veryl-lang/veryl/support/vscode/CHANGELOG.md

# Change Log

All notable changes to the "veryl-vscode" extension will be documented in this file.

Check [Keep a Changelog](http://keepachangelog.com/) for recommendations on how to structure this file.

## [Unreleased]

- Initial release
