veryl-lang/veryl/(threads)

Thread 11 (2022-12-22):

case statement

dalance, 2022-12-22:
```
always_ff (clk) {
    case x {
        0: a = 1;
        1: a = 2;
        2: {
            a = 3;
            b = 4;
        }
        default: a = 4;
    }
}
```

taichi-ishitani, 2022-12-22:
Do you plan to add `case inside` feature?

dalance, 2022-12-22:
I want to consider it, but I think the priority is low.

dalance, 2022-12-29:
Instead of `default`, How about Rust style default?

```
always_ff (clk) {
    case x {
        0: a = 1;
        1: a = 2;
        2: {
            a = 3;
            b = 4;
        }
        _: a = 4;
    }
}
```

taichi-ishitani, 2023-01-05:
In SysemVerilog, `?` and `*` are used as symbols which mean wildcard. For exmaple: wildcard operator `==?`, wildcard index type `int a[*]`.
How about using `?` or `*` instead of `_`?

dalance, 2023-01-05:
I thought `default` may be a little long. but there is not another problem.
So I'll use `default` to follow SystemVerilog.

Do you have any other reason to change to `?` or `*`?

dalance, 2023-01-06:
OK. I'll use `default` at this time.

taichi-ishitani, 2023-01-11:
How about introducing case item less case statement.
Example:

```
case {
  foo:     a = 1;
  bar:     a = 2;
  default: a = 3;
}
```

Equivalent code:

```
case 1 {
  foo:     a = 1;
  bar:     a = 2;
  default: a = 3;
}
```

This idea is originally from Ruby's case expression.

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

dalance, 2023-01-11:
It looks good. Does Expression in case item have no problem for synthesis?

taichi-ishitani, 2023-01-11:
> Does Expression in case item have no problem for synthesis?

Yes. In fact, our RTL includes this kind of code.

dalance, 2023-01-12:
Expression less case seems to be difficult to parse by LL(k).
This is because

```
case {  <- Is this `{` case body's start or expression with concatenation?
    foo: a = 1;
}
```

To avoid this, chanigning `case` keyword for expression less case is required.

taichi-ishitani, 2023-01-12:
I don't care if expression less case feature is not introduced because I just put `1` as a case expression.

dalance, 2023-01-12:
I feel `case 1` may be bit strange, but I have no idea about alternative keyword.
So I'll keep the current implementation until new idea.

taichi-ishitani, 2023-01-12:
Introduce other keyword insead of `case`? For example, `switch`, `branch`..?

dalance, 2023-01-15:
`switch` seems to be good.

dalance, 2024-04-16:
The idea of `switch` statement moved to #643.

Thread 17 (2022-12-22):

improve syntax error

dalance, 2022-12-22:
The current syntax error is from parol's error.
It may not be suitable with language server.

Thread 29 (2022-12-24):

Using SV sytem functions

taichi-ishitani, 2022-12-24:
SystemVerilog has useful sytem functions, such as `$clog2`.
I'd like to use SV system functions within VL code but I got a syntax error.

```
Error: parol_runtime::unexpected_token

  × Unexpected token: LA(1) (Error)
   ╭─[test.vl:3:1]
 3 │   parameter MAX_COUNT:   u32 = 8,
 4 │   parameter COUNT_WIDTH: u32 = $clog2(MAX_COUNT + 1)
   ·                                ┬
   ·                                ╰── Unexpected token
 5 │ )(
   ╰────
  help: Unexpected token
```

Does not support such feature?

dalance, 2022-12-25:
General function call is not still supported.
System function call will be supported at the same time.

taichi-ishitani, 2022-12-26:
OK, I understand.
I track this request by using #33.

Closed 2022-12-26.

Thread 35 (2022-12-25):

project namespace

dalance, 2022-12-25:
to avoid name conflict between packages

dalance, 2023-01-15:
`::` can be used for project namespace resolver like package.

```toml
[dependencies]
prj1 = { git = "" }
```

```
module ModuleA {
    inst a: prj1::ModuleB;
}
```

In SystemVerilog, `::` is replaced with `_`.

```systemverilog
module ModuleA;
    prj1_ModuleB a();
endmodule
```

dalance, 2023-01-18:
Project name should be added too.

```toml
[project]
name = "sample"

[dependencies]
prj1 = { git = "" }
```

```
module ModuleA {
    inst a: prj1::ModuleB;
}
```

```systemverilog
module sample_ModuleA;
    prj1_ModuleB a();
endmodule
```

Closed 2023-01-24.

Thread 55 (2023-01-04):

Incorrect if block scope

dalance, 2023-01-04:
Currently, the following code causes duplicated identifier error.
Each claure of if declaration should have independent scope.

```
if a ==1 :label {
    let a: logic;
} else {
    let a: logic;
}
```

Closed 2023-01-31.

Thread 62 (2023-01-07):

Useage of tri keyword

taichi-ishitani, 2023-01-07:
I think in Varyl `tri` keyword is used as a data type.
On the other hand, in SystemVerilog the `tri` keyword is used to show that a declared element is a wire and to allow the element to have multiple drivers. Therefore, its usage is similar to the usage of the `var` keyword.

```systemverilog
package foo_pkg;
  typedef enum logic {
    FOO_0,
    FOO_1
  } e_foo;
endpackage

module foo_sub
  import foo_pkg::*;
(
  inout tri e_foo io_foo
);
  assign io_foo = FOO_0;
endmodule

module foo_top;
  import foo_pkg::*;

  tri e_foo foo;
  assign foo = FOO_1;
  foo_sub u_sub (foo);
endmodule
```

I think Veryl should also use the `tri` like the `var` keyword.

dalance, 2023-01-07:
`tri` may be type modifier like `const` in C++.

```
module A (
    a: inout tri logic[10],
    b: inout tri struct_t,
) {
    var a: tri logic;
    var b: tri struct_t;
}
```

Usage `tri` like `var` keyword is not suitable because `var` can't be used in port declaration.

Syntactically `tri u32` is allowed, but it will be rejected by semantic checker.

dalance, 2023-01-07:
Alternatively, `inout` infers `tri` automatically.
This may be less consistency?

```
module A (
    a: inout logic[10],
    b: inout struct_t,
) {
    tri c: logic;
    tri d: struct_t;
}
```

dalance, 2023-01-07:
I think `tri` is special case, and is required to write carefully.
So explicit description like the first idea is better?

taichi-ishitani, 2023-01-08:
> var d: tri struct_t;

I feel strange that var and tri are used in the same object declaration because var means a variable.
I also think `var` should be a type modifier if `tri` is a type modifier.

According to the above thought, how about this?

* change `var` to a type modifier
    * this is for symmetry with `tri` keyword
* revive `let` keyword

```
module A (
  a: output var logic, // var can be omitted
  b: output tri logic
){
  let c: var logic; // var can be omitted
  let d: tri lgoic;
}
```

dalance, 2023-01-08:
I think "omittable" is a main cause of SystemVerilog's syntax complexity.
So `var` should be mandatory or like below

```
module A (
  a: output logic,
  b: output tri logic
){
  let c: logic;
  let d: tri lgoic;
}
```

I think symmetricity is not required because `tri` is special case.
(for example, many languages mark `static` variable but not `dynamic` variable)

> I feel strange that var and tri are used in the same object declaration because var means a variable.

I read `var d: tri struct_t;` as "variable declaration of tri-statable struct_t".
So `var` is keyword to show variable declaration, and `tri` is type modifier.

 I agree the meaning of `var` of SV and Veryl is a little different.
If the difference causes strangeness, I agree to revive `let`.

taichi-ishitani, 2023-01-08:
> If the difference causes strangeness, I agree to revive let.

I think there are few SV users using `var` keyword so this could not be a problem.
Therefore, it's OK for me whichever using `var` or `let` keywords.

dalance, 2023-01-09:
Comparison of `var` and `let`

```
var  a: u32;
inst b: InterfaceA;

let  a: u32;
inst b: InterfaceA;
```

I think `var`/`inst` is more clear that it is "variable".
(If `let` is used, I want to use `let` for instantiation too. but it can't)

taichi-ishitani, 2023-01-10:
> I think var/inst is more clear that it is "variable".

Yes, I agree.

dalance, 2023-01-11:
tri as type modifier was implemented.

Closed 2023-01-11.

Thread 68 (2023-01-11):

forbid unused variable

dalance, 2023-01-11:
In Rust, unused variable causes warning, and Go forbids it.
Which is better?

Other issues:

* Port should not be checked because it is public interface which includes extensions for future use.
* Prefix `_` shows the variable is unused. It suppress the error or warning.

```
module ModuleA (
    x: input  logic, // ports are not checked
    y: output logic,
) {
    var a: u32;  // error or warning
    var _b: u32; // _ shows the variable is unused.
}
```

dalance, 2023-01-12:
Currently unused variable is forbidden.
If this is too restricted, I'll change the behavior.

Closed 2023-01-12.

Thread 71 (2023-01-12):

Assignment non-blocking operator

taichi-ishitani, 2023-01-12:
SystemVerilog has assignment operators, e.g. `+=`/`-=`, but no assignment operators for non-blocking assignment.
Therefore, we have to write code like below for updating a FF value using itself. I think it's very bother.

```systemverilog
count <= count + 1;
```

To resolve this, I'd like Veryl to allow to use assignment operators within `always_ff` blocks.

```
always_ff i_clk, i_rst_n {
  if_reset {
    count = 0;
  }
  else if up {
    count += 1;
  }
}
```

dalance, 2023-01-12:
This is already implemented, but the current output may be wrong.
I'll fix it.

Closed 2023-01-12.

Thread 73 (2023-01-12):

[要望] 幅ゼロの指定

ryuz, 2023-01-12:
C++ のサイズ0の配列のように、幅ゼロのバスを定義できると嬉しいです。
SystemVerilogの場合 たとえば 1対N マルチプレクサ を

```
module multiplexer
    #(
        parameter   int N = 2,
        localparam  int S = $clog2(N)
    )
    (
        input   logic   [N-1:0] in,
        output  logic   [0:0]   out,
        input   logic   [S-1:0] sel
    );

    assign out = in[sel];

endmodule
```

と書きたいところですが、 N が 1 の時に S が 0 になってしまい合成エラーになるため

```
module multiplexer
    #(
        parameter   int N = 1,
        localparam  int S = N > 1 ? $clog2(N) : 1
    )
    (
        input   logic   [N-1:0] in,
        output  logic           out,
        input   logic   [S-1:0] sel
    );

    generate
    if ( N > 0 ) begin : select
        assign out = in[sel];
    end
    else begin : bypass
        assign out = in;
    end
    endgenerate

endmodule
```

などと冗長な書き方をすることがあります。

また、変数を結合するのに例えば、下記のようなケースで b が不要な時に 0 を指定するとエラーになります。

```
module concatenate3
    #(
        parameter   int A = 2,
        parameter   int B = 0,
        parameter   int C = 5
    )
    (
        input   logic   [A-1:0]     a,
        input   logic   [B-1:0]     b,
        input   logic   [C-1:0]     c,
        output  logic   [A+B+C-1:0] q
    );

    assign q = {a, b, c};

endmodule
```

これらは、Verilog が [0:0] なバス幅指定をすることに起因していますが、Verly は Rust 風の宣言なので、解決しないものかと考えた次第です。
ただし、あくまでトランスパイらなので、変換を考えると難しいというのも想像できます。

例えばですが parameter を、そのまま SV に残すものと、Verly  内で解釈するものとを指定できるようにして、後者に限定して高度なことができるような事などではできないものでしょうか？

優先度の高い要望ではないのですが、何かの折にもし良いアイデアが出てくればご検討いただければ幸いです。

taichi-ishitani, 2023-01-12:
以下の様に生成するようにできれば、解決できるとは思いますが、生成後のコードが読みづらくなるのが難点ではあります。

```systemverilog
out = in[(S>0)?sel:0];
```

```systemverilog
q = {{(A>0){a}}, {(B>0){b}, {(C>0){c}}};
```

ryuz, 2023-01-12:
ありがとうございます。こういうテクニックは思いつかなかったので非常にありがたいです。

もっとも

```
input   logic   [B-1:0]     b,
```

部分が

```
input   logic   [0-1:0]     b,
```

と展開されてしまい、本来の趣旨と違う信号が生成されてしまうという問題は残りますが。

> 生成後のコードが読みづらくなるのが難点ではあります。

結局、ここに尽きるのかなと思いました。
 Veryl の使用用途も

- そのまま使える奇麗な SV に変換したい時
- 波形ファイルさえ Veryl と対応していればOKな時

の2種類ありそうな気がしますので、後者に踏み込んだオプションがあっても嬉しいです。

ちなみに Rust 風のマクロを実装したりなどもお考えでしょうか？
結構、この手のテクニックの隠ぺいにマクロは便利そうな気もしております。

dalance, 2023-01-12:
幅0のconcatenateは面白いですね。
全部これに対応すると確かに可読性が厳しくなってしまうので、 `zeroable` みたいなtype modifierを付けた変数だけ展開するとかをイメージしていました。

マクロについてはRustの手続きマクロのようにアトリビュートを付けた構文要素の構文木変換として実装したら良さそうかと思っています。

taichi-ishitani, 2023-01-13:
`zeroable` 良いですね。
これが指定されている場合は、

* 幅が 0 の場合に
    * 幅を強制的に 1 にするコードを挿入する
        * `logic [((W>0)?W-1:0):0] a`
    * 左辺値として参照する際に、強制的に 0 にするコードを挿入する
        * `lhs = (W > 0) ? a : '0`
    * 右辺として代入される際は、代入を無かったことにするコードを挿入する
        * `a = (W > 0) ? lhs : '0`
    * 連接の場合は、回数 0 の繰り返しを挿入して、辻褄を合わせる
        * `{{(A>0){a}}, {(B>0){b}}, {(C>0){c}}}`
        * 回数 0 の繰り返しが使える条件は限られているようなので、連列自体を禁止にしてしまった方が良いかもしれない

が良いでしょうか？

`zeroable` が指定されていない変数については、幅が 1 以上前提ですから、ポカミス除けに、

```systemverilog
initial assume(W > 0);
```

のようなコードを挿入するはどうでしょうか？

dalance, 2023-01-13:
良さそうですね。最初のコード例では

```
module multiplexer #(
    parameter  N: u32  = 2        ,
    localparam S: u32  = $clog2(N),
) (
    i: input  logic [N],
    o: output logic [1],
    s: input  zeroable logic [S],
) {

    assign o = i[sel];

}
```

```systemverilog
module multiplexer #(
    parameter  int N = 2,
    localparam int S = $clog2(N)
) (
    input  logic [N-1:0] i,
    output logic [1-1:0] o,
    input  logic [((S>0)?S-1:0):0] s
);

    assign o = i[(W>0)?s:'0];

endmodule
```

なので可読性もそこまで悪くはないかな、と思います。
マクロはマクロでいろいろ問題がありますし。
`$clog2` みたいな感じの関数があれば良かったんですけどね。

`initial assume` もいいと思います。

taichi-ishitani, 2023-01-13:
> $clog2 みたいな感じの関数があれば良かったんですけどね。

生成する SV で使うユーティリティ関数をまとめた pakcage を用意するのはどうでしょうか？
しかし、参照する際と、代入する際の処理はマクロにせざるを得ないなので、御利益はあまりなさそうですね。

ryuz, 2023-01-13:
いろいろとご検討いただきありがとうございます。zeroable のアイデアは素敵に思います。

私が FPGA ターゲットなのもあるかもしれませんが、汎用性の高いモジュールを書きたい要望が高いです。
普段  parameter や generate を多用することが多いのですが

- $clog2 が 1 に対して 0 になってしまう問題
- AXIバスのようにオプション信号が多い規格で使わない信号を幅0定義したら無きものとして扱いたい
- 機能追加するときは後方互換性を確保したいのでデフォルト引数が欲しい

などの需要があります。

最後の奴は SV は function や task ではデフォルト引数指定できるのに module のポートではできないようなので、parameter の方で指定しない限りは信号は無視するようなやり方で拡張したりしています。
(デフォルト引数の処理は、module 側ではなく、インスタンシエートする側の処理なので Veryl では拡張は難しそうですよね。)

ちなみにサイズ0に関しては $bits の問題もあって、ゼロの時に $bits が 0 を返すようにするのは少し難しい気がします。

そもそもの話として SV で幅 W の信号を [W-1:0] と表したときに

```
module tb_top();
    generate
    for ( genvar i = -2; i <= +2; ++i ) begin : foos
        foo #(.W(i)) i_foo ( .a('0) );
    end
    endgenerate
    initial #1 $finish();
endmodule

module foo #(W=1) (input [W-1:0] a);
    initial $display("W=%d $bits(a)=%d", W, $bits(a));
endmodule
```

を動かすと

```
W=         -2 $bits(a)=          4
W=         -1 $bits(a)=          3
W=          0 $bits(a)=          2
W=          1 $bits(a)=          1
W=          2 $bits(a)=          2
```

のように 0以下でおかしなことになるのですよね。
(SV の文法が示しているのはbitサイズではなくbit位置だというのがそもそもの問題で

多くの場合、負の値を使うこと自体サポート範囲外にしてよい気がするので

> initial assume(W > 0);

はとても良い案に思いました。

taichi-ishitani, 2023-01-13:
本筋と外れますが、

> AXIバスのようにオプション信号が多い規格で使わない信号を幅0定義したら無きものとして扱いたい

社内用のバスインターフェース用の共通モジュール作成の時にも苦慮した点ですね。
インターフェース上の信号は消せないのは仕方ないとして、FIFO などに繋ぐ際に、必要ビットだけビット列に詰めることで対応しました。これによって、必要最小限のリソースだけを消費するようにしています。
詰める function、元に戻す funtion を SV interface に実装することで、関数を呼び出すだけで、これらを実施できるようにしています。

Qiita の記事や、実際の実装が参考になるかと思います。

* https://qiita.com/taichi-ishitani/items/ec351cc5d793a4382da0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
* https://github.com/pezy-computing/pzbcm/blob/master/pzcorebus_common/pzcorebus_if.sv
* https://github.com/pezy-computing/pzbcm/blob/master/pzcorebus_common/pzcorebus_if_internal_macros.svh
* https://github.com/pezy-computing/pzbcm/blob/master/pzcorebus_fifo/pzcorebus_fifo.sv

ryuz, 2023-01-13:
> 社内用のバスインターフェース用の共通モジュール作成の時にも苦慮した点ですね。

やはり似たような課題は皆さんお持ちなのですね。
SV対応してないツールの対応もあって、Verilog で パック/アンパックするコンポーネント書いて、AXI-Stream 信号を FIFO に投げ込むとかやってました。

https://github.com/ryuz/jelly/blob/master/rtl/library/jelly_func_pack.v
https://github.com/ryuz/jelly/blob/master/rtl/library/jelly_func_unpack.v
https://github.com/ryuz/jelly/blob/master/rtl/bus/jelly_axi4s_fifo.v

この手の課題はコードが汚くなりがちなので、うまいことバグなく綺麗に書ける仕組みがあると嬉しいですね。

taichi-ishitani, 2024-03-08:
#528 と同じ用途なので、こちらにもコメントを。
`zeroable` の様に型修飾子を付ける場合、関連する全ての変数に修飾子を付ける必要があると思います。
付けないと、以下のように、幅不一致が起きてしまう恐れがあります。

```systemverilog
// W=1 の時、count_next は logic [-1:0] になってしまう
var count: zeroable logic<W>;
var count_next: logic<W>;
always_comb {
  count_next = count + 1;
}
```

なので、付け忘れを検知する機能や、#528 で提案されている `(W > 2) ? $clog2(W) : 1` を返す組み込み関数がいるのではないかと思います。

Thread 93 (2023-01-22):

AMD(Xilinx) FPGA でのメモリ推論の為の記述

ryuz, 2023-01-22:
AMD(Xilinx) FPGA で、メモリを推定する記述を出力させたいと考えております。

https://docs.xilinx.com/r/ja-JP/ug901-vivado-synthesis/RAM-%E3%81%AE-HDL-%E3%82%B3%E3%83%BC%E3%83%89%E8%A8%98%E8%BF%B0%E3%81%AE%E3%82%AC%E3%82%A4%E3%83%89%E3%83%A9%E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

その際に、AMD(Xilinx) の合成ツール Vivado が

```
(* ram_style="block" *)
logic [DATA_WIDTH-1:0] mem  [ADDR_WIDTH-1:0];
```

こう書くと推論できるのですが

```
(* ram_style="block" *)
logic [ADDR_WIDTH-1:0][DATA_WIDTH-1:0] mem;
```

と書くと、推論できないようです。

下記のようなコードで、メモリが生成できると嬉しいのですが、出力を変える方法はありますでしょうか？

```
module block_ram
#(
    parameter  ADDR_WIDTH : u32 = 10,
    parameter  DATA_WIDTH : u32 = 18,
    localparam MEM_SIZE   : u32 = 2 ** ADDR_WIDTH,
) (
    clk  : input  logic,
    en   : input  logic,
    we   : input  logic,
    addr : input  logic [ADDR_WIDTH],
    din  : input  logic [DATA_WIDTH],
    dout : output logic [DATA_WIDTH],
) {

   #[sv(ram_style="block")]
    var mem : logic [ADDR_WIDTH][DATA_WIDTH];

    always_ff (clk) {
        if en {
            if we {
                mem[addr] = din;
            }
            else {
                dout = mem[addr];
            }
        }
    }
}
```

dalance, 2023-01-27:
こちらも対応済です。

Closed 2023-01-27.

Thread 94 (2023-01-22):

[提案] signed 型の部分取り出し時の扱い

ryuz, 2023-01-22:
SystemVerilog では

~~logic signed a[7:0][3:0];~~  ← (間違っておりました)
```
logic signed [7:0][3:0] a;
```

のような signed な 32bit の変数を a[1] のように4bit だけ切り出すようにすると unsigned になってしまうようです。

例えば下記などにもその話があります。

https://stackoverflow.com/questions/57216757/is-signed-type-valid-for-each-element-using-typedef-packed-array-v-s-multidi

Verly では Rust 的な構文となっているので、例えば自動で $signed(a[1]) のように $signed で囲まれるようにするなど如何でしょうか？

taichi-ishitani, 2023-01-22:
どちらかというと、unpacked arrayに対応させる方が良いのではないでしょうか？

dalance, 2023-01-22:
#93 と併せてpacked/unpackedの区別ができればいいということになるかと思います。
logic/bit以外の`[]`がunpackedなので、`[]`はunpackedに統一して
別途packedを表現できるようにするのがいいでしょうか。
「logic/bitは型引数としてビット幅を取れる」という考え方でいくとこんな感じですかね。

```
var a: signed logic(4) [8];
var a: signed logic(4, 4) [8];
var a: signed logic(4)(4) [8];

var a: signed logic<4> [8];
var a: signed logic<4, 4> [8];
var a: signed logic<4><4> [8];
```

ryuz, 2023-01-22:
packed/unpacked の区別ができる構文は非常に汎用性が高いように思いました。

あと、あえて言うなら、古い Verilog 表記のモジュールや、ハードマクロに packed 化してそのまま入れたい時があるので、packed へキャストする方法もあるとありがたいです。

あと、少し違う話なのですが Verilator が

>  a[1] のように4bit だけ切り出すようにすると unsigned になってしまう

を、signed と解釈してしまうようで、合成器との不一致で悩んでいたりします。
仕方なく常に $signed(), $unsigned() を明示して使っていたりするのですが、Veryl -> SV するときにそういうオプションがあると嬉しいです。

他にもローカル変数定義で Vivado Sim が デフォルトで  automatic で、 Vivado Synthesizer が static 解釈なので不一致が起こったりと、各ツールのバグや方言や実装依存で振り回されることもあります。 SVの出力にはなるべく「これ以外に解釈ありえない」という自明な出力ができると助かります。

taichi-ishitani, 2023-01-22:
`var a: signed logic<4, 4> [8];`が良いですね

taichi-ishitani, 2023-01-22:
```systemverilog
module test;
  bit signed [1:0][1:0] a;
  bit signed [1:0] b[2];

  initial begin
    a[0] = '1;
    b[0] = '1;
    $display("%d %d", a[0], b[0]);
    #1;
    $finish;
  end
endmodule
```

の VCS での実行結果は、

```
3          -1
```

になりますし、LRM には、

```
—  Bit-select results are unsigned, regardless of the operands.
—  Part-select results are unsigned, regardless of the operands even if the part-select specifies the entirevector.
```

とあるので、Verilator の挙動の方が正しそうではあります。

taichi-ishitani, 2023-01-22:
`logic signed a[7:0][3:0]` ですと、「１ビットの符号付変数」の配列ということになりますが、意図した記述なのでしょうか？

ryuz, 2023-01-22:
Verilator で試すと
> -1 -1
になってしまいますね。

> Verilator の挙動が間違っていそうではあります。
私も多分そうだとは思っております。

taichi-ishitani, 2023-01-22:
> `logic signed a[7:0][3:0]` ですと、「１ビットの符号付変数」の配列ということになりますが、意図した記述なのでしょうか？

という宣言も可能になってしまうので、「符号付の場合、幅は２ビット以上」というチェックを入れても良さそうですね。

ryuz, 2023-01-22:
> logic signed a[7:0][3:0]

すみません

logic signed [7:0][3:0]  a;

の間違いです。

ryuz, 2023-01-22:
> 「符号付の場合、幅は２ビット以上」

DeepLearning などで INT1 はありえるので、文法上何らかの誤解のない符号付き 1bit の宣言方法もあると良いように思いました。

> logic signed [1] a [7:0][3:0];

のように  [1] を省略できないようにするとか如何でしょう。

dalance, 2023-01-22:
> `var a: signed logic<4, 4> [8];`が良いですね

私もそれがいいと思ったのですが、よく考えると  `<EXPRESSION>` の `EXPRESSION` 中に比較演算子 `>` があるとおそらくLL(k)でパース不能ですね。 次点で`logic(4, 4)` でしょうか。

signed 1bitについては -1～0の範囲を正しく表現できるので、不正扱いする必要はないように思います。

```
var a: signed logic [8];
var a: signed logic(1) [8];
var a: signed logic(4) [8];
var a: signed logic(4, 4) [8];
```

```systemverilog
logic signed a [8];
logic signed [0:0] a [8];
logic signed [4-1:0] a [8];
logic signed [4-1:0][4-1:0] a [8];
```

となるので、1bitであることを明示したい場合は `logic<1>` とすればいいのではないでしょうか。

taichi-ishitani, 2023-01-22:
› logic/bitは型引数としてビット幅を取れる

packed であれば、任意の型でpacked arrayにできますし、logic/bitに限定する必要はないのではないでしょうか？

dalance, 2023-01-22:
> packed であれば、任意の型でpacked arrayにできますし、logic/bitに限定する必要はないのではないでしょうか？

元々の考えとしてはSVで任意の型とpackedとunpackedを組み合わせ可能なのは自由度が高すぎて、混乱を招いている気がしたので制限する方向でした。
なので制限を解除するには理由がほしい感じがしています。
例えばlogic以外のpacked に対応しないと困るケースってどういうものがありますか？

taichi-ishitani, 2023-01-22:
> 例えばlogic以外のpacked に対応しないと困るケース

無いと絶対に困ると言うほどではないですが、

1. Verilog/VHDL との相互運用性
    * 論理合成後のネットリスト上での取り扱いも含む
2. function の戻り値にする際に、typedef が不要

ですね。

1.に関しては、SV 出力時の配列のフォーマットを選択できるようにすれば、事足りるのかもしれません。
(適宜、`$signed`/`signed'`を補う必要はありますが。)

RgGen では Verilog との相互運用性を要望された際に、配列のフォーマットを、

* packed 配列で出力
* unpakced 配列で出力
* ビット列に詰めて出力

から選べるようにして、対応しました。

dalance, 2023-01-22:
なかなか難しいですね。
packed/unpackedをSV仕様のまま露出すると、言語仕様としてきちんと定義するのは難しくなる気がします。
（現状でもSVの仕様書に書いてあることと各処理系の解釈はまちまちなので）
「SVのpacked/unpackedです」と言ってしまうのが楽ではありますが…。

dalance, 2023-01-22:
よく考えると #93 のような挙動はどのみち制御不能なので
単純に構文だけ整理した形でいい気がしてきました。
後で確認しますが曖昧性の問題がなければ `var a: struct_t(4, 4) [8]` で行こうと思います。

ryuz, 2023-01-22:
> 後で確認しますが曖昧性の問題がなければ var a: struct_t(4, 4) [8] で行こうと思います。

ご検討頂きありがとうございました。

dalance, 2023-01-23:
やはり `()` は関数呼び出しとの曖昧性が問題になりそうです。
例えば array を `[[]]` にするとかはどうでしょうか。
多次元が結構見づらい気もしますが、`,` 区切りならそこまででもないかも？

```
var a: logic [4][4] [[8]][[8]];
var a: logic [4, 4] [[8, 8]];
```

dalance, 2023-01-23:
そもそも packed を `[]` で表現するのがダメですね…。
EXPRESSION中のpart selectと packed typeが区別できないです。

dalance, 2023-01-23:
既存言語における `<>` の曖昧性解決

https://zenn.dev/qnighy/scraps/34d96c787a758d

このうち今回適用できそうなのはRustのやり方（式中に出現する `<>` は `::<>` にする）

```
var a: logic <4, 4> [8][8];
parameter TYPE: type = logic::<4, 4>;
```

既存言語には存在しないが、比較演算子側を妥協すると

```
assign a = 1 <: 1; // 1 < 1
assign a = 1 <= 1;
assign a = 1 >: 1; // 1 > 1
assign a = 1 >= 1;

var a: logic <4, 4> [8][8];
```

長さがそろうのはいい気もしますが、さすがに違和感が…。

式中に突然型が出現することはtype parameterくらいしかない（キャストは `as` が前置なので曖昧性はない）
のでRust方式がいいですかね。

dalance, 2023-01-23:
Rust方式は解決になってないですね…。
曖昧性は型引数に含まれる `>` と `<>` の終端にもあるので（Rustは型引数に `>` が含まれない）
使えるとすると、`[[]]` 方式にしたときに発生する式中のpart selectとpacked typeの曖昧性解決でした。

```
var a: logic [4, 4] [[8, 8]];
parameter TYPE: type = logic::[4, 4];
```

比較演算子 `<:` が意外とましなのかも？

taichi-ishitani, 2023-01-23:
<=と文字数が揃うので、<:は良いのではないでしょうか？

dalance, 2023-01-23:
既存言語にないので違和感ある気がしていましたが、案外良いかもしれませんね。
他に良い案がなければそれにしようと思います。

ryuz, 2023-01-23:
字句解析に知見が無く素人意見で大変恐縮なのですが、演算子には C や Rust を継承してほしい気はします(初見ユーザーが混乱しそうに思いました)。

例えばですが  module や function の parameter 指定みたいに

> var a: signed logic #(4, 4) [8];

みたいな記法とか、

> var a: signed logic [#4, #4, 8];

みたいに添え字の方に packed, unpacked を区別する何らかのプリフィックスを付けるとかは難しいのでしょうか？

あと、本家 Verilog がやってるように begin, end を使うことで {} を空けるとかはありえるのでしょうか？

素人質問ばかりですみません。  <:  も悪くはないのだと思いますが、ちょっと面食らってしまった印象があったので。

ryuz, 2023-01-23:
> logicのpacked幅は最もよく使う記法なので#() だとちょっと長く感じてしまいます。
> prefixを付けるならunpackedの方かな、と思いますが記号の選択がちょっと難しいですかね。

なるほど。私個人としても Verilog の延長色が強いので特に合成可能記述では unpacked は殆ど使わないのですよね。
ただ、生成されるインスタンスの静的特性を指定する点では #() は理解はしやすい気はしました。

> （あと記号方式にすると logic [#4, 8, #4] などと書けてしまうのもありますかね）

確かにですね。   logic [4, 8;  4]  とか、何かセパレータを置く方がまだ自然かもしれませんね。

> () とRust方式の組み合わせがいいでしょうか。::があれば関数呼び出しとの区別はできるので。

Rust 風に統一できるのであれば、個人的には一番嬉しいです。
ただ、HDL の良い部分(というか必要な部分)だけをうまく Rust に足そうとすると、記号が足りないところがいろいろあるのは想像に難くないです。

taichi-ishitani, 2023-01-23:
変数宣言のところも、`logic::(4, 4)`でも良さそうに思うのですが、いかがでしょうか？

dalance, 2023-01-24:
大量に出てくる構文なので `#()` でも長いかな、と思っていましたがそうでもないですか？
あとフォーマッタで `()` を縦方向にそろえると、`::` の前後が分かれてしまってちょっと意味が取りずらい感じになる気がします。

```
module ModuleA (
    a: input  logic   (10),
    b: input  struct_t(10),
    c: input  logic   (10),
    d: input  logic   (10),
    e: output logic   (10),
) {
    var x: logic (10);
    var y: logic (10);
    var z: enum_t(10);
}
```

```
module ModuleA (
    a: input  logic   ::(10),
    b: input  struct_t::(10),
    c: input  logic   ::(10),
    d: input  logic   ::(10),
    e: output logic   ::(10),
) {
    var x: logic ::(10);
    var y: logic ::(10);
    var z: enum_t::(10);
}
```

```
module ModuleA (
    a: input  logic::   (10),
    b: input  struct_t::(10),
    c: input  logic::   (10),
    d: input  logic::   (10),
    e: output logic::   (10),
) {
    var x: logic:: (10);
    var y: logic:: (10);
    var z: enum_t::(10);
}
```

ryuz, 2023-01-24:
(この issue の趣旨ではないかもですが、Veryl の フォーマッタ試してみて、縦に綺麗に揃うのはとても素晴らしいなと思いました。)

以下、素人意見なのですが、

ユーザーにもよるのかと思いますが、特に合成用の記述に関しては packed が主役(packedは配列というよりバス幅の多次元なイメージ持っています)で、めったに unpack は出てこないので、正直 packed に一等地の記号を割り当ててほしい気はします。

一方で、

> logic/bit以外の[]がunpackedなので

というのが言われてみると、その通りで、int  の配列のようなものが Rust と同じに書けないのも嫌な感じがします。
packed が型の一部である感覚は強いので、思想的には

> var a: logic <4, 4> [8][8];

に近いものを混乱ない文法で書ければしっくりくる気はします。
(logic と bit に対してだけ何かストレスにならない付加情報を付けられるいい書き方があればよいのでしょうが...）

個人的に Veryl に期待している部分として

-  SVの各種課題を補完する美しい言語であってほしい
-  「Rust は書いたことあるけど RTL は初めて」という人にもとっつきやすい言語に育ってほしい

というのがあります。SV を書く人にもとっつきやすいに越したことはないのですが、Veryl の現在の文法を見ていると、SV の思想よりは Rust の思想を優先した方が良い方向に行きそうに感じました。

dalance, 2023-01-24:
どの括弧を使うかで再度まとめてみました。
結局式文脈での曖昧性はどれでも発生するのでRustのturbofish方式は必須ですね。

### `()`

```
var a: signed logic (4, 4) [8][8];
var b: enum_x (4, 4) [8][8];
inst: interface_y [8][8];
parameter TYPE: type = logic::(4, 4);
```

* packedが`()` でunpackedは `[]`
* `(4, 4)` は関数呼び出しに見える（特にユーザ定義型）
* 式文脈でtypeが出てくる場合に関数呼び出しとの曖昧性が発生するので `::()` にする必要がある

### `<>`

```
var a: signed logic <4, 4> [8][8];
var b: enum_x <4, 4> [8][8];
inst: interface_y [8][8];
parameter TYPE: type = logic::<4, 4>;
```

* packedが`<>` でunpackedは `[]`
* `<4, 4>` は型変数に見える
* `<>` の中に比較演算子が出てくると曖昧性が発生するので解決の必要あり
  * 比較演算子を変更する `<:` `>:`
  * `<>` 内では比較演算子を使用不可にする
  * `<>` に終端記号を付与 `<>#` のような
* 式文脈でtypeが出てくる場合に比較演算子との曖昧性が発生するので `::<>` にする必要がある

### `[]`

```
var a: signed logic [4][4] #[8][8];
var b: enum_x [4][4] #[8][8];
inst: interface_y #[8][8];
parameter TYPE: type = logic::[4][4];
```

* packedが`[]` でunpackedは `#[]`
* interfaceの配列がちょっと長くなる（が許容範囲内か）
* 式文脈でtypeが出てくる場合にpart selectとの曖昧性が発生するので `::[]` にする必要がある

taichi-ishitani, 2023-01-24:
個人的な好みですが、

* packed/unpacked を同じカッコの組みで扱わない
    * packed は型の一部のイメージなので
    * packed: `<>`
    * unpacked: `[]`
* 比較演算子とのあいまいさ解決のために、比較演算子を `<:` にするのは可
    * `<=` と文字数が揃うので、むしろ、これに関係なく `<:` に変更してほしい
* 宣言の時と、式の時とで表記は同じにしたいので、常に `::` は在ってほしい
* `<4,4>` と `[4][4]` とで表記が違うのも違和感があるので、両方とも `,` 区切りでの方が良いのでは

になると良いですね。

```
var a0 logic;
var a1 logic::<4>;
var a2 logic::<4, 4>;
var a3 logic::<4, 4> [4, 4];
parameter type A = logic::<4, 4>;
```

ryuz, 2023-01-24:
> どの括弧を使うかで再度まとめてみました。

ありがとうございます。結構、好みが出てくる感じの判断ポイントなのでしょうか。
まとめだけ見ると () も制約事が少ないように見えました。

> 比較演算子を <: にする

これもよさそうには思っていますが、一つ質問があり、曖昧性の発生しない文脈では <: を < と書くのは許されたりするのでしょうか？ それとも一般的な言語設計として、そういうことはするべきではなく、すべて <: と書くようにすべきものなのでしょうか？
ここは個人的な好みだとは思うのですが、いろんな言語を渡り歩きながらプログラムすることが多いので、コード書く側としては文脈上許されるところでは < も使えると混乱が減って嬉しいです(毎回のように付け忘れそうな気がしています)。

何れの場合でも、文字を揃えたいケースはよくわかるので < を <: とも書ける仕様は嬉しそうな気はします。
ただ Veryl の場合 veryl fmt コマンドで揃えてもらえればそれで良いという人も一定数いそうな気がします。
(ちなみに 私の場合、 Veryl で書いて SVに変換して SV を納品 とかしそうな気がしているので、SV のフォーマットの方が気になっていたりもします。)

dalance, 2023-01-25:
> これもよさそうには思っていますが、一つ質問があり、曖昧性の発生しない文脈では <: を < と書くのは許されたりするのでしょうか？ それとも一般的な言語設計として、そういうことはするべきではなく、すべて <: と書くようにすべきものなのでしょうか？

一般的に文脈によって切り替わるようなことは主に後方互換性維持のために行われています。ただそのようなことをするとパーサ実装が複雑化するので、新規設計の言語で積極的に採用するべきではないと思います。
特に比較演算子は式が現れるあらゆる箇所に影響するので、処理系全体が複雑化してしまい「SVの構文を単純化する」という当初の目的から外れてしまうと思います。
なので packed にどの括弧を使うとは関係なく、もし `<:` を導入するのであれば全て `<:` にする必要があります。

> ここは個人的な好みだとは思うのですが、いろんな言語を渡り歩きながらプログラムすることが多いので、コード書く側としては文脈上許されるところでは < も使えると混乱が減って嬉しいです(毎回のように付け忘れそうな気がしています)。

私も多言語を行ったり来たりするので懸念は分かります。
これに関してはツールで補うという考え方もあるかな、と思いました。
language serverでリアルタイムに構文チェックができるので、 `:` をつけ忘れた場合は式が完成した時点で確認できます。
また、 `<` の入力に対して `<:` `<=` を補完候補として出すのもいいかもしれません。

ここまでの議論と私自身の好みを加味して以下の2案が妥当かな、と思います。

### `<:` `>:` を採用する場合

曖昧性は根本的になくなるので `::<>` も不要です。
比較演算子を許容できるならこれが一番きれいだと思います。

```
var a: signed logic<4, 4> [8, 8];
var b: enum_x<4, 4> [8, 8];
inst: interface_y [8, 8];
parameter TYPE: type = logic<4, 4>;
```

### `<:` `>:` を採用しない場合

`::()` を常に適用するかどうかは議論の余地があります。

```
var a: signed logic(4, 4) [8, 8];
var b: enum_x(4, 4) [8, 8];
inst: interface_y [8, 8];
parameter TYPE: type = logic::(4, 4);
```

taichi-ishitani, 2023-01-25:
if 文の構文とっても、各言語でいろいろ違いがありますが (else if/elsif/elseif など)、言語の切り替わりの際に手が滑る程度で、大きな問題なく切り替えできますし、比較演算子が `<:` になっても、大きな問題にはならないのではないでしょうか？

taichi-ishitani, 2023-01-25:
個人的な好みは `<:` 採用案ですが、仕様と実装が簡潔になる方を採用のが良いのではないかと思います。

ryuz, 2023-01-25:
> なので packed にどの括弧を使うとは関係なく、もし <: を導入するのであれば全て <: にする必要があります。

なるほど、よくわかりました。勉強になりました、ありがとうございます。

> 仕様と実装が簡潔になる方を採用のが良いのではないかと思います。

私も同じ意見です。

好みの問題になるのであれば、言語作者の方の好みを優先頂くのが作者特権ではないかと思います。
(個人的好みは ::() の方ですが)

dalance, 2023-01-25:
たくさんのご意見ありがとうございます。
結論としては `<:` を採用することにしようと思います。
見た目に関してはそれぞれ一長一短ありますが、

* 実装の観点では例外規則が最も少ない
* ここで `<>` を正式な括弧として扱えるようにしておくと将来的な拡張でも役立つ

の2点を重視したいと思います。特に後者は今やっておかないと、将来 `<>` をどうしても入れたくなったときに他言語のような強引なハックをせざるを得なくなるので。

ryuz, 2023-01-25:
我儘な issue にご対応いただきありがとうございました。大変勉強になりました。
方針が固まって良かったです。
引き続き楽しみにしております！

dalance, 2023-01-27:
対応して v0.3.0 をリリースしました。

Closed 2023-01-27.

Thread 109 (2023-01-29):

[質問] parameter で型指定無しにしたり、文字列を使う場合について

ryuz, 2023-01-29:
いつもお世話になっております。 Veryl 0.3.0 を試させて頂いております。

現在、下記の SystemVerilog と等価なものを出力する Veryl のコードを書こうと試みております。

https://github.com/ryuz/jelly/blob/8701d4830836b33d2fe19de9a8e6e330d2045e15/rtl/library/jelly2_ram_dualport.sv

その際に parameter に文字列が使いたいのですが Veryl のサンプルで文字列型を使っているものを見つけきれずよくわかりませんでした。

また

- 一方で string を指定すると古い合成器がエラーになるので形指定無しで parameter に文字列を使う場合がある
- 引数を attribute に利用することもある

などがあり、ご意見いただけるとありがたいです。

ちなみに Xilinx の ハードマクロでもパラメータ引数に文字列を要求するものがよくあります。
参考までに Xilinx のライブラリガイドのURLを下記 に記載いたします。

https://www.xilinx.com/content/dam/xilinx/support/documents/sw_manuals_j/xilinx2019_2/ug974-vivado-ultrascale-libraries.pdf

いつも要望ばかりで恐縮ですがよろしくお願いいたします。

dalance, 2023-01-29:
文字列リテラルは後で追加するつもりで忘れていました…。
追加したので問題なければ明日v0.3.1をリリースします。

形無しについてはちょっと考える必要がありますね。
少なくともデフォルトでは明示的であるべきだと思っているので
何らかのオプションで調整する形でしょうか。

* Very.tomlの設定
プロジェクト全体でparameterの型を全て省略するのであれば、Veryl.tomlで設定できるようにするのがいいと思います。

* アトリビュート
特定のparameterだけに適用するのであればアトリビュートでの指定になると思います。

taichi-ishitani, 2023-01-29:
右辺値が文字列であっても、logicかbitで受ければ良いので、型付け必須でもいいのではないでしょうか？

taichi-ishitani, 2023-01-29:
それか、TB記述を考慮しなくても良いのであれば、「parameter宣言内のstring型は、型無parameter宣言に変換する」も手でしょうか？

ryuz, 2023-01-29:
> 追加したので問題なければ明日v0.3.1をリリースします。

いつも迅速なご対応、ありがとうございます。

> 右辺値が文字列であっても、logicかbitで受ければ良いので、型付け必須でもいいのではないでしょうか？

logic だと幅の事前指定が必要で、"FALSE" や "TRUE" のような長さの違う文字列を渡すと、ビット長不一致ワーニングで lint が通らないという理由で避けていたと思います。
Veryl の方での bit 幅チェックが十分であれば、シンセサイザやシミュレータの方のワーニングはOFFできるかもしれませんが、 Veryl でない資産とも接続すると思うので、parameter 指定などで、後からでないと幅チェックできない部分が出てきそうな気もしております。

> それか、TB記述を考慮しなくても良いのであれば、「parameter宣言内のstring型は、型無parameter宣言に変換する」も手でしょうか？

Veryl.toml で設定できれば、そういうオプションはありかと思います。string が使える処理系ではそのまま通して、使えない処理系を使う時だけ型なしが選べると嬉しいです。

現状、形無しで渡してますが、Verilator などの幅チェックが、"FALSE" や "TRUE" のような長さの違う文字列を比較すると怒るので、一度 bit 幅拡張してから比較するとかの苦肉の策をしています。
Veryl で綺麗な書き方ができると嬉しいです。

taichi-ishitani, 2023-01-29:
文字列を使うのはenumが無かった時代の苦肉の策ですし、こういうverilogとの橋渡しな箇所はSVに押し付けるのも一手なのかなとも思います

dalance, 2023-01-30:
Veryl.tomlで指定するとして、全部省略するかどうかのon/offだけでいいですか？
それともそれぞれの型ごとの指定が必要でしょうか？

```
[build]
implicit_parameter_type = true # 全ての型を省略

implicit_parameter_type = ["string", "u32"] # `string` と `u32` だけ省略
```

taichi-ishitani, 2023-01-30:
enum は enum であって欲しいので、型を省略可能にするのであれば、特定の型だけ省略可能するほうが良いですね。

dalance, 2023-01-30:
implicit_parameter_typesを追加しました。

```
[build]
implicit_parameter_types = ["string", "u32"]
```

dalance, 2023-01-30:
v0.3.1リリースしました。

ryuz, 2023-01-30:
ありがとうございます。v0.3.1 にて下記のコードを SV に変換して、Vivado 2022.2 で問題なく合成できることまで確認できました。

この手のプリミティブな機能も Veryl で書けるというのは非常にありがたく思います。

もう少しいろいろ試してみたいと思います。引き続きよろしくお願いいたします。

```
module block_ram
#(
    parameter  ADDR_WIDTH : u32 = 10,
    parameter  DATA_WIDTH : u32 = 18,
    parameter  RAM_TYPE   : string = "block",
    localparam MEM_SIZE   : u32 = 2 ** ADDR_WIDTH,
) (
    clk  : input  logic,
    en   : input  logic,
    we   : input  logic,
    addr : input  logic<ADDR_WIDTH>,
    din  : input  logic<DATA_WIDTH>,
    dout : output logic<DATA_WIDTH>,
) {

    #[sv("ram_style=RAM_TYPE")]
    var mem : logic<DATA_WIDTH> [MEM_SIZE];

    always_ff (clk) {
        if en {
            if we {
                mem[addr] = din;
            }
            else {
                dout = mem[addr];
            }
        }
    }
}
```

Closed 2023-01-30.

Thread 110 (2023-01-30):

[Feature] boolean type

taichi-ishitani, 2023-01-30:
The `boolean` data type is useful to declare variables/parameters which mean on/off.
Therefore, I'd like to introduce the `boolean` data type.

This is equivalent SV definition.

```systemverilog
typedef enum logic {
  VERYL_FALSE = 1'b0,
  VERYL_TRUE  = 1'b1
} veryl_boolean;
```

dalance, 2023-01-30:
Looks good.
Which is better `enum logic` and simple `logic`?

`enum logic` can check assignment without cast in SystemVerilog side.
But  I think the result of compare operator can't be assigned directly.
(Maybe can do it?)

```
var a: bool = (x > 1) as bool;
```

If Veryl insert the cast automatically, the transpiled code may be complicated.

```systemverilog
veryl_boolean a;
assign a = veryl_boolean'(x > 1);
```

`logic` can do it, and type check can be handled at Veryl side.
`true` and `false` will be converted to `0` and `1`. It has less explicity than `enum logic`.

taichi-ishitani, 2023-01-30:
Visivility of enum values on dump files is better than visivility of logic values so I prefer `enum logic` than `logic` a little bit.
Therefore, I don't care if you choose `logic`.

For readability, how about using following definition?

```systemverilog
tyepdef logic veryl_boolean;
localparam veryl_boolean VERYL_TRUE  = 1'b1;
localparam veryl_boolean VERYL_FALSE = 1'b0;
```

dalance, 2023-02-06:
```systemverilog
parameter logic ENABLE_FUNC_A = 1;
parameter veryl_boolean ENABLE_FUNC_A = VERYL_TRUE;
```

For me, the first example is explicit sufficientlly, and the second is bit redundant.
(Addisionally, identification between `VERYL_TRUE` and `VERYL_FALSE` is not easy because they are upper case.)

I think HDL doesn't have sufficient motivation to treat boolean as special type because part select generates boolean casually.

taichi-ishitani, 2025-03-12:
I'm working on it.
`bool`, `true` and `false` keywords will eimitted into `logic`, `1'b1 and `1'b0`.

dalance, 2025-03-14:
I agree to introduce `true` and `false` because they show it is boolean value more clearly than `1'b0` and `1'b1`.
About `bool` type, I have some concerns.

`bool` type is almost type alias of `logic`, but casting behaviour is only different. This small different may be confusable.
And the behaviour of `bool` packed array is not obvious.

```systemverilog
let a: logic<4> = 4'b1110;
let b: logic    = a as logic   ; // b == 0
let c: bool     = a as bool    ; // c == 1
let d: logic<2> = a as logic<2>; // d == 2
let e: bool <2> = a as bool <2>; // e == ?
```

taichi-ishitani, 2025-03-14:
I introduce bool type as a fixed type so bool type cannot be used for packed array.

dalance, 2025-03-14:
OK. I understood that `bool` is a type alias of `logic<1>` to express boolean value. I'll merge #1389.

Closed 2025-03-14.

Thread 113 (2023-01-31):

[提案] 明示的なノンブロッキング代入

ryuz, 2023-01-31:
以下、賛否のある話だとは思うので、趣旨に合わなければ棄却頂ければと思います。

現在の Veryl では、always_ff で書いた = はノンブロッキング代入、always_comb や function などで書いた = はブロッキング代入に展開されるかと思います。

この際にまったく同じコードが書く場所によって解釈が変わることになるかと思います。

あまり良いコードではないですが、

```
counter = counter + 1;
pulse   = 0;
if counter >= 1000 {
    counter = 0;
    pulse   = 1;
}
```

のようなものを、はじめ always_ff の中で書いていて、複雑になってきたので一部 always_comb などに移動させた際に、うっかりカウント数が１つ変わってしまったりします。

１つの言語の中で、同じ記述の意味が変わってしまうのは少し奇妙に感じました。
ブログ記事などにソースコードを一部抜粋する場合など、always_ff  の中か、always_comb のなかかわからないと読み違えてしまうと思います。

always_ff の中は従来通り <= のようなブロッキング代入用の文字を割り当てれば安全性が増すように思いました。

ご意見いただけると幸いに存じます。

dalance, 2023-01-31:
確かに賛否ありそうですね。`=` に統一した理由としては

* `always_ff` 中でブロッキング代入を禁止したい
* ノンブロッキングだけにするなら代入演算子は `=` に統一できる
* `=` にすると `+=` なども使用可能になる

といったあたりです。最後の点を除けば `<=` でもやりたいことは達成できるかもしれません。

> １つの言語の中で、同じ記述の意味が変わってしまうのは少し奇妙に感じました。

SystemVerilog内でも `assign` や `parameter` の `=` は特にブロッキング代入というわけでもないように思います。
個人的な感覚としては、それらの `=` の意味はその記号自体というよりは `assign` や `parameter` で認識していて、
同様に `always_ff` や `always_comb` などもそのキーワードで認識しているように思います。
そのため `=` に統一したとしても特に問題ないだろうという判断でした。

ryuz, 2023-01-31:
ありがとうございます。理由をお聞きして私も悩ましく思い始めております。

> assign や parameter の = は特にブロッキング代入というわけでもないように思います。

確かにおっしゃる通りですね。
ただ assign や force などの = や、初期化の =  は式の中で判断できるとおもいますが、always_ff は文として、下手をするとエディタの画面外に出ている部分まで見に行かないとどっちなのか判断できない点で少しスコープの大きさが違うような印象を受けました。
うっかりバグを書きにくい言語であってほしいという思いはあるので個人的には += を諦めても、ノンブロッキング代入の明示化はアリな気がしています。

強く主張するつもりはありませんが、興味深く思った部分なので、他の方の意見なども伺ってみたいところではあります。

ryuz, 2023-01-31:
ちなみに、ちょっと違う話になるかもですが、always_ff の中で

1. 一旦すべて automatic なテンポラリ変数に入れる
2. テンポラリ変数でブロッキング代入で演算する
3. 末尾で一括してノンブロッキング代入する

という流れに変換してしまえば、すべてブロッキング代入のポリシーで書ける言語にもなりそうな気がしたのですが、そういった形で文法を統一できるような可能性はありますでしょうか？
(素人の浅知恵なので穴がありそうな気はしていますが)

taichi-ishitani, 2023-01-31:
- 「FF記述中でブロッキング代入を使用」というポカミス除け
- 生成後のSVの読みやすさ

を考えると、自分は今のままの仕様が良いですね。
FF記述中でも+=を使いたいので、代入演算子の変更は反対の立場です。

ryuz, 2023-01-31:
ちょっと自信はないのですが

- テンポラリ変数＆末尾ノンブロッキング代入の構文を always_ff とは違う名前で新たに作り、ブロッキング代入以外禁止する
- ブロッキング代入演算子は <= を定義して always_ff ではノンブロッキング代入以外禁止する

というような事はありえますでしょうか？

ノンブロッキング代入の存在自体が話をややこしくしているような気はしているので、すべてブロッキング代入だけで書ける文法は、実現可能なら有難く思います。

(実際 always_ff は代入のみとして always_comb に処理を切り出すこともあります。ただ、今の値と次の値の２変数作るのでごちゃごちゃしてしまい、ここが隠れるノンブロッキング代入は便利ではあるのですが)

Veryl から生成した SV をさも最初から SVで書いた体で納品したいとかはありそうな気がしているので、always_ff も欲しいところです。

dalance, 2023-01-31:
> always_ff は文として、下手をするとエディタの画面外に出ている部分まで見に行かないとどっちなのか判断できない点で少しスコープの大きさが違うような印象を受けました。

個人的なコーディングスタイルとしては大きなalways_ffは回避していますね。
理由は一般的なプログラミング言語と同様に「大きな関数は可読性が低い」というのもありますし、always_ff固有の話としてクロック種別とリセット有無、同期か非同期かは常に把握しておく必要があるからです。

ブロッキングで統一というのはChiselがそういう感じであったと思います。
Chiselの大規模なコードをデバッグした経験では、この点はかなりバクの温床であるように感じました。
FFには1クロックに1回しか代入できないというのはかなり本質的な制限なので、言語側で複数回代入できるように見せかけるのはあまり筋が良くないように思います。
（ソフトウェアエンジニアが取っ付きやすいというのはあるかもしれませんが、初心者でも最終的には理解して欲しいという気持ちです）

ryuz, 2023-01-31:
> FF記述中でも+=を使いたいので、代入演算子の変更は反対の立場です。

これも質問で恐縮なのですが、 <+= みたいなノンブロッキング専用の += とかってあり得る話なのでしょうか？

時間が進むまで変化しない変数と、同じ時刻の中で参照内容が変わる変数が、変数定義でも式でも見た目区別できないのはそれなりに危険な気もしております。

dalance, 2023-01-31:
> これも質問で恐縮なのですが、 <+= みたいなノンブロッキング専用の += とかってあり得る話なのでしょうか？

シフト代入演算子<<=があるので簡単ではないですね。
<=ではなく@=などにすれば回避できますが。

taichi-ishitani, 2023-01-31:
仕様の簡潔さを優先するなら、演算子の追加はしないほうが良いのではないでしょうか？

ryuz, 2023-01-31:
> ブロッキングで統一というのはChiselがそういう感じであったと思います。
>  Chiselの大規模なコードをデバッグした経験では、この点はかなりバクの温床であるように感じました。

ありがとうございます。Chisel は興味はあるのですが手が出せていなかったので大変参考になります。

> FFには1クロックに1回しか代入できないというのはかなり本質的な制限なので、言語側で複数回代入できるように見せかけるのはあまり筋が良くないように思います。

ここは SV の時点で賛否があるところだとは理解しております。
ただ、複数回代入が便利な場合もあって、私はついついSVで使ってしまっています。

> （ソフトウェアエンジニアが取っ付きやすいというのはあるかもしれませんが、初心者でも最終的には理解して欲しいという気持ちです）

Chisel 風にしたい場合、 いっそ  always_ff では単純代入しかしないことにして、function なりに処理を小分けに切り出していくコーディングスタイルの方が安全なのかもしれませんね。

ryuz, 2023-01-31:
> シフト代入演算子<<=があるので簡単ではないですね。
> <=ではなく@=などにすれば回避できますが。

ありがとうございます。よく理解できました。

> 仕様の簡潔さを優先するなら、演算子の追加はしないほうが良いのではないでしょうか？

私も増やすべきでないと思っています。

ryuz, 2023-01-31:
always_ff や文法は今のままにするとして、

- テンポラリ変数に今の値をコピーしてブロッキング代入に処理して末尾でノンブロッキング代入してくれる文

という糖衣構文があると、ソフトウェアエンジニアが取っ付きやすい気はしています。
マクロがあればそちらで実装する手もありそうな気がしていますが、このあたり如何でしょうか？

taichi-ishitani, 2023-01-31:
> ソフトウェアエンジニアが取っ付きやすい気はしています。

私としては、書きやすいSVを目指すなら、そこを対象者に含めるのは疑問符が付きますね。

dalance, 2023-01-31:
two process methodというものが昔から提案されていて
これで書いている人はそれなりにいるようです。

https://qiita.com/ryo_i6/items/cf064e816bfdb7babb81

ソフトウェアエンジニアの人はこのあたりからだと入りやすいと思います。
糖衣構文で隠してしまうとそれで慣れていまい、上級者の書いたコードを読めずにレベルアップし辛いという問題もあるかもしれません。

ryuz, 2023-01-31:
> 私としては、Verylが書きやすいSVを目指すなら、そこを対象者に含めるのは疑問符が付きますね。

なるほど、私がソフト系の書き方を期待してしまったのがそもそもちょっと趣旨違いだったかもしれません。

そもそも論として Verilog の reg が FF にも ワイヤーにもなりえるのも混乱の始まりな気もしています。
Veryl 内での文法チェックだけに使う、ff を意図した変数か wire を意図した変数かを明示できる属性が付与できるとかがあってもいいのかもしれません。そうすると文法でなく変数属性の方で文意が一明確になりそうな気がしますし、「うっかりコピー」でのバグも減りそうな気がしました。

またいっそのこと always_ff 内での代入を一回に制限するオプションをつけるというのもありなのかもしれません(その場合も代入した後に変数参照しても古い値が読まれるので、どこに書くかで文脈が変わるのは同じですが)

Veryl を 「書きやすいSV」 として定義して、それ以上のことをしたければ「さらに別言語かぶせたりマクロで何とかする」というポリシーであればそれはそれでわかりやすい気がいたしました。
(Rust と同レベルのマクロ欲しいです)

ryuz, 2023-01-31:
> two process methodというものが昔から提案されていて
>  これで書いている人はそれなりにいるようです。

古いVerilogの頃から同じことはしていましたが、名前がついている技法だったのですね。ありがとうございます。

> ソフトウェアエンジニアの人はこのあたりからだと入りやすいと思います。

もろに私がそうで、Veryl で、その two process method で書こうとして、今回違和感を感じた次第でして。

> 糖衣構文で隠してしまうとそれで慣れていまい、上級者の書いたコードを読めずにレベルアップし辛いという問題もあるかもしれません。

ここは賛否ありそうな気がします。
別の話として、マクロで書ける糖衣構文に関してはマクロで書くべきな気はしております。

taichi-ishitani, 2023-01-31:
FF記述中にも右辺値として組合せ回路記述ができる事がそもそもの要因ですから、「always_ffの中は代入以外（制御構文含む）使用禁止」というルールを課して、コーディングルールチェックする方が良さそうに思います。

taichi-ishitani, 2023-02-01:
> always_ff は文として、下手をするとエディタの画面外に出ている部分まで見に行かないとどっちなのか判断できない点で少しスコープの大きさが違うような印象を受けました。

これも、ブロック中の最大行数を決められるようにして、コーディングルールチェックで弾く問題のように思います。

taichi-ishitani, 2023-02-01:
always_ffとalways_combの字面が似ていて、それが混乱の元というのなら、それぞれのキーワードを変更するのも一手でしょうか？
例えば、ffとcombinationとか

dalance, 2023-02-01:
あとはそこまで積極的な理由でもないですが、代入演算子は式構文の奥深くにいるので
`<=` に変更するとなると式構文全体を2重に持つことになって実装複雑性はかなり増しますね。
（構文レベルでは `=` と `<=` の両方を許容して意味解析レベルで弾くのもありですが、結局複雑性の増加に変わりはないです）
なので `<=` と明示するメリットがかなり明白でない限りは避けたいところです。

まだ実装してないですが、オプショナルなlinterルールでプロジェクト毎に
方針を決めて書くことで緩和できるならその方がいいかもしれません。

taichi-ishitani, 2023-02-01:
あくまでもHDLですから、言語仕様はRTLエンジニアを主使用者として、SWエンジニアがミスしそうな部分はコーディングルールブックなとで縛る方が良いように懐います。

ryuz, 2023-02-01:
いろいろなご意見有難うございます。背景にある思想がだいぶ理解出来てきました。
本提案は棄却頂くのが妥当かと考えております(毎回お騒がせして申し訳ないです)。

個人的に `<=` は `予約`、 `=` は `即時` と読む癖がついていたので、両者同じ書き方で戸惑ったという部分が多かったですが、慣れの問題かもしれません。

私の思いつく範囲の Verilog-HDL の嫌なところとして

- 宣言しなくても勝手に 1bit の wire が出来てしまう
- 変数が FF になるか wire になるかが文脈依存である(明示するのにハンガリー記法とかで書いたことも...)
- 幅ゼロのバスが定義できない
- function が parameter を取れない
- 一時変数でうっかりラッチが出来てしまう危険がある(SVだとautomaticつければよい)
- ブロッキング代入する変数は評価順序に注意が必要
- 変数の初期化漏れを拾う確実な方法がない
- bit幅の不一致関連

などがあり、SVでも互換性の観点から一部引きずっているかと思います。

Lint で解決できるものもありますが、 Veryl ならほぼすべて解決しそうに思えております。

今回、代入先の変数が FF か wire か見分けやすくする点で考えた次第でしたが浅知恵でした。

dalance, 2023-02-01:
> 変数が FF になるか wire になるかが文脈依存である(明示するのにハンガリー記法とかで書いたことも...)

これは個人的には（無意味と批判されたシステムハンガリアンではなく）適切なアプリケーションハンガリアン記法だと思っています。

https://ja.wikipedia.org/wiki/%E3%83%8F%E3%83%B3%E3%82%AC%E3%83%AA%E3%82%A2%E3%83%B3%E8%A8%98%E6%B3%95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

タイミングを気にする設計の場合、各変数がFFなのか入出力なのかwireなのかを継続的に把握することが重要で、変数名に `r_` `w_` `i_` `o_` などを付けて区別しています。
例えば以下のコードを見るだけで「後者に比べて前者はタイミングが厳しい可能性がある」と読めます。

```
assign w_mul = w_x * w_y;
assign w_mul = r_x * r_y;
```

この用途に関してはLSPなどでの型名のホバーではちょっと不足で、変数名の方がいいかな、と思っています。

ryuz, 2023-02-01:
> タイミングを気にする設計の場合、各変数がFFなのか入出力なのかwireなのかを継続的に把握することが重要で、変数名に r_ w_ i_ o_ などを付けて区別しています。

ありがとうございます。 入出力も区別されるのですね。参考になります。

レジスタ(FF)を意図した変数は always_ff の中でしか代入しない(逆もしかり)なルールが運用上担保できれば安心感のあるコーディングはできそうに思いました (コンパイラではなく、コーディングルールに対する Lint系 の話ですかね)。

ちなみに組み込みソフトでもメモリマップドI/Oのレジスタに対応する変数などは、レジスタ幅や符号などをハンガリアンで記述するのは結構効果があったように思います。ハードウェア制約のある部分とは相性が良いのかもしれませんね。

dalance, 2023-02-06:
lintのルールとしては `always_comb` と `assign` の左辺値の接頭辞と `always_ff` の左辺値の接頭辞ということでいいかと思います。`always_ff` 中の時点でFFであることは確定なので。

複数回代入の禁止などはネーミングルールとは別の合成不能記述のチェックのような感じでしょうか。
こちらはlintではなくsemantic errorでいいと思います。

taichi-ishitani, 2023-02-06:
> 合成不能記述のチェック

合成不可ではないので、lint error のほうが良いのではないでしょうか？
(お行儀が悪いのは確かですが。)

#86 があるとは言え、

```
a      = b;
a[1:0] = '0;
```

のような記述がエラーになるのは厳しいのではないでしょうか。

dalance, 2023-02-06:
これって合成可能なんでしたっけ？
2つの代入のうちどちらを採用すべきかわからない気がするのですが。

```
always_ff @ (posedge i_clk) begin
    a <= b;
    a[1:0] <= '0;
end
```

taichi-ishitani, 2023-02-06:
LRM 的には、ノンブロッキング代入が実行された順に、左辺の更新が実行されるので、`a[1:0] <= '0;` が最終的な結果になりますね。
DC/Vivdado もそのように合成します。

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

dalance, 2023-02-06:
それは知りませんでした。
であればlintですね。

dalance, 2023-02-07:
lintルールの追加は別issueにしたのでこちらは閉じます。

Closed 2023-02-07.

Thread 117 (2023-02-01):

[要望] 変数のリセット初期化漏れを警告してほしい

ryuz, 2023-02-01:
例えば下記のように 変数 b のリセットが漏れた場合、仮に b が初期化不要であっても reset 時に b の値をキープするための余計なロジックが生成されてしまいます。

```
always_ff (clk, reset) {
    if_reset {
        a = 0;
    }
    else {
        a = b + 2;
        b = a + 1;
    }
}
```

Veryl では if_reset という構文が導入されているので、リセット漏れが検出できそうな気がしましたが如何でしょうか？

余談ですが個人的には初期化不要なものも

```
always_ff (clk, reset) {
    if_reset {
        a = 0;
        b = 'x;
    }
    else {
        a = b + 2;
        b = a + 1;
    }
}
```

として、リセットで不定値にしたほうがシミュレーション時にバグだししやすいのでそういう書き方をよくします(これも賛否ありそうですが)。

taichi-ishitani, 2023-02-01:
後半の記述ですが、仮にリセット無しFFが合成できたとしても、RTLとネットリストで挙動が異なるので、さすがにこの記述は使えないですね

ryuz, 2023-02-01:
> 後半の記述ですが、仮にリセット無しFFが合成できたとしても、RTLと合成結果とでリセット時の挙動が異なるので、さすがにこの記述は使えないですね

ここはFPGA固有の事情はあるかと思います。現状リセット接続するFFを最小限にするのが推奨されているので、いつリセットを掛けたかで何が入ってるかわからない状態のFFだらけの状態から検証が必要となり、不定値いれたり乱数入れたりが必要になります。

今のところ手元のFPGAツール(Vivado)の場合、合成も問題なくやってくれるので、研究開発とか原理検証用の機器に使う分には手っ取り早く検証確認して動かしたいときには便利だったりもします。賛否あるのは否定しません。

ASIC開発とかに使えないというのはおっしゃる通りかと思います。

dalance, 2023-02-01:
リセット不要なら単純にリセットなしにした方がFPGAでもASICでも使え、初期値は不定になるのでシミュレーションでの確認もできる気がしますがいかがでしょうか？

```
always_ff (clk) {
    b = a + 1;
}
```

それはともかく、リセット漏れの警告は可能と思います。
警告なのかエラー相当なのかは要検討でしょうか。

taichi-ishitani, 2023-02-01:
「リセットの有無でalways文を分ける」っていうのはその通りなのですが、リセット以外の構造が同じ場合は纏めて記述したい場合を何とかできないですかね？

dalance, 2023-02-01:
確かにそうですね。
その場合、Veryl側の記法と生成されるSVをどうするかが問題になるかと思います。

Veryl側は単にリセットで値を指定しないのが簡単ですが、これだと元々の要望にあったような漏れとの区別がつかないです。
なにか「意図的にリセットしない」ことを示したい感じはします。

```
always_ff (clk, reset) {
    if_reset {
        a = 0;
        // bに関する何らかの記述
    }
    else {
        a = b + 2;
        b = a + 1;
    }
}
```

あと、SV側はVeryl側で1つだったalways_ffを2つに分割することになるので、
可読性と元コードとの対応関係がどうか、というところですね。

taichi-ishitani, 2023-02-01:
`not_reset b` みたいにアラタナキーワードを導入するか、`b=b` のように自己代入で代用するか、でしょうか？

ryuz, 2023-02-01:
ご検討ありがとうございます。

> b=b のように自己代入で代用するか

この場合、reset が来ているときに値を変化させないようにするロジックが生成されてしまうように思います。
リセット無しの always_ff に分けたのと同じ効果にしたければ if_reset {} の外に書かないと駄目じゃないかと思いました。

taichi-ishitani, 2023-02-01:
> b=b

この記述を「リセット無しとする」と言う意味です。

ryuz, 2023-02-01:
> この記述を「リセット無しとする」と言う意味です。

理解いたしました。大変失礼したしました。

ryuz, 2023-02-03:
> 後半の記述ですが、仮にリセット無しFFが合成できたとしても、RTLと合成結果とでリセット時の挙動が異なるので、さすがにこの記述は使えないですね

この点についてもう少し考えてみました。
LSI開発ではFPGAなどのラピッドプロトタイミング開発と異なり、RTLと生成されるネットリストが一致していないと後工程で困ることが多々あるのかと想像しております。

一方で、シミュレーションに際しては、タイミングバグで don't cate な値をラッチするようなミスを早期発見するのに意図的な不定値代入は役立つ場合もあるように思っています。

例えば Veryl でオプション指定しない限りは取り除かれる不定値挿入指示の構文があれば検証時に役に立つケースがないだろうかと考えてみたのですが如何でしょうか？(オプションON/OFFの両方で検証を流して確認するなど)

別の視点で、FPGAプロトなどで生産性だけを考える場合、値が don't cate になるケースで何を入れておくのが論理圧縮に有効かを合成器に任せられるので不定値を使う合理性もあるのですが、生産性と品質にトレードオフがあるのでケースバイケースかとは思っております。

taichi-ishitani, 2023-02-03:
> オプション指定しない限りは取り除かれる不定値挿入指示の構文

x を入れる手段はあるわけですし、特別な指示子は不要ではないでしょうか？
`a = 'x` のような、意図的な不定の代入を一律で消すオプションがあれば十分ではないでしょうか。

taichi-ishitani, 2023-02-03:
> オプション指定しない限りは取り除かれる不定値挿入指示の構文

ご指摘の通り、ASIC 開発においては、RTL とネットリストの一致は重要な項目です。
なので、生成後の SV に意図的な x の代入があると、流用するのが難しくなります。
どちらかと言うと、意図的な x の代入を一律で消してくれる方が有難いです。

`a = 'x` の様に x の代入手段はありますし、わざわざ別の指示子を導入するよりかは、x の意図的な代入を一律で消すオプションで十分ではないでしょうか？

ryuz, 2023-02-04:
コメントありがとうございます。

> a = 'x の様に x の代入手段はありますし、わざわざ別の指示子を導入するよりかは、意図的な x の代入を一律で消すオプションで十分ではないでしょうか？

おっしゃる通りかと思いました。ただ上の方で「リセット無し」記述をご検討されていたので、if_reset の中での x 代入に限り、「削除ではなくリセット無しとして扱う」のような手も含めて纏められないものかと少し思った次第でした。

x 代入も 波形ビューワでの目視はわかりやすいのですが、if 判定などでは単に偽になるだけなので偶然テストを抜けることもあり、Verilator など乱数を入れてくれるものも併用してテストしたりしています。これも完全ではないのでRTL記述段階からコントロールが効けば便利なケースも無いかと思ってみたのですが、ifdef 的なものを使うことも含めて代替手段はいろいろあるかと思っております(ですので、「何かのついででなら検討しても面白いかも」程度に捉えて頂ければ有難いです)。

もしトランスパイル時にいろいろやらせるのであれば

- Xを単純削除
- Xのまま残す
- X削除時に入る値の反転値を入れるコードに置き換える
- $random などの乱数を入れるコードに置き換える

などのバリエーションがあれば、一部はシミュレータだけではできないテストが出来そうに思いました。
(当方が、FPGAベンダーツールと 無償のOSS しか扱ったことがなく、ASIC用のEDAツールの世界だともっと違う解決方法があるのかもしれませんが)

taichi-ishitani, 2023-02-04:
> 「削除ではなくリセット無しとして扱う」

* リセットが不要
* 意図的に x を入れている

との区別がつかないですから、やはり記述上の区別は必要ではないでしょうか？
個人的な感覚ですが、「x の代入」はイレギュラーな記述なので、「リセットが不要」と「x の代入」の記述上の区別は欲しいところです。

taichi-ishitani, 2023-02-04:
もう一点。

```
if_reset {
  a = 'x
}
```

ですと、字面上は「２回目以降のリセットでも x になる」となります。
しかし、これを「リセットなしと扱う」とすると、実際の動作は「リセットが入力されても前の値を保持」となります。
なので、字面上の動作と実際の動作がことなるので、「if_reset 中の x 入力をリセットなし」とするのは不適当ではないでしょうか。

ryuz, 2023-02-04:
> なので、字面上の動作と実際の動作が異なるので、「if_reset 中の x 入力はリセットなし」とするのは不適当ではないでしょうか。

苦し紛れのいいわけをさせて頂くと、コンパイラは X の値をどう扱っても合法ですので、リセットなしに翻訳しても合法ではあると言えなくはないかとも思いました。
これは Veryl をコンパイラの一部ととらえるか、あくまでトランスパイラ (有効なSVを得たい)と捉えるかで変わってくるような気がしており、個人的にはトランスパイラとして使いたいのでおっしゃるご指摘その通りかと思います(やめた方がよさそうですね)。

taichi-ishitani, 2023-02-04:
デバッグの際はSVをみるわけで、Veryl上で見える動作と、SV上の動作が違うのは、混乱の元になり得ます。

また、「xの意図的な代入」と、「リセットなし」は、意図が異なるので、代用させないほうが良いと考えます。
Verilogのalways文にFF記述と組合せ回路記述の両方を担わせた例を考えれば、理解いただけるかと思います。

ryuz, 2023-02-04:
> デバッグの際はSVを見るわけで、

なるほど確かにその通りですね。

上で出ていた

> b=b
> この記述を「リセット無しとする」と言う意味です。

も同じことかと思いました(こちらはあくまで、たとえ話かとは思いますが)。
リセットの方も何かスマートな落としどころに落ち着くと嬉しく思います(妙案思いつかず申し訳ないのですが)。

taichi-ishitani, 2023-02-04:
「用途とは違う機能を担わせる」と言う観点では、よろしくない提案ですね。

- 次点の案である
- 「リセットが入っても前の値を保持」という挙動は守られている

という点を踏まえて提案した次第です。

dalance, 2023-02-06:
いろいろと難しいですね。
まずリセットなし宣言の構文についてですが、

* `not_reset b` のような特別な構文
  例によって代入文は構文的には結構深い位置にある（つまりalways_ffに限らずあらゆる位置に出現可能）ので
  特別な構文の導入コストは比較的高いです。
  `b = not_reset;` のようの代入文的にする方が多少ましですが、これもこれで任意の式中に `not_reset` を許容することになります。

* `b=b`
  構文的にはこちらの方がいいですが、通常の文が特別な意味を持つというのがどうか、という点はあります。
  例えば `b=(b);` や `b={b};` 、 `b=b+0;` はどう判断すべきか、といった部分です。

* `#[not_reset]` アトリビュート
  構文への影響を少なく指定する方法としてアトリビュートは考えられますが、アトリビュートの付与先がありません。

また生成されるSV側の問題として

* 論理の重複
  Veryl側で1つの `always_ff` が2つに分割されるので、内部の論理はそのままコピーされます。
  Veryl側で2つに分けていれば、その時点の可読性に応じてfunction化したり一旦 `always_comb` で複雑な論理を切り出したりするかもしれませんが、1つなら許容できるかもしれません。
  つまり可読性に関する判断がVerylとSVでずれてしまう気がします。

* コメントの扱い
  現在Veryl側のコメントはSV側のなるべく適切な位置に出力するようにしていますが、あまり大規模なコード改変が起きるとこれは難しくなります。
  コメントはコメント対象に対して前置と後置両方のケースがあるので、あるコメントがどの文に付いているのかを正確に判断するのは困難です。

といった点があります。

taichi-ishitani, 2023-02-06:
> リセットなし宣言の構文

* 変数宣言時にリセット不要であることを指示する
* リセット漏れチェックをしない `if_reset` の導入する
    * チェック漏れが出る恐れがありますが

はどうでしょうか？

dalance, 2023-02-06:
> 変数宣言時にリセット不要であることを指示する

これは良さそうなんですが、structやinterfaceのメンバー毎に指定ができないのが気になります。

taichi-ishitani, 2023-02-06:
> 例によって代入文は構文的には結構深い位置にある

パーサーの実装的にはあまり行儀が良いとは言えないでしょうが、`if_reset` の中に限りルールを、`代入文 | リセット不要指示` のようにするのはどうでしょうか？

dalance, 2023-02-06:
> パーサーの実装的にはあまり行儀が良いとは言えないでしょうが、if_reset の中に限りルールを代入文 | リセット不要指示 のようにするのはどうでしょうか？

文脈によって構文を切り替えるというのはかなり大きな判断ですね。
SVにおけるパースの難しさの主要因だと思っています。
正直ここまでの大変更（将来的な構文複雑性も含めて）を許容してまで導入すべき機能かどうか疑問に思ってはいます。

taichi-ishitani, 2023-02-06:
確かにご利益は少なそうですね。
リセット不要指示については、棄却でよいかと思います。

dalance, 2023-02-06:
ひとまず当初の要望であったリセット漏れチェックのみ追加しました。
リセット不要指示についてはいいアイデアが出てば再度検討したいと思います。

taichi-ishitani, 2023-02-07:
> #[not_reset] アトリビュート

Verilogの習慣の `// case Parallel` みたいに、`always_ff` とか `if_reset` に対してアトリビュートを付けるのはどうでしょうか？

dalance, 2023-02-07:
> Verilogの習慣の `// case Parallel` みたいに、`always_ff` とか `if_reset` に対してアトリビュートを付けるのはどうでしょうか？

リセット漏れチェックをそのalwaysだけ無効にする感じでしょうか？
lintをアトリビュートで無効化する機能があればそれで対応できそうですね。

taichi-ishitani, 2023-02-07:
> リセット漏れチェックをそのalwaysだけ無効にする感じでしょうか？

それでいいですし、チェック漏れを防ぐ観点からは、チェックを外す信号を個別に指定できる方が良いように思います。

dalance, 2023-02-07:
> それでいいですし、チェック漏れを防ぐ観点からは、チェックを外す信号を個別に指定できる方が良いように思います。

命名は適当ですがこんな感じでしょうか。

```
#[allow(not_reset("a", "b.d"))]
always_ff (clk, rst) {
    if_reset {
        c = 0;
    } else {
        a   = 0;
        b.d = 0;
        c   = 0;
    }
}
```

taichi-ishitani, 2023-02-07:
はい、このようなコードをイメージしていました。

dalance, 2023-02-07:
とりあえず allow アトリビュートを実装しました。
致命的なエラーでないものについては指定可能です。
missing_reset_statementの信号指定はまた別途考えます。

```
module Module29 (
    clk: input logic,
    rst: input logic,
) {
    var a: logic;
    var b: logic;
    #[allow(unused_variable)]
    var c: logic;

    #[allow(missing_reset_statement)]
    always_ff (clk, rst) {
        if_reset {
            a = 0;
        } else {
            a = 0;
            b = 0;
        }
    }

    #[allow(missing_port)]
    inst u0: Module29 (

    );
}
```

Closed 2023-02-07.

Thread 127 (2023-02-09):

[Feature] macro

dalance, 2023-02-09:

shady831213, 2023-04-27:
Is it possible as powerful as macro of rust to replace generate block of sv? Then we can implement very cool generation work, such as control regsisters module generation.:blush:

Thread 135 (2023-02-16):

Change dependencies format

dalance, 2023-02-16:
Currently, name of left hand side is mandatory in `dependencies` section.
It blocks to merge the same indirect dependency through different project.
In the following case, the `common` project should be instantiated at once,
but which namespace should be selected `common` or `cmn`?

* project_x

```toml
project_a = {git = "https://example.com/user/project_a", version = "0.1.0"}
project_b = {git = "https://example.com/user/project_b", version = "0.1.0"}
```

* project_a

```toml
common = {git = "https://example.com/user/common", version = "0.1.0"}
```

* project_b

```toml
cmn = {git = "https://example.com/user/common", version = "0.1.0"}
```

So I'll remove name. The project name of dependencies is used as namespace.
`name` field is optional to avoid namespace conflict.

```
[dependencies]
"https://example.com/user/common1" = "0.1.0"
"https://example.com/user/common2" = {version = "0.1.0", name = "common2"}
"https://example.com/user/common3" = [
    {version = "0.1.0", name = "common3_1"},
    {version = "0.2.0", name = "common3_2"}
]
```

Closed 2023-02-21.

Thread 138 (2023-02-17):

[Feature] Constant expressoin on width field of integer literals

taichi-ishitani, 2023-02-17:
Currently, we need to use a fixed decimal value for the width field of integer literals.
If the LHS expression of an assignment operation is parameterized then we need to insert a width cast operation like below to prevent width mismatch.

```
var a: logic<ParamA>;
a = ParamA'(16'habcd);
```

I think it is bother notation little bit. How about allowing to put a positive integer constant expession on the width field of integer literals like below?

```
var a: logic<ParamA>;
a = ParamA'habcd;
```

taichi-ishitani, 2023-02-17:
In addition, there are literals `'0`/`'1`/`'x`/`'z` to to set 0/1/x/z to all bits but its width is determined by the LHS expression.
Therefore, I'd like to introduce literals to set 0/1/x/z and its width is determined by itsef. This is an example code.

```
a = {4'a1, 4'a0};
```

Prefix **a** means **all bits**.

dalance, 2023-02-24:
Starting with expression causes left recursion, and it is difficult to parse.
So another syntax is required.

taichi-ishitani, 2023-02-25:
OK, I understood.
How about using parameter identifiers but not constant expressions?

dalance, 2023-03-03:
Instead of constant expression, width less literal seems to be good.

```
a = 'h8000;
b = 'h80000000;
c = 'h8000000000000000;
```

In generated code, appropriate width will be filled.

```verilog
a = 16'h8000;
b = 32'h80000000;
c = 64'h8000000000000000;
```

dalance, 2023-03-10:
About set all bits literal, how about the following syntax?

```
a = {4'0, 4'1, 4'x, 4'z};
b = '0;
c = '1;
d = 'x;
e = 'z;
```

I think this is more consistent with the existing `'0`/`'1`/`'x`/`'z` .

Alternatively, consolidate to `'a`.

```
a = {4'a0, 4'a1, 4'ax, 4'az};
b = 'a0;
c = 'a1;
d = 'ax;
e = 'az;
```

But `a` may be bit confusing because it is not radix.

taichi-ishitani, 2023-03-10:
I prefer the first syntax because `a` is a hexadecimal digit.

Closed 2023-03-15.

Thread 140 (2023-02-17):

[ご相談] initial 文の対応について

ryuz, 2023-02-17:
いつもお世話になっております。
おそらくFPGA固有の話になってくるかと思うのですが、FPGAではリセットによる初期値とは別にブートROMなどからのビットストリームダウンロード時の初期値が存在し、しばし合成記述の中で変数の初期値であったり、initial 文での初期化によって指定する方法がとられます。
メモリ推論時などは initial 文の中で $readmemh で初期化したり、算術用のテーブルを for 文で作ってしまったりということもあります。
現状の Veryl には initial 文は無いかと思いますが対応される予定はありますでしょうか？

taichi-ishitani, 2023-02-18:
always_xxxは自身以外からの代入を禁止しているので、initial文と併用するなら、従来のalways文を使う必要があります。せっかくSV入でったチェック機構がなくなってしまうので、限定的に隠匿した形でinitial文を導入すべきなのではと思います。

なので、以下のように、always_ff内のみで使用できる制御構文（at_init）を導入して、この制御構文が含まれるalways_ff文は、従来のalways文とinitial文に分けてSVにするのが良いのではないかと思います。

```
always_ff {
　　at_init {
      a = 1;
    }
  a = b;
}
```

> 算術用のテーブルを for 文で作ってしまったりということもあります。

これについては、always_combでやるのが良いと思います。
シミュレーション開始時に必ず実行されるので、シミュレーションでも、テーブルの初期化が可能です。

taichi-ishitani, 2023-02-18:
変数の初期化であれば、宣言時の初期値代入でも良いような気もしますが、always_ffと併用出来るかは未確認です。

ryuz, 2023-02-18:
早速のご回答ありがとうございます。

> なので、以下のように、always_ff内のみで使用できる制御構文（at_init）を導入して、この制御構文が含まれるalways_ff文は、従来のalways文とinitial文に分けてSVにするのはどうでしょうか？

はい、何らかの形で SV 変換時に initial 文が生成できれば問題ないと考えます。

Xilinx 社 Vivado の話に限定かもしれませんが、シンセサイザのマニュアルにメモリの初期化は initial 文の中に書くように記載があり、現状これに従っております。頻度の少ない話ではありますので最悪そこだけ SV で書く手はあるのですが、Veryl にも何らかの記述方法があれば嬉しいです。

https://docs.xilinx.com/r/ja-JP/ug901-vivado-synthesis/HDL-%E3%82%BD%E3%83%BC%E3%82%B9-%E3%82%B3%E3%83%BC%E3%83%89%E3%81%A7-RAM-%E3%81%AE%E5%88%9D%E6%9C%9F%E5%86%85%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

dalance, 2023-02-18:
`initial` 自体はパラメータチェックの `assert/assume` や `display` でも使いそうなので
普通に入れていいと思いましたがどうでしょうか。

どちらかというとかなり限定的な用途のために専用構文を割り当てる方が良くない気がします。
（専用構文で簡単に書けるということは使用を促進することになるので）

`always_ff` と `initial` を併用できないということであれば `always` を出力するアトリビュートなどあればいいかもしれません。

```
initial {
    a = 1;
}

#[emit(always)]
always_ff (i_clk, i_rst) {
    a = x;
}
```

taichi-ishitani, 2023-02-20:
上記の理由に加えて、「初期化はその FF に付随するので同じ always_ff 内の方が良かろう」との理由で、専用の制御構文を提案した次第です。
initial 文のサポートを決断したのであれば、特段の異論はありません。

DC では、initial 文での変数への代入はエラーになるか無視されるかなはずなので、シミュレーションと合成とで不一致が出てしまいます。
なので、initial 文での変数代入は、デフォルトではエラーにしておいた方が良いのではないかと思います。

dalance, 2023-02-20:
initial文をサポートするかどうかとFPGA向けのFF初期値をどのように記述するかは別に考えた方がいいかもしれませんね。
今のところ

* initial （finalも？）は入れても良さそう
* FPGAのFF初期値記述はもう少し考えた方が良さそう

という印象です。

taichi-ishitani, 2023-02-20:
> 変数の初期化であれば、宣言時の初期値代入でも良いような気もしますが、always_ffと併用出来るかは未確認です。

```systemverilog
module top;
  bit clk;
  bit a = 0;

  always_ff @(posedge clk) begin
    a <= ~a;
  end

  initial begin
    $finish;
  end
endmodule
```

上記の記述を各社のシミュレータでコンパイルしてみました。

* Aldec Riviera Pro
* Mentor QuestaSim
* Synopsys VCS

はコンパイルできましたが、

* Cadence Xcelium

はコンパイルエラーになりました。

dalance, 2023-02-21:
とりあえず `initial` / `final` は入れようと思います。
（`final` は必要性は低そうですがあえて排除する理由もなさそうなので）

initial内代入エラーの抑制も付けると、もともとの要望はこんな感じになるでしょうか。

```
#[allow(initial_assignment)]
initial {
    a = $readmemh("data.hex");
}

#[emit(always)]
always_ff (i_clk, i_rst) {
    a = x;
}
```

taichi-ishitani, 2023-02-21:
> #[allow(initial_assignment)]

合成段階での手戻りを防ぐためにも、アトリビュートの使用自体をグローバルに無効にする機能も必要ではないでしょうか？

dalance, 2023-02-21:
> 合成段階での手戻りを防ぐためにも、このアトリビュートの使用自体を、依存するプロジェクトも含めて、無効にする機能も必要ではないでしょうか？

確かにそうですが、そのようにモードを増やしていくと運用が難しくなりますね…。
（「ASICのときはA,Bをtrueに」「FPGAのときはX,Yをfalseに」といった具合に）

また仮に依存先でこのエラーが検出されたとして、その依存関係を使わないという以外にはどうしようもない
という点も気になります。

こういった特殊な記述はSVで書いてもらうことにして、Verylとしては対応しない方がいいかもしれません。

taichi-ishitani, 2023-02-21:
> 依存関係を使わない

確かにそうなのですが、早期に検知できれば、他のプロジェクトに差し替えるとか、特定のモジュールだけ自分で書くとか、対処はより容易なのかなと思います。

> そのようにモードを増やしていくと運用が難しくなりますね…。

* デフォルトは全機能有効
* 「使用禁止な機能リスト」を指定できるようにして、サブセットを定義できるようにする

様するのはどうでしょうか？

dalance, 2023-02-21:
> 確かにそうなのですが、早期に検知できれば、他のプロジェクトに差し替えるとか、特定のモジュールだけ自分で書くとか、対処はより容易なのかなと思います。

直接の依存関係であれば差し替え可能ですが、深い間接依存先でそのようなコードがあった場合
依存関係全体が使用不能になってしまいますし、
ただでさえ小さなエコシステムがモードによって細分化されていくのはあまりよくない気がしています。

taichi-ishitani, 2023-02-21:
となると、

> 特殊な記述はSVで書いてもらうことにして

になりますかね？

dalance, 2023-02-22:
例えばプロジェクト毎に `vendor = "xilinx"` くらいの粒度で指定するのは可能かもしれません。
（`vendor` 無指定のプロジェクトが `vendor = "xilinx"`のプロジェクトに依存するのは禁止みたいな感じで）

ryuz, 2023-02-22:
毎回面倒なご相談をしてしまい申し訳ないです。

> vendor = "xilinx"

ベンダーは社名が変ったり(Xilinx -> AMD)、ツールバージョンでまたルールが変ったりすることも多いので、あまり良い手ではない気がしました。

個人的には Rust の std (OSあり)と no_std (OSなしのベアメタル)のように、言語としての使える機能がプロファイルとしてうまく住み分けできればなとは思いました。
とはいえ、Veryl の思想的に FPGA が合わない部分も多そうな気はしておりますので、「書けないものは SV で書く」というのはありかと思います。

dalance, 2023-02-22:
unsafeですかね。
プロジェクト毎にunsafeかどうかを設定して、unsafeでないプロジェクトはunsafeなプロジェクトに依存禁止。
unsafeプロジェクトではunsafeアトリビュートが使える、という感じで。
（アトリビュートの命名的にもこちらの方がいい気がします）

```
#[unsafe(initial_assignment)]
initial {
    a = $readmemh("data.hex");
}

#[unsafe(emit_always)]
always_ff (i_clk, i_rst) {
    a = x;
}
```

ryuz, 2023-02-23:
> unsafeですかね。

私は unsafe でも構わないのですが、Rust 的な感覚だと safe / unsafe はコードレビュー時のチェックリストの一部をコンパイラに任せてよい／悪い、を切り替えるポイントのイメージを持っているのでFPGAの為に使うにはもったいないワードな気もしました。
（将来の為に温存されても良いような予約語に思いました）

> プロジェクト毎にunsafeかどうかを設定して、unsafeでないプロジェクトはunsafeなプロジェクトに依存禁止。

Rust みたいに、使う側が 「unsafe とわかってって使います」と明示しないと使えない安全機構は良いと思いました。
ちなみにFPGAの場合、多分、 RAMとかFIFOとかのプリミティブなものでよく使うと思うので、結局全部 unsafe になりそうですね。

ryuz, 2023-02-23:
> プロジェクト毎にunsafeかどうかを設定して、unsafeでないプロジェクトはunsafeなプロジェクトに依存禁止。

ちょっと気になったのですが、この場合 Veryl から SV の module を使う場合も unsafe になるのでしょうか？
(Rust とかだと、C++ の関数を呼び出すところは unsafe だったかと思いますが)

taichi-ishitani, 2023-02-23:
対象のアトリビュートを使った時点でunsafeな訳ですから、プロジェクト内で使用を禁止するアトリビュートを指定できるようにできる方が良いのではないでしょうか？

ryuz, 2023-02-23:
Very の思想として ASIC 向けにデフォルト strict な言語であり、厳密な記述以外を含めない保証をすることで、言語で安全性を保障できる範囲を SV に対して広げたいというものかと想像しております。

一方で Rust がそうであるように FPGAなどでラフにラピッドプロトがやりたいケースでも生産性向上に寄与してくれそうに思っており、厳密性を緩めてほしいケースがありそうに思っておりご相談させて頂いている次第ですが、strict  の対義語を調べると lenient というのが出てきましたがこの手のワードを当てるとか、Rust の core と std みたいな位置づけとか如何でしょうか？

> unsafeなプロジェクトに依存禁止。

に対して、Rust で core なクレートは std なクレートに依存できない(逆は可) と似ている気がしています。

unsafe は、将来 ASIC 用に「ここだけは例外的な書き方をするけど、人間の方でしっかりケアしたから大丈夫(もしくはここはちゃんとレビューしないと危険というマーク)」に使えるように予約語を温存されてはいかがでしょうか？
Very 外のものとの接続など、厳密性を求める世界の中でも起こる例外の為に unsafe の語を温存しておいた方が有意義な気がしました。

dalance, 2023-02-23:
確かにunsafeもちょっと違いますね。
Rustのunsafeは「論理的には正しいけど（現在の技術では）コンパイラが証明できないので代わりに人間が保証する」というものなので
その人間を信用すれば安心して使うことができます。
一方で、今回の場合は「Vivadoの特定のバージョンでは正しいがそれ以外の環境では間違う」というものなのに
「Vivadoの特定のバージョン」という情報がどこにも書かれていないので、使っていいかどうかはコードを精査するまでわからなくなってしまいます。
（なので厳密にやるなら `target = "vivado@20XX.X"` のような指定が必要になりますが、それはVerylの領分を超えている気がします）

許可するアトリビュートを指定する方式にしても `initial_assignment` や `emit_always` というアトリビュートと「Vivado環境でRAMの初期値を `readmemh`  したい」というのの距離がありすぎて、何を指定していいかわからないです。
（今回の実装ではたまたまその2つでしたが、そうなるかどうかは実装次第ですし）

というわけで、今回のように特定の環境向けの特殊記述については（現時点では）SVで書くことにしておくのがいいような気がしてきました。

ryuz, 2023-02-23:
> というわけで、今回のように特定の環境向けの特殊記述については（現時点では）SVで書くことにしておくのがいいような気がしてきました。

ご検討ありがとうございました。 SV で書くという事でもすぐに困ることはないかと思います。

もし将来的に Veryl のオプション機能として縛りを緩める(SVで書ける事をいろいろ許容する)機能が追加されるようであれば、またご検討いただければ幸いです。

あと、一点、SV で書くのを前提とした場合、パッケージマネージャの方で GitHub にある SV のみの特定のタグのソースが取ってこれるとか、同じパッケージの中に Veryl と SV のソースコードを混在管理できるとかがあると便利に思いました。
もしよろしければご検討いただければ幸いです。

dalance, 2023-02-23:
> あと、一点、SV で書くのを前提とした場合、パッケージマネージャの方で GitHub にある SV のみの特定のタグのソースが取ってこれるとか、同じパッケージの中に Veryl と SV のソースコードを混在管理できるとかがあると便利に思いました。
もしよろしければご検討いただければ幸いです。

これも素朴に実装すると同じ問題が発生しそうですね…。
（依存関係を通してVivado専用のSVを引き込んでしまう可能性がある）
間接依存先からはSVは取ってこないとか何らかの制限は必要そうな気がします。

ryuz, 2023-02-23:
> これも素朴に実装すると同じ問題が発生しそうですね…。
>（依存関係を通してVivado専用のSVを引き込んでしまう可能性がある）
> 間接依存先からはSVは取ってこないとか何らかの制限は必要そうな気がします。

Vivado とは無関係に、既存の SV で書かれたモジュール資産を Veryl のソースからインスタンシエートして利用するということは少なからず必要なのかと思いますので、安全性の保証の問題はありそうですね。
既存の SV には何の仕組みも無いわけなので、取り込む側の Veryl 側から、取り込み先の URL と ハッシュに対してホワイトリストを与えるなり、何らかの「人間側で安全と確認したものしか取り込まない」仕組みが必要なように思いました。

taichi-ishitani, 2023-02-23:
依存先のプロジェクトの作者が、FPGA がメインで、ASIC 開発に明るくない場合、何が安全か確認のしようがないかと思います。
なので、使う側で確認するなりすべきで、

* 含まれる素の SV の一覧を取得できるようにして、安全性の確認をしやすくする
* 素の SV を上書きできる仕組みを用意する

が必要ではないでしょうか？

ryuz, 2023-02-23:
> 使う側で確認するなりすべきで、

これが基本なんだろうなと思いました。

> 素の SV を上書きできる仕組みを用意する

どこかに fork して、安全なように書き換えたもののコミットハッシュ値をホワイトリスト登録するのが再利用性が高そうにも思いましたが、たしかに Very 内で 中身を確認したり、上書きしたりできる仕組みがあると便利そうですね。

個人的には

1.  使う側で依存先のコードをしっかり確認して安全確認できたもののみ自プロジェクトのホワイトリストに加える
2.  ホワイトリストにないものは取り込まない

みたいな感じを想像していました。

dalance, 2023-02-23:
SVについては名前衝突の問題もありますね。
いわゆるdependency hell （複数の間接依存先で同パッケージ異バージョンが衝突する）を回避するためにVeryl側では衝突検知と名前の付け替えなどやっていますがSV側は無理です。
なのでSVは直接参照のみ、かつSVのインポートを明示する感じでしょうか。

```toml
"https://example.com/with_sv_prj" = {version = "0.1.0", import_sv = true}
```

これなら衝突回避はユーザの責任になりますし、
明示が必須なので実質ホワイトリスト相当になるかと思います。
ファイル単位などの細かい上書き制御は過剰かなという気がします。
自プロジェクトに取り込んで修正するか、folkして修正したものをインポートするかで対応可能かと。

オプションについてはsvとvlを一緒にインポートするのとsvだけインポートが必要かもしれません。
（後者は間接依存先のsvのみインポートしたい場合など）

dalance, 2023-02-24:
本件の解決にはなっていませんが、`initial` `final` は追加しました。
現時点では `display` くらいしかできることがないですが、将来的には `assume` などを行う想定です。

ryuz, 2023-02-24:
> 明示が必須なので実質ホワイトリスト相当になるかと思います。

依存先の依存先など階層の深いところで読み込まれているSVが、トップ階層から把握しきれなくなるケースが無いかと思った次第でした。

なので2階層以上深いところで依存している SV 関しては、一旦エラーにして、トップ階層で改めて許可(ホワイトリスト登録)して初めて通るような仕組みが必要かなと思いましたが、如何でしょうか？

dalance, 2023-02-24:
すいません。書き方が分かりにくかったかもですが、

> SVは直接参照のみ

が依存先の依存先など階層の深いところからSVを読み込まない（というより名前衝突の問題があるので読み込みたくても読み込めない）ということを言っています。
なので深いところのSVはホワイトリストを別途登録するのではなく、SVを読み込みたいものは別途直接依存に書くようにするというのが解決策になります。

例えば以下のようなprj1/prj2があって

```
prj1
  - src/a.vl
  - src/x.sv

prj2 (prj1に依存している)
  - src/b.vl
  - src/y.sv
```

以下のような依存関係を書くと

```toml
[dependencies]
"https://example.com/prj2" = "0.1.0"
```

以下のファイルが読み込まれます。

```
prj1/src/a.vl
prj2/src/b.vl
```

ここで

```toml
[dependencies]
"https://example.com/prj2" = {version = "0.1.0", import_sv = true}
```

とすると

```
prj1/src/a.vl
prj2/src/b.vl
prj2/src/y.sv
```

となります。

```toml
[dependencies]
"https://example.com/prj2" = {version = "0.1.0", import_sv = true}
"https://example.com/prj1" = {version = "0.1.0", import_sv_only = true}
```

とすると

```
prj1/src/a.vl
prj1/src/x.sv
prj2/src/b.vl
prj2/src/y.sv
```

となるイメージです。

ryuz, 2023-02-24:
> が依存先の依存先など階層の深いところからSVを読み込まない

なるほど、勘違いしておりました。すみません。

> というより名前衝突の問題があるので読み込みたくても読み込めない

こちらも了解です。つまりある程度 SV に追い出さないといけない機能を多用する場合、深い階層が取れなくなってくるということですね。

FPGAなどの場合、あまり小分けにせずに、モノリポ的に統合していった方がややこしい問題を起こさないかもしれませんね。

ryuz, 2023-03-12:
折角 initial 文をご対応いただいたので、下記の FPGA用 の SV のコードを Veryl で書き直せないか試し中です。
(汚いコードですみません)

https://github.com/ryuz/jelly/blob/master/rtl/math/jelly2_calc_crc.sv

CRCテーブルを initial で作成して ROM化しておいて、後からテーブル引きする構造なのですが、initial 文の中で代入を書こうとすると

```
assignment statement can't be placed at here
```

となってしまうので、上の方で一度話に出た  #[unsafe(initial_assignment)]  のようなものが無いとやはり難しそうですね。

やはりこの手のものは SV で書くのが無難そうです。

ちなみに、initial や always_comb の中でローカル変数を宣言したりするのも NG のようですが、このあたりもそういうポリシーで、必要なら function を作るべきという理解で良いでしょうか？

taichi-ishitani, 2023-03-12:
テーブルの初期化なら、always_combでも可能ですね。

taichi-ishitani, 2023-03-12:
論理的には違いはないと思うのですが、回路的に違いがあるのでしょうか？

ryuz, 2023-03-12:
> 論理的には違いはないと思うのですが、回路的に違いがあるのでしょうか？

試してないのですが、FPGAの内蔵SRAMブロックの初期化は少し特殊扱いなので、マニュアルにない方法で仮に今のバージョンで動いても将来保証されるものでもないので、どうしたものかなと思っております。

ryuz, 2023-03-12:
試しに今、テスト用に ROM を作って、初期化を always_comb  と initial とで切り替えてみたところ合成結果が変りました。

Vivado 2022.2 で、どちらも RAMは推論してくれたのですが、どうも initial だと中身で bit が固定な部分などがあると最適化しているようで少し小さな結果が出てきましたが  always_comb  だと少し大きいものになりました。
case 文で書いたテーブルを ROM推定してくれたりもするので、仮説ですが、前者はメモリ初期値として最適化していて、後者はロジックとして出した後に最適化の結果ROMを推論しているとか、何か解釈の違いは出ていそうな気がします。

dalance, 2023-03-13:
> ちなみに、initial や always_comb の中でローカル変数を宣言したりするのも NG のようですが、このあたりもそういうポリシーで、必要なら function を作るべきという理解で良いでしょうか？

特にこの件についてのポリシーというわけではありませんが、全体的なポリシーとして
「特に理由がない限りSystemVerilogを引き継ぐ」というのはあります。
基本的にSystemVerilog とセットで使う前提の言語なので、不要なところまで変えるべきではないということです。

なのでローカル変数の宣言についてはSystemVerilogがそうなっており、
特別にそれを許可する理由がないから、ということになります。

ryuz, 2023-03-13:
> なのでローカル変数の宣言についてはSystemVerilogがそうなっており、

勘違いしていたらすみません、現状の Veryl でも for 文でループ変数がローカル変数として for 内だけでつけると思いますが、SystemVerilog で begin の直後で変数が定義可能と思いますがそれはまた違うものなのでしょうか？

dalance, 2023-03-13:
> 勘違いしていたらすみません、現状の Veryl でも for 文でループ変数がローカル変数として for 内だけで使えると思いますが、SystemVerilog で begin の直後で変数が定義可能と思いますがそれはまた違うものなのでしょうか？

確かに `begin` の直後だけ書けますね…。
そうすると対応は可能になってきますが、
個人的には構文を複雑化させてまで追加するメリットは感じられないです。
実質的にalways_combでしか使えないですし。

taichi-ishitani, 2023-03-13:
```systemverilog
always_ff @(posedge i_clk) begin
  int temp;
  temp = a + b;
  c <= temp;
end
```

みたいに `always_ff` でも使えますね。
ただ、Veryl の場合、ノンブロッキング代入とブロックキング代入の字面上の違いがないので、混乱やバグの元になりそうです。
なので、always ブロック中での変数宣言は未サポートにして、中間変数が必要なぐらい複雑な記述は function などに切り出すようにしてもらうのが良いように思います。

ryuz, 2023-03-13:
まれに便利なケースがあるぐらいで、問題にならない気がしますので

> 中間変数が必要なぐらい複雑な記述は function などに切り出すようにしてもらうのが良いように思います。

に同意です。

ただ、逆に今の Veryl の function を試すと

- function ブロックの先頭以外でも var 宣言できてしまい、シミュレータに持っていくとエラーになる
- function であっても for や if などのブロック内だけのローカル変数は禁止の模様

という２点に気が付きました。後者は必要ならさらに function に分ければいいので不要と思いますが、前者は Veryl でもエラーになってくれる(もしくは自動でブロック先頭に移動してくれる)と嬉しいです。

dalance, 2023-03-13:
functionはブロック先頭に移動させるつもりで構文上は制限していなかったのですが未実装ですね…

ryuz, 2023-03-13:
> functionはブロック先頭に移動させるつもりで構文上は制限していなかったのですが未実装ですね…

個人的には変数はなるべく使う場所で宣言する方が好きですので、そういう方向性は嬉しいです。
特に今は困っておりませんので、将来ご検討いただければ幸いです。

dalance, 2023-03-14:
ちょっと話があちこちに飛んで、何が未検討なのか管理できなくなってきたので
残件を別issueにして一旦閉じます。
まとめると

* 発端となったinitialは追加済み
* FPGA用のRAM初期化はSVで書く
* SVの依存追加は #185 で継続
* functionの件は #184 で継続

です。もし見落としがあれば別issueを立ててもらえれば。

dalance, 2024-11-13:
initial文での代入は #823 で再度検討しています。
今のアイデアはinitial_assignしたプロジェクトは`veryl publish`できない
（のでASICプロジェクトの依存関係に間違って入ってしまうことはない）というものです。

Closed 2023-03-14.

Thread 143 (2023-02-23):

[質問] ビット範囲の指定方法の経緯について

ryuz, 2023-02-23:
興味本位の質問で恐縮なのですが、Very の文法はかなり Rust 的な要素が多いと感じております。

その中で変数の宣言は

```
var a: logic<8>
```

のように MSB+1 を指定する Rust 的な指定なのに、特定ビット範囲の切り出し(スライス？)の指定は

```
assign b = a[7:0];
```

のようになっており、どうしてここは Rust 的な

```
assign b = a[0..8];
```

という MSB+1 を使う記法ではないのかなというのが少し気になりました。

もしよろしければ現状文法に至った経緯を教えて頂けないでしょうか？

すでにどこかで議論されていたら申し訳ありません。

taichi-ishitani, 2023-02-23:
範囲リテラルが未導入だったからとかでしょうか？

dalance, 2023-02-23:
範囲リテラルが未導入というだったのもありますが、
#141 に書いたように、range と part select は積極的に構文を分けた方がいいと思っているのもあります。
なのでpart selectに相当するRustの構文は存在しない（強いていうなら `as u32` みたいなやつかもしれませんが）のでSVを継承した感じです。

ryuz, 2023-02-23:
ご回答頂きありがとうございます。

> part selectに相当するRustの構文は存在しない（強いていうなら as u32 みたいなやつかもしれませんが）のでSVを継承した

なるほど、 range と part select の違いがよく理解できておりませんでしたので、理由が知れてすっきりしました。
有難うございます。

Closed 2023-02-24.

Thread 145 (2023-02-24):

Quartus support

dalance, 2023-02-24:
https://github.com/dalance/veryl/issues/141#issuecomment-1439404287

The following configuration may be helpful to support Quartus.

* `expand_inside`
* `explicit_generate`
* `outside_genvar`

The following feature seems to be difficult to support.

* type parameter
* `case inside`

taichi-ishitani, 2024-09-03:
By #873, `expand_inside` and `case inside` are supported.

Thread 175 (2023-03-12):

[質問] モジュール名の加工について

ryuz, 2023-03-12:
どこかにすでに書いてあったら恐縮なのですが、いくつか教えて頂けると助かります。

### モジュール名の加工について

現在の Veryl のソースを SV にするときに、モジュール名の前にプロジェクト名が付くようですが、例えば Rust の #[no_mangle] のように抑制する機能はあったりしますでしょうか？

### ファイル名も加工できないでしょうか？

モジュール名とファイル名が揃っていると、 verilator の `-y`  オプションや Vivado Simulator の `--sourcelibdir` オプションでの参照など、便利なことが多い気がするのですが、ファイル名もモジュール名と同様に加工することは可能でしょうか？

### バージョン番号も付与できたりしますでしょうか？

モジュール名にプロジェクト名だけでなく、バージョン番号もモジュール名に付与できるとSVで再配布するときも嬉しいことがありそうな気がしますが、如何でしょうか？

依存先の依存先のなどで、バージョン違いの同じパッケージが参照されていた場合なども共存できそうな気がしましたが、そのような事はありえますでしょうか？

dalance, 2023-03-13:
> 現在の Veryl のソースを SV にするときに、モジュール名の前にプロジェクト名が付くようですが、例えば Rust の #[no_mangle] のように抑制する機能はあったりしますでしょうか？

今のところありません。
ただ依存関係でない（つまりそのプロジェクトに直接所属している）ものはそもそもprefixの付与は不要なような気もします。
（prefix付与は依存関係間での衝突回避のためなので）

> モジュール名とファイル名が揃っていると、 verilator の -y オプションや Vivado Simulator の --sourcelibdir オプションでの参照など、便利なことが多い気がするのですが、ファイル名もモジュール名と同様に加工することは可能でしょうか？

どちらかというと上で書いたように名前を維持する方がいい気がします。
依存関係についてはファイル名の変更も可能ではありますが、そもそも生成されるファイルリストで参照すべきなので、あまりファイル名に依存すべきではないと思います。
（例えば参照先のバージョンが上がってファイルが増えた場合に、ファイル名を直接スクリプトに書いていると変更漏れが発生する、など）

> モジュール名にプロジェクト名だけでなく、バージョン番号もモジュール名に付与できるとSVで再配布するときも嬉しいことがありそうな気がしますが、如何でしょうか？

パッチバージョン変更が破壊的変更になってしまうなどデメリットの方が大きそうな気がします。
具体的なメリットはどのあたりでしょうか？

> 依存先の依存先のなどで、バージョン違いの同じパッケージが参照されていた場合なども共存できそうな気がしましたが、そのような事はありえますでしょうか？

現状でもバージョン違いのパッケージは参照可能です。
処理系側で名前衝突を検知して、自動で名前を付け替えています。
命名規則を仕様として露出してしまうと処理系側の自由度が減るのであまりうれしくないかもしれません。

ryuz, 2023-03-13:
> 現状でもバージョン違いのパッケージは参照可能です。
> 処理系側で名前衝突を検知して、自動で名前を付け替えています。

そのような機能があったのですね。気が付きませんでした。
それであればいろいろ余計なことを書いてしまった気がします。

> そもそもprefixの付与は不要なような気もします。

承知しました。将来変わる可能性もあるということですね。
現状、シミュレーション時に SV から、Veryl から変換した SV を飛び出しているので、SV からどう見えるのかを正しく理解しておきたいと思いました。
私も、衝突時以外名前が変わらないルールでも良いように思いました。

> そもそも生成されるファイルリストで参照すべきなので、あまりファイル名に依存すべきではないと思います。

承知いたしました。現状、シミュレーションや合成などを行うスクリプトの中から veryl build  を呼んでおりますので、その後  .f ファイルを取り込めばよい話ではあるかと思っています。
(ただ、パス名の変換など多少面倒だったので、横着がしたかったという理由です)

> パッチバージョン変更が破壊的変更になってしまうなどデメリットの方が大きそうな気がします。
> 具体的なメリットはどのあたりでしょうか？

Xilinx の IP コアジェネレータが バージョン番号入りのファイルをよく吐き出すので少し毒されていましたが、言われてみるとデメリットが多い気がしますね。
あえてメリットを考えるなら、パッケージマネージャが使えない環境化にSV化したファイルのみを流通させる場合で、呼ぶ側の素のSVと、Veryl由来のSVでバージョン整合を保証したい場合ぐらいでしょうか？
既に名前衝突時の対策があるとのことなので、不要な気がしております。

dalance, 2023-03-14:
Rustのように（FFIなど特殊用途を除けば）単体で完結している言語と異なり
VerylはSystemVerilogとの相互運用を前提としています。

なのでフローも既存のSystemVerilogプロジェクトに組み込むことになると思っていて
あまり特定のフローを押し付けない方がいいように思っています。
といっても標準的なフローは想定した方がいいかもしれないので、
そのあたりは実際に使いながら考えていくことになると思います。

ryuz, 2023-03-14:
回答ありがとうございます。状況よくわかりました。
製作者の意図と違う使い方をしているのではないかと不安になっていたのですが、引き続き試行錯誤しながら活用の仕方を模索させて頂きたいと思います。
ASIC開発ではないのであまり参考にはならないかもしれませんが、少し使った限りFPGA用途でも生産性を高めてくれそうに感じております。
引き続きよろしくお願いいたします。

Closed 2024-01-05.

Thread 176 (2023-03-12):

[質問] キャストについてなど

ryuz, 2023-03-12:
Veryl 活用させて頂いております。 質問ばかりで恐縮なのですが。

### キャストについて

型のキャストについて

```
assign a = b as logic<12>;
assign c = d as u32;
```

などはできないのでしょうか？

localparam などで type を作れば問題ないのですが、int  にはキャストできたりするようなのでポリシーを知れると嬉しいです。

### 左辺での連接演算子

```
assign a = {b, c};
```

はできるようですが

```
assign {a, b} = c;
```

は、できないようですが、意図的に禁止されているものでしょうか？

dalance, 2023-03-13:
> 型のキャストについて

少なくとも `u32` はできるべきですね。
`logic` もできますが、 `logic<12>` は SystemVerilog の仕様上不可能です。

> int にはキャストできたりするようなのでポリシーを知れると嬉しいです。

intというのは組み込み型としては存在しないので、外部のユーザ定義型扱いで通っていると思います。

> 意図的に禁止されているものでしょうか？

意図的ではありませんでしたが、追加するとなると構文上の負荷は高そうです。
要検討かと思います。

ryuz, 2023-03-13:
ご回答ありがとうございます。

> logic もできますが、 logic<12> は SystemVerilog の仕様上不可能です。

承知いたしました(なんとなく想像はできます)。

Verilator の 幅チェックが割とうるさく、ビット幅変換によく bit 幅だけ指定したキャストを使っていて、使いたくなった次第です。
(特に bit 幅を増やす方向がきちんと書くと少し面倒ですので)。

回避手段はあるので、特に問題はありません。
理由が知れてすっきりしました、ありがとうございます。

taichi-ishitani, 2023-03-13:
```systemverilog
a = 4'(b);
```

みたいな、幅キャストは対応してましたっけ？

taichi-ishitani, 2023-03-14:
幅キャストが実装されれば、代入幅不一致問題は解決出来そうですね。

> a = b as 4;
> a = b as <4>;

どちらでもよいと思うのですが、後者ですと多次元配列へのキャストもできそうに見えてしまうのが、少々難点ではあります（大した問題にはならないと思いますが）。

dalance, 2023-03-14:
> どちらでもよいと思うのですが、後者ですと多次元配列へのキャストもできそうに見えてしまうのが、少々難点ではあります（大した問題にはならないと思いますが）。

前者だとなんのキャストかよくわからない気がしたので後者かなと思いましたが、多次元指定できてしまうのは確かにそうですね。

dalance, 2023-03-14:
というかSystemVerilogのキャストが普通の意味の型キャストではなくて、もっといろいろな変換ができてしまう感じなのですよね。
ちょっと全体的に整合性が取れるよう考え直した方がいいかもしれません。

taichi-ishitani, 2023-03-14:
> 多次元配列へのキャスト

SystemVerilog 的には、packed であれば型が何であれ代入は可能なので、

```
a = b as <2>;
c = d as <2, 3>;
e = f as foo_struct;
g = h as foo_struct <2, 3>
```

のようなコードを、

```systemverilog
a = (2)'(b);
c = (2*3)'(d);
e = foo_struct'(f);
g = ($bits(foo_struct)*2*3)'(h);
```

の様に変換するのはありかもですね。

dalance, 2024-04-16:
組み込み型へのキャストについては#499 にあるのでこちらはクローズします。

Closed 2024-04-16.

Thread 177 (2023-03-13):

[質問] インスタンス生成時の出力ポートを未接続にする方法

ryuz, 2023-03-13:
いつもお世話になっております。
inst にてモジュールをインスタンス化するとき、使わない output ポートを未接続にする方法はありますでしょうか？

dalance, 2023-03-13:
今のところありません。
追加するとすると単に`:`の右辺に空白を許可する感じでしょうか。

```
inst u: ModuleA (
  a: ,
);
```

ryuz, 2023-03-13:
ご回答ありがとうございます。
無いことを明示するために例えば _ を指定するのもありかと思いました。
実装頂けるのであれば、特に記法にこだわりはないですので、言語設計上スマートな方法をご検討いただければと思います。

```
inst u: ModuleA (
  a: _,
);
```

dalance, 2023-03-15:
これは `_` の方が明示的で良さそうですね。

Thread 186 (2023-03-14):

Auto-documentation

saturn77, 2023-03-14:
This is a language feature request, not an issue.

Would it be possible to documentation to automatically create an md-book something like
as below -- using the '//!' escape clause as shown below?

The TerosHDL available in VSCode does something similar, I use it to automatically create documentation embedded in the SystemVerilog Code.

For example, all variables get at Table listing, and port list, and processes, and state machines, etc.

```
 //!  Variables
    var r_data0: logic<ParamA>;     //! r_data0 is for the button
    var r_data1: logic<ParamA>;     //! r_data1 is for debounced version of button
```

dalance, 2023-03-20:
Looks good.
I'll implement it at #195.

The current implementation is like below:

```
/// Test module for doc comment
///
/// * list item0
/// * list item1
module Module36 #(
    /// Data width
    parameter  ParamA: u32 = 1,
    localparam ParamB: u32 = 1,
) (
    i_clk  : input  logic        , /// Clock
    i_rst_n: input  logic        , /// Reset
    i_data : input  logic<ParamA>, /// Data input
    o_data : output logic<ParamA>, /// Data output
) {}

/// Test interface for doc comment
///
/// * list item0
/// * list item1
interface Interface36 #(
    parameter  ParamA: u32 = 1, /// Data width
    localparam ParamB: u32 = 1,
) {}

/// Test package for doc comment
///
/// * list item0
/// * list item1
package Package36 {}
```

The rendered HTML is

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

saturn77, 2023-03-20:
This will add a great feature to the language, documentation is so
important.

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

Closed 2023-03-20.

Thread 323 (2023-07-28):

Feature Request: Rust-like enum-variant types

nblei, 2023-07-28:
Currently veryl's enums map directly to SV enums.

However, Rust's enums are far more powerful and would map closer to SV's  tagged unions.

However, tagged unions are basically never supported in synthesis, and many tools don't even support them in simulation, so they should be avoided.

A workaround for the tagged union problem in synthesizable SV is to use packed unions and packed struct --- e.g.
```
enum logic [1:0] {
   add = 2'b00, neg = 2'b01, br = 2'b10
} inst_e;
struct packed {
    logic [7:0] op1, logic [7:0] op2
} AddInst;
// etc for NegInst, BrInst
packed union {
  AddInst add, NegInst neg, BrInst br
} InstU;
packed struct {
   inst_e inst_type;
   InstU inst_data;
}
```

But this is a horrible workaround: for a single variant data type, we need to define an enum, _n_ packed structs (one for each variant), a packed union encompassing the packed structs, and then a final packed struct encompassing the enum and the packed union.  Further, a major goal of a variant type is to enforce type safety, and that cannot be done in SystemVerilog --- the RTL designer must check the enum value at all times.

Veryl has the capability to solve this issue and do it in a way that is very natural for rust programmers.  I think this would be a very useful addition to veryl.

BTW, thanks for all the great work you've done between this, the SV parser, etc.

Thread 324 (2023-07-28):

[Bug] Packages are mistranslated to systemverilog

nblei, 2023-07-28:
Veryl's build prefixes the project name to each SV package name.

Thus, veryl package `a` in project `p` becomes `package p_a` in SV.

However, veryl does not translate the name of the package when it is used in other SV modules.

A simple example:
```
#!/usr/bin/bash
veryl new pkgbug
cd pkgbug
mkdir src
mkdir pkg
echo "package my_pkg {localparam I: u32 = 12;}" >pkg/my_pkg.vl
echo "module my_mod {var _k: u32 = my_pkg::I; }" >src/my_mod.vl
veryl build
 ```

This creates: `my_pkg.sv`
```
package pkgbug_my_pkg;
    localparam int unsigned I = 12;
endpackage
```
and `my_mod.sv`
```
module pkgbug_my_mod;
    int unsigned _k;
    assign _k = my_pkg::I;
endmodule
```

dalance, 2023-07-31:
In this case, I think the following output is expected.

```
module pkgbug_my_mod;
    int unsigned _k;
    assign _k = pkgbug_my_pkg::I;
endmodule
```

But the current syntax may be ambiguous.
If `my_pkg` refers an external SystemVerilog package, the prefix is not required.
So explicit SystemVerilog namespace syntax may be required like below.

```
module my_mod {
  var _k: u32 = my_pkg::I;
  var _i: u32 = $sv::my_pkg::I;
}
```

```
module pkgbug_my_mod;
    int unsigned _k;
    assign _k = pkgbug_my_pkg::I;
    int unsigned _i;
    assign _i = my_pkg::I;
endmodule
```

dalance, 2023-07-31:
I fixed this issue through #329.
Could you try it?

nblei, 2023-07-31:
Working for my use case. Thanks, Dalance.

Closed 2023-07-31.

Thread 330 (2023-07-31):

[Bug] Cannot access interface members through modports.

nblei, 2023-07-31:
```veryl,playground
interface my_if {
    var a: logic;

    modport reader {
        a: input,
    }

    modport writer {
        a: output,
    }
}

module my_mod(
    i : modport my_if::reader,
    ii : modport my_if::writer,
    o : output logic
)
{
    assign ii.a = 1'b1;
    assign o = i.a;
}
```

`my_mod` has two errors:
```
Error:   × veryl check failed

Error: unknown_member (link)

  × "ii" doesn't have member "a"
    ╭─[/home/nathan/project/if_ex/my_if.vl:18:1]
 18 │ {
 19 │     assign ii.a = 1'b1;
    ·            ─┬
    ·             ╰── Error location
 20 │     assign o = i.a;
    ╰────
  help:
Error: unknown_member (link)

  × "i" doesn't have member "a"
    ╭─[/home/nathan/project/if_ex/my_if.vl:19:1]
 19 │     assign ii.a = 1'b1;
 20 │     assign o = i.a;
    ·                ┬
    ·                ╰── Error location
 21 │ }
    ╰────
  help:
  ```

Conversely, if we take out the member accesses:

```veryl,playground
interface my_if {
    var a: logic;

    modport reader {
        a: input,
    }

    modport writer {
        a: output,
    }
}

module my_mod(
    i : modport my_if::reader,
    ii : modport my_if::writer,
    o : output logic
)
{
    assign ii = 1'b1;
    assign o = i;
}
```

Veryl finds no errors and emits the following SV:
```
interface if_ex_my_if;
    logic a;

    modport reader (
        input a
    );

    modport writer (
        output a
    );
endinterface

module if_ex_my_mod (
    if_ex_my_if.reader i ,
    if_ex_my_if.writer ii,
    output logic         o
);
    assign ii = 1'b1;
    assign o  = i;
endmodule
```

nblei, 2023-07-31:
One other strange behavior:

```
interface my_if {
    var a: logic;

    modport reader {
        a: input,
    }

    modport writer {
        a: output,
    }
}

module my_mod(
    i : modport my_if::reader,
    ii : modport my_if::writer,
    o : output logic
)
{
    assign ii.i = 1'b1;
    assign o = i;
}
```
transpiles into

```
interface if_ex_my_if;
    logic a;

    modport reader (
        input a
    );

    modport writer (
        output a
    );
endinterface

module if_ex_my_mod (
    if_ex_my_if.reader i ,
    if_ex_my_if.writer ii,
    output logic         o
);
    assign ii.i = 1'b1;
    assign o    = i;
endmodule
```
when expected behavior is an `unknown_member` error.

Closed 2023-08-01.

Thread 334 (2023-08-01):

[Bug] Enum variants cannot be used inside a function --- members not found

nblei, 2023-08-01:
```
module A {
    enum EnumA: logic<2> {
        member_a,
        member_b,
        member_c = 3,
    }

    var a: EnumA;

    assign a = EnumA::member_a;
    function is_a(e: input EnumA) -> logic {
        return e == EnumA::member_a;
    }
}
```
This results in a Semantic Error: "EnumA" doesn't have member "member_a"

```
Error:   × veryl check failed

Error: unknown_member (link)

  × "EnumA" doesn't have member "member_a"
    ╭─[/home/nathan/project/enum_check/a.vl:11:1]
 11 │     function is_a(e: input EnumA) -> logic {
 12 │         return e == EnumA::member_a;
    ·                     ──┬──
    ·                       ╰── Error location
 13 │     }
    ╰────
```

Closed 2023-08-09.

Thread 378 (2023-09-01):

Type checking analysis pass

nblei, 2023-09-01:
Dalance,

I would like to add a type checking pass which has a primary goal of evaluating the size (in bits) and packedness of each datatype.

The way I see this working is that a graph whose nodes are types, and whose edges represent dependencies.

For example,

```veryl
type k = logic<2>;
struct m {
  a: k,
}
```
Would contain three nodes and two edges:
(logic<2>) -> (k) -> (m).

In addition to allowing us to identify the packed size of `m`, this also allows us to do dependency analysis.  The type-graph should be a DAG.  If a cycle exists, we have a problem.  However, currently

```veryl
package p {
    struct m {
        a: logic,
        n: n,
    }
    struct n {
        b: logic,
        m: m,
    }
}
```

passes on this mutually recurssive, but not inductive package `p`.

Any thoughts on this approach?

nblei, 2023-09-02:
Another note:

Currently, veryl allows declaration of variably *lengthed* logic vectors:

```
module foo
{
    var a: u32;
    var _b: logic<a>;
}
```
produces
```
module veryl_testcase_foo;
    int unsigned         a ;
    logic        [a-1:0] _b;
endmodule
```

I think this is likely because the `struct Type`'s `width` and `array` fields:

```
pub struct Type {
    pub modifier: Vec<TypeModifier>,
    pub kind: TypeKind,
    pub width: Vec<syntax_tree::Expression>,
    pub array: Vec<syntax_tree::Expression>,
}
```
These are arbitrary expressions, and no checking is done to determine if they are evaluable, either directly into an explicit constant natural number, or parametrically.

dalance, 2023-09-04:
A primitive type evaluation is implemented at https://github.com/dalance/veryl/blob/master/crates/analyzer/src/handlers/check_enum.rs.
It evaluates the size of enum members and checks whether the size is over the enum size.

I implemented it as a checker, but I think it should be more generic framework.
For example,

* Create SymbolTable ( already implemented )
* Create Type DAG from the SymbolTable
* Evaluate size of each entry of the DAG
* Check relationship between each entry like enum, union

About cycle of DAG, I think it should be reported as error at creating DAG phase.
Variably lengthed logic may be checked at evaluating phase too.

The current implementation of evaluator https://github.com/dalance/veryl/blob/master/crates/analyzer/src/evaluator.rs can handle fixed value only.
It is required to extend to support parameterized value.

nblei, 2023-09-04:
How is the symbol table currently used?  greping the analyzer crate shows that `symbol_table::get_all()` is only used in `analyzer::check_symbol_table`, and `symbol_table::get` is only used in the `symbol_table` crate's test module.

It looks like to use the symbol table in a separate pass, I would need to implement `VerylGrammarTrait` functions for all syntactical structures which can push to `SymbolPath` and `Namespace`.  However, this is something very easy to mistake.

Perhaps a `trait VerylGrammarContextTrait : VerylGrammarTrat` is called for.  This subtrait would implement default functions which push/pop symbol path / namespace as required.

Does this make sense?

dalance, 2023-09-05:
The symbol table is used at some analyzer handlers and language server.
For example,

https://github.com/dalance/veryl/blob/9571195d062834f9c0b365e06344660c45c31191/crates/analyzer/src/handlers/check_function.rs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
https://github.com/dalance/veryl/blob/9571195d062834f9c0b365e06344660c45c31191/crates/analyzer/src/handlers/check_instance.rs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

> It looks like to use the symbol table in a separate pass, I would need to implement VerylGrammarTrait functions for all syntactical structures which can push to SymbolPath and Namespace. However, this is something very easy to mistake.

To avoid re-implementation of pushing/poping SymbolPath and Namespace, I implemented `namespace_table`.
https://github.com/dalance/veryl/blob/master/crates/analyzer/src/namespace_table.rs

It holds pairs of `TokenId`, and `Namespace` which is belonged by the token.
It is created at creating symbol table, and namespace can be resolved without push/pop after the creation.
`symbol_table::resolve` internally calls the namespace_table like below:

https://github.com/dalance/veryl/blob/9571195d062834f9c0b365e06344660c45c31191/crates/analyzer/src/symbol_table.rs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

nblei, 2023-09-13:
Hey @dalance , any changes you'd like me to make to #383?

dalance, 2025-01-31:
I'll close this issue because DAG implementation was already completed.
Evaluation of type width will be done through #1017 .

Closed 2025-01-31.

Thread 436 (2023-12-10):

Syntax Error at LAngle and RAngle

puppuccino, 2023-12-10:
Hi, I am facing a problem related to angle brackets. The following code causes a syntax error at the right angle bracket. The version is 0.5.6. This issue is comfirmed both in my local environment and the online playground.
Thanks.

```
module compare (
    x  : input  logic<10>,
    y  : input  logic<10>,
    out: output logic    ,
) {
    assign out = (x > y);
}
```

puppuccino, 2023-12-10:
sorry I didn't check the document well. compare operator is not > but >:

Closed 2023-12-10.

Thread 460 (2024-01-04):

Change file extension

dalance, 2024-01-04:
The current file extension is `.vl`, but I found it used as verilog's extension through GitHub file search.
I think it may be  better that the extension is changed before many Veryl files are added.

The candidates are

* .vl (7.2k files found)
* .vrl (584 files found)
* .vryl (no file)
* .veryl (no file)

dalance, 2024-01-05:
At the moment, I prefer `.veryl`.
It is bit long, but there are the same length extensions like `.scala`, `.class`, and so on.
I think the other short-hands may be confusable about which charactors are omitted.

Closed 2024-01-12.

Thread 536 (2024-03-08):

Syntax high lighting on GitHub

taichi-ishitani, 2024-03-08:
[linguist](https://github.com/github-linguist/linguist) is a library used for syntax highlighting on GitHub.
You can enable syntax highlighting on GitHub by adding Veryl support to the linguist library.

dalance, 2024-03-08:
The criteria of adding a language is described at https://github.com/github-linguist/linguist/issues/5756.
The current criteria is "at least 2000 files per extension".

Now the result is 88. So I'll send the request after reaching 2000 files.

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

Thread 539 (2024-03-09):

[Feature] untyped enum type

taichi-ishitani, 2024-03-09:
Currently, we need to specify type of enum type like following.

```systemverilog
enum FOO: logic<2> {
  BAR,
  BAZ
}
```

SystemVerilog and other langurages support untyped enum type so I'd like Veryl to support this feature.

In case of SytemVerilog, default type of enum type is `int`. In many cases, `int` has too much bits and 2 states type is not suitable for RTL use.
Therefore, I'd like Veryl to calucate enough bit width and use a logic vector.

Veryl code:

```systemverilog
enum FOO {
  BAR,
  BAZ
}

enum HOGE {
  FUGA = 6,
  PIPO
}
```

Generated SV code

```systemverilog
typedef enum logic [0:0] {
  FOO_BAR,
  FOO_BAZ
} FOO;

typedef enum logic [2:0] {
  HOGE_FUGA = 6,
  HOGE_PIYO
} HOGE;
```

Automatic width calculation can prevent mistake that forgetting updating type of enum when adding/deleting enum variants.

Closed 2024-08-22.

Thread 541 (2024-03-09):

Hierarchical identifiers for nested structures do not work properly

nblei, 2024-03-09:
With veryl 0.7.2

```veryl
module foo {
    struct bar {
        baz: logic,
    }

    struct baz {
        a: bar,
    }

    var g: baz;

    assign g.a     = 1'b0;
    assign g.a.baz = 1'b0;

}
````

```bash
$ veryl check

Error:   × veryl check failed

Error: unknown_member (link)

  × "a" doesn't have member "baz"
    ╭─[temp/heirarchy_error/src/foo.veryl:12:1]
 12 │     assign g.a     = 1'b0;
 13 │     assign g.a.baz = 1'b0;
    ·            ┬
    ·            ╰── Error location
 14 │
    ╰────
  help:
```

Closed 2024-03-11.

Thread 550 (2024-03-12):

Minimal support of unit test

dalance, 2024-03-12:
Unit test feature has many consideration points from simulation only description like delay and clocking to testing framework like UVM.
I'll add minimal support of unit test because these consideration takes many time.

This proposal is syntax to include tests which are written by other languages.
I think SystemVerilog and [cocotb](https://www.cocotb.org) are appropriate candidates.
Especially cocotb may be suitable with unit test because it doesn't required testbench module.

```systemverilog
module ModuleA {
}

// Use SystemVerilog Test
#[testbench]
include_sv!("tb.sv");

#[test]
include_sv!("test1.sv");
#[test]
include_sv!("test2.sv");

// Use cocotb Test
//   cocotb doesn't require testbench module normally
#[test]
include_cocotb!("test1.py", ModuleA);
#[test]
include_cocotb!("test2.py", ModuleA);
```

`veryl test` command like below can be implemented if these syntax is added.

```shell
$ veryl test --sim verilator
$ veryl test --sim vcs
```

In the future, Veryl native test will be written like below:

```systemverilog
#[testbench]
module tb {
}

#[test]
module test1 {
}
```

Related: #209 #164

saturn77, 2024-03-23:
I would also like to add the possible concept of a *native Rust component as a DPI function* to be called into the testbench.

Veryl compiler would process the .veryl file as normal, but also separate out any #Pragma__Rust DPI component into a compiled .so library so it could be linked with a verilator simulation.

An example testbench is shown below.

Note that this testbench is in the same Veryl module as the design. Also note the example uses psuedo-code for brevity. Finally the [#derive(dual_use)] macro would allow the struct to be translated to SystemVerilog but also used for Rust .so compile.

```systemverilog
#[testbench]
// A standard type way
import "DPI-C" function u32 triple_add (input u32 a, input u32 b, input u32 c);
// OR another way
import "DPI-Functions" // since the DPI function is attached to this module; Veryl would know to include it.

module tb {
// instantiate DUT as dut
// clock generator code ...
// reset generator code ...
#[derive(dual_use, rust_component)]
struct Dut {
a : u32,
b : u32,
c : u32,
result : u32,
}

#Pragma__Rust
impl Dut {
  pub fn triple_add (&mut self)  {
      self.result = (self.a + self.b + self.c) >> 5
  }
}
#Pragma_End

var dut : Dut;

// main loop
while index < NUM {
    dut.a = some_value;
    dut.b = some_value_b;
    dut.c = some_value_c;

    delay_some_clock_cycles;

    assert(dut.result == triple_add(some_value, some_value_b, some_value_c, "adder failure!");

}
```

dalance, 2024-03-25:
Looks good!
If not only generating expected value but also whole testbench can be written by Rust, it seems to be better.
Then verification framework like UVM can be constructed by Rust.

Syntax to embed other languages seems to be required too.
Rust macro style will be like below?

```rust
inline!("rust") {
    // Rust code
}

inline!("sv") {
    // SystemVerilog code
}

inline!("cocotb") {
    // Python code
}

include!("rust", "test.rs");
include!("sv", "test.sv");
include!("cocotb", "test.py");
```

Additionally the `inline!("sv")` can be used in the design for rare case description which can't be represented by Veryl like inline assembly.

saturn77, 2024-03-25:
The inline! macro does look like a very good approach, and is also flexible with placing code within the original source file and also in external files. Very effective feature to handle multiple languages in one file.

The only issue that I would see is that if you inline python, the target output should be a separate file (versus the SystemVerilog that is transpiled from the Veryl code)

Perhaps some code syntax needs to be incorporated that tells Veryl where to place the output of inline! macro - and how to import it into the final SystemVerilog output. An idea is shown below.

```systemverilog
inline!("rust") {
   #[derive(dpi_import)]  /// generate a .so shared object, but also import into final SystemVerilog target
   /// some function here
}

```

However, if one wanted to manually create a large amount of DPI Rust functions in a separate file, this would not be necessary if the user wanted to manually import into a SystemVerilog file.

dalance, 2024-03-26:
Sure.
The `inline` keyword may not be suitable because it means a way for integration.
Is it better that both language and integration way are specified like below?

```rust
embed!("sv", "inline") {
}

embed!("python", "cocotb") {
}

embed!("rust", "dpi_import") {
}
```

saturn77, 2024-03-26:
The embed! macro seems like a very good approach.

The syntax appears to be of the form "embed! (arg1=lang, arg2=file_target)"

This approach would allow for future expansion if needed, like for example

 "embed! (arg1=lang, arg2=file_target, arg3=sim_target)"

So extending this to assertions:

```rust
embed!("sv", "inline", "assert") {
property req_gnt;
    @(posedge clk) req |=> gnt;
endproperty

assert_req_gnt: assert property (req_gnt) else $error("req not followed by gnt.");
}
```
The assert argument would be used if simulating with verilator, but something like arg3 could default to "none".

dalance, 2024-04-01:
First of all, I'll try to implement the following two SystemVerilog tests.
The second is cocotb integration.

```rust
// external SystemVerilog test
#[testbench]
include!("tb.sv", "inline");

#[test]
include!("test1.sv", "inline");

// embedded SystemVerilog test
#[testbench]
embed!("sv", "inline") {
    // SystemVerilog code
}

#[test]
embed!("sv", "inline") {
    // SystemVerilog code
}

// external cocotb test
#[test]
include!("test1.py", "cocotb");

// embedded cocotb test
#[test]
embed!("python", "cocotb") {
    // Python code
}
```

dalance, 2024-04-07:
I explored the syntax implementation of `embed`.
So I found the code blocks of foreign language should be marked more clearly.
This is because editors supporting embedded language search the embedded code block by a simple regex.

For example, the following code block can be identified by `{sv{` and `}sv}`, and these pattern probably don't appear in SystemVerilog code.

```rust
embed("inline") {sv{
    // SystemVerilog code
}sv}
```

saturn77, 2024-04-07:
That marking of the code blocks as you posted above appears very reasonable; such that someone adding this code in the main veryl file has a short and efficient syntax to mark code as sv.

Another idea is to use double under syntax as shown below. Perhaps the end sv symbol could be removed (as shown), and the double under syntax could be made as as "private attribute" in Veryl similar to Python.

```systemverilog
embed("inline") { __sv__ {
    // SystemVerilog code
}}
```

dalance, 2024-04-08:
A simple end pattern causes mistake of syntax highlighting engine because the engine usually uses simple regex pattern matching.

```
embed("inline") { __sv__ {
    assign a = {1{1'b1}};  // This `}}` will be identified as the end of code block
}}
```

So there is trade-off like "`}sv}` is ugly, but difficult to make mistake" and "`}}` is clean, but easy to make mistake".
We need to explore an appropriate compromise.

````rust
// Markdown code block style
embed("inline") ```sv
    // SystemVerilog code
```

// C# Raw string literal style
embed("inline") sv"""
    // SystemVerilog code
"""

````

saturn77, 2024-04-08:
The markdown style syntax seems a little more clear.

But I wanted to see what this would look like, and generated a quick example below where is an embedded rust snippet, that is called as DPI function in the embedded SV snippet.

The flow that I use most often is SystemVerilog --> Cocotb --> Verilator; however, after using this flow
many times, I still prefer to have a "basic" testbench module that is pure SV.  The example below takes
a look at how this would work, where all of this would be in the #[test] portion of the Veryl main module.

```rust
#[test]
//----------------------------
// Embed SV test case
//----------------------------
embed("inline") rust"""
// This is a DPI function, meant to be called
// by systemverilog testbench for immediate
// verification of the adder result. The
// no_mangle is used for C abi.

#[no_mangle]
pub fn adder_check(arg_a : i32, arg_b : i32) -> i32 {
    arg_a + arg_b
}
/// Note that the above function could be much more
/// complicated; this is where the value of a DPI
/// function comes in, e.g. something like a Taylor
/// series expansion or matrix multiplier i.e.
#[no_mangle]
pub fn taylor_cosine_check (x : i32) -> i32 {
1 - 0.5*(x**2) + (1/24)*(x**4) + . . . .
}
"""
```
```rust
embed("inline") sv"""
```
```systemverilog

module adder_tb;
/// Basic testbench for the adder in the alu

// import the C-ABI Rust DPI function declared earlier
import "DPI" function int adder_check(input int i_adder_arg_a, input int i_adder_arg_b);

logic i_clock, i_reset
int i_adder_arg_a, i_adder_arg_b;
int o_adder_result;
veryl_adder uAdd (.*);   // instantiate the DUT, transpiled from Veryl

initial begin
    i_clock <= 0;
end

always begin
    #10 i_clock <= !i_clock;
end

initial begin
i_reset <= 0;
#10 i_reset <= 1'b0;
#40 i_reset <= 1'b1;
#100 i_reset <= 1'b0;
#100;
i_adder_arg_a = 10;
i_adder_arg_b = 35;
#2;
$assert (dut.o_adder_result == adder_check(adder_arg_a, adder_arg_b));

$finish(2);
end
endmodule
```

```rust
"""
```

dalance, 2024-04-08:
The current idea is like below:

```rust

// "dpi_rust" means that the code block will be compiled as Rust to a shared object,
// and the object will be loaded as a DPI module on RTL simulator.
embed("dpi_rust") rust"""
#[no_mangle]
pub fn adder_check(arg_a : i32, arg_b : i32) -> i32 {
    arg_a + arg_b
}
"""

// `#[test]` means that the annotated block will be enabled at test only.
// If there are some annotated blocks, they are executed as individual tests.
// "inline" means that the code block will be expanded to the transpiled code as is.
#[test(test_name)]
embed("inline") sv"""
module test;
    import "DPI" function int adder_check(input int i_adder_arg_a, input int i_adder_arg_b);

    logic i_clock, i_reset
    int i_adder_arg_a, i_adder_arg_b;
    int o_adder_result;
    veryl_adder uAdd (.*);

    initial begin
        i_clock <= 0;
    end

    always begin
        #10 i_clock <= !i_clock;
    end

    initial begin
        i_reset <= 0;
        #10 i_reset <= 1'b0;
        #40 i_reset <= 1'b1;
        #100 i_reset <= 1'b0;
        #100;
        i_adder_arg_a = 10;
        i_adder_arg_b = 35;
        #2;
        $assert (dut.o_adder_result == adder_check(adder_arg_a, adder_arg_b));
        $finish(2);
    end
endmodule
"""
```

saturn77, 2024-04-08:
The combined #[test] and embed("inline") markers definitely convey the functionality and the overall syntax is clear, looks good.

dalance, 2024-04-09:
I've rethought about code block syntax.
`"""` or ` ``` ` can't check match of open and close, it causes syntax ambiguous.
So `{{{` and `}}}` seems to be better.
If there is `}}}` in code block, `} } }` can be used instead of it to avoid syntax highlight error.

```
#[test(test_name)]
embed ("inline") sv{{{
// SystemVerilog code
assign a = {1{1{1'b1}}}; // highlight error, but not syntax error
assign a = {1{1{1'b1} } }; // no error on both highlight and syntax
}}}
```

dalance, 2024-04-10:
One more minor update.
The way of embedding is not an arbitrary string, but one of the pre-defined candidates.
So `embed(inline)` may be better than `embed("inline")`.

```
#[test(test_name)]
embed (inline) sv{{{
// SystemVerilog code
}}}
```

dalance, 2024-04-12:
I'll close this issue after merging #648, and the remaining issues are moved to #658 and #659.

saturn77, 2024-04-12:
That is excellent work, look forward to testing this feature with verilator.

dalance, 2024-04-13:
I've merged #648.
Now Verilator, VCS and Vivado Simulator are supported.
I'll release v0.9.0 after document update.

Closed 2024-04-13.

Thread 564 (2024-03-15):

[Feature] Integer type restricted to positive value

taichi-ishitani, 2024-03-15:
There are many cases that parameter values need to be restricted to positive value.
For example, bit width, FIFO depth.

I think integer type restricted to positive value is useful for these cases so I'd like veryl to suuprt such type.
SystemVerilog does not have such type so following code needs to be inserted to generated SV code.

```systemverilog
generate
  if (W < 0) begin : g_veryl_check_W
    $error("parameter W should be positive value");
  end
endgenerate
```

In addition, Pkl has a feature to add constraints to the given value.
I'd like Veryl to support such feature.
https://pkl-lang.org/main/current/language-reference/index.html#type-constraints

nblei, 2024-03-15:
I like this idea, and I think it fits more broadly into a discussion on what metadesign support should Veryl provide.

Thread 568 (2024-03-16):

if expression does not allow less than (or greater than)

nblei, 2024-03-16:
For example:

```veryl
assign a   = if c < d   { b } else { c };
assign aa = if c <= d { b } else { c };
```

Second line is fine, but first line produces a ParserError::SyntaxError -- Unexpected token: LAngle.

Work around for now is to use `if c<= d && c != d`.

Similar issue exists with greater than (`>`).

taichi-ishitani, 2024-03-16:
less than operator is >:

dalance, 2024-03-16:
This seems to be common error because the operators are differ from other languages. So I think a special error message which suggests  <: and >: is required.

dalance, 2024-03-21:
I'll change the error message like below:

```
Error: ParserError::SyntaxError

  × Unexpected token: '<', do you meant "less than operator '<:'" ?
    ╭─[/home/hatta/work/repos/veryl/testcases/veryl/03_operator.veryl:44:1]
 44 │     // binary compare
 45 │     assign a          = 1 < 1;
    ·                           ┬
    ·                           ╰── Error location
 46 │     assign aa         = 1 <= 1;
    ╰────
  help:
```

nblei, 2024-03-21:
Awesome.

Go with "do you mean", though.

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

Closed 2024-03-21.

Thread 569 (2024-03-18):

[Feature] Omit specifying clock and reset signals

taichi-ishitani, 2024-03-18:
Most modules have one pair of clock and reset only so we can omit spacyfying clock and reset singals on `always_ff` blocks.

```systemverilog
always_ff {
  if_reset {
    q = 0;
  } else {
    q = i_d;
  }
}
```

To realize this feature, special types named `clock` and `reset` would be instroduced. These types are to tell Veryl which signals are clock and reset signals.
If a module have only one pair of signals of which types are `clock` and `reset` then Veryl can insert that clock and reset signals to `always_ff` blocks automatically.

```systemverilog
module foo (
  i_clk:   input  clock,
  i_rst_n: input  reset,
  i_d:     input  logic,
  o_q:     output logic
) {
  var q: logic;

  assign o_q = q;
  always_ff { // Veryl can convert this code to 'always_ff (i_clk, i_rst_n)'
    if_reset {
      q = 0;
    } else {
      q = i_d;
    }
  }
}
```

```systemverilog
module foo (
  i_clk_a:   input  clock,
  i_rst_a_n: input  reset,
  i_clk_b:   input  clock,
  i_rst_b_n: input  reset,
  i_d:       input  logic,
  o_q:       output logic
) {
  var q: logic;

  assign o_q = q;
  always_ff { // Veryl doesn't know which clock/reset pairs should be used. This code causes an error.
    if_reset {
      q = 0;
    } else {
      q = i_d;
    }
  }
}
```

```systemverilog
module foo (
  i_clk:   input  clock<4>,
  i_rst_n: input  reset<4>,
  i_d:     input  logic<4>,
  o_q:     output logic<4>
) {
  for i in 0..4 :g {
    let clk:   clock = i_clk[i];
    let rst_n: reset = i_rst_n[i];
    var q:     logic;

    assign o_q[i] = q;
    always_ff { // block 'g' has one clock/reset pair only so Veryl can convert this to 'always_ff (clk, rst_n)'
      if_reset {
        q = 0;
      } else {
        q = i_d[i];
      }
    }
  }

}
```

In addition, I think synthesis tools require that clock and reset signals should be single bit signals.
Therefore, Veryl should check if signals speciled as clock/reset are single bit signals.

saturn77, 2024-03-31:
I think this is a good feature that will make the code more compact.

My suggestion is to allow for naming the actual clock and reset signals in the toml file, such as

```toml
[build]
clock_name = "clock"
reset_name = "reset"
```
and then there are the positive / negative options for clock, and sync/async positive/negative options for reset.

Some people may want the final SystemVerilog code to have "i_reset_n" versus "i_rst_n" for example.

dalance, 2024-04-01:
I prefer this idea, but the forth code block may be bit confusable.
In general programming language including SV, both `i_clk` and `clk` can be visible at the `always_ff`.
Even if the case is not allowed,  almost all cases will be covered.

> My suggestion is to allow for naming the actual clock and reset signals in the toml file, such as

How about #623 ?
Specifing the name directly may be difficult to apply the multi-clock modules.

Closed 2024-05-13.

Thread 570 (2024-03-18):

false positive of reset check

taichi-ishitani, 2024-03-18:
Even though all members of a struct are reset in the `if_reset` statement the linter reports reset statement check error.

How to reproduce:

Run linter for this code.

```systemverilog
// module declaration
module ModuleA(
  i_clk:   input  logic,
  i_rst_n: input  logic,
  o_foo:   output logic,
  o_bar:   output logic
) {
  struct foo_bar {
    foo: logic,
    bar: logic
  }

  var r_foo_bar: foo_bar;

  assign o_foo = r_foo_bar.foo;
  assign o_foo = r_foo_bar.bar;
  always_ff (i_clk, i_rst_n) {
    if_reset {
      r_foo_bar.foo = 0;
      r_foo_bar.bar = 1;
    } else {
      r_foo_bar= ~r_foo_bar;
    }
  }
}
```

Then, linter will report this error.

```
  ⚠️ r_foo_bar is not reset in if_reset statement
    ╭─[:21:1]
 21 │     } else {
 22 │       r_foo_bar= ~r_foo_bar;
    ·       ────┬────
    ·           ╰── Error location
 23 │     }
    ╰────
  help: add reset statement
```

Closed 2024-03-28.

Thread 575 (2024-03-19):

言語デザインドキュメントの改善

dalance, 2024-03-19:
#574 の日本語版

---

# VerylによるRTL設計の漸進的な進化

VerylはSystemVerilogの代替言語として設計されたハードウェア記述言語です。特に既存のVerilog/SystemVerilogコードベースを漸進的に改善することに着目しています。

「漸進的」とは既存のコードベースの一部を徐々にVerylに置き換えていくことが可能であることを意味します。すなわち、VerylはSystemVerilogと高い相互運用性を持ちます。Verylに置き換えられたコードベースは、合成可能性やシミュレーションとの一致が保証され、各種エディタのプラグインを通してリアルタイムの編集支援が提供されます。さらにVerylで記述されたライブラリは統合されたビルドツールを通して容易に依存関係として追加することができます。

以下では、SystemVerilogや既存のHDL代替言語との違いを明らかにするために、Verylが提供するものとしないものについて詳しく見ていきます。

## Verylが提供するもの

### 洗練された構文

Verylの構文はSystemVerilogの構文から合成可能記述を抽出し、Rustなど現代的なプログラミング言語の構文的な成果を取り入れたものです。そのため、SystemVerilogで非推奨であった記述の多くは構文の時点で排除されています。

<table>
<tr>
<th>Veryl</th>
<th>SystemVerilog</th>
</tr>
<tr>
<td>
<pre>

```systemverilog
/// マークダウン形式のドキュメンテーションコメント
/// * リスト1
/// * リスト2
pub module Delay #(
    param WIDTH: u32 = 1, // 末尾カンマ `,` を許容
) (
    i_clk : input logic       ,
    i_rst : input logic       ,
    i_data: input logic<WIDTH>,
    o_data: input logic<WIDTH>,
) {
    // `_` の付いていない未使用変数は警告される
    var _unused_variable: logic;

    always_ff (i_clk, i_rst) {
        // リセットの極性・同期非同期の抽象化構文
        if_reset {
            o_data = '0;
        } else {
            o_data = i_data;
        }
    }
}
```

</pre>
</td>
<td>

```systemverilog
// コメント
//
//
module Delay #(
    parameter int WIDTH = 1
) (
    input              i_clk ,
    input              i_rst ,
    input  [WIDTH-1:0] i_data,
    output [WIDTH-1:0] o_data
);
    logic unused_variable;

    always_ff @ (posedge i_clk or negedge i_rst) begin
        if (!i_rst) begin
            o_data <= '0;
        end else begin
            o_data <= i_data;
        end
    end
endmodule
```

</td>
</tr>
</table>

上記はVerylとSystemVerilogのソースコードを比較したものです。

* `///` で始まるドキュメンテーションコメントを付与することで、Verylコンパイラはドキュメントを自動生成することができます。
* カンマ区切りリストの末尾カンマを許容することで、リストの並び替えを容易にし、バージョン管理システムにおける不要な差分を抑制します。
* 変数が未使用であることを `_` プレフィックスで明示することができ、明示されていない未使用変数はVerylコンパイラに警告されます。
* `if_reset` 構文によりリセット極性と同期・非同期を抽象化し、Verylコンパイラによるコード生成時にそれらを選択することができます。

### リアルタイムフィードバック

Verylコンパイラは各種エディタのプラグインを通して、構文エラーやリントエラーをリアルタイムにフィードバックします。これにより時間のかかるコンパイルや合成プロセスを経ることなく、問題のある記述を即座に修正することができます。
また、自動フォーマットによりコードベース全体に渡って一貫したフォーマットを容易に維持することができます。

### SystemVerilogとの相互運用性

VerylはSystemVerilogとほぼ同じセマンティクスを持ち、Verylコンパイラは可読性の高いSystemVerilogソースコードを出力します。そのため既存のSystemVerilogコードベースの一部を置き換えたり、協調して使用することができます。

## Verylが提供しないもの

### 短いコード記述

多くのHDL代替言語は既存のVerilog/SystemVerilogが短いコードで表現できることを重視していますが、Verylではそのようなアプローチは採用しません。短いコードから多くのVerilog/SystemVerilogが生成されることは、生成後のコードのデバッグや微調整を困難にするためです。代わりにVerylでは冗長なSystemVerilog記述を明示性を失わない範囲で略記できるようにします。

### シミュレーション記述

シミュレーション記述は合成可能なRTL設計とは大きく異なるドメインです。サポートすべきものは単純な遅延記述だけでなく、複雑なアサーションや階層構成を取る巨大な検証フレームワークまで多岐にわたります。そのためVerylではこれらの記述を直接にはサポートせず、SystemVerilogやPythonなど他言語で書かれたテストベンチとの統合により検証をサポートします。

taichi-ishitani, 2024-03-19:
* `=` と `<=` の使い分け
* リセットの指定漏れの検出
* 未宣言信号

とか、SV では気を付けながらコーディングしていた部分を言語レベルでチェックしてくれる、と言うのを強調しても良いのではと思います。

shioyadan, 2024-03-20:
まず前提についてなのですが，「https://veryl-lang.org/」の WEB ページのトップに書く紹介なのか，それともドキュメントのトップに書く紹介なのかで，方向性が違ってくるのかなと思いました．現在は両者で同じ文章が使われているようですが，これらではそれぞれ目的が少し違ってくると思います．

まず WEB のトップの方については，とにかく「Veryl を使うと何がうれしいのか」を読者がさっとわかる事に目的があり，それを短くシンプルにまとめるのが良いのだと思います．たとえば以下の Rust や TypeScript の WEB ページはこれをやっているように思います（たまたまなのかわかりませんが，割と似た構造をしています）．

これらのページでは，まず最初に１文ぐらいのその言語の短い説明があったあとに，特徴や利点を箇条書きに近いスタイルでまとめています．これは，ちょっと興味を持った人が最初にちらっと見たときに，なんとかして次のステップに進んでもらう上で有効だと思います．また，両方とも比較的新しい言語で，新しく使ってもらうために積極的なアピールをしてこようと工夫してきたと思うのですが，他の部分も含めてこれらのページの作りは参考になると思います．

https://www.rust-lang.org/
https://www.typescriptlang.org/ja/

次にドキュメントの最初の概要ですが，こちらは既に最初の興味をもって中身自体をもうちょっと知りたい人や，これから学んでみようと考えた人が読む部分なので，トップページに比べるともう少しゆっくり言語自体の中身や思想，目的を絡めて話しても良さそうに思います．実際，Rust のドキュメント？のイントロも，「どういう人にとってどう嬉しいのか」をじっくり書いておりこのスタイルも参考になりそうです．

あと，これを見ていて思ったのですが，普段どう言う HDL を書いている人達が対象としてありえて，それぞれの人達にとってどう嬉しいのか，を１回考えてみるのは良さそうに思います（あんまりバリエーションはないかもしれませんが）．

https://doc.rust-lang.org/book/ch00-00-introduction.html

あとは，その上で内容についてですが，現在「漸進的な進化」が一番トップに来ていますが，それで良いのかがちょっと気になりました．「漸進的な進化」は柱となるとても重要な要素ではあると思うのですが，より上位の最終的に良くしたい事（理想的にどのような言語であってほしいのか的な）があった上で，それを実現する重要なアプローチなのかな、と言う気がするのですが，どうでしょうか？

dalance, 2024-03-21:
> まず前提についてなのですが，「 https://veryl-lang.org/ 」の WEB ページのトップに書く紹介なのか，それともドキュメントのトップに書く紹介なのかで，すこし方向性が違ってくるのかなと思いました．現在は両者で同じ文章が使われているようですが，これらではそれぞれ目的が少し違ってくると思います．

想定としてはドキュメントのトップですね。あとはこれをもう少しまとめてGitHubのREADMEにするイメージでした。
正直Webページのトップは頭から抜けてました…。現状のあれはドメインを取るついでにでっち上げたくらいのもので、あまり考えられていないです。
RustやTSのページは参考になりそうなのでそのうち何とかしたいですね。

> あとは，その上で内容についてですが，現在「漸進的な進化」が一番トップに来ていますが，それで良いのかがちょっと気になりました．「漸進的な進化」は柱となるとても重要な要素ではあると思うのですが，より上位の最終的に良くしたい事（理想的にどのような言語であってほしいのか的な）があった上で，それを実現する重要なアプローチなのかな、と言う気がするのですが，どうでしょうか？

これはどちらかというと「漸進的」であることが最上位なのではないかと気づいたので今回の文章を作ることにした感じです。
正確に言うとより最上位はSVをなんとかしたいということだと思うので

* （自分が）SVで効率よく開発したい
  * SVの言語自体を改善する -> AccelleraやEDAツールベンダじゃないと無理
  * SVのツールを作る -> svlint/svlsで試みたが行き詰まり
  * 新言語を作って徐々に移行する -> Veryl

という感じですかね。
これがSV自体を変えられる立場であれば、理想的な言語に向かっていくアプローチになると思うのですが、
そうではないとすると実は「徐々に」という部分が最も重要でなのではないかと思います。
（なぜなら「一気に素晴らしい新言語に移行する」というのは理想的には良くても実現不可能なので）

実際これまでに検討してきた言語デザインでもSVとの嚙み合わせの悪さを理由に不採用にしたりしていて
判断基準の最上位がそこにあることを明示した方がいいのではないか、と思った次第です。

shioyadan, 2024-03-21:
> 想定としてはドキュメントのトップですね。あとはこれをもう少しまとめてGitHubのREADMEにするイメージでした。
> 正直Webページのトップは頭から抜けてました…。現状のあれはドメインを取るついでにでっち上げたくらいのもので、あまり考えられていないです。

ドキュメントのトップを想定するにしても，論文の abstract じゃないですけど，先頭になにか端的な特徴とユーザーから見たメリットを，Rust や JavaScript のページみたいにまとめておくのは良いかもしれないと思います．

というのも最近の hacker news でのコメントなどを見ても思ったのですが，こういうのは最初にわかりやすい形でユーザーからみた利点が伝わらないと，「それで何が嬉しいの？」「よくわかんないからまぁいいや」「どうせ XXX みたいなやつがまた出たんだろ」となって，次のステップの「ちょっと書いてみる」に全く進んでくれないんだなと思ったからです．

WEB ページはまた後でなのかもしれませんが，どこかに貼っつけて宣伝するときなどに，なにかすごく短い形でユーザーから見た利点が，どこかにぱっとまとまっているのはとても良いと思います．

> これはどちらかというと「漸進的」であることが最上位なのではないかと気づいたので今回の文章を作ることにした感じです。

このあたりの説明していただいた理由や動機については大変納得しました．なにかこう言う理由や動機も，ドキュメントに多少含まれていた方がよかったりしないでしょうか？ 今の書き方はやや淡々と漸進的である事を説明していて，動機がもう少し書かれていると納得感があるかもと思いました．

> 正確に言うとより最上位はSVをなんとかしたいということだと思うので

今のバージョンの冒頭は「漸進的であること」から始まっていると思うのですが，やっぱりこの「SVをなんとかしたい」について，ユーザーから見た現世利益的な「なんとかなった」点を箇条書きででも簡単にまとめたあとに，これをやるうえで「漸進的であること」がキーなのだと言う筋で行くほうがとも思うのですが，どうでしょうか．

論文の abstract なんかでも，どう考えても理屈は通じてないだろうって段階で「～％ 性能があがりました」とか書いて気を引きますけど，まず現世利益を示すのは結構有効だと思います（しつこくてすいません）．

以下はその他のコメントです：
* 左が Veryl 右が SystemVerlog になってますが，人はまず知っているものから見るので，これ逆の方が良いかもしれません．
* hacker news でも誰かが書いてましたけど，SV を何らかのスクリプト言語でテンプレートからパラメータ展開等して生成して使ってる人はそこそこいるはずで，（理想的には）それを Veryl に閉じて綺麗に実現できるのだと思うのですが，もし出来そうならそういうことも書いてあってもいいかもしれません．（できると嬉しいです）
* SystemVerilog は，どうも always_comb 内でローカル変数的な logic の使用ができないくさいですが（例：logic a=b; とか for ループ内で書けない？），それが Veryl だと出来るようであれば，これも書いても良いかもしれません．自分はそれが出来るなら，かなり嬉しいです．

taichi-ishitani, 2024-03-21:
テンプレート云々は、ジェネリスクが実装されれば解結しますかね？

dalance, 2024-03-22:
@shioyadan コメントありがとうございます。ちょっとすぐには難しいので、また次の機会に新しい案を考えたいと思います。

dalance, 2024-03-22:
> テンプレート云々は、ジェネリスクが実装されれば解結しますかね？

ジェネリクスだけでは難しいかもしれません。より柔軟にやるならRustの手続きマクロ的なもの（構文木を受け取って変形した構文木を返すようなマクロをユーザが定義できるような仕組み）が必要かもしれないと思っていますが、複雑性も増すのでトレードオフはありますね。

dalance, 2024-03-23:
一度に全部考えると大変なので、とりあえず「なぜVerylか？」を書いてみました。1つ目のタイトルもアイデアあればお願いします。

## なぜVerylか

### ？？？
Verylの構文は論理設計のために最適化されており、合成可能性やシミュレーションとの一致が保証されています。さらに頻出する定型文を簡素化するような構文が多数提供されています。

### 相互運用性
Verylは可読性の高いSystemVerilogソースコードを生成します。そのため既存のSystemVerilogコンポーネントと組み合わせたり、SystemVerilogプロジェクトの一部をVerylで置き換えたりすることができます。

### 生産性
Verylにはパッケージマネージャとビルドツール、多数のエディタに対応するリアルタイムチェッカーや自動補完、自動フォーマッタといったツール群が数多く揃っています。

taichi-ishitani, 2024-03-23:
SV の辛さとか、Chisel とか Alt HDL の辛さの例があると、見た目は SV に近い新しい言語を作ったか理解が深まるかもですね。

ciniml, 2024-03-24:
Chiselの生成したVerilog HDLは読めないけど、Verylのは読めるみたいな話があるといいんですかね。

実際のところ、言い方はアレですが、VerylからSystemVerilogに’戻りたくなっても何とかなるだろうと思って触り始めてるというのはあります。最悪、どこかの時点でVerylが生成したSVコードをもとにSystemVerilogのみの開発に戻ればいいだろうと。

この辺も "漸進的" という利点に含まれるのかなと思います。

dalance, 2024-03-25:
具体的に他言語の辛い点に触れるのはちょっとセンシティブな感じはします。
（Rustを推すときにC++を下げると印象が悪いというのはよく言われる話だったり…）

> 実際のところ、言い方はアレですが、VerylからSystemVerilogに’戻りたくなっても何とかなるだろうと思って触り始めてるというのはあります。最悪、どこかの時点でVerylが生成したSVコードをもとにSystemVerilogのみの開発に戻ればいいだろうと。

ここは実際業務のコードに投入するために意識している部分ですね。
自分が退職したときにVerylを書く人がいなくなったらそのままSVに戻ればいいという想定です。

shioyadan, 2024-03-26:
SystemVerilog に基本的には基づいている事など，いくつか情報を足した上で，ChatGPT 先生に整理してみてと頼んだら以下の内容が出てきました．最初の項目名は「最適化された構文」を提案されましたが，これでも良いかもしれません（論理設計に，などを足してもいい気がします）．全体に少し不自然なところがあるというか，英語的な日本語になってるきがしますが，大枠では悪くない気がします．

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

shioyadan, 2024-03-26:
「漸進的な改善」は，いくつかの利点があると思うのですが，ユーザーから見た利点の１つは，SystemVerilog 経験者には学習が容易であることだと思いますので，この点について追加してみた形です．あとは，他の HDL のように，SystemVerlog からかけ離れている訳ではないという雰囲気も入れた方が良いかなと思いました．他は細かいですが，エディタは名前を出した方が良いかなとか思いました．

dalance, 2024-03-26:
ありがとうございます。
ひとまずWebサイトの方はこれで更新しようと思います。

dalance, 2024-03-26:
https://veryl-lang.org の方を更新しました。

dalance, 2024-03-27:
READMEの方もこれで良さそうなので更新しました。
コード例はSVと対比できるようにしましたが、テーブルの横幅が制御できなくていまいちですね…。
SVを左にするとVerylが見切れてしまったのでとりあえずVerylを左のままにしています。
画像にした方がいいかもしれません。

shioyadan, 2024-03-27:
とりあえず出した叩き台のつもりだったんですが，大丈夫でしたでしょうか？

英文の方は一応校正にかけてみたのですが，多少修正を提案されました．

> This optimization includes guarantees for synthesizability, ensuring consistency between simulation results, and providing numerous syntax simplifications for common idioms.

３つの項目の表記が一貫していないため，ensures と provides にしてはと提案されました．やや意味が変わってしまう気もしますが，後ろの２つは確かに ensures と provides のが自然な気もします．

あと，日本語の時点で気になっていたのですが，consistency between simulation results は，正確にはシミュレーション時と合成時の一貫性ですよね？ これはでも，短く言うのが難しいですね．consistency between simulation and synthesized circuits とか書けば良いでしょうか．

> Veryl adopts syntax optimized for logic design while being based on a familiar basic syntax for SystemVerilog experts.

whiole being のところが不自然なようです．以下を提案されましたが，この感じで親しみやすい基本構文が保たれていると言う言い方をした方が，確かにわかりやすいかもしれません．

Veryl adopts an optimized syntax for logic design, maintaining a familiar basic syntax for experts in SystemVerilog.

> Designed with interoperability with SystemVerilog in mind, Veryl allows smooth integration and partial replacement with existing SystemVerilog components and projects.

with が２回はちょっとかっこ悪いので，for にした方がいいかもです．

Designed for interoperability with SystemVerilog, Veryl allows smooth integration and partial replacement of existing SystemVerilog components and projects.

> Veryl comes with a rich set of development support tools, including package managers, build tools, real-time checkers compatible with major editors such as VSCode, Vim, Emacs, automatic completion, and automatic formatting. These tools accelerate the development process and significantly enhance productivity.

VSCode, Vim, Emacs のところがやや読みにくいので，分割した方がよさそうです．あと，日本語のときは語順てきに問題なかったと思うのですが、エディタのサポートはその後ろの項目（automatic completion とか）にもかかってるので，上記だとやや不自然かもしれません．

Veryl enhances productivity with a suite of development support tools, including package managers and build tools. For editing, it offers features like real-time checkers, automatic completion, and automatic formatting, compatible with major editors such as VSCode, Vim, and Emacs. These features accelerate the development process, improving workflow efficiency for designers.

dalance, 2024-03-27:
> とりあえず出した叩き台のつもりだったんですが，大丈夫でしたでしょうか？

ドキュメントの場合は多少変でも特に実害はないので、じっくり検討するよりやる気があるうちにどんどん変えていくのがいい気がしてきています。（OSSの場合、次にやる気が出るのが半年後とかになる可能性も十分あるので…）

英文の修正もこのまま取り込んでいいと思っているので、もしよろしければPRだしていただけますか？
面倒なようであればこちらでコピーしますがせっかくなので。

shioyadan, 2024-03-27:
言われてみるとたしかに，こう言うのはやる気があるときに不完全であっても えいやっとやってしまった方が良さそうですね．では後で準備して PR だしておきます．ありがとうございます．

dalance, 2024-03-29:
SVに対して構文的に優位性がある点を列挙したページを作ろうと思います。
とりあえずリストアップしたのですが、他に入れたほうがいいものがあれば教えてください。

* 末尾カンマ
* クロックリセットの抽象化構文
* 同名接続の省略記法
* ドキュメンテーションコメント
* 代入演算子がalways_ffでも使える
* enumバリアントの名前空間が切れている
* ビット連結のrepeat構文
* if/case式
* 半開区間、閉区間記法（と範囲for/inside）
* msb/lsb
* outside式
* let 文による中間変数バインドが任意の場所で使える
* 名前付きブロック
* 可視性制御
* 未使用、未宣言、未代入変数のチェック（_による未使用の明示）

taichi-ishitani, 2024-03-30:
> * 同名接続の省略記法

Verilog にも `*.` で接続を省略できる機能がありますね。

現状、文法に関しては、概ね SystemVerilog のサブセットの範囲かとおもいます。
なので、ジェネリクスとか今後実装が予定されている機能で、どう差別化できるかみたいなのもあった方が良いのではと思います。

dalance, 2024-03-30:
`.*` での接続に対しては「（`.*`は何がつながっているか全くわからないので）明示性を損なわない範囲で省略できる」というような説明がいいでしょうか。

以下のような感じでSVとソースコードを対比できるといいのではないかと思っています。
なので構文がfixしていないものはちょっと書きにくいですね…。
今後の予定みたいなのはまた別途書くのがいいかもしれません。

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

dalance, 2024-03-30:
> `.*` での接続に対しては「（`.*`は何がつながっているか全くわからないので）明示性を損なわない範囲で省略できる」というような説明がいいでしょうか。

今調べて初めて知ったのですが、ポート名での省略記法もSVにあるんですね。

```verilog
ModuleA u (
    .i_clk,
    .i_rst,
    .i_dat (a)
);
```

なのでこの点は特にVerylが良いというわけでもありませんでした。

taichi-ishitani, 2024-03-30:
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

リセットの抽象化が例になっていますが、生成後の SV で

* active low なリセットに、極性を示す接頭辞なり接尾辞 (_x とか _n とか) がない
* active high なリセットに、極性を示す接頭辞なり接尾辞がある

と言うのも違和感があるので、極性をしめす接頭辞とかを生成時に後付けできるようにしておけると良いかしれないですね。

dalance, 2024-03-30:
> と言うのも違和感があるので、極性をしめす接頭辞とかを生成時に後付けできるようにしておけると良いかしれないですね。

確かにそこは書いていてちょっと気になる点ではありますね。
ただ現状だと何をリセットと認識するのかが難しい（always_ffのリセットポートから逆に辿るのは大変）ので、#569 のようなclock/reset型が必要かもしれません。
クロックリセットが明示的だとSDCの生成やチェックみたいな方向にも行けそうです。

dalance, 2024-03-31:
ドキュメントの1ページ目をWebサイトのものと同じに変更し、2ページ目に特徴を列挙するページを追加しました。

https://doc.veryl-lang.org/book/ja/
https://doc.veryl-lang.org/book/ja/02_features.html

taichi-ishitani, 2024-03-31:
> > と言うのも違和感があるので、極性をしめす接頭辞とかを生成時に後付けできるようにしておけると良いかしれないですね。
>
> 確かにそこは書いていてちょっと気になる点ではありますね。 ただ現状だと何をリセットと認識するのかが難しい（always_ffのリセットポートから逆に辿るのは大変）ので、#569 のようなclock/reset型が必要かもしれません。 クロックリセットが明示的だとSDCの生成やチェックみたいな方向にも行けそうです。

属性を示す接尾辞なりをつけるとなると、リセット自体に属性を持たせることになるので、`always_ff` での指定ではなく、型で属性を指定することになるでしょうか。
(後で別の issue に纏めます。)

* `reset`
    * 生成時に指定
* `reset_async_low`
* `reset_sync_high`

dalance, 2024-03-31:
> 属性を示す接尾辞なりをつけるとなると、リセット自体に属性を持たせることになるので、`always_ff` での指定ではなく、型で属性を指定することになるでしょうか。

最終的には生成時の指定とRTL中の指定のミスマッチがどこで検出されるかの問題で、どちらでも可能な気はします。
もしミスマッチしないなら生成時の指定のみに従って接尾辞をつけて問題ないはずなので。

* always_ffでの指定（現状）：always_ffのリセットポートで検出
* reset型での指定：reset型からreset_*型への接続で検出

reset_*型の場合、この型の変数名をどうつけるのかがちょっと微妙かもしれません。

```
i_rst  : input reset_async_low // 生成時に _n が付くことを期待する。型がlowなのにVeryl上の名前が _n でないのは不自然
i_rst_n: input reset_async_low // Veryl上の見た目は一致するが、reset型の種類によって接尾辞付与の挙動が一貫しない
```

あとは「特定の極性しかサポートしないライブラリ」みたいなもののサポートが現状あまり考えられていないのでその辺との兼ね合いも考える必要がありそうです。

taichi-ishitani, 2024-03-31:
```systemverilog
always_ff (i_clk, async_low i_reset) {

}

always_ff (i_clk, sync_high i_reset) {

}
```

の様に、同じリセット信号を違う極性で使う場合を防ぐ目的で、型で属性を指定した方が良いと考えました。
この場合をビルド時にエラーとして弾くなら、型で属性を指定しなくても良いかと思います。

Closed 2024-06-11.

Thread 580 (2024-03-20):

Generate SV code without comments

saturn77, 2024-03-20:
The ability to generate documentation from the veryl code is extremely useful.

It would also be helpful to have an option to remove or strip away the comments that are in the veryl code when generating the SystemVerilog code. In cases where the veryl code is heavily documented, this would allow inspection of the SystemVerilog code in a plain format and make it easier to review the generated code.

This process to do this would simply be placing a "strip_comments"  in the toml / veryl file as:

```toml
[format]
indent_width = 4
strip_comments = true

```

dalance, 2024-03-21:
Looks good.
`build` may be more suitable because it relates code generation.

```toml
[build]
strip_comments = true
```

saturn77, 2024-03-21:
Yes, sounds good. Having the format as below makes more sense.
```toml
[build]
strip_comments = true
```
I also really like how the actual formatted code in the SystemVerilog mirrors the code formatting in Veryl. The only exception is in the case statement, but I can live with the way that it is now.

It would be nice to have an option, however.

For example

```toml
[build]
sv_case = column_case
```
Which would make this output code:
```systemverilog
    always_ff @ (posedge clock) begin
        case (state)
            rx_IDLE : sample_counter <= CLOCKS_PER_BAUD / 2;
            rx_SHIFT: if ((sample_counter > 0)) begin
                sample_counter <= sample_counter - 1;
            end else begin
                sample_counter <= CLOCKS_PER_BAUD - 1;
            end
            rx_LOAD: sample_counter <= 0;
            rx_DONE: sample_counter <= 0;
        endcase
    end
```

being transformed to this output code instead: (what I call column case)

```systemverilog
    always_ff @ (posedge clock) begin
        case (state)
            rx_IDLE :  sample_counter <= CLOCKS_PER_BAUD / 2;
            rx_SHIFT:  if ((sample_counter > 0)) begin
                           sample_counter <= sample_counter - 1;
                       end else begin
                           sample_counter <= CLOCKS_PER_BAUD - 1;
                       end
            rx_LOAD:   sample_counter <= 0;
            rx_DONE:   sample_counter <= 0;
        endcase
    end
```

dalance, 2024-03-21:
The column_case seems to be good too.
I think it may be better that it is by default for both Veryl and generated SV.

Closed 2024-03-21.

Thread 584 (2024-03-21):

[Feature] Reset value type check

taichi-ishitani, 2024-03-21:
In most cases, a reset value should be a constant value (parameter, localparam, literal).
I think it's useful that the linter reports warnings if a non-constant value is used as a reset value.

```systemverilog
var a: logic;
var b: logic;
always_ff (i_clk, i_rst_n) {
  if_reset {
    b = a; // report warning
  }
}
```

nblei, 2024-06-03:
@dalance Is there currently a way to extract a `TokenRange` or `SourceSpan` from an `Expression`?

nblei, 2024-06-05:
@dalance This can be closed by #751

Closed 2024-06-05.

Thread 589 (2024-03-24):

Veryl panicks on build

nblei, 2024-03-24:
Building the following module

```veryl
/// A Saturating counter
module sat_counter #(
    param WIDTH      : u32          = 8 ,
    param RESET_VALUE: logic<WIDTH> = '0,
) (
    /// Clock
    i_clk: input logic,
    /// Reset
    i_rst: input logic,
    /// Enable Flag.  1 to enable incrementing/decrementing
    i_en: input logic,
    /// Direction Flag.  1 for up, 0 for down.
    i_direction: input logic,
    /// Value of counter
    o_val: output logic<WIDTH>,
    /// Next cycle's Value of counter
    o_val_next: output logic<WIDTH>,
    /// Flag indicating that the counter is saturated at its max value
    o_sat_max: output logic,
    /// Flag indicating that the counter is saturated at its min value
    o_sat_min: output logic,
    /// Flag indicating that the next counter is saturated at its max value
    o_sat_max_next: output logic,
    /// Flag indicating that the next counter is saturated at its min value
    o_sat_min_next: output logic,
) {

    assign o_sat_max = &o_val;
    assign o_sat_min = ~|o_val;

    assign o_val_next = if i_en {
        if i_direction { // 1 indicates count up
            if o_sat_max {
                o_val
            } else {
                o_val + 1
            }
        } else {
            if o_sat_min {
                o_val
            } else {
                o_val - 1
            }
        }
    } else {
        o_val
    };

    always_ff (i_clk, i_rst) {
        if_reset {
            o_val = RESET_VALUE;
        } else {
            o_val = o_val_next;
        }
    }

}
```
results in

```
[INFO ]   Processing file (src/utils/sat_counter.veryl)
thread 'main' panicked at crates/analyzer/src/handlers/check_assignment.rs:55:51:
called `Option::unwrap()` on a `None` value
stack backtrace:
   0:     0x55b883441556 - std::backtrace_rs::backtrace::libunwind::trace::hbee8a7973eeb6c93
                               at /rustc/07dca489ac2d933c78d3c5158e3f43beefeb02ce/library/std/src/../../backtrace/src/backtrace/libunwind.rs:104:5
   1:     0x55b883441556 - std::backtrace_rs::backtrace::trace_unsynchronized::hc8ac75eea3aa6899
                               at /rustc/07dca489ac2d933c78d3c5158e3f43beefeb02ce/library/std/src/../../backtrace/src/backtrace/mod.rs:66:5
   2:     0x55b883441556 - std::sys_common::backtrace::_print_fmt::hc7f3e3b5298b1083
                               at /rustc/07dca489ac2d933c78d3c5158e3f43beefeb02ce/library/std/src/sys_common/backtrace.rs:68:5
   3:     0x55b883441556 - <std::sys_common::backtrace::_print::DisplayBacktrace as core::fmt::Display>::fmt::hbb235daedd7c6190
                               at /rustc/07dca489ac2d933c78d3c5158e3f43beefeb02ce/library/std/src/sys_common/backtrace.rs:44:22
   4:     0x55b88346e1a0 - core::fmt::rt::Argument::fmt::h76c38a80d925a410
                               at /rustc/07dca489ac2d933c78d3c5158e3f43beefeb02ce/library/core/src/fmt/rt.rs:142:9
   5:     0x55b88346e1a0 - core::fmt::write::h3ed6aeaa977c8e45
                               at /rustc/07dca489ac2d933c78d3c5158e3f43beefeb02ce/library/core/src/fmt/mod.rs:1120:17
   6:     0x55b88343e35f - std::io::Write::write_fmt::h78b18af5775fedb5
                               at /rustc/07dca489ac2d933c78d3c5158e3f43beefeb02ce/library/std/src/io/mod.rs:1810:15
   7:     0x55b883441334 - std::sys_common::backtrace::_print::h5d645a07e0fcfdbb
                               at /rustc/07dca489ac2d933c78d3c5158e3f43beefeb02ce/library/std/src/sys_common/backtrace.rs:47:5
   8:     0x55b883441334 - std::sys_common::backtrace::print::h85035a511aafe7a8
                               at /rustc/07dca489ac2d933c78d3c5158e3f43beefeb02ce/library/std/src/sys_common/backtrace.rs:34:9
   9:     0x55b883442897 - std::panicking::default_hook::{{closure}}::hcce8cea212785a25
  10:     0x55b8834425f9 - std::panicking::default_hook::hf5fcb0f213fe709a
                               at /rustc/07dca489ac2d933c78d3c5158e3f43beefeb02ce/library/std/src/panicking.rs:292:9
  11:     0x55b883442d28 - std::panicking::rust_panic_with_hook::h095fccf1dc9379ee
                               at /rustc/07dca489ac2d933c78d3c5158e3f43beefeb02ce/library/std/src/panicking.rs:779:13
  12:     0x55b883442bc9 - std::panicking::begin_panic_handler::{{closure}}::h032ba12139b353db
                               at /rustc/07dca489ac2d933c78d3c5158e3f43beefeb02ce/library/std/src/panicking.rs:649:13
  13:     0x55b883441a56 - std::sys_common::backtrace::__rust_end_short_backtrace::h9259bc2ff8fd0f76
                               at /rustc/07dca489ac2d933c78d3c5158e3f43beefeb02ce/library/std/src/sys_common/backtrace.rs:171:18
  14:     0x55b883442960 - rust_begin_unwind
                               at /rustc/07dca489ac2d933c78d3c5158e3f43beefeb02ce/library/std/src/panicking.rs:645:5
  15:     0x55b882054605 - core::panicking::panic_fmt::h784f20a50eaab275
                               at /rustc/07dca489ac2d933c78d3c5158e3f43beefeb02ce/library/core/src/panicking.rs:72:14
  16:     0x55b8820546c3 - core::panicking::panic::hb837a5ebbbe5b188
                               at /rustc/07dca489ac2d933c78d3c5158e3f43beefeb02ce/library/core/src/panicking.rs:144:5
  17:     0x55b8826e3cb0 - core::option::Option<T>::unwrap::h1b13abe8c339a038
                               at /rustc/07dca489ac2d933c78d3c5158e3f43beefeb02ce/library/core/src/option.rs:931:21
  18:     0x55b882763182 - <veryl_analyzer::handlers::check_assignment::CheckAssignment as veryl_parser::generated::veryl_grammar_trait::VerylGrammarTrait>::else::hdca7fc625fcb3f34
                               at /home/nathan/projects/veryl/crates/analyzer/src/handlers/check_assignment.rs:55:18
  19:     0x55b88213a512 - veryl_parser::veryl_walker::VerylWalker::else::h3acdd7dc53a1153c
                               at /home/nathan/projects/veryl/crates/parser/src/veryl_walker.rs:389:9
  20:     0x55b8820f66f6 - veryl_parser::veryl_walker::VerylWalker::if_expression::h4e83a0e7f1f4aca9
                               at /home/nathan/projects/veryl/crates/parser/src/veryl_walker.rs:1116:9
  21:     0x55b88214b3bf - veryl_parser::veryl_walker::VerylWalker::factor::hcd8517bb4f01f64d
                               at /home/nathan/projects/veryl/crates/parser/src/veryl_walker.rs:1021:17
  22:     0x55b8820edc3a - veryl_parser::veryl_walker::VerylWalker::expression12::hd183823b178cd930
                               at /home/nathan/projects/veryl/crates/parser/src/veryl_walker.rs:995:9
  23:     0x55b8820ed05b - veryl_parser::veryl_walker::VerylWalker::expression11::hed9e1f0ba48e275d
                               at /home/nathan/projects/veryl/crates/parser/src/veryl_walker.rs:975:9
  24:     0x55b8820ec06b - veryl_parser::veryl_walker::VerylWalker::expression10::h0a0d2aa86f9c7aa8
                               at /home/nathan/projects/veryl/crates/parser/src/veryl_walker.rs:964:9
  25:     0x55b8820eb517 - veryl_parser::veryl_walker::VerylWalker::expression09::h0363a712b56cd14f
                               at /home/nathan/projects/veryl/crates/parser/src/veryl_walker.rs:950:9
  26:     0x55b8820eaa6b - veryl_parser::veryl_walker::VerylWalker::expression08::h210d1d857e08befd
                               at /home/nathan/projects/veryl/crates/parser/src/veryl_walker.rs:939:9
  27:     0x55b8820ea51b - veryl_parser::veryl_walker::VerylWalker::expression07::hcdfcb2ec3a868a38
                               at /home/nathan/projects/veryl/crates/parser/src/veryl_walker.rs:928:9
  28:     0x55b8820e9a7b - veryl_parser::veryl_walker::VerylWalker::expression06::h90ec9e98befe91f0
                               at /home/nathan/projects/veryl/crates/parser/src/veryl_walker.rs:917:9
  29:     0x55b8820e8fdb - veryl_parser::veryl_walker::VerylWalker::expression05::h49e469dc9179d2aa
                               at /home/nathan/projects/veryl/crates/parser/src/veryl_walker.rs:906:9
  30:     0x55b8820e853b - veryl_parser::veryl_walker::VerylWalker::expression04::h96fd2ac8c6299b8d
                               at /home/nathan/projects/veryl/crates/parser/src/veryl_walker.rs:895:9
  31:     0x55b8820e7a9b - veryl_parser::veryl_walker::VerylWalker::expression03::he64acd5647e8e7ea
                               at /home/nathan/projects/veryl/crates/parser/src/veryl_walker.rs:884:9
  32:     0x55b8820e6aab - veryl_parser::veryl_walker::VerylWalker::expression02::h31f5d24c76895695
                               at /home/nathan/projects/veryl/crates/parser/src/veryl_walker.rs:873:9
  33:     0x55b8820e655b - veryl_parser::veryl_walker::VerylWalker::expression01::hfb26ecdd23efb9a5
                               at /home/nathan/projects/veryl/crates/parser/src/veryl_walker.rs:862:9
  34:     0x55b8820d6abb - veryl_parser::veryl_walker::VerylWalker::expression::he42ec58d2de95442
                               at /home/nathan/projects/veryl/crates/parser/src/veryl_walker.rs:851:9
  35:     0x55b8820f665a - veryl_parser::veryl_walker::VerylWalker::if_expression::h4e83a0e7f1f4aca9
                               at /home/nathan/projects/veryl/crates/parser/src/veryl_walker.rs:1106:9
  36:     0x55b88214b3bf - veryl_parser::veryl_walker::VerylWalker::factor::hcd8517bb4f01f64d
                               at /home/nathan/projects/veryl/crates/parser/src/veryl_walker.rs:1021:17
  37:     0x55b8820edc3a - veryl_parser::veryl_walker::VerylWalker::expression12::hd183823b178cd930
                               at /home/nathan/projects/veryl/crates/parser/src/veryl_walker.rs:995:9
  38:     0x55b8820ed05b - veryl_parser::veryl_walker::VerylWalker::expression11::hed9e1f0ba48e275d
                               at /home/nathan/projects/veryl/crates/parser/src/veryl_walker.rs:975:9
  39:     0x55b8820ec06b - veryl_parser::veryl_walker::VerylWalker::expression10::h0a0d2aa86f9c7aa8
                               at /home/nathan/projects/veryl/crates/parser/src/veryl_walker.rs:964:9
  40:     0x55b8820eb517 - veryl_parser::veryl_walker::VerylWalker::expression09::h0363a712b56cd14f
                               at /home/nathan/projects/veryl/crates/parser/src/veryl_walker.rs:950:9
  41:     0x55b8820eaa6b - veryl_parser::veryl_walker::VerylWalker::expression08::h210d1d857e08befd
                               at /home/nathan/projects/veryl/crates/parser/src/veryl_walker.rs:939:9
  42:     0x55b8820ea51b - veryl_parser::veryl_walker::VerylWalker::expression07::hcdfcb2ec3a868a38
                               at /home/nathan/projects/veryl/crates/parser/src/veryl_walker.rs:928:9
  43:     0x55b8820e9a7b - veryl_parser::veryl_walker::VerylWalker::expression06::h90ec9e98befe91f0
                               at /home/nathan/projects/veryl/crates/parser/src/veryl_walker.rs:917:9
  44:     0x55b8820e8fdb - veryl_parser::veryl_walker::VerylWalker::expression05::h49e469dc9179d2aa
                               at /home/nathan/projects/veryl/crates/parser/src/veryl_walker.rs:906:9
  45:     0x55b8820e853b - veryl_parser::veryl_walker::VerylWalker::expression04::h96fd2ac8c6299b8d
                               at /home/nathan/projects/veryl/crates/parser/src/veryl_walker.rs:895:9
  46:     0x55b8820e7a9b - veryl_parser::veryl_walker::VerylWalker::expression03::he64acd5647e8e7ea
                               at /home/nathan/projects/veryl/crates/parser/src/veryl_walker.rs:884:9
  47:     0x55b8820e6aab - veryl_parser::veryl_walker::VerylWalker::expression02::h31f5d24c76895695
                               at /home/nathan/projects/veryl/crates/parser/src/veryl_walker.rs:873:9
  48:     0x55b8820e655b - veryl_parser::veryl_walker::VerylWalker::expression01::hfb26ecdd23efb9a5
                               at /home/nathan/projects/veryl/crates/parser/src/veryl_walker.rs:862:9
  49:     0x55b8820d6abb - veryl_parser::veryl_walker::VerylWalker::expression::he42ec58d2de95442
                               at /home/nathan/projects/veryl/crates/parser/src/veryl_walker.rs:851:9
  50:     0x55b882111339 - veryl_parser::veryl_walker::VerylWalker::assign_declaration::hc28056e965f9ae80
                               at /home/nathan/projects/veryl/crates/parser/src/veryl_walker.rs:1685:9
  51:     0x55b8820e3d0c - veryl_parser::veryl_walker::VerylWalker::module_item::h43202a2fae94a1b0
                               at /home/nathan/projects/veryl/crates/parser/src/veryl_walker.rs:2338:49
  52:     0x55b8820f0dcb - veryl_parser::veryl_walker::VerylWalker::module_group::hc2948ae33306eb88
                               at /home/nathan/projects/veryl/crates/parser/src/veryl_walker.rs:2318:48
  53:     0x55b882115b37 - veryl_parser::veryl_walker::VerylWalker::module_declaration::h54d8fd9e48dbc1fa
                               at /home/nathan/projects/veryl/crates/parser/src/veryl_walker.rs:2235:13
  54:     0x55b882108a71 - veryl_parser::veryl_walker::VerylWalker::description_item::hca736e616beaa4ef
                               at /home/nathan/projects/veryl/crates/parser/src/veryl_walker.rs:2578:54
  55:     0x55b88210c1cb - veryl_parser::veryl_walker::VerylWalker::description_group::h40a6435cc7ce6011
                               at /home/nathan/projects/veryl/crates/parser/src/veryl_walker.rs:2569:58
  56:     0x55b882147521 - veryl_parser::veryl_walker::VerylWalker::veryl::h8265ff1e54083a8e
                               at /home/nathan/projects/veryl/crates/parser/src/veryl_walker.rs:2595:13
  57:     0x55b882165fb5 - veryl_analyzer::analyzer::Analyzer::analyze_pass2::ha0c032790df6a031
                               at /home/nathan/projects/veryl/crates/analyzer/src/analyzer.rs:100:9
  58:     0x55b8821792e4 - veryl::cmd_build::CmdBuild::exec::h62415a923c0c8b2d
                               at /home/nathan/projects/veryl/crates/veryl/src/cmd_build.rs:49:30
  59:     0x55b8820727c1 - veryl::main::hdb537e414548a9f4
                               at /home/nathan/projects/veryl/crates/veryl/src/main.rs:243:31
  60:     0x55b88209ffd2 - core::ops::function::FnOnce::call_once::h8bde5dec66239d51
                               at /rustc/07dca489ac2d933c78d3c5158e3f43beefeb02ce/library/core/src/ops/function.rs:250:5
  61:     0x55b8820b2da5 - std::sys_common::backtrace::__rust_begin_short_backtrace::h962aad157ebe2f07
                               at /rustc/07dca489ac2d933c78d3c5158e3f43beefeb02ce/library/std/src/sys_common/backtrace.rs:155:18
  62:     0x55b882071966 - std::rt::lang_start::{{closure}}::h3c81f348fce59bc2
                               at /rustc/07dca489ac2d933c78d3c5158e3f43beefeb02ce/library/std/src/rt.rs:166:18
  63:     0x55b883436f51 - core::ops::function::impls::<impl core::ops::function::FnOnce<A> for &F>::call_once::h37600b1e5eea4ecd
                               at /rustc/07dca489ac2d933c78d3c5158e3f43beefeb02ce/library/core/src/ops/function.rs:284:13
  64:     0x55b883436f51 - std::panicking::try::do_call::hb4bda49fa13a0c2b
                               at /rustc/07dca489ac2d933c78d3c5158e3f43beefeb02ce/library/std/src/panicking.rs:552:40
  65:     0x55b883436f51 - std::panicking::try::h8bbf75149211aaaa
                               at /rustc/07dca489ac2d933c78d3c5158e3f43beefeb02ce/library/std/src/panicking.rs:516:19
  66:     0x55b883436f51 - std::panic::catch_unwind::h8c78ec68ebea34cb
                               at /rustc/07dca489ac2d933c78d3c5158e3f43beefeb02ce/library/std/src/panic.rs:142:14
  67:     0x55b883436f51 - std::rt::lang_start_internal::{{closure}}::hffdf44a19fd9e220
                               at /rustc/07dca489ac2d933c78d3c5158e3f43beefeb02ce/library/std/src/rt.rs:148:48
  68:     0x55b883436f51 - std::panicking::try::do_call::hcb3194972c74716d
                               at /rustc/07dca489ac2d933c78d3c5158e3f43beefeb02ce/library/std/src/panicking.rs:552:40
  69:     0x55b883436f51 - std::panicking::try::hcdc6892c5f0dba4c
                               at /rustc/07dca489ac2d933c78d3c5158e3f43beefeb02ce/library/std/src/panicking.rs:516:19
  70:     0x55b883436f51 - std::panic::catch_unwind::h4910beb4573f4776
                               at /rustc/07dca489ac2d933c78d3c5158e3f43beefeb02ce/library/std/src/panic.rs:142:14
  71:     0x55b883436f51 - std::rt::lang_start_internal::h6939038e2873596b
                               at /rustc/07dca489ac2d933c78d3c5158e3f43beefeb02ce/library/std/src/rt.rs:148:20
  72:     0x55b88207193a - std::rt::lang_start::h52725e42157e0b74
                               at /rustc/07dca489ac2d933c78d3c5158e3f43beefeb02ce/library/std/src/rt.rs:165:17
  73:     0x55b88207a97e - main
  74:     0x7f916d029d90 - __libc_start_call_main
                               at ./csu/../sysdeps/nptl/libc_start_call_main.h:58:16
  75:     0x7f916d029e40 - __libc_start_main_impl
                               at ./csu/../csu/libc-start.c:392:3
  76:     0x55b882054ee5 - _start
  77:                0x0 - <unknown>
```

dalance, 2024-03-25:
Thanks!
I've fixed it.

Closed 2024-03-25.

Thread 598 (2024-03-26):

[Feature] Tentative struct definition for type parameter declaration

taichi-ishitani, 2024-03-26:
I'm rewriting a SV module having type parameter assumed to be overwritten by struct type.
I put `logic` to this kind of parameter as tentative type.
https://github.com/pezy-computing/pzbcm/blob/8f796eb5e83ce8fbadbbc93aea1012f680fadd3f/pzbcm_min_max_finder/pzbcm_min_max_finder.sv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

During building Veryl version of this module I got following errors because default value of `RESULT` is `logic` and `logic` does not have `data` and `location` members.

```
[INFO ]   Processing file (/home/ishitani/workspace/pzbcm_veryl/pzbcm_min_max_finder/pzbcm_min_max_finder.veryl)
Error:   × veryl check failed

Error: unknown_member (https://doc.veryl-lang.org/book/06_appendix/02_semantic_error.html#unknown_member)

  × "result" doesn't have member "data"
    ╭─[/home/ishitani/workspace/pzbcm_veryl/pzbcm_min_max_finder/pzbcm_min_max_finder.veryl:63:1]
 63 │     if next_n == 1 {
 64 │       result.data     = next_data[0];
    ·       ───┬──
    ·          ╰── Error location
 65 │       result.location = next_location;
    ╰────
  help:
Error: unknown_member (https://doc.veryl-lang.org/book/06_appendix/02_semantic_error.html#unknown_member)

  × "result" doesn't have member "location"
    ╭─[/home/ishitani/workspace/pzbcm_veryl/pzbcm_min_max_finder/pzbcm_min_max_finder.veryl:64:1]
 64 │       result.data     = next_data[0];
 65 │       result.location = next_location;
    ·       ───┬──
    ·          ╰── Error location
 66 │     } else {
    ╰────
  help:
```

To resolve this kind of problem, I'd like Veryl to have a notation to describe required members for a param type declaration like below.

```systemverilo
param RESULT: type = struct(data, location)
```

Thread 599 (2024-03-26):

[Feature] var declaration in block in function

taichi-ishitani, 2024-03-26:
Currently, Veryl does not support `var declaration` in block in function.
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

Short lifetime of variable is good for readable code so I'd like Veryl to support this feature.

saturn77, 2024-03-31:
@taichi-ishitani This is a good feature as described above.

Also, in addition to var, there may be the options to include a **const**.

I just started to review IEEE 1800-2023, which was released in February 2024.

In 1800-2023, there is a section 6.20.6 which describes the new **const** keyword. It is something to be aware of for future Veryl support.

```text
A const form of constant differs from a localparam constant in that the localparam shall be set during
elaboration, whereas a const can be set during simulation, such as in an automatic task.
A static constant declared with the const keyword can be set to an expression of literals, parameters, local
parameters, genvars, enumerated names, a constant function of these, or other constants. Hierarchical names
are allowed because constants declared with the const keyword are calculated after elaboration.
```

I can see this being useful for cases where there are iterations on a module's parameters during simulation.

saturn77, 2024-03-31:
Another question or comment is related to static var type inside of a function.

For the code below, is FuncA "automatic" type , i.e. always re-entrant ?

A suggestion for static function is shown in add_u8 below.

```systemverilog
// package definition
package PackageA {
    local ParamA: u32 = 1;
    local ParamB: u32 = 1;

    function FuncA (
        a: input  logic<ParamA>,
    ) -> logic<ParamA> {
        return a + 1;
    }

    static function add_u8 ( logic<8> x, logic<8> b) -> logic<9> {
        static var z = 0;   // local static var, initialized to 0
        z = z + x  + y;
        return z;
    }
}

module ModuleA {
    let a : logic<10> = PackageA::ParamA;
    let _b: logic<10> = PackageA::FuncA(a);

    let result : logic<9> = 0;
    result = PackageA::add_u8(1,2);

    $display("result = %d", result);  // prints 3

    result = PackageA::add_u8(3,4);
    $display("result = %d", result);  // prints 10 ??

}
```

taichi-ishitani, 2024-03-31:
> static var z = 0;   // local static var, initialized to 0

Design Compiler will ignore this kind of initialization.
Therefore, I'm not sure Veryld should support `static` lifetime.

saturn77, 2024-03-31:
AMD-Xilinx UG901 only support static functions, according to latest document 2023.

nblei, 2024-03-31:
Variables declared inside functions must be static, and functions must be static if we want them to be synthesizable.  Synthesizing reentrant functions is, in general, impossible.  I agree with @taichi-ishitani that `static` keyword is thus not needed in Veryl.

According to SV LRM 13.4.2, functions are implicitly given a static lifetime unless they are declared with the `automatic` keyword, or they are defined within a module, interface, program, or package which is declared as `automatic`.

Since `automatic` is not emitted by Veryl, then it means all emitted functions are static.  However, it does not hurt to explicitly mark the emitted SV functions as `static`.

taichi-ishitani, 2024-04-01:
> AMD-Xilinx UG901 only support static functions, according to latest document 2023.

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

Vivado supports both of static and autoamtic function.

saturn77, 2024-04-01:
I personally have never used a static function with Vivado, with my understanding that "static" functions will be treated as automatic per UG901.

@taichi-ishitani The reference that you make is at the end of UG901, and is in conflict with the the descriptions earlier in the document. There are many forum articles on amd-xilinx about this.

Basically, I do not use static functions for synthesis with vivado.

In the context of other synthesis tools or asic tools I am not sure how they are treated.

I have always used automatic for synthesis as an example below.

```systemverilog
    //------------------------------------------------------
    // Local Functions
    //------------------------------------------------------
    function automatic int unsigned accumulate_with_limit (int unsigned te_count);
	    if (te_count < TE_MAX_COUNT) begin
		    te_count = te_count + 1;
	    end else begin
	        te_count = TE_MAX_COUNT;
	    end
	    accumulate_with_limit = te_count;
    endfunction

    function automatic int unsigned hold();
	    hold = 1;
    endfunction
```

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

saturn77, 2024-04-01:
Vivado **synthesis**  treats all functions as automatic.

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

taichi-ishitani, 2024-04-01:
> Since `automatic` is not emitted by Veryl, then it means all emitted functions are static.

Veryl emmitd all SV functions are `automatic` but not `static`.
See this testcase.
https://github.com/veryl-lang/veryl/blob/c34f5cd377f08f7a79dc41f33b2eaffabc1835ef/testcases/sv/06_function.sv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

nblei, 2024-04-01:
My bad, I hope I didn't add confusion with my horrible and wrong description of all functions needing to be static, when of course, `automatic` allocation leads to static-hardware allocation.  I was confusing `automatic` with re-entrant.

Closed 2024-09-02.

Thread 602 (2024-03-27):

[Feature] Define functions within type definition

taichi-ishitani, 2024-03-27:
It is common for similar pieces of code to appear frequently. For exmaple:

```systemverilog
var foo_bar: foo_bar_type; // foo_bar_type is enum
let is_foo: logic = foo_bar == foo_bar_type::FOO;
let is_bar: logic = foo_bar == foo_bar_type::BAR;
```

I think functions defined within a type definition can resolve this kind of situation.

```systemverilog
enum foo_bar_type: logic {
  FOO,
  BAR,
  function is_foo: logic = self == FOO,
  function is_bar: logic = self == BAR
}

var foo_bar:  foo_bar_type;
let is_foo:   logic = foo_bar.is_foo();
let is_bar:   logic = foo_bar.is_bar();
```

For ease to generate SV code, function defined within tyep definition can have one expression only like `let` declaration. Due to this limitation,  Veryl has only to expand the body expression during generating SV code.

```systemverilog
typedef enum logic {
  foo_bar_type_FOO,
  foo_bar_type_BAR
} foo_bar_type;

//  expand body expression during SV generation
always_comb is_foo = foo_bar == foo_bar_type_FOO;
always_comb is_bar = foo_bar == foo_bar_type_FOO;

```

saturn77, 2024-03-27:
Related to above post, would the following below be possible ?

```systemverilog
// Veryl example
enum Number : <T : type(int)> {
  Infinite,
  Value(T),
  // implied "method" that very would need to create based on <T : type(int) >
  function __check_on_assign__ -> logic = self == ( type(float) || type(unsigned) ),
}

var some_integer : Number::<i32> = Number::Value(-241);

var some_integer : Number::<f32> = Number::Value(1.2567);  <--- Veryl error

nblei, 2024-03-27:
A couple of things.  Perhaps checker functions should be made by default, or with some type of pragma:

```rust
#[derive(EnumCheckers)]
enum foo_bar : logic {
  FOO,
  BAR
}
```

Also, I think it should be `foo_bar::is_foo` --- using the scoping `::` operator, as `is_foo` is a type, not an instance of a type.

@saturn77 see #323

There are some complications with tagged unions.

1. To the best of my knowledge no synthesis tools currently support tagged unions, so they will need to be translated into non-tagged structs, and `match` / `if let` / etc statements will have to be built out of SV functions.  This is not at all a game-breaking challenge.
2. SV does not support parametric structs, so unless there is a significant change in Veryl design philosophy, I think that parametric structs in Veryl are a bad choice.
3. In hardware, how many bits are used to encode the tag?  Further, how are those bits specified?  Further, what is the location of those bits within the context of the fields?

For example, in hardware I may have some register `r` such that,
when `r[5] = 1`, `{r[6] r[4:0]}` is a pointer to memory, when `r[5:4] = 2'b01`, `r[6]` is a sign bit and `r[3:0]` is a magnitude, and when `r[5:4] = 2'b'00`, `{r[6], r[4:3]}` and `r[2:0]` are pointers to registers.  A contrived example, but illustrative of the point.

So the syntax for specifying these types of things needs to be determined.

4. Further, currently, there is no good way of doing type size checks in Veryl.  This shouldn't be a game-breaking challenge, but it is also something that needs to be done since SV packed structs must have the same length, Veryl will need to emit SV with unused bits when different variants have different sizes, so this compiler capability will need to be built.

saturn77, 2024-03-28:
Perhaps it would be the most robust path to simply constrain any Enum to be of logic or bit type **only**.

I personally cannot think of a synthesized case outside of that.

For example, only allowing logic type:
```systemverilog
enum ThreePhase : logic[1:0] {
  a,
  b,
  c,
}
```
An the analogous bit version :
```systemverilog
enum Quadrature : bit[1:0] {
  d,
  q,
  zero,
}
```
relative to @nblei comments;

I would suggest a "one-hot" procedural derive macro that has two requirements:

1. verify that the size of the logic/bit is correct for the number of states **and** type of encoding
2. assign the one hot encoding as directed, with default sequence being 000, 001, 010, 100, etc.

Also, if normal integral encoding is to be done the #[derive(one_hot)] could be left off.

```systemverilog
module rx_uart {
clock : input bit,
reset : input bit,
....
done : output bit,
}

{

#[derive(one_hot)]
enum Rx : bit[2:0] {
idle,  // 000
shifting,  // 001
load,  // 010
done,  // 100
}

var state : Rx ;

always_ff (clock, reset)
if_reset  {
  state = Rx::idle;
} else {
case(state) ...
....
}

assign done = state[2];

}

```
The advantage of the one_hot derive macro would be to also

1. allow arbitrary insertion of additional states into the state machine
2. without having to renumber the state

for example, the Veryl compiler will also determine the one hot encoding in the derived SV:

```systemverilog

typedef enum logic[2:0] {

idle = 3'b000,
shifting = 3'b001,
load = 3'b010,
done = 3'b100,
};
```

or let's say you inserted another state in the middle :

```systemverilog
#[derive(one_hot)]
enum Rx : bit[3:0] {
idle,
shifting,
debounce,
load,
done,
}
```
then Veryl would compile this into :

```systemverilog

typedef enum logic[3:0] {

idle = 4'b0000,
shifting = 4'b0001,
debounce = 4'b0010,
load = 4'b0100,
done = 4'b1000,
};
```

Finally, as a **bonus** ( I know this is a long post)

I am suggest "Auto" sort of like C++ auto :

```systemverilog
#[derive(one_hot)]
enum Rx : auto  {
idle,
shifting,
debounce,
load,
done,
}
```
This would be worthwhile IF :

1. Enum's were constrained to logic / bit type
2. Veryl has to calculate the size of appropriate logic / bit type
  - for integral types
  - for one hot type

taichi-ishitani, 2024-03-28:
> I am suggest "Auto" sort of like C++ auto

I think this is related to #539.

saturn77, 2024-03-28:
@taichi-ishitani yes, it is very similar to https://github.com/veryl-lang/veryl/issues/539.

I think the main difference is that "auto" would be a placeholder, but it could be removed as in your example.

taichi-ishitani, 2024-03-28:
@saturn77 ,
I think you should put your suggestion to #539 too.

taichi-ishitani, 2024-03-28:
Ruby's struct definition can taka a block including method definitions like below.

```ruby
Customer = Struct.new(:name, :address) do
  def greeting
    "Hello #{name}!"
  end
end
Customer.new("Dave", "123 Main").greeting # => "Hello Dave!"
```

Refering this syntax, how bout the syntax for this feature?

```systemverilog
enum foo_bar_type: logic {
  FOO,
  BAR
}{
  function is_foo() -> logic = self == FOO;
  function is_bar() -> logic = self == BAR;
}
```

By using an additional block, we can also introduce this feature to `type` feature.

```systemverilog
type word: logic<w> {
  function get_parity() -> logic = ^self;
}
```

nblei, 2024-03-28:
@taichi-ishitani I really like your idea for creating class member functions for enums / user defined data types.  Only thing I would suggest is that we do not introduce new syntax for functions, but continue to borrow rust style syntax (i.e., function body is declared inside `{` `}`).

taichi-ishitani, 2024-03-28:
if/case expression can take a statement-less block.
So no functin syntax is needed.

```systemverilog
enum foo_bar_type: logic {
  FOO,
  BAR
} {
  function is_foo() -> logic { self == FOO }
  function is_bar() -> logic { self == BAR }
}

struct foo_bar_type {
  foo: logic,
  bar: logic
}{
  function is_foo_zero() -> logic { self.foo == 0 }
  function is_bar_one() -> logic { self.bar == 1 }
}

type word: logic<w> {
  function get_parity() -> logic { ^self }
  function match_parity(other: input word) -> logic {
    self.get_parity() == other.get_parity()
  }
}
```

saturn77, 2024-03-28:
@nblei
I like the suggestions for discriminating of one_hot, one_hot0, one_cold, and one_cold1. I think this would be a very good feature.

An idea is here:

```systemverilog
#[encode_one_hot0]
enum Rx : auto(logic) {
Idle,
Shiting,
Load,
Done,
}
```
Considering that the enum has to be inspected to determine the integral size (Auto), and also determine encoding, a procedural derive macro may still be warranted such as below:

```systemverilog
#[derive(Auto, Onehot0)]
enum Rx  {
Idle,
Shiting,
Load,
Done,
}
```
Actually I like the above syntax format using (Auto, Onehot0) and this could also be (Auto, Onecold0) for example.

This is somewhat similar to using multiple derives in Rust such as

```rust
use serde::{Serialize, Deserialize};

#[derive(Serialize, Deserialize, Debug)]
struct Point {
    x: i32,
    y: i32,
}

fn main() {
    let point = Point { x: 1, y: 2 };

    let serialized = serde_json::to_string(&point).unwrap();
    println!("serialized = {}", serialized);

    let deserialized: Point = serde_json::from_str(&serialized).unwrap();
    println!("deserialized = {:?}", deserialized);
}
```

Overall, having Veryl automatically determine the size for the integral type AND the encoding is exciting, and automate the process of writing state machine a little further than currently exists.

saturn77, 2024-03-28:
I like @taichi-ishitani suggestion regarding adding function to type as this :

```systemverilog
type word: logic<w> {
  function get_parity() -> logic { ^self }
  function match_parity(other: input word) -> logic {
    self.get_parity() == other.get_parity()
  }
}
```

My suggestion is to think about adding a "trait" type object in Veryl, such as shown below. The purpose of adding the trait type object would be to create a separate syntax from "type" or "typedef" when attaching functions to that type . . .

For example a trait in Rust could like this:
```rust
pub trait Counter {
    type IncrementFuture<'m>: Future<Output = u32> where Self: 'm;
    fn increment<'m>(&'m mut self) -> Self::IncrementFuture<'m>;

    type AddFuture<'m>: Future<Output = u32> where Self: 'm;
    fn add<'m>(&'m mut self, value: u32) -> Self::AddFuture<'m>;
}
```

where as in Veryl a trait could be such as :
```systemverilog
pub very_trait Word  {
  type word : logic<w>;
  function get_parity() -> logic { ^self };
  function match_parity(other: input word) -> logic {
    self.get_parity() == other.get_parity()
  };
}
```
in the case above for veryl_trait, then type or typedef would remain simple typing.

Overall, I am suggesting this as an option. But either way, I think attaching functions to type is powerful.

dalance, 2024-03-28:
At the viewpoint of syntax complexity, introducing a `impl `declaration is probably better than adding function block to each `enum`, `struct` and `type` individually.

```systemverilog
enum foo_bar_type: logic {
  FOO,
  BAR
}

impl foo_bar_type {
  function is_foo() -> logic { self == FOO }
  function is_bar() -> logic { self == BAR }
}

struct foo_bar_type {
  foo: logic,
  bar: logic
}

impl foo_bar_type {
  function is_foo_zero() -> logic { self.foo == 0 }
  function is_bar_one() -> logic { self.bar == 1 }
}

type word = logic<W>;

impl word {
  function get_parity() -> logic { ^self }
  function match_parity(other: input word) -> logic {
    self.get_parity() == other.get_parity()
  }
}
```

taichi-ishitani, 2024-03-29:
> At the viewpoint of syntax complexity, introducing a `impl `declaration is probably better than adding function block to each `enum`, `struct` and `type` individually.

This declaration looks good for me.
But I'm not sure how to use this kind of type because I'm not familiar with rust style syntax. Like below?

```systemverilog
enum foo_bar_type {
  FOO,
  BAR
}

impl foo_bar_type {
  function is_foo() -> logic { self == FOO }
  function is_bar() -> logic { self == BAR }
}

var foo_bar: foo_bar_type;
let is_foo: logic foo_bar.is_foo();
let is_bar: logic foo_bar.is_bar();
```

taichi-ishitani, 2024-03-29:
Thank you, I understood.

In addition, referring Ruby's `mix-in` feature, I think that defining a function block which is not yet associated to a TYPE is useful to share common code.

```systemverilog
unbinded_block parity_calurator { // need to consier keyword
  function get_parity() -> logic { ^self }
}

var foo: logic<8>;
var bar: logic<10>;

impl foo, unbinded_block;
impl bar, unbinded_block;

let foo_parity: logic = foo.get_parity();
let bar_parity: logic = bar.get_parity();
```

taichi-ishitani, 2024-06-14:
メモ

メソッドの中身を式に限定せず、任意のメソッドを定義できるようする。
そして、generics の様に、メソッド定義を展開するのが良いかもしれない。

これを、

```systemverilog
enum foo_bar_type {
  FOO,
  BAR
}

impl foo_bar_type {
  function is_foo() -> logic { return self == FOO; }
}

let foo: foo_bar_type = FOO;
let is_foo: logic = foo.is_foo();
```

以下の様に展開する。

```systemverilog
typedef enum logic {
  FOO,
  BAR
} foo_bar_type;

function automatic __foo_bar_type_is_foo(foo_bar_type self);
  return self == FOO;
endfunction

foo_bar_type foo;
always_comb foo = FOO;
logic is_foo;
always_comb is_foo = __foo_bar_type_is_foo(foo);
```

これなら、メソッド中に if やループを書くことができる。

Thread 619 (2024-03-31):

Output file combination

saturn77, 2024-03-31:
This is a **feature** suggestion for the build tool.

The suggestion is to add the option to bundle or pickle all systemverilog output files into a single file.

Some tools, like the morty tool have done this (https://github.com/pulp-platform/morty). I would like to suggest adding the similar feature to the [build] section of the toml file.

For example,

```toml
[build]
strip_comments = true
bundle = true
top_level = "uart_top_level.sv"
```
The above example would strip comments and put all source files into a single file name, and the "top_level" would designate the file name for the top level file. If one left the top_level file name blank, then it would use the proj_name as the top level file.

I think this would be a great feature for handling large designs as well as creating re-usable IP, for example, say someone made a project with

- uart_tx.veryl
- uart_rx.veryl
- uart_parser.veryl
- uart_fifo.veryl
- uart_package.veryl

Then with

```toml
[build]
strip_comments = true
bundle = true
top_level = "top_level_uart_system.sv"
```
all five files would be bundled into top_level_uart_system.sv.

nblei, 2024-03-31:
I do not see much utility in this feature, since veryl already produces a file `<project-name>.f` which contains all the generated sverilog files.

So something as simple as `cat $(cat uart.f) >top_level_uart_system.sv` would generate the desired file.

I also don't think veryl should be **promoting** bad practices, such as placing all modules into a single file.

saturn77, 2024-03-31:
I cannot see a logical reason why it is a bad practice to have a single SystemVerilog file, when the design language is Veryl.

I have written several EDA tools, widely used within companies, particularly for very large logic analyzer designs among other things. Having a single file is advantageous in an automated tool chain where everything is combined into one file and the compiler is kicked off with this single file. That is why pulp platform wrote morty, and they are not the first to write such a tool.

The general approach that is the foundation here is :

1. Design mode == individual modules each have their own source file (Veryl)
2. Compilation mode == combined modules into a single file (systemverilog)

Source code is read more often that it is written, so for readability purpose, I would not recommend combining multiple modules into a signal file for the source of truth root file (Design mode), which is in the case Veryl.

But part of Veryl's advantage is that is also is an integrated build tool in combination with being a compiler.

Hence generating a single file is simply part of Compilation mode option.

dalance, 2024-04-05:
There are two use cases that come to mind for outputting a single file. One is due to constraints of EDA tools; for example, about 20 years ago, in our project, we used `include` statements to read the entire project from a single file because specific EDA tools became very unstable when reading many files. Another is when providing the project to others. It is convenient to have a single file to prevent troubles related to the order and format of the file list when providing it as an IP to customers or to EDA vendors for support. In this case, readability of the output is not a concern and it is often encrypted.

Considering that one of Veryl's goals is to be integrated into existing projects, I think there is a reason to support projects in a single file format. Moreover, among the already supported multiple file list formats, adding one more output format would not particularly endorse a specific approach.

dalance, 2024-04-16:
I added `bundle` target.

```toml
[build]
target = {type = "bundle", path = "output.sv"}
```

Closed 2024-04-16.

Thread 622 (2024-04-01):

[Feature] Introduce `clock`/`reset` types

taichi-ishitani, 2024-04-01:
`clock` and `reset` signals must be made explicit to implement following new features.

* #624
* #623
* #569

Introduce special data type `clock` and `reset` types for this purpose.

```systemverilog
i_clk: input clock,
i_rst_n: input reset,
```

saturn77, 2024-04-01:
I think that this is a great approach to address this issue, while having multiple features as a result.

Basically in your approach "clock" and "reset" are data types allowing for flexible implementation. I think this will work.

Another option / idea is to introduce a special rust crate for global data types "clock_t" and "reset_t".  This crate would support synthesis and language features of Veryl that are oriented towards synthesis. For example, including jitter in the clock struct as shown in the example below.

```rust
pub mod veryl_std {

/// This is a rust module / crate read by Veryl compiler
/// Do not edit without special care

enum : Polarity  {
positive(1),
negative(0),
}

struct Frequency {
value : f32,
jitter : f32,
}

// clock data type - includes name, polarity, frequency, and
// whether the clock comes from a DLL / PLL (versus direct pin pad)
struct clock {
name : String,
polarity : Polarity,
frequency : Frequency,
dll_pll : bool,
}

}

```

Then, in veryl code:

```rust
import veryl_std;

module {
i_clk: input clock.name,
i_rst_n: input reset.name,
}
{
local clock = {
polarity : positive,
freq.value : "100e6",
freq.jitter : "1e-9",
dll_pll : true,
};

}

```
Overall, this is just an idea if more meta-information would be added to clock / reset.

The existing approach seems like a good way to go for now.

taichi-ishitani, 2024-04-02:
refs: https://github.com/veryl-lang/veryl/issues/575#issuecomment-2028741523

How abount `reset` type including  polarity and synchronicity like below.

* `reset`
    * polarity and synchronicity are specified by build time configuration (Veryl.toml).
* `reset_async_low`
    * async/low active
* `reset_sync_high`
    * sync/high active
* `reset_async_high`
    * async/active high
* `reest_sync_low`
    * sync/active low

For #623, Veryl will insert prefix or suffix to reset ports of which type is `reset` only.

By reset types including reset properties, Veryl can report error when reset signals of which properties are not matched are connected.

```systemverilog
i_rst: input reset
...

inst u_foo: foo (
  i_foo_rst: i_foo // i_foo_rst is sync/active high reset but i_rst's properties are not specified.
                   // Veryl reports reset mismatch error.
);
```

For this case, user need to put `type cast` explicitly.

```
i_rst: input reset
...

let foo_rst: reset_sync_high = i_rst as reset_sync_high;
inst u_foo: foo (
  i_foo_rst: foo_rst // reset properties are matched so Veryl reports no errors.
);
```

Generated SV:

```systemverilog
input var i_rst;
...
logic foo_rst;

always_comb begin
  foo_rst = ~i_rst;
end

foo u_foo (
  .i_foo_rst (foo_rst)
);
```

taichi-ishitani, 2024-04-02:
In my opinion, I think `Veryl.toml` should contain these kind of clock information but not RTL body.

saturn77, 2024-04-02:
Yes, I think there are positive and negatives to the clock information being in the RTL versus toml file.

The toml file implements a "singleton pattern" for all the clocks, while the RTL view is more of a configurable pattern.

I think both ways are okay.

dalance, 2024-05-08:
I'll merge #701 having simple clock and reset types.
The idea of complex struct is interesting too, but I think parameters like frequency should be placed out of source code
because it is affected by elements which can't be expressed by RTL.
For example, device (ASIC or FPGA?), process (which Fab?, which technology node?), voltage and so on.

Closed 2024-05-08.

Thread 633 (2024-04-06):

[Feature] In-line Struct Assignment

anantajit, 2024-04-06:
As I understand the current Veryl documentation, struct assignment in Veryl cannot be done in-line and each field must be initialized separately:

```
struct X {
  field_1: ...,
  field_2: ...
}

...

var x: X;
x.field_1 = ...
x.field_2 = ...
```

I think that the following Rust-like syntax would be best for this use-case:
```
let x = X { field_1: ..., field_2: ... };
```

dalance, 2025-03-21:
I'll add this feature because `const` assignment can't be splitted to field assignments.

```systemverilog
struct Param {
    a: bit<10>,
    b: bit<10>,
}

const p: Param = Param {
    a: 10,
    b: 10,
};

const q: Param = Param {
    a: 1,
    ..default(0), // as the same as `..Default::default()` in Rust
};
```

This will be transpiled into below:

```systemverilog
localparam Param p = '{
    a: 10,
    b: 10
};

localparam Param q = '{
    a: 1,
    default: 0
};
```

`const p: Param = Param {}` may be bit redundant, but it may be simplified like `const p = Param {}` by type inferation in future.

dalance, 2025-03-21:
`{` after expression is used by many syntaxes like `if expression {`.
So `Param {` is ambiguous. `Param '{` can be used instead of it.

```systemverilog
struct Param {
    a: bit<10>,
    b: bit<10>,
}

const p: Param = Param '{
    a: 10,
    b: 10,
};

const q: Param = Param '{
    a: 1,
    ..default(0), // as the same as `..Default::default()` in Rust
};
```

Closed 2025-03-24.

Thread 634 (2024-04-07):

The translation from assign to always_comb resulted in an error

zrr1999, 2024-04-07:
I am a beginner, and I am using Verilog to write a simple RAM module:
```
module RAM (
    i_ram_ena  : input logic   ,
    i_ram_read : input logic   ,
    i_ram_write: input logic   ,
    i_ram_addr : input logic<8>,
    io_ram_data: inout logic<8>,
) {
    var memory: logic<8> [256];
    assign io_ram_data = if i_ram_read && i_ram_ena {
        memory[i_ram_addr]
    } else {
        8'hzz
    };

    always_ff (i_ram_write) {
        if i_ram_ena {
            memory[i_ram_addr] = io_ram_data;
        }
    }
}
```
This code was translated into:
```verilog
module RAM (
    input logic         i_ram_ena  ,
    input logic         i_ram_read ,
    input logic         i_ram_write,
    input logic [8-1:0] i_ram_addr ,
    inout logic [8-1:0] io_ram_data
);
    logic [8-1:0] memory      [0:256-1];
    always_comb io_ram_data = ((i_ram_read && i_ram_ena) ? (
        memory[i_ram_addr]
    ) : (
        8'hzz
    ));

    always_ff @ (posedge i_ram_write) begin
        if (i_ram_ena) begin
            memory[i_ram_addr] <= io_ram_data;
        end
    end
endmodule
```
When I use iverilog, I get the following error:
src/ram.sv:9: error: io_ram_data is not a valid l-value in RAM.
src/ram.sv:6:      : io_ram_data is declared here as wire.
However, when I change always_comb to assign, I don't get an error.
So, are there certain situations where assign should not be translated to always_comb?

dalance, 2024-04-07:
I missed this case.
`inout` can't be assigned through `always_comb`.
Additionally `inout logic` is invalid, `inout wire` should be emitted instead of it.

dalance, 2024-04-12:
I've added `tri` type modifier check for `inout` port,
and `assign` is emitted at assignment to `tri` type variable after merging #655.

```systemverilog
    io_ram_data: inout tri logic<8>, // add tri type modifier
```

Closed 2024-04-12.

Thread 641 (2024-04-10):

[Question] How to use case statement with don't care?

nananapo, 2024-04-10:
Hi.
Is the case statement with don't care like ```casez``` or ```casex``` supported?
I want to use it to implement a decoder.

taichi-ishitani, 2024-04-10:
Veryl has not yet supported these statement.

@dalance
SystemVerilog has `case inside` statement that is enhanced version of `casex` statement.
So I think Veryl should support `case inside` but has not to support `casex` and `casez` statements.

nananapo, 2024-04-11:
By the way, case expression seems to be converted into logic using ternary operator ```?```. But I think converting into case statement is better.

dalance, 2024-04-12:
> By the way, case expression seems to be converted into logic using ternary operator `?`. But I think converting into case statement is better.

The reason using ternary operator is that it can be used at arbitrary expression context like below:

```systemverilog
// pass
localparam A = X == 1 ? 0 : 1;

// fail
localparam A = case (X)
    1: 0;
    default: 1;
endcase
```

nananapo, 2024-04-12:
I think it would be nice if the semantics of case expression and statement are not different.

taichi-ishitani, 2024-04-12:
SystemVerilog does not have `if expression` and `case expression` features so I think it's difficult.

taichi-ishitani, 2024-06-14:
@nananapo ,
I changed emmition of `case` statemen from the simple `case` statement to the `case inside` statement.
Now you can use unknown values for case conditions like the `casex` statement.

nananapo, 2024-06-14:
やったー😆
ありがとうございます🙏

2024年6月14日(金) 18:03 Taichi Ishitani ***@***.***>:

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

Closed 2024-06-11.

Thread 643 (2024-04-11):

[Feature] `case inside` statement and expression

taichi-ishitani, 2024-04-11:
SystemVerilog has the `case inside` statement that is enhanced version of `casex` statetment.
Veryl should support it.

_Originally posted by @taichi-ishitani in https://github.com/veryl-lang/veryl/issues/641#issuecomment-2048010806_

dalance, 2024-04-11:
Emitting `case inside` instead of `case` from Veryl's `case` seems to be good?
Is there cases to require the original `case` emitting?

From

```systemverilog
case x {
    0      : a = 1,
    1..3   : a = 2,
    'h1xx  : a = 3,
    default: a = 4,
}
```

To

```systemverilog
case (x) inside {
    0      : a = 1,
    [1:2]  : a = 2,
    'h1xx  : a = 3,
    default: a = 4,
}
```

taichi-ishitani, 2024-04-11:
Like the exmaple below, behavior of `case` and `case inside` are different when a case item expression has unknwon value.

```systemverilog
case (a)
  b:      c = 1; // select only when a == b
  default c = 0;
endcase

case (a) inside
  b:      c = 1; // select when a == b or b is unknown
  default c = 0;
endcase
```

So I think these should be different syntax.

taichi-ishitani, 2024-04-11:
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

This behavior may cause difference between simulation and synthesis result.
(refs: https://qiita.com/taichi-ishitani/items/d5bb34273fce8d4b0385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)

I think it can be solution for this problem to introduce limitation that `case item expr` should be a constant.

dalance, 2024-04-11:
I think the following `case` and `switch` seems to be good.

* `case` statement
  * case item should not be expression
  * emits `case inside`
* `switch` statement (refs #11)
  * switch arm can be expression
  * emits `case`

```systemverilog
case a {
    0      : c = 1;
    default: c = 2;
}

switch {
    a == b : c = 1;
    default: c = 2;
}
```

```systemverilog
case (a) inside
    0: c = 1;
    default: c = 2;
endcase

case (1)
    a == b : c = 1;
    default: c = 2;
endcase
```

Thread 644 (2024-04-11):

Can't use $signed

nananapo, 2024-04-11:
```
module ModuleA () {
    let _a : logic = $signed(0);
}
```
```sh
ParserError::SyntaxError

  💥 Unexpected token: Signed
   ╭─[:1:1]
 1 │ module ModuleA () {
 2 │     let _a : logic = $signed(0);
   ·                       ───┬──
   ·                          ╰── Error location
 3 │ }
   ╰────
  help: Syntax error(s) in input prevents prediction of next production
```

Closed 2024-04-12.

Thread 645 (2024-04-11):

typedef enum  can't resolve member

nananapo, 2024-04-11:
```veryl
module ModuleA () {
    enum E: logic<1> {
        X,
        MEMBER,
    }
    type E2    = E       ;
    let _ok  : E        = E::MEMBER;
    let _fail: E        = E2::MEMBER;
}
```
```
  💥 "E2" doesn't have member "MEMBER"
   ╭─[:7:1]
 7 │     let _ok  : E        = E::MEMBER;
 8 │     let _fail: E        = E2::MEMBER;
   ·                           ─┬
   ·                            ╰── Error location
 9 │ }
   ╰────
  help:

```

Closed 2024-04-11.

Thread 647 (2024-04-11):

error location and member is incorrect

nananapo, 2024-04-11:
```veryl
package Package {
    enum E: logic<1> {
        X,
        MEMBER,
    }
}
module ModuleA () {
    let _2: Package::E = Package::E::NOT_FOUND;
}
```
```
 💥 "E" doesn't have member "Package"
   ╭─[:7:1]
 7 │ module ModuleA () {
 8 │     let _2: Package::E = Package::E::NOT_FOUND;
   ·                          ───┬───
   ·                             ╰── Error location
 9 │ }
   ╰────
  help:
```

dalance, 2024-04-11:
I've fixed this issue like below:

```
  × "E" doesn't have member "NOT_FOUND"
   ╭─[/home/hatta/work/repos/veryl/test.veryl:7:1]
 7 │ module ModuleA () {
 8 │     let _2: Package::E = Package::E::NOT_FOUND;
   ·                          ──────────┬──────────
   ·                                    ╰── Error location
 9 │ }
   ╰────
  help:

```

Closed 2024-04-11.

Thread 651 (2024-04-11):

[Feature] Add option/configuration to follow symlinks.

ciniml, 2024-04-11:
Currently, `veryl build` does not follow symlinks when gathering the source files.

https://github.com/veryl-lang/veryl/blob/82435188b958bd61ceafef9c246e3f8b9a3a3e7c/crates/metadata/src/utils.rs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

So I'm currently using modified version of `veryl` which follows symlinks like this.

```rust
pub fn gather_files_with_extension<T: AsRef<Path>>(
    base_dir: T,
    ext: &str,
) -> Result<Vec<PathBuf>, MetadataError> {
    let mut ret = Vec::new();
    for entry in WalkDir::new(base_dir).follow_links(true) {
        let entry = entry?;
        if entry.file_type().is_file() {
            if let Some(x) = entry.path().extension() {
                if x == ext {
                    debug!("Found file ({})", entry.path().to_string_lossy());
                    ret.push(entry.path().to_path_buf());
                }
            }
        }
    }
    Ok(ret)
}
```

In my use case, it's fine to just follow symlinks, but for practical purposes, I think it's a good idea to make it possible to enable or disable this feature through options or configuration files.

dalance, 2024-04-16:
I think symlink support can be enabled by default for local usage.
The problem about symlink is that some platform (e.g. Windows) may not support symlink at git checkout.
So `veryl publish` will check symlink and deny them.

Closed 2024-04-16.

Thread 664 (2024-04-14):

Wrong interface instantiation

nananapo, 2024-04-14:
```sv
interface ifA {
    var _a: logic;
}
module ModuleA {
    inst _x: ifA;
    var _y: ifA;
}
```
This Veryl code is translated into
```sv
interface project_ifA;
    logic _a;
endinterface
module project_ModuleA;
    project_ifA _x ();
    project_ifA _y;
endmodule
```

Is ```var _y: ifA;``` legal in veryl?

If it's legal,
According to IEEE Std 1800-2017 A.4.1.1 Module instantiation
```
hierarchical_instance ::= name_of_instance ( [ list_of_port_connections ] )
```
and A.4.1.2 Interface instantiation,
```
interface_instantiation ::=
interface_identifier [ parameter_value_assignment ] hierarchical_instance { , hierarchical_instance } ;
```

I think interface instantiation can't omit ```()```.

taichi-ishitani, 2024-04-15:
> Is var _y: ifA; legal in veryl?

See #638

dalance, 2024-04-15:
It is not valid in Veryl.
Type of variable should be built-in types or user defined struct, enum, unoin, typedef, parameter type.
I'll add variable type check like below:

```
Error: mismatch_type (https://doc.veryl-lang.org/book/06_appendix/02_semantic_error.html#mismatch_type)

  × "ifA" is expected to "enum or union or struct", but it is "interface"
   ╭─[/home/hatta/work/repos/veryl/test.veryl:5:1]
 5 │     inst _x: ifA;
 6 │     var _y: ifA;
   ·         ─┬
   ·          ╰── Error location
 7 │ }
   ╰────
  help:
```

Closed 2024-04-15.

Thread 683 (2024-04-20):

enum case condition with multiline comment emits wrong new line

nananapo, 2024-04-20:
```veryl
module ModuleA () {
    enum Enum: logic {
        A,
    }
    var _value: logic;
    always_comb {
        case (Enum::A) {
            /*
            */
            Enum::A: _value = 0;
            default: _value = 1;
        }
    }
}
```
```systemverilog
module project_ModuleA ();
    typedef enum logic {
        Enum_A
    } Enum;
    logic _value;
    always_comb begin
        case ((Enum_A))
            /*
            */
            Enum_
            A: _value = 0;
            default: _value = 1;
        endcase
    end
endmodule
```

Closed 2024-04-22.

Thread 691 (2024-04-28):

formatting error in case statement in case statement

nananapo, 2024-04-28:
```veryl
module TopModule {
    let a: i32 = case 0 {
        0      : case 0 {
            0      : 0,
            1      : 0,
            default: 0,
        },
        1      : 0,
        default: 0,
    };
    always_comb {
        case 0 {
            0: {
                   case 0 {
                       0      : {}
                    1      : {}
                    default: {}
                }
            }
            1      : {}
            default: {}
        }
    }
}
```

Closed 2024-04-30.

Thread 708 (2024-05-09):

[Feature] clock/reset port connection check

taichi-ishitani, 2024-05-09:
refs: https://github.com/veryl-lang/veryl/issues/622#issuecomment-2030848796

To prevent clock/reset type mismatch, we need to check type mismatch on clocl/reset port connections.

```systemverilog
module ModA (
  i_clk:   input clock_posedge,
  i_rst_n: input reset_async_low
) {}

module ModB (
  i_clk: input clock,
  i_rst: input reset
){
  inst u_moda: ModA (
    i_clk:   i_clk, // these connection include type mismatch
    i_rst_n: i_rst  // so Veryl should report an error.
  );
}

nblei, 2024-06-04:
I'm a bit confused.

What does `clock_posedge` mean?  Does it mean that any flops driven by this clock must be positive edge-triggered?  In which case, what is the issue with connecting `i_clk : clock` to `i_clk : clock_posedge`?

nblei, 2024-06-04:
I get that, I think I'm more questioning the notion of this being a property of the _clock_ wire rather than a property of the registers.

taichi-ishitani, 2024-06-04:
I'd like to simplify `always_ff` declarations so I've moved clock/reset prorperties from `always_ff` block to `clock`/`reset` types.

dalance, 2024-06-05:
I think that using `clock_posedge` is more explicit than placing `posedge` in sensitivity list.
Espacially I like it can show that the clock/reset connection should be careful at the module port declaration which is public API.

```systemverilog
module ModuleA (
    i_clk: clock_posedge,
    i_rst: reset_async_low,
) {
    always_ff {
        if_reset {
        } else {
        }
    }
}
module ModuleB (
    i_clk: clock,
    i_rst: reset,
) {
    let w_clk: clock_negedge = i_clk;
    let w_rst: reset_async_high = i_rst;
    always_ff (w_clk, w_rst) {
        if_reset {
        } else {
        }
    }
}
```

```systemverilog
module ModuleA (
    i_clk: clock,
    i_rst: reset,
) {
    always_ff (posedge i_clk, async_low i_rst) {
        if_reset {
        } else {
        }
    }
}
module ModuleB (
    i_clk: clock,
    i_rst: reset,
) {
    always_ff (negedge i_clk, async_high, i_rst) {
        if_reset {
        } else {
        }
    }
}
```

Closed 2024-08-16.

Thread 712 (2024-05-10):

SystemVerilog keyword check

dalance, 2024-05-10:
Some keyword of SystemVerilog can be used as identifier in Veryl.
They will cause syntax error of transpiled SystemVerilog code.
So they should be checked by Veryl compiler.

taichi-ishitani, 2024-05-10:
Keywords list
(From IEEE 1800-2023 Annex B)

* accept_on
* alias
* always
* always_comb
* always_ff
* always_latch
* and
* assert
* assign
* assume
* automatic
* before
* begin
* bind
* bins
* binsof
* bit
* break
* buf
* bufif0
* bufif1
* byte
* case
* casex
* casez
* cell
* chandle
* checker
* class
* clocking
* cmos
* config
* const
* constraint
* context
* continue
* cover
* covergroup
* coverpoint
* cross
* deassign
* default
* defparam
* design
* disable
* dist
* do
* edge
* else
* end
* endcase
* endchecker
* endclass
* endclocking
* endconfig
* endfunction
* endgenerate
* endgroup
* endinterface
* endmodule
* endpackage
* endprimitive
* endprogram
* endproperty
* endspecify
* endsequence
* endtable
* endtask
* enum
* event
* eventually
* expect
* export
* extends
* extern
* final
* first_match
* for
* force
* foreach
* forever
* fork
* forkjoin
* function
* generate
* genvar
* global
* highz0
* highz1
* if
* iff
* ifnone
* ignore_bins
* illegal_bins
* implements
* implies
* import
* incdir
* include
* initial
* inout
* input
* inside
* instance
* int
* integer
* interconnect
* interface
* intersect
* join
* join_any
* join_none
* large
* let
* liblist
* library
* local
* localparam
* logic
* longint
* macromodule
* matches
* medium
* modport
* module
* nand
* negedge
* nettype
* new
* nexttime
* nmos
* nor
* noshowcancelled
* not
* notif0
* notif1
* null
* or
* output
* package
* packed
* parameter
* pmos
* posedge
* primitive
* priority
* program
* property
* protected
* pull0
* pull1
* pulldown
* pullup
* pulsestyle_ondetect
* pulsestyle_onevent
* pure
* rand
* randc
* randcase
* randsequence
* rcmos
* real
* realtime
* ref
* reg
* reject_on
* release
* repeat
* restrict
* return
* rnmos
* rpmos
* rtran
* rtranif0
* rtranif1
* s_always
* s_eventually
* s_nexttime
* s_until
* s_until_with
* scalared
* sequence
* shortint
* shortreal
* showcancelled
* signed
* small
* soft
* solve
* specify
* specparam
* static
* string
* strong
* strong0
* strong1
* struct
* super
* supply0
* supply1
* sync_accept_on
* sync_reject_on
* table
* tagged
* task
* this
* throughout
* time
* timeprecision
* timeunit
* tran
* tranif0
* tranif1
* tri
* tri0
* tri1
* triand
* trior
* trireg
* type
* typedef
* union
* unique
* unique0
* unsigned
* until
* until_with
* untyped
* use
* uwire
* var
* vectored
* virtual
* void
* wait
* wait_order
* wand
* weak
* weak0
* weak1
* while
* wildcard
* wire
* with
* within
* wor
* xnor
* xor

nblei, 2024-06-05:
@dalance this can be closed #750

Closed 2024-06-05.

Thread 739 (2024-05-28):

Semantic error checker flags non-real errors

nblei, 2024-05-28:
The check for multiple assignments occurs at the variable level, rather than the bit/wire level.

```systemverilog
module fa (
    i_a : input  logic,
    i_b : input  logic,
    i_ci: input  logic,
    o_s : output logic,
    o_co: output logic,
) {
    assign o_s  = ^{i_a, i_b, i_ci};
    assign o_co = |{i_a & i_b, i_a & i_ci, i_b & i_ci};
}

module rca #(
    param WIDTH: u32 = 8,
) (
    i_a : input  logic<WIDTH>,
    i_b : input  logic<WIDTH>,
    i_ci: input  logic       ,
    o_s : output logic<WIDTH>,
    o_co: output logic       ,
) {
    var carries: logic [WIDTH + 1];

    assign carries[0] = i_ci;
    assign o_co       = carries[WIDTH];

    for i in 0..WIDTH :gen_fas {
        inst u_fa: fa (
            i_a : i_a[i]        ,
            i_b : i_b[i]        ,
            i_ci: carries[i]    ,
            o_co: carries[i + 1],
            o_s : o_s[i]        ,
        );
    }
}
```

```bash
  × carries is assigned in multiple procedural blocks or assignment statements
    ╭─[/home/nathan/Documents/Reviews/MICRO-2024/rca/src/rca.veryl:20:1]
 20 │ ) {
 21 │     var carries: logic [WIDTH + 1];
    ·         ───┬───
    ·            ╰── Error location
 22 │
 23 │     assign carries[0] = i_ci;
    ·     ───┬──
    ·        ╰── Assigned
 24 │     assign o_co       = carries[WIDTH];
 25 │
 26 │     for i in 0..WIDTH :gen_fas {
 27 │         inst u_fa: fa (
 28 │             i_a : i_a[i]        ,
 29 │             i_b : i_b[i]        ,
 30 │             i_ci: carries[i]    ,
 31 │             o_co: carries[i + 1],
    ·             ──┬─
    ·               ╰── Assigned too
 32 │             o_s : o_s[i]        ,
    ╰────
```

dalance, 2024-05-29:
Partial assignment at port connection seems to be treated as full assignment now.
I'll fix it.

nblei, 2024-05-31:
Naoya,

This seems to have been a course correction too far!

```SystemVerilog
module rca #(
    param WIDTH: u32 = 8,
) (
    i_a : input  logic<WIDTH>,
    i_b : input  logic<WIDTH>,
    i_ci: input  logic       ,
    o_s : output logic<WIDTH>,
    o_co: output logic       ,
) {
    // carry-outs
    var carries: logic [WIDTH + 1];

    assign carries[0] = i_ci;
    assign carries[0] = ~i_ci;
    assign o_co       = carries[WIDTH];

    for i in 0..WIDTH :gen_fas {
        inst u_fa: full_adder (
            i_a : i_a[i]        ,
            i_b : i_b[i]        ,
            i_ci: carries[i]    ,
            o_co: carries[i + 1],
            o_s : o_s[i]        ,
        );
    }
}
```

Now this builds successfully, despite having multiple assignments to the same bit.  This is, I think, better than before, because the bug will get picked up during synthesis, but is still not ideal.

dalance, 2024-05-31:
Yes. The multiple assignment by partial assignment is not checked yet.
I created a new issue for it.

Closed 2024-05-29.

Thread 749 (2024-06-03):

Generics arity error inside generic package

taichi-ishitani, 2024-06-03:
Veryl reports a generic arity error for the code below.

```systemverilog
package PackageA::<W> {
  struct StructA {
    a: logic<W>
  }

  function FuncA() -> StructA {
    var a: StructA;
    a.a = 0;
    return a;
  }
}
```

```
https://doc.veryl-lang.org/book/06_appendix/02_semantic_error.html#mismatch_generics_arity \mismatch_generics_arity (link) ]8;; \

  💥 generics "StructA" has 1 generic arguments, but 0 arguments are supplied
   ╭─[:5:1]
 5 │
 6 │   function FuncA() -> StructA {
   ·                       ───┬───
   ·                          ╰── Error location
 7 │     var a: StructA;
   ╰────
  help: fix generics arguments
```

I think Veryl should not report this error because the `StructA` struct is defined within the same package scope.

taichi-ishitani, 2024-06-03:
Generated SV file is also strange.

```systemverilog
package veryl_PackageA;
    typedef struct packed {
        logic [-1:0] a;
    } __StructA__W;

    function automatic __StructA__W FuncA() ;
        __StructA__W a  ;

        a.a = 0;
        return a;
    endfunction
endpackage

module veryl_ModuleA #(
    parameter int unsigned W = 1
);
    veryl_PackageA::__StructA__W a  ;
    always_comb a.a = 0;
endmodule
```

taichi-ishitani, 2024-06-05:
Package and struct can have generic parameters but Veryl doent not support this pattern.
https://github.com/veryl-lang/veryl/blob/365ea2e920acc63a956cae2f3b00226b1372f180/crates/analyzer/src/handlers/create_symbol_table.rs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

Due to this, the generics identidifier error was raised.

taichi-ishitani, 2024-06-05:
To support hierarchical generics reference, need to introduce namespace for generics parameters?

Closed 2024-06-06.

Thread 756 (2024-06-05):

Type name and variable name conflicts cause stack overflow

clkbug, 2024-06-05:
Hi.
`veryl check/build` command agiainst the following code causes `fatal runtime error: stack overflow`

```veryl
module mod (
    x: input x,
) {
}
```

This may not be a problem in practical terms, but I was a bit surprised when I mistyped `clk: input clk`.

nblei, 2024-06-05:
@dalance The stack overflow is caused by unbounded recurssion in the symbol table's resolve function.

`(resolve -> trace_user_defined ->)*`

Closed 2024-06-26.

Thread 757 (2024-06-06):

Undefined identifier error is duplicated

dalance, 2024-06-06:
```
Error: undefined_identifier (https://doc.veryl-lang.org/book/06_appendix/02_semantic_error.html#undefined_identifier)

  × mod is undefined
   ╭─[test.veryl:1:1]
 1 │ module mod (
 2 │     x: input x,
   ·              ┬
   ·              ╰── Error location
 3 │ ) {
   ╰────
  help:
Error: undefined_identifier (https://doc.veryl-lang.org/book/06_appendix/02_semantic_error.html#undefined_identifier)

  × x is undefined
   ╭─[test.veryl:1:1]
 1 │ module mod (
 2 │     x: input x,
   ·              ┬
   ·              ╰── Error location
 3 │ ) {
   ╰────
  help:
```

Closed 2024-06-06.

Thread 759 (2024-06-06):

Panic on resolving generics  parameters

taichi-ishitani, 2024-06-06:
Veryl reports paninc error when building following veryl code.

```systemverilog
package PackageA {
    function FuncA::<W> -> logic<W> {
        var a: logic<W>;
        a = 0;
        return a;
    }
}

module Sub::<W> {
  let _a: logic<W> = PackageA::FuncA::<W>();
}

module Top {
  inst u_sub_1: Sub::<1>();
  inst u_sub_2: Sub::<2>();
}
```

Back trace

```
$ RUST_BACKTRACE=full veryl build
[INFO ]   Processing file (/home/taichi/workspace/temp/veryl/test/test.veryl)
thread 'main' panicked at crates/analyzer/src/symbol_path.rs:118:56:
called `Option::unwrap()` on a `None` value
stack backtrace:
   0:     0x55fc841322f6 - <std::sys_common::backtrace::_print::DisplayBacktrace as core::fmt::Display>::fmt::h9c4bd387f9f3f544
   1:     0x55fc8415f630 - core::fmt::write::h938c332fdab924eb
   2:     0x55fc8412e6ef - std::io::Write::write_fmt::h4a694b02e44e6363
   3:     0x55fc841320d4 - std::sys_common::backtrace::print::ha888e6736b0bc71f
   4:     0x55fc841337a7 - std::panicking::default_hook::{{closure}}::he19a7f79f7beab5e
   5:     0x55fc84133509 - std::panicking::default_hook::h67efe04e9a5d446e
   6:     0x55fc84133c38 - std::panicking::rust_panic_with_hook::h49021cdbc4b22349
   7:     0x55fc84133ad9 - std::panicking::begin_panic_handler::{{closure}}::hfbf601f3d8c62d13
   8:     0x55fc841327f6 - std::sys_common::backtrace::__rust_end_short_backtrace::h98dd020b6e913806
   9:     0x55fc84133864 - rust_begin_unwind
  10:     0x55fc8396e765 - core::panicking::panic_fmt::h0d3f1893e38be419
  11:     0x55fc8396e823 - core::panicking::panic::h59297120e85ea178
  12:     0x55fc8396e6b6 - core::option::unwrap_failed::h630ca121a67dc3e4
  13:     0x55fc83cde2ae - veryl_analyzer::symbol_table::resolve::h11ea50d4e28f6a3b
  14:     0x55fc83cd5fc2 - veryl_analyzer::symbol_path::GenericSymbolPath::is_generic_reference::h16efed3a84a0f71f
  15:     0x55fc83cc0d35 - veryl_analyzer::handlers::create_reference::CreateReference::generic_symbol_path::h9ff399a3a6b1a21f
  16:     0x55fc83cc1083 - veryl_analyzer::handlers::create_reference::CreateReference::generic_symbol_path::h9ff399a3a6b1a21f
  17:     0x55fc83cc1ba8 - <veryl_analyzer::handlers::create_reference::CreateReference as veryl_parser::generated::veryl_grammar_trait::VerylGrammarTrait>::scoped_identifier::h340bb39aceb1024f
  18:     0x55fc839a1b0f - veryl_parser::veryl_walker::VerylWalker::scoped_identifier::hbe52afdf073a2714
  19:     0x55fc839927c4 - veryl_parser::veryl_walker::VerylWalker::module_group::hbe9b989ebdada2fe
  20:     0x55fc8399e51c - veryl_parser::veryl_walker::VerylWalker::description_item::hc042cffecd9806cf
  21:     0x55fc8399ffca - veryl_parser::veryl_walker::VerylWalker::description_group::h89b0f994cf76b2c8
  22:     0x55fc839cb02c - veryl_analyzer::analyzer::Analyzer::analyze_pass2::h7182f7574cd3597e
  23:     0x55fc83a3e675 - veryl::cmd_build::CmdBuild::exec::h75c572447f746962
  24:     0x55fc83a66c1d - veryl::main::h9b892d65d8008cf9
  25:     0x55fc839d22b3 - std::sys_common::backtrace::__rust_begin_short_backtrace::habe6e743b5b2c4a0
  26:     0x55fc839d2682 - std::rt::lang_start::{{closure}}::he0df41a1f0feab41
  27:     0x55fc84126e21 - std::rt::lang_start_internal::hc3f700406209db2c
  28:     0x55fc83a75145 - main
  29:     0x7fa43db68d90 - <unknown>
  30:     0x7fa43db68e40 - __libc_start_main
  31:     0x55fc8396ef75 - _start
  32:                0x0 - <unknown>
```

Thread 761 (2024-06-06):

Check type of generics arguments

taichi-ishitani, 2024-06-06:
Currently, Veryl generates invalid SV code if a `parameter` value is given to a generics argument.
For example:

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

Parameter values are not resolved when generating SV code so Veryl should report an error for code like above.

Thread 775 (2024-06-10):

Cannot use a generic parameter as a variable type

taichi-ishitani, 2024-06-10:
Veryl reports an error while building the code below.

```systemverilog
module ModuleA {
  function FuncA::<T> -> T {
    var a: T;
    a = 0;
    return a;
  }

  type my_logic = logic;
  let _a: logic = FuncA::<my_logic>();
}
```

```
 ]8;;https://doc.veryl-lang.org/book/06_appendix/02_semantic_error.html#mismatch_type \mismatch_type (link) ]8;; \

  💥 "T" is expected to "enum or union or struct", but it is "generic
  │ parameter"
   ╭─[:2:1]
 2 │   function FuncA::<T> -> T {
 3 │     var a: T;
   ·         ┬
   ·         ╰── Error location
 4 │     a = 0;
   ╰────
```

taichi-ishitani, 2024-06-11:
This error occurs here.
https://github.com/veryl-lang/veryl/blob/5d16a2796c19cf8c7e314cd0865213a704b1d9a6/crates/analyzer/src/analyzer.rs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

Need to get the actual generic argument when that symbol is a generic parameter.

Closed 2024-06-12.

Thread 793 (2024-06-20):

[Feature] Generics for code block

taichi-ishitani, 2024-06-20:
SV's text macro is useful feature to reduce coding cost for repeated code blocks.
I need this kind of feature to import code below to Very.
https://github.com/rggen/rggen-sample/blob/b0439abf7d5fa6086c4d0aef0ffcdc6836506f06/uart_csr.sv#L1-L9

I think it can be achieved if the generics feature handle code blocks.

dalance, 2024-06-20:
A syntax idea about generic `block` declaration.

```systemverilog
block rggen_connect_bit_field_if::<RIF, FIF, LSB, WIDTH> {
    assign  FIF.valid                 = RIF.valid;
    assign  FIF.read_mask             = RIF.read_mask[LSB+:WIDTH];
    assign  FIF.write_mask            = RIF.write_mask[LSB+:WIDTH];
    assign  FIF.write_data            = RIF.write_data[LSB+:WIDTH];
    assign  RIF.read_data[LSB+:WIDTH] = FIF.read_data;
    assign  RIF.value[LSB+:WIDTH]     = FIF.value;
}

module ModuleA {
    inst u_block: rggen_connect_bit_field_if::<bit_field_if, bit_field_sub_if, 0, 8>;
}
```

taichi-ishitani, 2024-06-20:
It looks good.
But why is instance name need? Is it to separate namespace?

dalance, 2024-06-20:
> It looks good. But why is instance name need? Is it to separate namespace?

Yes. And adding name-less instantiation increases syntax complexity.
The generated SV will become like below:

```systemverilog
if (1) begin: u_block
    assign  FIF.valid                 = RIF.valid;
    assign  FIF.read_mask             = RIF.read_mask[LSB+:WIDTH];
    assign  FIF.write_mask            = RIF.write_mask[LSB+:WIDTH];
    assign  FIF.write_data            = RIF.write_data[LSB+:WIDTH];
    assign  RIF.read_data[LSB+:WIDTH] = FIF.read_data;
    assign  RIF.value[LSB+:WIDTH]     = FIF.value;
end
```

taichi-ishitani, 2025-01-29:
Module instance and code block instance are completely different.
I think another syntax should be introduced for code block instnace.

taichi-ishitani, 2025-01-30:
How about `block` or `insert`?

```systemverilog
block u_block: rggen_connect_bit_field_if::<bit_field_if, bit_field_sub_if, 0, 8>;
insert u_block: rggen_connect_bit_field_if::<bit_field_if, bit_field_sub_if, 0, 8>;
```

dalance, 2025-01-30:
In your example, almost all syntax except keyword seems to be the same as instance declaration.
And instantiation is not specialized for module, but also it is used for interface instantiation.
So I feel expanding it for block may be natural.

Could you explain about necessity of specialized syntax?

taichi-ishitani, 2025-01-30:
Main reason is a implementation issue.

Code block should be analyzed on the context where it is instantiated.
For exmaple:
https://github.com/veryl-lang/veryl/blob/e69e0051176212d412e70f7245800044076d6974/crates/analyzer/src/handlers/check_type.rs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

To do this, the implementation may be below.

```rust
fn inst_declaration(&mut self, arg: &InstDeclaration) -> Result<(), ParolError> {
  match symbo.found.kind {
    CodeBlock => {
      self.statement_block_group(&x.statement_block_group);
    }
    _ => {
      // copy original implemnetation here
    }
  }
}
```

We need to insert the above code to analyzer handlers:

* Execute context aware check for code block
* Override `inst_declaration` method

I think this is troublesome so I'd like to separate `InstDeclaration` rule for code block and module instance.

Thread 803 (2024-06-28):

duplicate reserved [clock] word in vendor IP core.

YSawc, 2024-06-28:
I use vendor IP core for developing memory system, but reserved `clock` word is duplicated with veryl.
Is there already some way to avoid duplication in this case ?
```
    inst ip_wram: $sv::ip_wram (
        address: i_addr,
        clock  : i_casted_clk,
        data   : i_data        ,
        wren   : i_ip_wram_we  ,
        q      : o_ip_wram_data,
    );
```

compile error here.
```
Error: ParserError::SyntaxError

  × Unexpected token: ','
    ╭─ ...
 14 │     inst ip_wram: $sv::ip_wram (
 15 │         address: i_addr,
    ·                        ┬
    ·                        ╰── Error location
 16 │         clock  : i_casted_clk,
    ╰────
  help:

```

dalance, 2024-06-28:
This is planed at #711.
I'll implement it in the next week.

dalance, 2024-07-01:
I merged #806.

Closed 2024-07-01.

Thread 808 (2024-07-02):

port cannot be used as a factor in an expression

YSawc, 2024-07-02:
modport item cannot use assignment as instruction item.

```
interface If {
    var en: logic;

    modport port {
        en: output,
    }
}

module ModuleA (
    if_a: modport If::port,
) {

    inst module_d: ModuleB (
        if_b: if_a,
    );
}

module ModuleB (
    if_b: modport If::port,
) {}
```

build error is here.
```
Error:   × veryl check failed

Error: invalid_factor (https://doc.veryl-lang.org/book/07_appendix/02_semantic_error.html#invalid_factor)

  × if_a of kind "port" cannot be used as a factor in an expression
    ╭─[/home/ys/workspace/Veryl/uarty/HDL/test2.veryl:14:15]
 13 │     inst module_d: ModuleB (
 14 │         if_b: if_a,
    ·               ──┬─
    ·                 ╰── Error location
 15 │     );
    ╰────
  help: remove port from expression
```

nblei, 2024-07-02:
Curreently the `check_expression` pass is flagging any symbols of kind `Port` with direction `Interface` or `Modport` as illegal factors.  I think this makes sense in most contexts, but clearly not in the one YSawc has posted where a modport is passed from one module into a deeper module.

Easy solution is to simply not raise an error when `Port` with `Interface` or `Modport` direction is used as a factor.

Closed 2024-08-15.

Thread 811 (2024-07-04):

inside of case is not implemented quartus

YSawc, 2024-07-04:
I use latest quartus prime lite for program logic but the software is not supported inside of case yet.

generated.sv
```
       case (status) inside
            Status_idle: ...
        endcase
```

quartus compile error here.
```
Error (10170):... near text: "inside";  expecting an operand. Check for and fix any syntax errors that appear immediately before or at the specified keyword. The Intel FPGA Knowledge Database contains many articles with specific details on how to resolve this error. Visit the Knowledge Database at https://www.altera.com/support/support-resources/knowledge-base/search.html and search for this specific error message number.

```

Like this case is not offten but, I think better if there is something like compile flag controlled by veryl.toml example.

dalance, 2024-07-05:
Veryl's case supports range and don't care, so removing `inside` from generated SV doesn't work fine.
Instead of it, `if ( .. inside ..)` chain may be useful.

```
// default
case (status) inside
    Status_idle: ...
endcase

// "emit_if_inside_for_case = true" in Veryl.toml
if (status inside {Status_idle}) begin
end else if ...
```

Is such usage of `inside` supported by Quartus?

taichi-ishitani, 2024-07-05:
The `inside` operator is also unsupported.
https://www.intel.com/content/www/us/en/programmable/quartushelp/current/index.htm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

YSawc, 2024-07-05:
As a taichi-shitani said `inside` operators not supported.

generated.sv
```
    Status         status;
    typedef enum logic  [3-1:0] {
        Status_Ready,
        Status_ReadTargetLowAddr,
        Status_ReadTargetHighAddr,
...
        Status_Finish
    } Status;
...
            if (status inside {Status_Ready} ) begin
                ...
            end else begin
                ...
            end
```

build error message here.
```
Error (10170): ... near text: "inside";  expecting ")". Check for and fix any syntax errors that appear immediately before or at the specified keyword. The Intel FPGA Knowledge Database contains many articles with specific details on how to resolve this error. Visit the Knowledge Database at https://www.altera.com/support/support-resources/knowledge-base/search.html and search for this specific error message number.
```

Inside expression is not supported yet in quartus, so instead of `inside`, conditional operation works fine.
```
if (status >= Status_Ready && status <= Status_ReadTargetHighAddr ) begin
  if_register.a <= 0;
end else begin
  if_register.a <= 1;
end
```

In case of using inside, can it cover with like above range expression instead of `inside` ?
Or if another better solution exists, please tell me, thank.

taichi-ishitani, 2024-07-05:
refs: #145

taichi-ishitani, 2024-07-05:
How about emitting `case` statement instead of `case inside` statement if all case condition expressions do not include range expression and unknown values?

YSawc, 2024-07-06:
It sounds good.

nathsou, 2024-07-24:
Hi, running a cocotb testbench with iverilog on a module with a `case inside` also fails.

taichi-ishitani, 2024-08-13:
I think this issue is fixed by #873.

Closed 2024-08-15.

Thread 823 (2024-07-22):

Register initialization

nathsou, 2024-07-22:
Hi, thanks for the good work!

Maybe I missed something, but I couldn't find an example of how to initialize a register value:

```veryl
pub module RegisterFile (
  i_clk: input clock,
) {
  var regs: logic<16>[8];

  initial {
    regs[0] = '0;
  }
}
```

Fails with:

```
Error: invalid_statement (link)

  × assignment statement can't be placed at here
   ╭─[/home/nathan/code/fpga/cpu16/design/src/RegisterFile.veryl:7:13]
 6 │   initial {
 7 │     regs[0] = '0;
   ·             ┬
   ·             ╰── Error location
 8 │   }
   ╰────
  help: remove assignment statement
  ```

  I also tried ```var reg: logic<1> = 1'b1;``` but this also fails.

  Is there a way to achieve this already?

nblei, 2024-07-23:
You initialize registers via reset.

```systemverilog
always_ff {
  if_reset {
    regs[0] = '0;
  } else {
   ...
  }
}
```

nathsou, 2024-07-23:
Thanks @nblei for your quick reply, while this indeed works, using a reset signal does not seem behaviorally equivalent as we need to introduce an input reset signal in the module ports and assert it high at startup.

Is this a desired design decision? I guess this is not a bad thing since it means that the design can easily be ported to devices without initialization capabilities like ASICs.

Although initialization with `$readmemb` and `$readmemh` seems to work fine, so this does not seem to be the case:

```Veryl
  var regs: logic<16>[8];

  initial {
    $readmemh("regs.hex", r_regs);
  }
  ```

nblei, 2024-07-23:
Veryl is a hardware description language --- not a simulation language.   As flops take random values on power-on, initializing them in an `initial` procedural block does not make sense.

$readmemh "works" because SystemVerilog system functions get transpiled literally.

nathsou, 2024-07-23:
I'm not at all an expert but initial blocks are not just used for simulation, some FPGAs do support flip-flop initialization, I have for instance used `$readmemh` to initialize a block RAM with a simple image and when actually programmed onto a Xilinx 7 FPGA in this case, the image did appear so the flip flops were in the correct startup state without relying on a reset signal.

Anyway the proposed solution does work although it's a workaround, so I'm closing this issue.

nblei, 2024-07-23:
>I have for instance used $readmemh to initialize a block RAM with a simple image and when actually programmed onto a Xilinx 7 FPGA in this case

FPGA BRAM is implemented as SRAMs, not flops.

nathsou, 2024-07-23:
Makes sense

punzik, 2024-11-09:
> Veryl is a hardware description language --- not a simulation language. As flops take random values on power-on, initializing them in an `initial` procedural block does not make sense.

In most FPGAs, the initial state of the triggers is determined by the configuration bitstream. Therefore, the initial initialization is successfully synthesized for the FPGA. This is convenient when, for example, there is no external reset signal.
I think it would be right to add the possibility of initial initialization in Veryl.

dalance, 2024-11-11:
I agree that this use case is common in FPGA. But I think allowing this feature unconditionally is not good. This is because ASIC synthesizers (possibly few FPGA synthesizer too?) ignore `initial` statement.
Now `readmemh` is allowed, but it is because assignment by function call is not checked yet. So I think it should be checked in future, and the way which allows this feature explicitly should be provided for FPGA usage.

punzik, 2024-11-11:
@dalance, thanks for the reply. One solution is to create a Verilog module with a register and necessary initialization. It is only need to tell the module about clock polarity and reset type. Is it possible as I know?

dalance, 2024-11-12:
By following code, clock polarity and reset type which Verilog module receives can be specified.
Veryl compiler inserts `~` if polarity inversion is required at casting.

```systemverilog
module Module (
    i_clk: input clock,
    i_rst: input reset,
) {
    let w_clk: `_ clock_posedge    = i_clk as clock_posedge;
    let w_rst:    reset_async_high = i_rst as reset_async_high;

    inst u: $sv::ModuleSv (
        i_clk: w_clk,
        i_rst: w_rst,
    );
}
```

taichi-ishitani, 2025-03-02:
How about emitting `if_reset` statement into `initial` statement?

Veryl

```systemverilog
always_ff {
  if_reset {
    regs[0] = '0;
  } else {
    // do something
  }
}
```

SV

```systemverilog
initial begin
  regs[0] = '0;
end

always @(posedge i_clk) begin
  // do something
end
```

dalance, 2025-03-04:
I imagine FPGA users want to use `readmemh` to initialize ROM.
So keeping to separate `initial` and `if_reset` may be better.

taichi-ishitani, 2025-03-27:
> I imagine FPGA users want to use `readmemh` to initialize ROM. So keeping to separate `initial` and `if_reset` may be better.

I think initializing an array from file input is useful for ASIC development.
How about adding functions similar to `$readmemh` and `$readmemb` functions and emitting an array literal from the file input given to the such functions?

Veryl

```systemverilog
always_ff {
  if_reset {
    regs = readmemh("fw.hex");
  } else {
    ...
  }
}
```

For ASIC

```systemverilog
always_ff @(posedge i_clk, negedge i_rst_n) begin
  if (!i_rst_n) begin
    regs = '{'h00, 'h01, ...};
  end else begin

  end
end
```

For FPGA

```systemverilog
initial begin
  $readmemh(regs, "fw.hex");
end

always @(posedge i_clk) begin
  ...
end
```

dalance, 2025-04-18:
I think embedding the contents to SV is not good.
This is because "fw.hex" can be changed after Veryl compilation.
It causes mismatch between ASIC and FPGA, and it is difficult to find it.

nblei, 2025-04-24:
These
```
always_ff @(posedge i_clk, negedge i_rst_n) begin
  if (!i_rst_n) begin
    regs = '{'h00, 'h01, ...};
  end else begin

  end
end
```
initial begin
  $readmemh(regs, "fw.hex");
end

always @(posedge i_clk) begin
  ...
end
```
have very different semantics.

ROMs in ASICs can be implemented in several ways, including mask ROMs, EEPROMs, and in random logic.  The only ROM whose data would ever be described in synthesizable RTL is a logic ROM.  For these, there could be a new functionality added, something like:

```SystemVerilog
 #[generate_rom(LittleEndianOctet)]
let rom: logic<32> [256] = VerylReadMem(file.hex);
```

which would translate to
```SystemVerilog
logic [31:0] rom [256];
assign rom[0] = <first word in file.hex>;
assign rom[1] = <second word file.hex>;
// etc
```

This would be in line with Veryl's generics to support RTL generation.

Thread 866 (2024-08-08):

Bounded generic parameter

dalance, 2024-08-08:
Generic parameter doesn't have any constraint.
So user of the defined generics don't know which value is acceptable as generic parameter.

```systemverilog
module ModuleA {
    inst u: GenericModule::<X /* X is ok??? */> (
    };
}
```

Additionally, giving wrong value as generic parameter causes complex error.

To resolve this issue, many programming languages introduce bounded generic parameter.

* Rust: trait bound
* C++: concept
* Java: bounded type parameter

dalance, 2024-08-22:
Generic parameters can be classified into the following patterns.

* constant value like `1`, `"hello"`, and parameter `N`
* user defined type
* non-type item like module, interface, package, and function

So the following should be required as parameter bound.

* `const`
* `type`
* Named prototype
  * Prototype module
  * Prototype interface
  * Prototype package
  * Prototype function

Prototype means that the public interface of the item is only defined.
For example, the public interface of module is parameter and port.

The syntax idea is below:

## `const`

```systemverilog
function FuncA::<N: const> (
    a: input logic<N>,
) -> logic {
}
```

## `type`

```systemverilog
struct StructA::<T: type> {
    a: T,
}
```

## Named prototype

To declare prototype, `proto` keyword is introduced.
Prototype doesn't affect code generation, it is used for checking generic parameter bound and generating document only.

### Prototype module

Prototype module has only parameter and port definition.

```systemverilog
proto module ProtoA #(
    param X: u32,
) (
    clk: input clock,
);

module ModuleA::<T: ProtoA> {
    inst u: T #(
        X: 1,
    ) (
        clk: 1,
    );
}
```

### Prototype interface and prototype function

Prototype interface is almost same as normal interface except for having prototype function.
Prototype function has arguments and return type only.

```systemverilog
proto interface ProtoA #(
    param X: u32,
) {
    var a: logic;

    modport A {
        a: input,
    }

    proto function FuncA (
        x: input logic,
    ) -> logic;
}

module ModuleA::<T: ProtoA> {
    inst u: T #(
        X: 1,
    );
}
```

### Prototype package

Prototype package is almost same as normal package except for having prototype function.

```systemverilog
proto package ProtoA {
    local A: u32 = 1;

    proto function FuncA (
        x: input logic,
    ) -> logic;
}

module ModuleA::<T: ProtoA> {
    let x: u32 = T::A;
}
```

dalance, 2024-08-27:
Small adjustments of proto interface and package syntax.

* value-less `local`
* `proto` of `function` is not required

Default implementation of `local` and `function` will not be supported yet at first.

```systemverilog
proto package ProtoA {
    local A: u32;

    function FuncA (
        x: input logic,
    ) -> logic;
}
```

Syntax of prototype implementation is like below:
This is from trait impl syntax (`impl X for Y`) of Rust.

```systemverilog
module ModuleA for ProtoA #(
) (
) {}
```

dalance, 2024-08-27:
The necessity of proto interface and package is not clear, but the syntax is more complex than proto module.
The existing parameter override may cover the use case.

So in this PR, adding proto module only.

dalance, 2024-09-13:
I created #963.

Closed 2024-08-28.

Thread 885 (2024-08-15):

Forbid continuous casting

dalance, 2024-08-15:
Casting by `as` can be continous like below:

```systemverilog
assign a = x as u32 as i32 as f32;
```
This behaviour causes syntax complexity, and difficulty to implement  clock and reset cast #709 especially.
On the other hand, there is not use case of continuous casting.
So I think forbidding continuous casting is reasonable.

If continuous casting is required, the following can be still used:

```systemverilog
assign a = ((x as u32) as i32) as f32;
```

Closed 2024-08-15.

Thread 919 (2024-08-30):

`let` declaration in case item witout block

taichi-ishitani, 2024-08-30:
Currently, a `let` declaration in a case item without block like below can be parsed and veryl report a `latch generation` error.

```
// module definition
module ModuleA (
    i_sel : input  logic    
) {
  always_comb {
    case i_sel {
      0: let _a:logic = i_sel;
      1: let _b:logic = i_sel;
    }
  }
}
```

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

This kind of code is meaningless and the error message is confusable.
Therefore, I think Veryl should report a parse error for this kind of code.

nblei, 2024-09-01:
This also occurs in if statements.

taichi-ishitani, 2024-09-01:
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

Yes, this error message is unclear.
So Veryl should report error for a statement block without statements.

nblei, 2024-09-01:
Ignoring the scoping aspect of this for a moment, this issue stems from a lack of symbolic execution or other code coverage mechanism.   If Veryl does not have a mechanism by which to symbolically evaluate conditionals, how can it know that a latch is not inferred?  Currently, it is just checking syntactically --- `d` is assigned in the `if` block, but not in the `else` block or in an outer scope.

So it seems that there are a number of options:

1. remove latch checks.
2. change the warning to something lighter like "it may cause latch generation".
3. implement some form of coverage checking.

My vote would be for '2' now and sometime in the future, '3'.

The scoping question is also interesting, though.  Can you even define a variable in an inner scope in a SystemVerilog procedural block?

taichi-ishitani, 2024-09-01:
After merging #921, Veryl will not report the latch generation error for a variable declared in a statement block. See the unit test code below.

https://github.com/veryl-lang/veryl/blob/d1177bbcd10eabc31843784cf4b3fd199c3e1f54/crates/analyzer/src/tests.rs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

taichi-ishitani, 2024-09-02:
Should Veryl emit a variable declaration within a statement block as an `automatic` variable?

Closed 2024-09-02.

Thread 926 (2024-09-02):

Empty statement block

taichi-ishitani, 2024-09-02:
Currently, Veryl reports the `unused variable` error for a statement block including var declarations but no statements (refs: https://github.com/veryl-lang/veryl/issues/919#issuecomment-2323346711). In addition, Veryl reports no errors for an empty statement block.

Should Veryl report the `empty statement block` error for these cases?

dalance, 2024-09-03:
I don't have any idea about a special reason of reporting empty statement block as error.
How do you think?

taichi-ishitani, 2024-09-03:
I think the `unused_variable` error for the statement block including variable declarations only is enough.
This is the current implementation.

@nblei ,
What do you think about this topic?

nblei, 2024-09-03:
@taichi-ishitani is there any practical use case for an empty statement block?

dalance, 2024-09-03:
I think there is no intentional use case, but it temporally occur by comment-out during implementing or debugging.

```systemverilog
always_ff {
    if a {
        //x = 0;
    } else if b {
        x = 1;
    }
}
```

So I think warning is better than error.

taichi-ishitani, 2024-09-03:
I use an empty block with case statement.

```systemverilog
case (foo)
  A: do_a_action();
  B: do_b_action();
  C: ; // nothing to do
  default: do_default_action();
endcase
```

If am empty block is forbidden I need to re-write above code like below.

```systemverilog
case (foo)
  A: do_a_action();
  B: do_b_action();
  default: begin
    if (foo != C) begin
      do_default_action();
    end
  end
endcase
```

There is a case that an empty block can help to reduce block nest depth.

Closed 2024-09-30.

Thread 931 (2024-09-03):

Check combinational loop

taichi-ishitani, 2024-09-03:
Combinational loop should be resolved but Veryl does not check it.

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

nblei, 2024-11-01:
How general should combinational loop checking be?

Should veryl compiler fully elaborate and flatten the design, including all generate blocks, to identify combinational loops?

How do inout ports get handled?

This is a very big task, I think.  But also a useful one.  It would be very cool to see combinational loop detection via language server.

taichi-ishitani, 2024-11-01:
> Should veryl compiler fully elaborate and flatten the design, including all generate blocks, to identify combinational loops?

Veryl compiler is a just transpiler so it's difficult to check combinational loops including paths crossing module boundaries as you mention.
I'm implementing feature to track all of assignments and references in PR #1036. I think we can trace combinational paths not crossing a module boundary by using this feature.

nblei, 2024-11-03:
Within module would still require complexities for generate blocks.

For example,

```systemverilog
assign v[0] = v[31];
for i in 1..32 {
  assign v[i] = v[i-1];
}
```
contains a combinational loop.

Thread 933 (2024-09-03):

Named block inside `generate` declaration

taichi-ishitani, 2024-09-03:
SystemVerilog has no syntax for simple generate block like below.

```systemverilog
generate
  begin : g_foo
    logic foo;
  end
endgenerate
```

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

So Veryl should emit any named blocks with `if (1)` header but a named block inside a `if`/`for` generate block does not start with `if (1)` header.

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

Closed 2024-09-05.

Thread 937 (2024-09-04):

Add `unique`, `unique0`, and `priority` keywords

nblei, 2024-09-04:
Consider
```systemverilog
module test (
	input [2:0] onehot,
	output logic [1:0] idx
);
always_comb begin
	case (onehot)
		3'b001: idx = 2'b01;
		3'b010: idx = 2'b10;
		3'b100: idx = 2'b11;
	endcase
end
endmodule : test
```
Synthesizing this with `dc_shell` results in inferred latches (ignore for a moment the fact that DC doesn't error out when latches are inferred in an `always_comb` block) because only three out of eight possible mux selects are handled in the switch statement.
This can be fixed by adding a default case, or by adding a default assignment prior to the switch statement.  However, this infers unnecessary logic when we are guaranteed the external controllability constraint that `onehot` is, in fact, one-hot.

However, adding the `unique` keyword solves this problem optimally:
```systemverilog
	unique case (onehot)
		3'b001: idx = 2'b01;
		3'b010: idx = 2'b10;
		3'b100: idx = 2'b11;
	endcase
```
The `unique case` is a mechanism for the RTL designer to encode controllability constraints.  It encodes the designer's guarantee to the synthesis tool / simulator / model checker that for each evaluation of the switch control signal, exactly one case in the switch statement will match.  Similarly, `unique` can be used to qualify `if-else if*-else` statements.

Other SV2009 keywords `unique0` and `priority` also modify the semantics of control statements.

taichi-ishitani, 2024-09-04:
`Switch` statement can also have these modifiers.

----

A synthesis tool can make very aggressive optimization for a case/if statement with `unique` modifier and this optimization may cause simulation/synthesis result mismatch when multiple conditions are matches.To prevent mismatch, our company has a lint rule to prohibit using `unique` modifier.
Thefore, I think we need to add a build option to prohibit these modifiers.

dalance, 2024-09-05:
At the point of view of syntax complexity, adding `#[cond_type]` attribute instead of adding keywords may be better.

```systemverilog
#[cond_type(unique)]
case a {
}

#[cond_type(priority)]
case a {
}

#[cond_type(unique0)]
if a {
} else if b {
} else {
}
```

About condition overlapping, mismatch between simulation and synthsis can be avoided if these modifiers are allowed when all conditions can be checked by Veryl compiler statilcally.

```systemverilog
param X: u32 = 1;
const Y: u32 = 1;

// OK
#[cond_type(unique0)]
case a {
    0: x = 1;
    Y: x = 2;
}

// NG because X may be overridden
#[cond_type(unique0)]
case a {
    X: x = 1;
}
```

taichi-ishitani, 2024-09-05:
> About condition overlapping, mismatch between simulation and synthsis can be avoided if these modifiers are allowed when all conditions can be checked by Veryl compiler statilcally.

I think Veryl also needs to check that all possible values for the case condition expression are listed as case items.

nblei, 2024-09-05:
There should not be a mismatch between synthesis and simulation in the sense that simulation will emit an error (or perhaps warning, I forget) in the case that no cases match, or more than a single case matches.

I do like the idea of a compiler switch which automatically removes the non-priority `cond_type` qualifiers.

I do not see how Veryl can possibly be expected to check condition overlapping.

Consider a microprocessor design which purposely does not check for illegal instructions (e.g., a microcontroller executing firmware embedded in an SoC).  A mux may only need to handle valid opcodes, but how is Veryl to know this?  In the presence of _external_ controllability don't cares, I think static analysis in Veryl is insufficient.

dalance, 2024-09-09:
> I do not see how Veryl can possibly be expected to check condition overlapping.

Yes. Veryl can't check overlapping in all cases.
So at the most safe side, there is an idea that these attribute can be used only when Veryl can check overlapping.
For example, if all case condition are numeric literal or const value refering literal, Veryl can check it.
I think these limitation may be acceptable.

nblei, 2024-09-09:
> So at the most safe side, there is an idea that these attribute can be used only when Veryl can check overlapping.

I think this is exactly the wrong approach.

If Veryl can check these conditions, then any logic synthesis tool will, also.

These modifiers exist explicitly to enable encoding of external controlability don't cares.  That is, they exist to be used precisely when logic synthesis tools (and thus Veryl) cannot check condition overlapping, condition uniqueness, etc.

dalance, 2024-09-10:
I understood like below. Is this right?

* When condition is static and overlapping check can be done by tools, synthesizer can optimize enough without these keywords.
* When these checking can't be done, designer notify the condition uniqueness to synthesizer through these keywords. This enables additional optimization which is impossible without these keywords.
* If there is any overlapping contrary to the keyword, mismatch between simulation and synthesis occurs. Designer is responsible for the condition ensurance.
* If these keywords are removed by compiler switch, mismatch doesn't occur, but some optimizations may be disabled.

nblei, 2024-09-10:
Yes on points 1, 2, 4.

Point 3, I disagree with the statement that there is mismatch between
simulation and synthesis.

In simulation, if `unique` is used and zero or more than 1 case match (or,
if zero or more than one if condition evaluates to true), then an
error/warning is emitted.
In simulation, if `unique0` is used and more than 1 case match (or, if more
than one if condition evaluates to true), then an error/warning is emitted.

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

--
Very Respectfully,

Nathaniel Bleier
***@***.***
773-531-8229 (Cell)

dalance, 2024-09-10:
I agree wrong usage of these keywords emits warning, but in many cases simulator works fine with warning messages.
(Of course, we can configure to promote some warnings to hard errors, but it is not default behavior.)
So if we miss these messages, I think mismatch occurs.

taichi-ishitani, 2024-09-10:
> I think we need to add a build option to remove these modifires during emitting SV RTL

Regarding this, we cannot remove these quarifiers automatically if no default item is specified.
If we remove `unique` keyword from nblei's exmaple below,

```systemverilog
always_comb begin
	case (onehot)
		3'b001: idx = 2'b01;
		3'b010: idx = 2'b10;
		3'b100: idx = 2'b11;
	endcase
end
```

synthesis tools will infer latch logic.
Therefore, I think we need to tell Veryl which case item is default item to make possible to remove qualifiers automatically and safely.

```systemverilog
always_comb {
  #[cond_type(unique)]
  case onehot {
    3'b001: idx = 1;
    3'b010: idx = 2;
    #[default]
    3'b100: idx = 3;
  }
}
```

taichi-ishitani, 2024-09-10:
We have to trust designer if RTL code including `unique case` works correctly.
Therefore, I think Veryl should report information message when `unique` quialifier is used.

dalance, 2024-09-12:
> We have to trust designer if RTL code including case/if statements with these quialifiers works correctly.
> Therefore, I think Veryl should report information message when quialifiers are used.

I think clean RTL should have no message because messages shown at all time will be ignored.
So how about the following designs?

* By default, `case_type` is ignored. If `emit_case_type = true` in `Veryl.toml`, it is emitted.
`emit_case_type = true` means that we understand risk of `case_type`, so the additional message is not required.

* By default, `case_type` is emitted and the additional message is shown.
After confirming safety of `case_type`, we set `suppress_case_type_message = true` in `Veryl.toml`, and the messages are suppressed.

taichi-ishitani, 2024-09-12:
I agree with this idea.
By the way, should Veryl support adding these quialifier to `if` statement?

nblei, 2024-09-12:
> By the way, should Veryl support adding these quialifier to if statement?

Yes.

taichi-ishitani, 2024-09-12:
> > By the way, should Veryl support adding these quialifier to if statement?
>
> Yes.

For if statement, how should we add `default` attribute?

nblei, 2024-09-12:
The trailing `else` branch can be the default automatically.

On Thu, Sep 12, 2024 at 9:09 AM Taichi Ishitani ***@***.***>
wrote:

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

--
Very Respectfully,

Nathaniel Bleier
***@***.***
773-531-8229 (Cell)

taichi-ishitani, 2024-09-12:
How about if statement without else branch like this?

```systemverilog
if onehot[0] {
  idx = 1;
} else if onehot[1] {
  idx = 2;
} else if onethot[2] {
  idx = 3;
}
```

nblei, 2024-09-12:
With unique it is semantically equivalent to the version where the last
block is unconditional.

Without unique, we can just default the last block to be unconditional.

On Thu, Sep 12, 2024, 6:38 PM Taichi Ishitani ***@***.***>
wrote:

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

taichi-ishitani, 2024-09-13:
OK, I agree.
I think the following SVA should be inserted to the default item for ease to report the designer that no case conditions are matched.

```systemverilog
case (onehot)
  3'b001: idx = 1;
  3'b010: idx = 2;
  default: begin
    assume (onhot == 3'b100)
    else $error("unexpected condtion is matched");
    idx = 3;
  end
endcase

if (onehot[0]) begin
  idx = 1;
end else if (onehot[1]) begin
  idx = 2;
end else begin
  assume (onhot == 3'b100)
  else $error("unexpected condtion is matched");
  idx = 3;
end
```

nblei, 2024-09-13:
That works with the caveat that it does not produce error on uniqueness violation.  So if more than one case or branch evaluates to true, no error or warning is emitted.  Perhaps this is fine, though.

dalance, 2024-10-26:
I'm trying to implement this feature. The current spec is below:

* Add attributes:
  * `#[cond_type(unique)]`
  * `#[cond_type(unique0)]`
  * `#[cond_type(priority)]`
  * `#[cond_type(none)]`

`none` is used to control nested case like below:

```systemverilog
always_comb {
  #[cond_type(unique)]
  case a {
    0: {
      #[cond_type(none)] // if there is not this attribute, "case b" is unique too.
      case b {
      }
    }
  }
}
```

* Add `emit_cond_type` config to `Veryl.toml`
If `emit_cond_type = true` is specified explicitly, `unique`, `unique0` and `priority` are emitted.
If not, they are not emitted, and the last case/if item becomes `default` to prevent unexpected latch generation.
`#[default]` attribute is not adopted because it requires reorder items, and it is difficult to add to if statement.

Closed 2024-11-13.

Thread 940 (2024-09-05):

`unused_variable` error for a variable referred as RHS only

taichi-ishitani, 2024-09-05:
Currently, Veryl does not report `unused_variable` error for a variable referred as RHS only like below.

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

Should Veryl report the error for this?

dalance, 2024-09-06:
I think this case should be reported as unused.

Thread 951 (2024-09-08):

interface cannot be used as Expression in InstPortItem with Identifier

nananapo, 2024-09-08:
```sv
interface If {
    var b : logic;
    modport master {
        b: input
    }
}

module Test (
    a : modport If::master
){}

module Top () {
    inst a : If;
    inst test : Test (
        a: a // error
        // a // <- ok
    );
}

```

```
 ]8;;https://doc.veryl-lang.org/book/07_appendix/02_semantic_error.html#invalid_factor \invalid_factor (link) ]8;; \

  💥 a of kind "instance" cannot be used as a factor in an expression
    ╭─[:15:12]
 14 │     inst test : Test (
 15 │         a: a // error
    ·            ┬
    ·            ╰── Error location
 16 │         // a // <- ok
    ╰────
  help: remove instance from expression
```

Closed 2024-09-09.

Thread 952 (2024-09-08):

Can't resolve type defined in package

nananapo, 2024-09-08:
eei.veryl
```sv
package eei {
    type Addr   = logic<32>;
}
```

membus_if.veryl
```sv
import eei::*;

interface membus_if {
    var addr  : Addr    ;
    // var addr  : eei::Addr    ; // <- OK
    modport master {
        addr  : output,
    }
}
```

core.veryl
```sv
import eei::*;

module core (
    ibus: modport membus_if::master,
) {
    let if_pc          : Addr  = 0;
    always_comb {
        ibus.addr  = if_pc;
    }
}
```

```
Error:   × veryl check failed

Error: undefined_identifier (link)

  × Addr is undefined
   ╭─[/home/kanataso/Documents/bluecore/sample/core.veryl:8:9]
 7 │     always_comb {
 8 │         ibus.addr  = if_pc;
   ·         ────┬────
   ·             ╰── Error location
 9 │     }
   ╰────
  help:
```

dalance, 2024-09-10:
This is because import is interpreted in `create_reference` handler.

* Pass1: create_symbol_table
* Pass2: create_reference (including import interpretation)

So if `core.veryl` is analyzed before `membus_if.veryl`, resolving `ibus.addr` reaches `Addr` in `membus_if.veryl`, but the `Addr` is not imported because import in `membus_if.veryl` is not interpreted yet, and the `Addr` causes `undefined_identifier` error.

To resolve this issue, import interpretation should be done before create_reference like below:

* Pass1: create_symbol_table
* Pass2: create_import
* Pass3: create_reference

dalance, 2024-09-11:
Adding new pass only for import handling is too heavy.
Instead of it, adding post_pass1 for import is better.

* Pass1: create_symbol_table with gathering import information
* PostPass1: apply gathered import information
* Pass2: create_reference (can refer complete import information)

nananapo, 2024-09-11:
thanks

Closed 2024-09-11.

Thread 961 (2024-09-12):

[Feature] Function with args of which type is interface

taichi-ishitani, 2024-09-12:
考えがちゃんとまとまっていないので、日本語で。

virtual function であれば関数の引数にすることとができるが、それでは RTL 中で使えない。

* 合成できるか不明
* `always_comb` とかで使う際に、イベントを推定できない(と思う)

Veryl 上で、interface を引数に取る関数を定義した場合、SV に出力する際に interface 中の各信号を引数に取る関数定義に書き換えてやればよい。

例えば、以下のようなコードの場合、

```systemverilog
interface foo_if::<W: const = 8> {
  var ready: logic;
  var valid: logic;
  var data : logic<W>;

  modport master {
    ready: input,
    valid: output,
    data:  output
  }

  modport slave {
    ready: output,
    valid: input,
    data:  input,
  }
}

function connect_foo_if (
    slave_if:  modport foo_if::<8>::slave,
    master_if: modport foo_if::<8>::master,
) {
  slave_if.ready  = master_if.ready;
  master_if.valid = slave_if.valid;
  master_if.data  = slave_if.data;
}

always_comb {
  connect_foo_if(slave_if, master_if);
}
```

出力はこのようなる。

```systemverilog
function void connect_foo_if (
  output logic         slave_if_ready,
  input  logic         slave_if_valid,
  input  logic [8-1:0] slave_if_data,
  input  logic         master_if_ready,
  output logic         master_if_valid,
  output logic [8-1:]  master_if_data
);
  // 省略
endfunction

always_comb begin
  connect_foo_if(slave_if.ready, slave_if.valid, slave_if.data, ..);
end
```

taichi-ishitani, 2024-09-12:
引数を展開する際に、幅を決める必要があるので、interface がパラメータを取る場合は、関数定義の際にパラメータを指定してやる必要がある。
また、入出力を決めるために、modport の指定は必須で、素の interface は引数に取れない。

taichi-ishitani, 2025-04-24:
#1246 は、パラメータを持つ interface は対象外にしている。
ここでも、パラメータを持つ interface は対象外するのが良さそう。

Closed 2025-04-30.

Thread 964 (2024-09-13):

Can't use for loop variable in expression in if_reset statement

nananapo, 2024-09-13:
```sv
module main (
    clk: input clock,
    rst: input reset
)
{
    var r : logic<32,32>;
    always_ff{
        if_reset {
            for i : u32 in 0..32{
                r[i] = i;
            }
        }
    }
}
```

```
 ]8;;https://doc.veryl-lang.org/book/07_appendix/02_semantic_error.html#invalid_reset_non_elaborative \invalid_reset_non_elaborative (link) ]8;; \

  💥 Reset-value cannot be used because it is not evaluable at elaboration
  │ time
    ╭─[:9:24]
  8 │             for i: u32 in 0..32 {
  9 │                 r[i] = i;
    ·                        ┬
    ·                        ╰── Error location
 10 │             }
    ╰────
  help:
```

nblei, 2024-09-13:
I think we do not have a mechanism to identify that the `i`  is a loop value through a fixed-range loop.

In the meantime, nananapo, you can use a generate loop which contains an `always_ff` block.

taichi-ishitani, 2024-09-13:
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

`genvar` is also treated as a variable.
It should be constant value.

taichi-ishitani, 2024-09-25:
For SystemVerilog, following code causes elaboration error because operand of part selection must be constant.

```systemverilog
for (int i = 0;i < W;++i) begin
  a[i:0] = i;
end
```

I think Veryl should treat a loop variable as a variable except when it is referred as a reset value.

dalance, 2024-09-25:
> I think Veryl should treat a loop variable as a variable except when it is referred as a reset value.

I think this rule is bit difficult, and may introduce ambiguous edge cases in the future. "`genvar` is constant, and loop variable is variable" is simple and sufficient?

taichi-ishitani, 2024-09-25:
Instead of this, how about disabling reset valeu check?

dalance, 2024-09-27:
Even if the check is removed, `a[i:0]` issue still remains.
I think changing `genvar` to constant is correct at least, and it resolves this issue by generate loop.

taichi-ishitani, 2024-09-27:
I read before an article that reducing number of procedural blocks such as `always` block is good technique to improve simulation performance.
Therefore, I think it's better to process an array within one `always` block but not multiple `always` blocks using `generate for` loop.

dalance, 2024-09-27:
OK. I'll merge #974, but leave this issue.

taichi-ishitani, 2024-09-29:
> Even if the check is removed, a[i:0] issue still remains.

Regular variables also cause this error so we need to introduce an additional check.

taichi-ishitani, 2024-10-03:
> > Even if the check is removed, a[i:0] issue still remains.
>
> Regular variables also cause this error so we need to introduce an additional check. For this check, we can treat a loop variable as a regular variable and then don't need to treat it as a special variable.

I think this check can be done by #788.

dalance, 2024-10-03:
I think #788 is not so easy.
If `ConstantExpression: Expression` are added, how definition of `Select` is reasonable?
Probably the following is avaibable, but these many duplications occur whole syntax.

```
Select: LBracket Expression [ SelectOperator Expression ] RBracket;
ConstSelect: LBracket ConstExpression [ SelectOperator ConstExpression ] RBracket;
```

dalance, 2024-10-04:
I'm starting to feel that introducing`ConstExpression` is not so good idea.
The idea of `ConstExpression` means that whether expression is const or not can be determined syntactically.
Of course, sometimes it can be, but not always (e.g. reset value).
So the additional check for some `Expression` is reqruired even if `ConstExpression` is introduced.

I think inserting const check to `Expression` which is syntactically const is easy, and the place which is ambiguous is difficult regardless of introducing `ConstExpression`.
So I think `ConstExpression` doesn't has enough effect to reduce analyzer complexity.
Maybe inserting const check to each `Expression` is sufficient.

Closed 2024-10-22.

Thread 978 (2024-09-29):

resolve msb failed

nananapo, 2024-09-29:
```sv
package pkg {
    type typed = logic<32>;
}

module TopModule (
    t_port: input pkg::typed,
) {
    let t_let: pkg::typed = 0;
    initial {
        $display("%d", t_let[msb]); // ok
        $display("%d", t_port[msb]); // ng
    }
}
```
```
  💥 resolving msb is failed
    ╭─[:11:31]
 10 │         $display("%d", t_let[msb]); // ok
 11 │         $display("%d", t_port[msb]); // ng
    ·                               ─┬─
    ·                                ╰── Error location
 12 │     }
    ╰────
  help:
```

Closed 2024-09-30.

Thread 984 (2024-10-02):

Can generics parameter be used as actual parameter of generics?

nananapo, 2024-10-02:
Currently, generics parameter can't be used as actual parameter.
But I think generics parameter can resolve in this context.
Is this a bug, or intended behaviour?

```sv
module ModuleA::<TOP_PARAM: const> {
    struct STRUCT_TYPE::<WIDTH: const> {
        value: logic<WIDTH>,
    }
    var s1: STRUCT_TYPE::<32>       ; // ok
    var s2: STRUCT_TYPE::<TOP_PARAM>; // ng
}

module Top{
 inst a: ModuleA::<32>;
}
```
```
  💥 "TOP_PARAM" is expected to "enum or union or struct", but it is "generic
  │ parameter"
   ╭─[:6:27]
 5 │     var s1: STRUCT_TYPE::<32>       ; // ok
 6 │     var s2: STRUCT_TYPE::<TOP_PARAM>; // ng
   ·                           ────┬────
   ·                               ╰── Error location
 7 │ }
   ╰────
```

docs says
> Additionally, the actual parameters should be accessible at the position of the generics declaration. For example, module names can be used as actual parameters because it is accessible through the whole project. On the other hand, local parameters can’t be used as actual parameters in many cases. This is caused by that the local parameters is not accessible from the potision of the generics declaration.
>
> さらに、実パラメータはジェネリクス定義位置から参照できなければなりません。例えば、モジュール名はプロジェクト全体から参照できるので、実パラメータとして使用できます。一方、ローカルパラメータは多くの場合、実パラメータとして使用できません。これはローカルパラメータがジェネリクス定義位置からは参照できない場合に発生します。

Closed 2024-10-03.

Thread 987 (2024-10-03):

generic function with same parameter cause errror

nananapo, 2024-10-03:
```sv
module ModuleA {
    function FuncA::<T: const> (
        a: input logic<T>,
    ) -> logic<T> {
        return a + 1;
    }

    let _a: logic<10> = FuncA::<10>(1);
    let _b: logic<10> = FuncA::<10>(1);
}
```
```
 ]8;;https://doc.veryl-lang.org/book/07_appendix/02_semantic_error.html#invalid_factor \invalid_factor (link) ]8;; \

  💥 __FuncA__10 of kind "generic instance" cannot be used as a factor in
  │ an expression
    ╭─[:9:25]
  8 │     let _a: logic<10> = FuncA::<10>(1);
  9 │     let _b: logic<10> = FuncA::<10>(1);
    ·                         ──┬──
    ·                           ╰── Error location
 10 │ }
    ╰────
  help: remove generic instance from expression
 ]8;;https://doc.veryl-lang.org/book/07_appendix/02_semantic_error.html#call_non_function \call_non_function (link) ]8;; \

  💥 Calling non-function symbol "__FuncA__10" which has kind "generic
  │ instance"
    ╭─[:9:25]
  8 │     let _a: logic<10> = FuncA::<10>(1);
  9 │     let _b: logic<10> = FuncA::<10>(1);
    ·                         ──┬──
    ·                           ╰── Error location
 10 │ }
    ╰────
  help: remove call to non-function symbol
```

nananapo, 2024-10-04:
generic module/interface instantiation also failed😭
generic package is ok.

dalance, 2024-10-04:
By #993, function, module and interface are fixed.

Closed 2024-10-04.

Thread 992 (2024-10-04):

fmt of case statement/expression is incomplete

nananapo, 2024-10-04:
```sv
module ModuleA {
    let a: logic = case 0 {
        A: 0,
        B,
        C: 0,
        default: 0,
    };
}
```
↓ veryl fmt
```sv
module ModuleA {
    let a: logic = case 0 {
        A: 0,
        B, C   : 0,
        default: 0,
    };
}
```
↓ veryl fmt
```sv
module ModuleA {
    let a: logic = case 0 {
        A      : 0,
        B, C   : 0,
        default: 0,
    };
}
```

Thread 1004 (2024-10-10):

VSCode plugin compatibility problerm

captainliuy, 2024-10-10:
In my development environment, the newest version of VSCode I can install is 1.70.3. The veryl plugin does not support this version of VSCode. Is it possible for it to be backward compatible?

dalance, 2024-10-10:
The current supported version (`^1.74.0`) is meaningless, it is only a version at which I started to develop.
So I think the supported version can be decreased.

I don't know precise minimum required version of VSCode, but it probably is 1.51.0 according to
https://github.com/Microsoft/vscode-python/issues/15237 .

Closed 2024-10-10.

Thread 1005 (2024-10-10):

variable of generic interface instance is inaccessible

nananapo, 2024-10-10:
```sv
interface InterfaceA::<C: const> {
    var value: logic<C>;
    modport master {
        value: input,
    }
}

module Top(
    port_i : input InterfaceA::<2>,
    modport_i : input InterfaceA::<3>
) {
    inst inst_i: InterfaceA::<1>;

    always_comb {
        port_i.value = 0; // ok
        modport_i.value = 0; // ok
        inst_i.value = 0; // ng
    }
}
```

```
Error:   × veryl check failed

Error: unknown_member (link)

  × "inst_i" doesn't have member "value"
    ╭─[/home/kanataso/Documents/bluecore/aaa/main.veryl:17:9]
 16 │         modport_i.value = 0; // ok
 17 │         inst_i.value = 0; // ng
    ·         ──────┬─────
    ·               ╰── Error location
 18 │     }
    ╰────
  help:
```

taichi-ishitani, 2024-10-10:
An interface port cannot have port direction so Veryl should report an error for this code but does not.

```
    port_i : input InterfaceA::<2>,
    modport_i : input InterfaceA::<3>
```

This is another issue.

nananapo, 2024-10-10:
```sv
interface InterfaceA::<C: const> {
    var value: logic<C>;
    modport master {
        value: output,
    }
}

module Top(
    modport_i : modport InterfaceA::<3>::master
) {
    inst inst_i: InterfaceA::<1>;

    always_comb {
        modport_i.value = 0; // ok
        inst_i.value = 0; // ng
    }
}
```

fixed example code :(
error message is same

Closed 2024-10-10.

Thread 1022 (2024-10-20):

variable assignment in function is not checked

nananapo, 2024-10-20:
```sv
module ModuleA {
    var v1: u32;
    var v2: u32;

    function FunctionA (
        a: output u32,
        b: ref    u32,
    ) {
        a = 100;
        b = 1000;
    }

    always_comb {
        FunctionA(v1, v2);
    }
}
```

```
 ]8;;https://doc.veryl-lang.org/book/07_appendix/02_semantic_error.html#unassign_variable \unassign_variable (link) ]8;; \

  ⚠️ v1 is unassigned
   ╭─[:2:9]
 1 │ module ModuleA {
 2 │     var v1: u32;
   ·         ─┬
   ·          ╰── Error location
 3 │     var v2: u32;
   ╰────
  help:
 ]8;;https://doc.veryl-lang.org/book/07_appendix/02_semantic_error.html#unassign_variable \unassign_variable (link) ]8;; \

  ⚠️ v2 is unassigned
   ╭─[:3:9]
 2 │     var v1: u32;
 3 │     var v2: u32;
   ·         ─┬
   ·          ╰── Error location
 4 │
   ╰────
  help:
```

taichi-ishitani, 2024-12-16:
I'm working on it.

Closed 2024-12-18.

Thread 1028 (2024-10-22):

Refer variable which is not assigned yet

taichi-ishitani, 2024-10-22:
A variable should be assigned before it is referred to get correct simulation result.

```systemverilog
// OK
always_comb {
  a = 1;
  b = a;
}

// NG
always_comb {
  d = c;
  c = 1;
}
```

Veryl should report an error fo this kind of code but currently not.
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

nananapo, 2024-10-22:
Instead of reporting error, I think it's better to sort automatically by Veryl compiler. (or create option)
Reordering manually to make the simulation work correctly is only for simulation and is not a essential task.

nananapo, 2024-10-22:
hmm....
reordering maybe difficult when there are if or case in always_comb😞

Closed 2024-11-05.

Thread 1054 (2024-11-06):

Charactor wrapping modport items

taichi-ishitani, 2024-11-06:
Currently, modport items are wrapped by curly brackets.

```systemverilog
modport master {
  ready:   input,
  valid:   output,
  payload: output
}
```

On the other hand, port declarations are wrapped by parentheses.

```systemverilog
module foo (
  i_clk: input  clock,
  i_rst: input  reset,
  i_d:   input  logic,
  o_d:   output logic
) {}
```

Both of modport item and port declaration is to define a port. So I think `modport` items should be wrapped by parentheses to align with port declarations.

dalance, 2024-11-06:
I think modport is a composite data type definition like struct.
Additionally most of declarations have `{}` as a body.
So I think the usage of `{}` is consistent.

```systemverilog
modport A {}
struct A {}
always_comb {}
module A {}
interface A {}
```

taichi-ishitani, 2024-11-06:
OK, I understood.

Closed 2024-11-06.

Thread 1088 (2024-11-19):

Not check type mismatch between connected interface and port declaration

taichi-ishitani, 2024-11-19:
Currently, Veryl compiler does not check type of connected interface.
Following code includes type mismatch between connected interface and port declaration but no error is raised.

```systemverilog
interface foo_if {
  var a: logic;
  modport mp {
    a: output
  }
}

interface bar_if {
  var a: logic;
  modport mp {
    a: output
  }
}

module sub (
  foo: modport foo_if::mp
){
  assign foo.a = 0;
}

module top (
  o_a: output logic
) {
  inst bar: bar_if;
  inst u_sub: sub (foo: bar); // type mismatch

  assign o_a = bar.a;
}
```

dalance, 2024-11-19:
Related: #1017

Closed 2025-02-25.

Thread 1108 (2024-11-28):

Add option to force to emit all modules imported from dependent projects to filelist

taichi-ishitani, 2024-11-28:
Currenlty, the generated filelist does not include unused modules imported from dependent projects.
Therefore, user cannot use such modules in their SV modules.

To support such case, a new option to force emit all modules imported from dependent projects to the filelist is needed.

dalance, 2024-11-28:
I think some way to realize it.

* Add command line option to `veryl build`
* Add project config to `Veryl.toml`
  * This config affects to the current project only
  * This config affects to all dependent projects (If project A sets the config, all files of project A is emitted on project B which doesn't set the config)

Thread 1109 (2024-11-28):

Unknown member errror for generic interface

taichi-ishitani, 2024-11-28:
Currently, Veryl compiler will report an `unknown member error` when refering a variable via a generic interface port.

```systemverilog
module mod (
  bus_if: interface::mp
) {
  assign bus_if.a = 0;
}
```

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

We can know the given generic interface has the variable only when elabrating the generated SV so Veryl compiler should not check.

Closed 2024-12-02.

Thread 1113 (2024-12-01):

comment just after `default` breaks auto-format style

clkbug, 2024-12-01:
The comment after the `default` clause in the following code causes `veryl fmt` over-indentation

```systemverilog
module ModuleA {
    always_comb {
        case 0 {
            default: {} // this comment causes over-indentation
                 } // this brace is over-indented
    }
}
```

This seems to be a bug, since the indentation is not like this except `default` clause.

I have confirmed this formatting with version `65701ec2`(2024-11-29)

Closed 2024-12-02.

Thread 1126 (2024-12-07):

Self-reference in always_comb causes many warnings in other files

clkbug, 2024-12-07:
veryl version: 03146a08

```SystemVerilog
module a (
    x: output logic<32>,
) {
    always_comb {
        x = x; // this causes many warnings
    }
}
```

The followings are the first three warnings (actually 24 warnings):

```
Error:   × veryl check failed

Warning: unassign_variable (link)

  ⚠ x is unassigned
   ╭─[/tmp/bug/a.veryl:2:5]
 1 │ module a (
 2 │     x: output logic<32>,
   ·     ┬
   ·     ╰── Error location
 3 │ ) {
   ╰────
  help:
Warning: unassign_variable (link)

  ⚠ x is unassigned
   ╭─[/tmp/bug/a.veryl:1:16]
 1 │ import async_fifo_pkg::calc_default_depth;
   ·                ┬
   ·                ╰── Error location
 2 │
   ╰────
  help:
Warning: unassign_variable (link)

  ⚠ x is unassigned
   ╭─[/tmp/bug/a.veryl:1:16]
 1 │ package async_fifo_pkg {
   ·                ┬
   ·                ╰── Error location
 2 │     function calc_default_depth (
   ╰────
  help:
Warning: unassign_variable (link)

  ⚠ x is unassigned
   ╭─[/tmp/bug/a.veryl:1:16]
 1 │ module async_fifo_reset_sync::<S: synchronizer> #(
   ·                ┬
   ·                ╰── Error location
 2 │     param MERGE_RESET      : bit = '0,
   ╰────
  help:

```

taichi-ishitani, 2024-12-07:
x is not assigned so this is expected error.

Closed 2024-12-19.

Thread 1142 (2024-12-13):

resolving msb of struct member is failed

nananapo, 2024-12-13:
```sv
module TopModule {
    struct A {
        a: logic<6>,
    }
    let _a: A        = 0;
    let _b: logic<5> = _a.a[msb:1];
}
```

```
 ]8;;https://doc.veryl-lang.org/book/07_appendix/02_semantic_error.html#unknown_msb \unknown_msb (link) ]8;; \

  💥 resolving msb is failed
   ╭─[:6:29]
 5 │     let _a: A        = 0;
 6 │     let _b: logic<5> = _a.a[msb:1];
   ·                             ─┬─
   ·                              ╰── Error location
 7 │ }
   ╰────
  help:
```

taichi-ishitani, 2024-12-17:
Veryl should report `unknown msb` error for interface instance like below but does not.

```
    interface InterfaceA #(
        param W: u32: 2
    ){
        var a: logic<W>;
        modport mp {
            a: input
        }
    }
    module ModuleA {
        inst if_a: InterfaceA;
        let a: logic = if_a.a[msb];
    }
```

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

taichi-ishitani, 2024-12-17:
Veryl will generate illegal SV for the case where a struct is defied outside of the declaration scope like below.

Original Veryl
```systemverilog
package Package28A::<W: const> {
    struct StructA {
        a: logic<W>,
    }
}

package Package28B {
    const B: u32 = 2;
}

package Package28C {
    const W: u32    = 2;
    const C: bit<W> = 0;
}

module ModuleB {
    var a: Package28A::<Package28B::B>::StructA;
    assign a.a = 0;

    let _y: logic = a.a[msb];
    let _z: logic = Package28C::C[msb];
}
```

Generated SV
```systemverilog
package veryl_testcase___Package28A__Package28B_B;
    typedef struct packed {
        logic [veryl_testcase_Package28B::B-1:0] a;
    } StructA;
endpackage

package veryl_testcase_Package28B;
    localparam int unsigned B = 2;
endpackage

package veryl_testcase_Package28C;
    localparam int unsigned         W = 2;
    localparam bit          [W-1:0] C = 0;
endpackage

module veryl_testcase_ModuleB;
    veryl_testcase___Package28A__Package28B_B::StructA a  ;
    always_comb a.a = 0;

    logic _y;
    always_comb _y = a.a[(() - 1)]; // Width part is empty
    logic _z;
    always_comb _z = veryl_testcase_Package28C::C[((W) - 1)]; // W is not defined in this scope
endmodule
```

I think using `$bits` system function is better than evaluating the `expression`.

taichi-ishitani, 2024-12-17:
> I think using $bits system function is better than evaluating the expression like below.

`$bits` returns total amount of bits of the given type or expression so it is not suitable to get the array size.

```
logic [1:0][2:0][3:0] a;
$bits(a): 24
$bits(a[0]): 12
$bits(a[0][0]): 4
```

SV also supports `$size` system function which returns the array size.
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

DC, Vivado and also Verilator support this system function so we can use it to calcurate `msb` position.

taichi-ishitani, 2024-12-17:
> DC, Vivado and also Verilator support this system function so we can use it to calcurate msb position.

When this causes problems we need to calculate `msb` position from the variable declaration during emitting SV source files.

Closed 2024-12-19.

Thread 1146 (2024-12-14):

A false message appears when trying to assign to an input port

mikecat, 2024-12-14:
veryl 0.13.3

`Veryl.toml`:

```toml
[project]
name = "test"
version = "0.1.0"
```

`test.veryl`:

```text
module test (
    a: input logic,
    b: input logic,
    c: output logic,
) {
    always_comb {
        if (b) {
            c = a;
        } else {
            b = ~a; // oops
        }
    }
}
```

When I executed a command `veryl build` to process these files, this message appeared:

```text
Error:   × veryl check failed

Error: invalid_assignment (https://doc.veryl-lang.org/book/07_appendix/02_semantic_error.html#invalid_assignment)

  × b can't be assigned because it is port
    ┌─[/home/ubuntu/test_/test.veryl:10:13]
  9 │         } else {
 10 │             b = ~a; // oops
    ·             ┬
    ·             └── Error location
 11 │         }
    └────
  help: remove the assignment
```

The message "because it is port" is false.

It is reasonable that an **input** port `b` cannot be assigned, but an **output** port `c` can be assigned despite of being a port.

I think the message should be "because it is **an input** port" .

Closed 2024-12-19.

Thread 1166 (2024-12-26):

Re-order packages defined in the same file

taichi-ishitani, 2024-12-26:
Currently, Veryl compiler allows to refer a package before it is defined like below.

Veryl
```systemverilog
package PackageA {
  const A: u32 = PackageB::B;
}

package PackageB {
  const B: u32 = 0;
}
```

Generated SV
```systemverilog
package project_PackageA;
    localparam int unsigned A = project_PackageB::B;
endpackage

package project_PackageB;
    localparam int unsigned B = 0;
endpackage
//# sourceMappingURL=input.sv.map
```

However, the generated SV cannot be compiled because SV requires to define a package before it is referred.

```
Error-[SV-EEM-SRE] Scope resolution error
testbench.sv, 4
project_PackageA, "project_PackageB::B"
  Target for scope resolution operator does not exist. Token
  'project_PackageB' is not a class/package.  Originating module
  'project_PackageA'.
  Check that class or package exists with referred token as the name.
```

Veryl should emit packages defined in the same file in reference order to avoid this error.

taichi-ishitani, 2024-12-27:
I talked this with @dalance. He is worried about position of emitted comments.
Therefore, we decided that Veryl compiler should raise an error for this case.

Closed 2024-12-28.

Thread 1167 (2024-12-26):

Circular reference between packages

taichi-ishitani, 2024-12-26:
Currently, Veryl compiler raises no error for a circular reference between packages like below even though generated SV code from this Veryl code is illegal.

```systemverilog
package PackageA {
  const A_0: u32 = PackageB::B_0;
  const A_1: u32 = 1;
}

package PackageB {
  const B_0: u32 = 0;
  const B_1: u32 = PackageA::A_1;
}
```

taichi-ishitani, 2024-12-26:
Latest codebase (1bff7d0a4b03bbe401550d29b4d63c982e8f9bd9) reports `CyclicTypeDependency` error for this code.
I will close this issue.

Closed 2024-12-26.

Thread 1205 (2025-01-17):

Dependency specification without version constraint

taichi-ishitani, 2025-01-17:
In case of specifying dependencies on local storage, such dependencies may be under development and version control is not suitable for them.
I think it would be nice to allow to specify such dependencies without version constraint and import existing source files in the dependencies as is.

dalance, 2025-01-17:
I thought an actual workflow like below:

* develop a project using local path dependency
* publish the dependency project by new version
* publish the project by new version

In this case, both local path and version is required.
So the following specification is probably reasonable.

```toml
[dependencies]
"https://github.com/veryl-lang/sample" = { version = "0.1.0", path = "../../sample" }
```

This means "If `path` exists, it is used as is, and if not, `version` is used from the source repository".

dalance, 2025-01-20:
I implemented this feature at #1206.
Now the following path specification can be used.

```
[dependencies]
"https://github.com/veryl-lang/sample" = { version = "0.1.0", path = "../../sample" }
"../../sample"                         = { version = "0.1.0", path = "../../sample" }
```

In this PR, there are the following restrictions:

* left-hand side URL/path is mandatory. It should be valid git repository.
* `version` is mandatory. It should be published.

These restrictions are required to keep consistency with the existing lockfile system.
How about it?

Closed 2025-01-23.

Thread 1224 (2025-02-04):

[Bug] Module is marked as duplicated after moving the source file

Hamster5295, 2025-02-04:
Hello,
I'm currently using Veryl Language Server with Veryly VSCode extension.

It occurred that after moving a source file from a directory to another, the module and all its members (the `logic`s and `const`s) are marked as duplicated.  `Semantic Error: ModuleA is duplicated` as an instance.

These errors are gone after executing `vscode-veryl: Restart Language Server`.

I'm working on VSCode with Veryl extension version `0.13.5`.
My system is Windows 11 24H2.

Hamster5295, 2025-02-04:
Deleting the source file of `ModuleA` then create another file in different directory with another module named `ModuleA` also triggers it.

dalance, 2025-02-05:
Thank you for your report!
Now Veryl VSCode extension doesn't support to handle file operation like rename and delete.
I'll try to add it.

Hamster5295, 2025-02-05:
I'm currently working on it, trying to register `did_rename_file` events for language server and remove the old file uri from `veryl_analyser::symbol_table` and `veryl_analyzer::namespace_table` when rename operations occur. However, it failed to solve the bug.

My code goes like this:
```rust
/**
* server.rs
*/

// this function is called when backend.rs send a message in did_rename_file callback, removing the old file url
// through logging the `drop` function is guaranteed to have been executed, and the path is correct.
// However, this does not fix the case.
// Is there somewhere else that's adding those symbols to the table, or I might have misunderstood the whole logic?
fn on_remove(&mut self, path: String) {
    if let Ok(url) = Url::from_str(&path) {
        if let Ok(path) = url.to_file_path() {
            if let Some(path) =
                resource_table::get_path_id(Path::new(&path).to_path_buf())
            {
                symbol_table::drop(path);
                namespace_table::drop(path);
            }
        }
    }
}
```

dalance, 2025-02-05:
It is just a code which I imaged.
If you want to handle `did_rename_file`, not only dropping old path but also adding new path is probably necessary.

The following code may be helpful to add new path.

https://github.com/veryl-lang/veryl/blob/eddc363e7b9d7604714e215454d263c3a1db4444/crates/languageserver/src/server.rs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

Hamster5295, 2025-02-05:
get it, I'll try later 🐱

Hamster5295, 2025-02-05:
Unfortunately, it doesn't solve the case.

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
As is shown above the `did_open` triggers right before `did_rename`, which has already dispatched a background task for analyzing.
From the output it can be figured out that the correct path of the renamed file was passed to the task when `did_open` is triggered.
Thus, after adding the code above when `did_rename` is triggered, the same code base is analyzed again, while the bug persists.

```txt
[Info  - 17:47:56] did_open
[Info  - 17:47:56] did_rename

...Analysis of dependencies...

[Info  - 17:47:56] background_analyze: \\?\E:\path\to\my\testing\project\top.veryl

...Analysis of dependencies...

[Info  - 17:47:56] background_analyze: \\?\E:\path\to\my\testing\project\top.veryl
```

Maybe it's time to dig deeper into the analyzer...

Hamster5295, 2025-02-05:
I've pushed my current modifications to my fork of veryl. Check it out if you need further information and testing :D
[server.rs](https://github.com/Hamster5295/veryl/blob/master/crates/languageserver/src/server.rs)

dalance, 2025-02-05:
How about using [will_rename_files](https://docs.rs/tower-lsp/latest/tower_lsp/trait.LanguageServer.html#method.will_rename_files)?
It seems to be sent before the actual renaming, so I image the following sequence.

will_rename_files
drop old_file
did_open
analyze new_file
did_rename

If there is the case that did_open is not sent, analyze new_file after did_rename may be necessary.

Hamster5295, 2025-02-05:
> How about using [will_rename_files](https://docs.rs/tower-lsp/latest/tower_lsp/trait.LanguageServer.html#method.will_rename_files)? It seems to be sent before the actual renaming, so I image the following sequence.

It worked out great! I'll work on to clean up and do some further testings.

Hamster5295, 2025-02-05:
> If there is the case that did_open is not sent, analyze new_file after did_rename may be necessary.

Indeed, but it seems that `metadata.paths::<&str>(&[], true)` still gets the paths after renaming.
```txt
[Info  - 20:21:00] did_rename
[Info  - 20:21:00] Symbols from e\path\to\my\test\project\src\top2.veryl are dropped!

......

[Info  - 20:21:00] background_analyze: e\path\to\my\test\project\src\top.veryl
```

This might be an undefined behaviour however, as my `will_rename_files` goes like:
```rust
    async fn will_rename_files(&self, params: RenameFilesParams) -> Result<Option<WorkspaceEdit>> {
        self.client
            .log_message(MessageType::INFO, "will_rename_files")
            .await;

        for file in params.files {
            self.send(MsgToServer::WillRenameFile {
                old_url: file.old_uri,
                new_url: file.new_uri,
            })
            .await;
        }
        Ok(None)
    }
```
which is likely to introduces a race condition between our `server.rs` and VSCode Language Server Host.
I'll explicitly dispatch a new background analyze task at `did_rename_files` to avoid that.

Closed 2025-02-06.

Thread 1321 (2025-03-03):

Mangled enum members can be used unexpectedly

dalance, 2025-03-03:
Checking the following code is success, but it causes emitter panic.
This is because `EnumA_X` is added to symbol table to detect conflict between mangled names and user defined identifiers.
This case should be reported as error.

```systemverilog
enum EnumA {
    X,
}

let a: logic = EnumA_X;
```

Closed 2025-03-04.

Thread 1328 (2025-03-04):

msb generates $size call with wrong identifier.

ciniml, 2025-03-04:
対象バージョン: 0.14.0

再現コード (msb_bug.veryl)

```veryl
pub module msb_bug () {
    var buffer_head: logic<2>;
    var buffer_tail: logic<2>;
    var buffer_full: logic;
    var buffer_full_2: logic;
    assign buffer_full = buffer_head[msb-1:0] == buffer_tail[msb-1:0] && buffer_head[msb] != buffer_tail[msb];
    assign buffer_full_2 = buffer_head[1:lsb] == buffer_tail[1:lsb];
}
```

`veryl build` で変換すると以下のSystemVerilogが生成されます。

```systemverilog
module probe_msb_bug ();
    logic [2-1:0] buffer_head  ;
    logic [2-1:0] buffer_tail  ;
    logic         buffer_full  ;
    logic         buffer_full_2;
    always_comb buffer_full   = buffer_head[($size(buffer_headbuffer_head, 1) - 1) - 1:0] == buffer_tail[($size(buffer_tailbuffer_tail, 1) - 1) - 1:0] && buffer_head[($size(buffer_headbuffer_head, 1) - 1)] != buffer_tail[($size(buffer_tailbuffer_tail, 1) - 1)];
    always_comb buffer_full_2 = buffer_head[1:0] == buffer_tail[1:0];
endmodule
//# sourceMappingURL=msb_bug.sv.map
```

`msb` に対応する `$size()` の呼び出しに指定される識別子が、 `hoge[msb]` に対して `hoge[$size(hoge, 1)]` になるはずが、 `hoge[$size(hogehoge, 1)]` になってしまうようです。

どうも `crates/emitter/src/emitter.rs`  の `push_resolved_identifier` が同じ識別子の文字列で2回呼び出されるのが原因のようだったので

```rust
    fn push_resolved_identifier(&mut self, x: &str) {
        if let Some(identifier) = self.resolved_identifier.last_mut() {
            assert_ne!(identifier, x);
            identifier.push_str(x);
        }
    }
```

としてみたところ、どうも `ScopedIdentifier` の呼び出しの時点で2回目がpushされることがわかりました。

https://github.com/veryl-lang/veryl/blob/8c3c7a2ea71284f260d4f5192e5063fb7df0914b/crates/emitter/src/emitter.rs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

そこでもう少しログ出力を追加して確認したところ、どうもそもそも `ScopedIdentifier` の子ノード？の `Identifier` で `push_resolved_identifier` が呼ばれたあとで、親ノードの `ScopedIdentifier` でも同様に `push_resolved_identifier` が呼ばれるため重複しているような挙動でした。

試しに `scoped_identifier` の `push_resolved_identifier` の呼び出しをコメントアウトしたところ、再現コードに関しては問題が起きなくなりましたが、修正方法がこれでよいのか確証が持てないでいます。

一度ご確認いただけますか？

dalance, 2025-03-05:
ありがとうございます。確認しました。

元々 https://github.com/veryl-lang/veryl/commit/ade2bd3571380bbb00a94367360f968c73281654 で `push_resolved_identifier` が導入された時点では

```rust
self.veryl_token(&arg.identifier().replace(&text));
self.push_resolved_identifier(&text);
```

となっていて `self.identifier` は呼ばれていなかったのですが、 https://github.com/veryl-lang/veryl/commit/a34bda5f54c75bfda8c1ed4944511adf256ed207 で `self.identifier` を呼ぶようにした結果 `push_resolved_identifier` が2回呼ばれるようになったようです。

ご指摘の通り、以下の2つは不要です。

https://github.com/veryl-lang/veryl/blob/8c3c7a2ea71284f260d4f5192e5063fb7df0914b/crates/emitter/src/emitter.rs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

https://github.com/veryl-lang/veryl/blob/8c3c7a2ea71284f260d4f5192e5063fb7df0914b/crates/emitter/src/emitter.rs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

`testcase/veryl/28_msblsb.veryl` のテストでも発生していたのですが、差分が多くて見落としていました…。

Closed 2025-03-05.

Thread 1337 (2025-03-05):

Build failure when veryl-parser is used in proc-macro

dalance, 2025-03-05:
The following crate is failed to build.

```Cargo.toml
[package]
name = "test"
version = "0.1.0"
edition = "2021"

[lib]
proc-macro = true

[dependencies]
veryl-parser = "0.14.1"
```

```
error: failed to run custom build command for `scnr v0.8.0`

Caused by:
  process didn't exit successfully: `/home/hatta/work/repos/playground/test97/target/debug/build/scnr-bd8da6f8917803f2/build-script-build` (exit status: 101)
  --- stderr

  thread 'main' panicked at /home/hatta/.cargo/registry/src/index.crates.io-1949cf8c6b5b557f/scnr-0.8.0/build.rs:6:9:
  The features `default` and `regex_automata` are mutually exclusive.
  note: run with `RUST_BACKTRACE=1` environment variable to display a backtrace
warning: build failed, waiting for other jobs to finish...
error: failed to run custom build command for `parol_runtime v2.2.1`

Caused by:
  process didn't exit successfully: `/home/hatta/work/repos/playground/test97/target/debug/build/parol_runtime-ee280bffdcbfbb3f/build-script-build` (exit status: 101)
  --- stderr

  thread 'main' panicked at /home/hatta/.cargo/registry/src/index.crates.io-1949cf8c6b5b557f/parol_runtime-2.2.1/build.rs:6:9:
  The features `default` and `regex_automata` are mutually exclusive.
  note: run with `RUST_BACKTRACE=1` environment variable to display a backtrace
```

In the proc-macro, both `dependencies` and `build-dependencies` are enabled, so `parol_runtime` with `regex_automata` from `dependencies` and `parol_runtime` with default features from `build-dependencies` are conflicted.

dalance, 2025-03-05:
@jsinger67

How do you think about this issue?
I already resolved it by adding `build` feature to disable parol of `build-dependencies`,
but fundamental solution may be adding feature for parol_runtime to parol like below:

```Cargo.toml
[dependencies]
parol_runtime = {version = "2.2", features = ["regex_automata"], default-features = false}

[build-dependencies]
# pass regex_automata to parol_runtime
parol = {version = "3.0", features = ["regex_automata"], default-features = false}
```

jsinger67, 2025-03-05:
Parole itself does not use the regex_automata feature for its own reference of parol_runtime.
That's why parole v3 re-exports parol_runtime to avoid the problem you describe because you only need to use parol as build-dependency and thus you can't create a conflicting combination of features.
Nevertheless, I was not aware that both dependencies and build-dependencies can be active at the same time.
If this is the case you will always end up with cargo errors.
On the other hand, providing an adequate feature for parol causes much higher test efforts.
I will have to investigate the topic further.

dalance, 2025-03-05:
@jsinger67

OK. In this case, user of `veryl-parser` don't need to execute parol build. So I think the current solution is sufficient.
Maybe it is more useful that this workaround is described in the parol book.
(I also didn't know both dependencies become to be active, so felt very strange behavior)

jsinger67, 2025-03-05:
Yes, I agree. I will document this behavior thoroughly in the book 😊

Closed 2025-03-05.

Thread 1346 (2025-03-06):

Drop `ref` direction support

dalance, 2025-03-06:
`ref` direction as function argument is supported.
There seems to be no meaningful use case for synthesizable RTL, so it should be removed to avoid confusing.

Closed 2025-03-07.

Thread 1353 (2025-03-07):

Report no error for a reference to a generic parameter via a scoped identifier

taichi-ishitani, 2025-03-07:
Reference to a generic parameter via a scoped identifier should cause an error but not.

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

taichi-ishitani, 2025-03-07:
Reference to a local variable in a function also causes no error.

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

taichi-ishitani, 2025-03-07:
Reference to an indentifier in a module also causes no error.

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

taichi-ishitani, 2025-03-07:
Reference to struct member via the struct type.

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

taichi-ishitani, 2025-03-07:
Reference to a variable in a inteface.

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

nananapo, 2025-04-20:
Is it intended to prohibit reference to a variable in submodule?

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

nananapo, 2025-04-20:
By the way, Playground(nightly) can build this code.
My local environment can't...
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

taichi-ishitani, 2025-04-20:
`u` is a module instance so behavior of nightly build is invalid.

taichi-ishitani, 2025-04-20:
I add the unit test below and I confirm that the `InvisibleIndentifier` error is reported expectedly.
This behavior is intentional.

```rust
    let code = r#"
    module ModuleA {
        let _a: logic = 0;
    }
    module ModuleB {
        inst u: ModuleA;
        let _b: logic = u._a;
    }
    "#;

    let errors = analyze(code);
    assert!(matches!(
        errors[0],
        AnalyzerError::InvisibleIndentifier { .. }
    ));
```

Closed 2025-03-08.

Thread 1371 (2025-03-09):

Wrong error message in case of missing port in modport definition and usage of converse(xxx)

janschiefer, 2025-03-09:
Veryl (current git version) gives a wrong and ultimately misleading error message when you forget to include a port in a modport definition and use ..converse(xxx) later.

Working:
```
interface test_if {                                                              
    var a: logic;
    var b: logic;

    modport master {
        a: input ,                                                              
        b: output,
    }
                                                                         
    modport slave {
       ..converse(master)
    }                                                            
}
```

Faulty:
```
Interface test_if {                                                              
    var a: logic;
    var b: logic;

    modport master {
     //   a: input ,                                                              
        b: output,
    }
                                                                         
    modport slave {
       ..converse(master)
    }                                                                            
}
```
On veryl build or check you get:
```
Error:   x veryl check failed

Error: undefined_identifier (https://doc.veryl-lang.org/book/07_appendix/02_semantic_error.html#undefined_identifier)

  x master is undefined
    ,-[/home/jschiefer/test_if_bug/src/test_if.veryl:12:20]
 11 |     modport slave {
 12 |         ..converse(master)
    :                    ^^^|^^
    :                       -- Error location
 13 |     }

  help:
```
Actually it should complain about missing the 'a' port in master modport definition and 'a' as an unused variable and not about an undefined master port.

dalance, 2025-03-11:
I think modport can have a part of interface members, so this case should not be error except unused `a`.

Closed 2025-03-11.

Thread 1391 (2025-03-12):

Autoconnect for interfaces?

janschiefer, 2025-03-12:
Since Veryl focuses on simplicity and a good developer experience, mechanisms to reduce (error prone) boilerplate code seen desirable.

Why not implement a operator that automatically connects complementary (input - output, output- input, inout-inout?) elements between same type interfaces?

```
interface axi_if {

var AWREADY;
var AWVALID;
// imagine 20 more fields here...

modport interconn_slave {
AWREADY : output,
AWVALID : input,
//...
}

modport interconn_master {
..converse(interconn_slave)
}

}

module interconn(
bus_in: modport axi_if::interconn_slave,
bus_out: modport axi_if::interconn_master
)
{

assign bus_in.AWVALID = bus_out.AWVALID;
assign bus_out.AWREADY = bus_in.AWREADY;
//Imagine 20 more assignments here...

//this simply becomes:
bus_in <> bus_out;

}

```

(And yes, I also like SpinalHDL, but the Verilog code generated is horrible.)

taichi-ishitani, 2025-03-13:
Related issue
https://github.com/veryl-lang/veryl/issues/961

taichi-ishitani, 2025-03-13:
> Related issue [#961](https://github.com/veryl-lang/veryl/issues/961)

How about the idea below?

Define a function which can take a interface modport as a parameter and connect two interfaces by using this function.

```systemverilog
interface axi_if {
  var awready: logic;
  var awvalid: logic;

  function connect (
    self,
    slave_if: axi_if::slave,
  ) {
    slave_if.awready = self.awready;
    self.awvalid     = slave_if.awvalid;
    ...
  }

  modport master {
    awready: input,
    awvalid: output,
    connect: import,
  }
}

inst master_if: axi_if;
inst slave_if:  axi_if;

assign master_if.connect(slave_if);
```

SystemVerilog does not support functions which take interface instances or modports.
Therefore, we need to emit body code of such function into SystemVerilog directoly.

Emitted SV

```systemverilog
axi_if master_if();
axi_if slave_if();

always_comb begin
  slave_if.awready = master_if.awready;
  master_if.awvalid = slave_if.awvalid;
  ...
end
```

dalance, 2025-03-13:
I think funciton associated interface is useful, but special syntax for connection may be better because it occurs frequently.
Probably inferring direction by associated function is difficult for the following case.

```systemverilog
module ModuleA (
    port: modport Interface::slave,
) {
    inst temp0: Interface;
    inst temp1: Interface;

    assign temp0 <> port;
    assign temp1 <> temp0;
}
```

taichi-ishitani, 2025-03-13:
It is possible to determine signal directions between `temp0` and `port` if `port` is an actual modport but it is impossible if `port` is a generic interface.

Due to the above issue I think we should remove the `generic interface` feature and use the `generics` feature instead.

dalance, 2025-03-13:
I feel that inferring direction is not so good idea after consideration, because it causes complex error by large inference chain.
So specifing which modport is used may be better like below:

```systemverilog
assign temp0: master <> port; // modport specification can be omitted if target is modport
assign temp1: master <> temp0: slave;
```

taichi-ishitani, 2025-03-13:
I prefer `.` for the separator between interface insntace and modport becuase SV uses it.

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

dalance, 2025-03-13:
`.` is already used as member access, so it may be less clear.
I think the following candidates.
Of cousce, it is necessary to consider whether `assign` and `<>` is suitable.

```systemverilog
// type-like
assign temp0: master <> port;
assign temp1: master <> temp0: slave;

// member-like
assign temp0.master <> port;
assign temp1.master <> temp0.slave;

// casting-like
assign temp0 as master <> port;
assign temp1 as master <> temp0 as slave;
```

dalance, 2025-03-13:
From the point of view of syntax, `assign` is not good, because the new syntax is very different from the original assign declaration.
So any new keyword should be introduced.

taichi-ishitani, 2025-03-13:
How about this?

```systemverilog
connect if_a <> if_b;
```

janschiefer, 2025-03-13:
Connect if_a <> if_b makes most sense, but you have to specify the modports if these are missing.

dalance, 2025-03-13:
I agree member-like syntax using `.` because modport is exactly a member of interface, not a type.

> We also need a mechanism to skip (and inform about) ports that have been assigned otherwise before the statement.

This will be checked by the existing multi-drive detection mechanism.

janschiefer, 2025-03-13:
In a second step we could introduce a second operation to connect all inputs or direction-less signals in one direction. This will simplify pipelining my a great extend.

```
interface pl_data {
var data1 : logic;
var data2 : logic;
var valid : logic;
}

(...)

always_ff {

(...)
// Stage 1
connect pl_data[1] <- pl_data[0];
(...)
//Stage 2
connect pl_data[2] <- pl_data[1];
(...)
}
```

dalance, 2025-03-14:
About pipelining, I think actual use cases may be little.
This is because many interfaces have bi-directional protocol like valid/ready, they requires FIFO / skid-buffer instead of simple pipeline FF.
If all members of interface have the same direction, simple `struct` can be used.

Additionally, to suppress power consumption, gating by valid signal is commonly used like below:

```systemverilog
always_ff {
  if pl_data.valid {
    pl_data[1].data1 = pl_data.data1;
    pl_data[1].data2 = pl_data.data2;
  }
}
```

I think simple `connect` notation can't cover such several usages.

taichi-ishitani, 2025-03-14:
I summarize features of this operation in #1399.

Closed 2025-03-27.

Thread 1393 (2025-03-13):

Ambiguous for `::` less generic arguments list

taichi-ishitani, 2025-03-13:
`::` less generic arguments list results an ambiguous error.
Veryl compiler reports the `mismatch_generics_arity` error for the code below.

```systemverilog
package Pkg {
  function Func::<B: const>() -> u32 {
    return B;
  }
}

module ModuleA {
  let _a: u32 = Pkg::Func<2>();
}
```

```console
Error: mismatch_generics_arity (link)

  × generics "Func" has 1 generic arguments, but 0 arguments are supplied
   ╭─[/home/taichi/workspace/temp/veryl/veryl/test.veryl:8:17]
 7 │ module ModuleA {
 8 │   let _a: u32 = Pkg::Func<2>();
   ·                 ────┬────
   ·                     ╰── Error location
 9 │ }
   ╰────
  help: fix generics arguments
```

dalance, 2025-03-13:
When 0 argument, "missing ::<>" instead of arity error may be better because all generics should have arguments.

Thread 1399 (2025-03-14):

Introduce `connect` operation

taichi-ishitani, 2025-03-14:
refs #1391

The `connect` operator `<>` is to connect two interfaces.

```systemverilog
always_comb {
  master_if <> slave_if;
}
```

The above code is expanded into each port connections like below.

```systemverilog
always_comb begin
  slave_if.ready  = master_if.ready;
  master_if.valid = slave_if.valid;
  master_if.data  = slave_if.data;
end
```

Modport is required to determine directions if an operand is an interface instance.

```systemverilog
always_comb {
 // if_a is an interface instance
 // slave_if is a modport
  if_a.master <> slave_if;
}
```

`connect` keyword is required if a `connect` operation is used in a module body but not an `always_*` procedure.

```systemverilog
module ModuleA {
  connect if_a.master <> slave_if;
}
```

For this case, modport including `intou` ports and an arrray interface instance/modport can be used as an operand.
Such operations will be emitted like below.

* Including inout ports

```systemverilog
tran (if_a.scl, if_b.scl);
tran (if_a.sda, if_b.sda);
```

* Array interface/modport

```systemverilog
for (genvar __i = 0;__i < 4;__i++) begin : __g_connect_if_a_if_b
  alwasy_comb begin
    slave_if[__i].ready = master_if[__i].ready;
    master_if[__i].valid = slave_if[__i].valid;
    master_if[__i].data  = slave_if[__i].data;
  end
end
```

There are some needs to tie output ports of an interface to a specific value.
(e.g. https://github.com/pezy-computing/pzbcm/blob/985e7147ab42682e62f32604433090b3be5f8482/pzcorebus_dummy/pzcorebus_dummy_slave.sv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)
`connect` operation should also support such cases.

```systemverilog
always_comb {
  slave_if <> 0;
}
```

This code will emitted like below.

```systemverilog
always_comb begin
  slave_if.ready = 0;
end
```

taichi-ishitani, 2025-03-14:
To connect array interfaces, array sizes of these interfaces need to be matched.
For this purpose, expression comparator is required.
The comparator compares two expression have the same operands and operator does not evaluate expressions.

taichi-ishitani, 2025-03-14:
For array interface connection, part connection should be supported.

```systemverilog
connect a_if[0+:4].master <> slave_if[4+:4];
```

dalance, 2025-03-14:
> To connect array interfaces, array sizes of these interfaces need to be matched. For this purpose, expression comparator is required. The comparator compares two expression have the same operands and operator does not evaluate expressions.

Is checking equivalence without evaluation possible?
I feel even the simplest case like `A + B == B + A` is difficult to handle it generally...

taichi-ishitani, 2025-03-14:
The comparetor does not check values of A and B.
In this case, it compares operand identifier names and the operator kind.

* `A + B` == `B + A` is true
* `A + B` == `A - B` is false
* `A + B` == `A + C` is false

dalance, 2025-03-14:
I agree the very limited case like 2 operands and 1 operator can be solved.
But I feel that slightly complex case becomes to be difficult drastically.

* literal equivalency: `A + 2 == A + 1 + 1`
* commutativity: `A - B + C - D == C - D + A - B`
* associativity: `(A + B) * C == A * C + B * C`
* transitivity: `B == C  -> A + B == A + C`

I think this complexity is a reason for existence of specialized equivalency checker like Formality.

On the other hand, the current implementation of evaluator can evaluate and show equivalency of all above cases.

taichi-ishitani, 2025-03-18:
It is difficult to evaluate array size and array select if they are provated by parameter or generic parameter.
For the first, the connect operation supports non array instance/modport and single enement of array instance/modport.

taichi-ishitani, 2025-03-22:
Cast operation is required if type of output side signal is a user defined type.
Thefore, such types should be defined in packages.

Closed 2025-03-27.

Thread 1415 (2025-03-21):

AXI interface version in std

dalance, 2025-03-21:
In #1410, `axi_if` covers AXI3 and AXI4.
How we should treat versions?

* `axi_if` covers all versions through parameter or generics
* Split `axi_if` to `axi3_if` and `axi4_if`, and add `axi5_if` in future

janschiefer, 2025-04-07:
FINALLY I got some time to redo the AXI implementation.

I¨ve implemented the axi interfaces in 2 different ways to choose from --> [](https://github.com/janschiefer/test_axi)

**Variant 1 ( axi_if.veryl && axi_test.veryl ): Implement 2 different axi interfaces for AXI4 and AXI3**
- Pros:
-- Works with open source tools ( [yosys](https://github.com/YosysHQ/yosys), [sv2v](https://github.com/zachjs/sv2v) )
-- No unused wires
- Cons: Code duplication

**Variant 2 ( axi_if_variant.veryl && axi_test_variant.veryl ): AXI3 & AXI4 uniform implementation using proto package**
- Pros:
-- More concise, code reusage
- Cons:
-- Incompatible with yosys as well as sv2v
-- Unused wires with width of 1 bit since I see no way to purge them conditionally

Interestingly another bug unmasked:
--> " omit_project_prefix = true " is ignored in interface definitions, but not when the interface is instantiated in a module.

dalance, 2025-04-09:
Thank you for your work!

I think `axi3_if/axi4_if` is better than generic `axi_if` because AXI5, 6 and so on in future may not suite the current definition of `axi_if`.
But if all parameters are specified individually, the definition of AXI components becomes busy.

```systemverilog
module axi4_slice::<ADDR_W: const, DATA_W_BYTES: const, ID_W: const, AWUSER_W: const, WUSER_W: const, BUSER_W: const, ARUSER_W: const, RUSER_W: const> (
    slv_if: modport axi4_if::<ADDR_W, DATA_W_BYTES, ID_W, AWUSER_W, WUSER_W, BUSER_W, ARUSER_W, RUSER_W>::slave,
    mst_if: modport axi4_if::<ADDR_W, DATA_W_BYTES, ID_W, AWUSER_W, WUSER_W, BUSER_W, ARUSER_W, RUSER_W>::master,
) {}
```

So from this viewpoint, using proto package may be better like below:

```systemverilog
// define generic component
module axi4_slice::<PKG: axi4_prototype> (
    slv_if: modport axi4_if::<PKG>::slave,
    mst_if: modport axi4_if::<PKG>::master,
) {}

// use the component with a specific AXI4 parameter
alias package my_axi4_pkg = $sv::axi4_pkg::<32, 4, 1, 8, 8, 8, 8, 8>;

module a {
    inst u_slice: axi4_slice::<my_axi4_pkg>;
}
```

Does proto package cause incompatibility with yosys and sv2s?

dalance, 2025-04-09:
About clock and reset, I think it is better that they are not included in interface.
Especially, clock is affected by phsical restriction in ASIC, and various patterns can be considered like below:

```systemverilog
// all axi_if are fully asynchronous
module A (
    axi_clk: input clock<10>,
    axi_if: modport axi4_if::<...>[10],
) {}

// all axi_if are synchronous
module A (
    axi_clk: input clock,
    axi_if: modport axi4_if::<...>[10],
) {}

// some axi_if come from left side of chip, and others from right side
module A (
    axi_clk_from_leftside : input clock,
    axi_clk_from_rightside: input clock,
    axi_if_from_leftside : modport axi4_if::<...>[10],
    axi_if_from_rightside: modport axi4_if::<...>[10],
) {}
```

janschiefer, 2025-04-18:
I updated my porposals.

--> Removed ACLK and ARESET and in turn also master_interconnect and slave_interconnect modports

Variant 1 - Implement 2 different axi interfaces for AXI4 and AXI3: https://github.com/janschiefer/test_axi/blob/main/src/axi_if.veryl

Variant 2 -  AXI3 & AXI4 uniform implementation using proto package: https://github.com/janschiefer/test_axi/blob/main/src/axi_if_variant.veryl

I also switched to using the Slang Yosys plugin in my test code, which seems necessary for building Veryl generated SV code with OSS toolchains ( https://github.com/veryl-lang/veryl/issues/1499 )

Pull request time?

dalance, 2025-04-19:
How about the following construct?
This causes some code duplication, but I feel it is more clear how to use.

```systemverilog
pub proto package axi3_prototype {}
pub proto package axi4_prototype {}

pub package axi3_pkg::<ADDR_W: const, DATA_W_BYTES: const, ID_W: const> for axi3_prototype {}
pub package axi4_pkg::<ADDR_W: const, DATA_W_BYTES: const, ID_W: const, AWUSER_W: const, WUSER_W: const, BUSER_W: const, ARUSER_W: const, RUSER_W: const> for axi4_prototype {}

pub interface axi3_if::<PKG: axi3_prototype> {}
pub interface axi4_if::<PKG: axi4_prototype> {}
```

janschiefer, 2025-04-20:
As you wish: [axi_if.veryl](https://github.com/janschiefer/test_axi/blob/main/src/axi_if.veryl)

janschiefer, 2025-04-24:
I have revised the proposal further --> [axi_if.veryl](https://github.com/janschiefer/test_axi/blob/main/src/axi_if.veryl)

1. Changed case of all variabled to lowercase

2. Documentation comments --> Normal comments

3. Added prototypes and interface definitions for AXI4-Lite

What do you think?

dalance, 2025-04-25:
OK. I think this version can be merged.

taichi-ishitani, 2025-04-25:
How about adding utility functions like this.

```systemverilog
function awaddr_ack() -> logic {
    return awready && awvalid;
]
```

In addition, I think separated modports are useful.

```systemverilog
modport write_master {
  awready: input ,
  awvalid: output,
  ...
  wready : input ,
  wvalid : output,
  ...
  bready : output,
  bvalid : input ,
  ...
}
```

janschiefer, 2025-04-25:
Ok...let's make this the ultimate AXI interface implementation: [axi_if.veryl](https://github.com/janschiefer/test_axi/blob/main/src/axi_if.veryl) 😃

1. Re-introduced convenience functions *_ack() for all AXI channels and versions. ( These now also work with yosys and the slang frontend 👍 )

2. Added modports for write-only and read-only master and slave devices.

3. Fixed 3 typos i overlooked while changing the case of the variable names

taichi-ishitani, 2025-04-25:
I think separated interface declarations is not good for common module definitions (bus arbiter, FIFO, etc.) because such module definitions also need to be separated par protocol versions.
Therefore, I think one interface declaration should be shared for all protocol versions.

taichi-ishitani, 2025-04-25:
I think AXI3, AXI4 and AXI4 Lite should be merged into one interface.

janschiefer, 2025-04-25:
Also: Is there currently a option inveryl to ignore specific signals depending on parameters? (for example ignore awuser wires in AXI3).

taichi-ishitani, 2025-04-25:
In our interface declaration, unused ports are remained but I think it would not be a problem.
On the other hand, such ports are removed from effective payload because it would consume unnecessary resources.
This article describes how to implement such interface but it is written Japanese.
https://qiita.com/taichi-ishitani/items/ec351cc5d793a4382da0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

janschiefer, 2025-04-25:
I have unified the (proto) interfaces from AXI4, AXI3 and AXI4-Lite: [axi_if_unified.veryl](https://github.com/janschiefer/test_axi/blob/main/src/axi_if_unified.veryl)

Usage:
```
inst a: axi_if_unified::<axi4_pkg::<32, 4, 1, 8, 8, 8, 8, 8>>;

inst b: axi_if_unified::<axi3_pkg::<32, 4, 1>>;

inst c: axi_if_unified::<axi4_lite_pkg::<32, 4>>;
```

🤙

janschiefer, 2025-04-25:
The old version with separate interfaces is here: [axi_if.veryl](https://github.com/janschiefer/test_axi/blob/221d687f1816ce6cfad123f179183460c9f378cd/src/axi_if.veryl)

Pick your poison. 😄

dalance, 2025-04-25:
For example, if user want to implement AXI4-lite device, how can user do it?

* full compliant for merged interface ( AXI3, AXI4, AXI4-lite )
* AXI4-lite only with document which has "if `axi3_pkg` / `axi4_pkg` is specified, it will be broken"

The former requires too implementation cost, documentation has no guarantee in the latter case.
Instead of it, using `axi4_lite_if` is more simple.

dalance, 2025-04-26:
I think axi3_if, axi4_if and axi4_lite_if is better.
Even if we choose axi_if_unified with axi3/axi4 only, user who want to use AXI4 feature can't express axi3_pkg can't be used except writing it to the document.

taichi-ishitani, 2025-04-28:
We have to separate interface definitions par protocol versions if we want to users who uses AXI4 not to the `wid` signal becaues there is no such langurage feature for now.

janschiefer, 2025-05-01:
I may have hit a [tiny roadblock](https://github.com/veryl-lang/veryl/issues/1573).

While preparing the pull request I found out veryl is OK with...
```
module Module82B (
    axi: modport axi3_if::<axi3_pkg::<32, 4, 8>>::slave,
) {}
```

...but will throw an error when you do exactly the same, but import all the types from veryl_std:
```
Error:   × veryl check failed

Error: invisible_identifier (link)

  × cannot refer indentifier __axi3_if__$std___axi3_pkg__32__4__8 because it is invisible at here
    ╭─[/home/jschiefer/Code/veryl_dev/veryl/testcases/veryl/82_axi_if.veryl:45:18]
 44 │ module Module82B (
 45 │     axi: modport $std::axi3_if::<$std::axi3_pkg::<32, 4, 8>>::slave,
    ·                  ─────────────────────────┬────────────────────────
    ·                                           ╰── Error location
 46 │ ) {}
    ╰────
```

janschiefer, 2025-05-02:
Nice working after te most recent fix.

Closed 2025-05-04.

Thread 1421 (2025-03-22):

veryl test [files] dependecy tracking?

perlindgren, 2025-03-22:
Hi Folks

First of all thanks for the great effort, this project is really interesting and promising.

It seems that 'test' does not track dependencies, thus if you want to test e.g., an 'adder' that instantiates a 'full_adder' defined in another file, then you need to give both files:

```
veryl test src/adder.veryl src/full_adder.veryl
```

Its not worse than the juggling `verilator` by hand directly on System Verilog files, but `veryl` could possibly do better?

```
veryl test src/adder.veryl
```

Under the hood, `veryl` would need to detect the dependency, and issue the list of dependencies downstream to `verilator` (or whatever simulator is used).

```
├── src
│   ├── adder.veryl
│   ├── full_adder.veryl
```

(Of course you would not implement an adder by hand, but it is for teaching purpose).

/Per

perlindgren, 2025-03-22:
In addition, one could have a flag that controls if tests are to be run for modules that were dependently brought in.

```shell
very test src/adder.veryl --test_dependencies
```

(Default might be to NOT test dependencies)
/Per

perlindgren, 2025-03-22:
Another convenience could be to default to `src/`(or rather according to the Veryl.toml) and assume `.veryl`.

```shell
veryl test adder
```

(Or even taken another page from the rust test framework and testing all matching prefixes... but not sure how that resonates with the HDL community...)

/Per

Thread 1431 (2025-03-25):

`case`/`switch` inconsistent syntax

hellow554, 2025-03-25:
If you use [case/switch as an expression](https://doc.veryl-lang.org/book/05_language_reference/04_expression/05_case_switch.html) you need to write this:

```veryl
case a {
        0               : 1,
        1               : 2,
        3..=5           : 4,
        10'b00_0000_011x: 5, // matches 6 or 7
        default         : 6,
    };
```

If you want to use [case/switch as a statement](https://doc.veryl-lang.org/book/05_language_reference/05_statement/04_case_switch.html) you need to write this:

```veryl
case a {
            0: b = 1;
            1: b = 2;
            2: {
                   b = 3;
                   b = 3;
                   b = 3;
               }
            default: b = 4;
        }
```

---

Question: is it really necesarry to distinguish the two cases (expression and statement)? Can't you use the expression syntax for everything? I would favor to do so.

perlindgren, 2025-03-25:
In Rust the type of the expression of an assignment is the (zero sized) unit type, not sure if there is any equivalent in Veryl, and how the translation would look like. (If unit types/values are not allowed in Veryl, it would simply be a type error.)

/Per

dalance, 2025-03-25:
`;` at the end of case expression is not a part of expression.
The `;` shows the end of statement.

```systemverilog
// the following `;`s are same meaning
let a: logic = 1;
let b: logic = case a {    };

// case expression can be used without `;`
always_comb {
    if case a {    } {
    }
}
```

On the other hand, I think `;` in case statement may be able to be changed for more consistency.

```systemverilog
case a {
    0: b = 1,
    1: b = 2,
    2: {
           b = 3;
           b = 3;
           b = 3;
       }
    default: b = 4,
}
```

dalance, 2025-03-25:
But the above case introduces statement without `;`.
If so, the following case should be allowed?

```
module ModuleA {
    let a: logic = 1   // single statement without `;`
}
```

In Rust, statement without `;` is allowed to express that the block returns the statement result.
But Veryl and SV can't use such feature.

So, maybe, it is better that all statements have `;` for consistency.

Thread 1432 (2025-03-25):

Native Veryl tests.

perlindgren, 2025-03-25:
As far as I understand, tests in Veryl are currently limited to inlining or referring to tests written in System Verilog and Cocotb. Perhaps we can have a language extension that allows a SV like syntax for tests, transpiling to SV test benches and with a test attribute invoke those.

At a first glance it seems pretty straight forward, but perhaps there are some underlying blockers for this.

Something like this perhaps:

```sv
module HalfAdder #() (
    a    : input  logic,
    b    : input  logic,
    sum  : output logic,
    carry: output logic,
) {
    always_comb {
        sum   = a ^ b;
        carry = a & b;
    }
}

#[test(half_adder)]
module test () {
         var a        : logic;
         var b        : logic;
         var sum   : logic;
         var carry : logic;

        inst full_adder: HalfAdder (
            a  ,
            b  ,
            sum  ,
            carry
        );

        initial {
            a = 0; b = 0;
            assert (sum == 0 && carry == 0);
            #10; // guess we need some way to progess simulation time

            // $finish; // guess we need some way to stop sim
        }
}

dalance, 2025-03-25:
I agree introducing delay notation like `#10;`, as minimal support for native test description,  is not so difficult.
But I concern that once it is introduced, more and more syntex for more complex test will be necessary.

perlindgren, 2025-03-25:
I don't know whether the test logic should reside in the `initial` block, or if there should be some other construct. As of now this won't match the current syntax of course.

If something like this appears as a good idea, I'd be happy to try to implement it in Veryl. The idea is to get all the niceties of Veryl for writing tests. And still one can have the inline option of SV based tests, and cocotb, this should not break anything.

perlindgren, 2025-03-25:
> I agree introducing delay notation like `#10;`, as minimal support for native test description, is not so difficult. But I concern that once it is introduced, more and more syntex for more complex test will be necessary.

What kind of syntax are you referring, operations for file io and such? I think more advanced tests could be done in Marlin, but small unit tests could go well Veryl.

dalance, 2025-03-25:
> What kind of syntax are you referring, operations for file io and such?

For example, `task`, `clocking`, constrainted random and so on.
About this point, maybe, we can select carefully to avoid complexity.

One more concern is scheduling semantics.
Racing between variable set and get becomes problem, and native simulator #1287 may become more difficult.
Instead of delay notation, clock based notation may be better.

perlindgren, 2025-03-25:
> One more concern is scheduling semantics. Racing between variable set and get becomes problem, and native simulator [#1287](https://github.com/veryl-lang/veryl/issues/1287) may become more difficult. Instead of delay notation, clock based notation may be better.

Could you give an example how that might look like (clock based test bench).

dalance, 2025-03-25:
I don't have complete idea yet, the current image is like below:

```systemverilog
#[test(half_adder)]
module test () {
    #[clock(10, 10)]
    var clk: clock;
    #[reset(0, 5)]
    var rst: reset;

    var a: logic;
    var b: logic;

    initial {
        @rst;
        @clk;
        a = 1;
        b = 1;
        @clk;
        assert (c == 2);
        a = 2;
        b = 2;
    }
}
```

perlindgren, 2025-03-26:
`#[clock(10, 10)]` defines the clock duty cycle, and `#[reset(0, 5)]` defines a reset event, active high, with a length of 5?

`@reset` and `@clk` are event instances, so here first a reset, then a clock, then some assignments, followed by another clock event.

Is the idea that the `clock`event performs a single transition or the period? In some cases you might have logic triggered by either flank so I assume its either high to low, or low to high, on each event.

I also assume events to be blocking.

Should there be something like `assert (..., $display("..."))`; allowing to trace assertion violations. Or perhaps something more Verylish, ìf !assert (c ==2) { ... }` assuming assert to return true if the assertion passes.

dalance, 2025-03-26:
> `#[clock(10, 10)]` defines the clock duty cycle, and `#[reset(0, 5)]` defines a reset event, active high, with a length of 5?

Yes. I intended it.
Unbalance duty is not necessary to handle, so more simplified syntax like `#[clock(10)]` may be better.
About reset, instead of the attribute, assignment in initial block may be better for flexibility.

> Is the idea that the `clock`event performs a single transition or the period? In some cases you might have logic triggered by either flank so I assume its either high to low, or low to high, on each event.

To specify the event polarity, something like `@(posedge clk)` can be considered.
However, I don't know whether there are a case that `negedge` is necessary.

> Should there be something like `assert (..., $display("..."))`; allowing to trace assertion violations. Or perhaps something more Verylish, `if !assert (c ==2) { ... }` assuming assert to return true if the assertion passes.

I agree it is necesarry to consider about assertion syntax.

Thread 1433 (2025-03-26):

`veryl build` is not thread safe

dalance, 2025-03-26:
If multiple `veryl build` is called for the same project, they are not controlled exclusively, and the build result becomes broken.

perlindgren, 2025-03-26:
If a file lock approach is taken, it would be great if using a cross platform mechanism ([fs4](https://crates.io/crates/fs4) is used Marlin, which might be worth looking into).

dalance, 2025-03-26:
Yes, fs4 is already used to lock dependency registry cache. I'll use it to lock project.

Closed 2025-03-26.

Thread 1434 (2025-03-26):

`veryl clean` can't trace renamed files

dalance, 2025-03-26:
`veryl clean` cleans files based on the current project status.
So the following scenerio misses to clean some files.

* `veryl build a.veryl` : Veryl generate `a.sv`
* `mv a.veryl b.veryl`
* `veryl clean` : Veryl try to remove `b.sv` based on `b.veryl`

perlindgren, 2025-03-26:
Indeed this is exactly the problem I ran in to.

Closed 2025-03-26.

Thread 1439 (2025-03-26):

Variable is marked as unassigned when using `readmemh`

hellow554, 2025-03-26:
```veryl
module Rom (
    clk          : input  clock    ,
    rst          : input  reset    ,
    i_addr       : input  logic<16>,
    o_data       : output logic<32>,
) {
    var memory: logic<32> [65536];

    initial {
        $readmemh("calc.bin", memory);
    }

    assign o_data = memory[i_addr / 4];
}
```

results in

```
# veryl check                                                                                                                                                                                 147ms
Error:   × veryl check failed

Warning: unassign_variable (link)

  ⚠ memory is unassigned
    ╭─[/home/marcel/projects/fpgastuff/veryl/src/rom.veryl:10:9]
  9 │ ) {
 10 │     var memory: logic<32> [65536];
    ·         ───┬──
    ·            ╰── Error location
 11 │
    ╰────
  help:
```

taichi-ishitani, 2025-03-27:
I'm working on this.

By the way, currently, any system functions and tasks can be used in Veryl code even if it is not synthesizable.
(E.g. `$fopen`)
Do we need to support such functions and tasks?

dalance, 2025-03-27:
After fixing this issue, this case should be reported as `invalid_statement` error because assignment in `initial` and `final` is forbidden.
So we should think about #823 to enable this case.

hellow554, 2025-03-27:
> After fixing this issue, this case should be reported as `invalid_statement` error because assignment in `initial` and `final` is forbidden. So we should think about [#823](https://github.com/veryl-lang/veryl/issues/823) to enable this case.

Can you provide an example on how to implement a ROM? @taichi-ishitani uses this to implement a ROM on his risc-v project

dalance, 2025-03-27:
> Can you provide an example on how to implement a ROM? [@taichi-ishitani](https://github.com/taichi-ishitani) uses this to implement a ROM on his risc-v project

Your code using readmemh in initial statement is right.
But it can't be used in ASIC projects, so such feature should be gated by something like attribute.
This is a meaning of #823.

dalance, 2025-03-27:
I'll merge #1443, and close this issue.
The remaining issue continues to #1444 .

Closed 2025-03-28.

Thread 1461 (2025-03-30):

`<>` in `always_comb` causes LSP panic and mdbook-veryl failure

dalance, 2025-03-30:
The following code causes some issues:

*  LSP panic at `analyzer.rs:227:81`
*  mdbook-veryl error: `bus_if1.cmd is unassigned`

```systemverilog
interface InterfaceA {
    var cmd  : logic;
    var ready: logic;

    modport master {
        cmd  : output,
        ready: input ,
    }

    modport slave {
        ..converse(master)
    }
}

module ModuleA (
    mst_if1: modport InterfaceA::master,
    slv_if1: modport InterfaceA::slave ,
) {
    inst bus_if1: InterfaceA;

    always_comb {
        mst_if1 <> bus_if1.slave;
        slv_if1 <> bus_if1.master;
    }
}
```

taichi-ishitani, 2025-03-30:
For 2nd issue, the above example can be re-written like below.

```systemverilog
always_comb {
  mst_if1.cmd   = bus_if1.cmd;
  bus_if1.ready = mst_if1.ready;
  bus_if1.cmd   = slv_if1.cmd;
  slv_if1.ready = bus_if1.ready;
}
```

`bus_if1.cmd` is referred before it is assigned so it is expected error.

taichi-ishitani, 2025-03-30:
Currently, this example is emitted in one `always_comb` block like below.

```systemveriog
always_comb begin
  mst_if1.cmd   = bus_if1.cmd;
  bus_if1.ready = mst_if1.ready;
  bus_if1.cmd   = slv_if1.cmd;
  slv_if1.ready = bus_if1.ready;
end
```

Should this `always_comb` block is separated?

```systemverilog
always_comb begin
  mst_if1.cmd   = bus_if1.cmd;
end
always_comb begin
  bus_if1.ready = mst_if1.ready;
end
always_comb begin
  bus_if1.cmd   = slv_if1.cmd;
end
always_comb begin
  slv_if1.ready = bus_if1.ready;
end
```

dalance, 2025-03-30:
Thanks. I understood it.
Splitting the `always_comb` is OK.

```systemverilog
always_comb {
    mst_if1 <> bus_if1.slave;
}
always_comb {
    slv_if1 <> bus_if1.master;
}
```
So I feel using `<>` in `always_comb` is not good because assignment order should be considered.
How about removing `<>` support in `always_comb`? Is there any use case of it instead of `connect`?

taichi-ishitani, 2025-03-30:
I think connect operation in always_comb is useful to change part of modport like below.

```systemverilog
always_comb begin
  req_master_if <> req_slave_if;
  req_master_if.address = repap_address(req_slave_if.address);
end
```

dalance, 2025-03-30:
OK. If so, this issue needs to be fixed.

taichi-ishitani, 2025-03-30:
For splitting always_comb, I'm not sure we can split always_comb safely if there are other assignments around connect operation.

dalance, 2025-03-30:
I didn't intend automatically splitting by emitter, I only understood that this issue can be resolved by manually splitting.
But I feel it is difficult to write and understand the following code correctly.
This is because we can't see assignment direction by `<>`, and we don't know how `<>` and other assignments interact.

```systemverilog
always_comb begin
  req_master_if <> req_slave_if;
  req_master_if.address = remap_address(req_slave_if.address);
end
```

taichi-ishitani, 2025-03-30:
> This is because we can't see assignment direction by <>, and we don't know how <> and other assignments interact.

I think LSP can help this.
How about showing equivalent expanded code by hover?

For 1st issue, I look into it.

taichi-ishitani, 2025-03-31:
veryl-lsp is also panicked for the code below.

```systemverilog
module ModuleA {
    var _a: logic;
    var _b: logic;
    always_comb {
        _a = _b;
        _b = 0;
    }
}
```

taichi-ishitani, 2025-03-31:
LSP removes symbols of entities which it will be analyze from the symbol table before starting analysis.
https://github.com/veryl-lang/veryl/blob/91e59e7f9261f01ccfc840573a7c6cca9e203b71/crates/languageserver/src/server.rs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

But `symbol_table::drop` does not remove entries for those symbols from the `var_ref_list`.
This makes inconsistencies in the symbol table and the analyzer will be panicked due to this.
https://github.com/veryl-lang/veryl/blob/91e59e7f9261f01ccfc840573a7c6cca9e203b71/crates/analyzer/src/symbol_table.rs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

Closed 2025-03-31.

Thread 1462 (2025-03-30):

Inconsistencies in generic package member resolution

nblei, 2025-03-30:
I'm playing with an FFT accelerator:

```SystemVerilog
package fp_types_::<Exponent: const, Mantissa: const> {
    struct fp {
        sign    : logic          ,
        exp     : logic<Exponent>,
        mantissa: logic<Mantissa>,
    }

    struct cfp {
        real: fp,
        imag: fp,
    }
}

module bfly::<Exponent: const, Mantissa: const,
                         fp: type = fp_types_::<Exponent, Mantissa>::fp,
                         cfp: type = fp_types_::<Exponent, Mantissa>::cfp> (
    i_clk: input clock,
    i_rst: input reset,
    i_en : input logic,

    // Complex data inputs
    i_a: input fp_types_::<Exponent, Mantissa>::cfp,
    i_b: input cfp                                 ,
    i_w: input cfp                                 , // Twiddle Factor

    // Complex data outputs
    o_a: output cfp,
    o_b: output cfp,
) {
    // Stage 1: Compute B * W
    inst u_mul_real_real: $sv::DW_fp_mult #(
        sig_width      : Mantissa,
        exp_width      : Exponent,
        ieee_compliance: 0       ,
    ) (
        a: i_a.real,
        b: i_b.real,
    );
}
```
While the `a: i_a.real` line has no problems, the `b: i_b.real` line leads to the following:

```
Error:   × veryl check failed

Error: unknown_member (link)

  × "i_b" doesn't have member "real"
    ╭─[/home/nathan/research/FFTAccelerator/src/bfly.veryl:22:12]
 21 │         a: i_a.real,
 22 │         b: i_b.real,
    ·            ────┬───
    ·                ╰── Error location
 23 │     );
    ╰────
  help:
```
The expected behavior is that `cfp` would bind to `fp_types_::<Exponent, Mantissa>::cfp`, and thus `i_a` and `i_b` would resolve to the same type.  However, Veryl is unable to correctly resolve the type for `i_b`.

taichi-ishitani, 2025-03-30:
https://github.com/veryl-lang/veryl/blob/1051489921a7b0756f4db2e2ac654a4e07c81fb0/crates/analyzer/src/symbol_table.rs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

It seems that type expression on LSH of parameter declaration is not resolved.
I think this is a cause of this issue.

taichi-ishitani, 2025-03-31:
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

`fp` and `cfp` are generic arguments so the above comment may not be related.

taichi-ishitani, 2025-03-31:
By the way, package generic boundary can be used for this case.

```systemverilog
proto package fp_types_proto_pkg {
  const EXPONENT_WIDTH: u32;
  cosnt MANTISSA_WIDTH: u32;

  struct fp {
    sign    : logic                ,
    exp     : logic<EXPONENT_WIDTH>,
    mantissa: logic<MANTISSA_WIDTH>,
  }

  struct cfp {
    real: fp,
    imag: fp,
  }
}

package fp_types_pkg::<EXPONENT: const, MANTISSA: const> {
  const EXPONENT_WIDTH: u32 = EXPONENT;
  cosnt MANTISSA_WIDTH: u32 = MANTISSA;

  struct fp {
    sign    : logic                ,
    exp     : logic<EXPONENT_WIDTH>,
    mantissa: logic<MANTISSA_WIDTH>,
  }

  struct cfp {
    real: fp,
    imag: fp,
  }
}

module bfly::<FP_PKG: fp_types_proto_pkg> (
    i_clk: input clock,
    i_rst: input reset,
    i_en : input logic,

    // Complex data inputs
    i_a: input FP_PKG::cfp,
    i_b: input FP_PKG::cfp,
    i_w: input FP_PKG::cfp,

    // Complex data outputs
    o_a: output FP_PKG::cfp,
    o_b: output FP_PKG::cfp,
) {
    // Stage 1: Compute B * W
    inst u_mul_real_real: $sv::DW_fp_mult #(
        sig_width      : FP_PKG::EXPONENT_WIDTH,
        exp_width      : FP_PKG::MANTISSA_WIDTH,
        ieee_compliance: 0                     ,
    ) (
        a: i_a.real,
        b: i_b.real,
    );
}

module top {
  alias package fp16_pkg = fp_types_pkg::<5, 10>;
  inst u_bfly: bfly::<fp16_pkg> (
    ...
  );
}
```

Then required parameters and typedefs can be handled together. This is good for maintainability.

nblei, 2025-03-31:
And that makes sense, but it is not obvious what the resolution is.

BTW, the resolution is to simply remove the type alias from the generics list and define it in the main body, while keeping the alias usage in the port list.  Not only is the type checker happy with this, but the generated SystemVerilog has the correct types.  I'm very impressed by all the work you guys have put into this language over the past year.

Thread 1470 (2025-03-31):

Problems with monomorphic types inside monomorphic interface.

nblei, 2025-03-31:
```systemverilog
package fp_types_::<Exponent: const, Mantissa: const> {
    struct fp {
        sign    : logic          ,
        exp     : logic<Exponent>,
        mantissa: logic<Mantissa>,
    }
    struct bin_dataf {
        a: fp,
        b: fp,
    }
}

interface ready_valid_if::<T: type> {
  var ready: logic;
  var valid: logic;
  var value: T;

  modport producer {
    valid: output,
    value: output,
    ready: input,
  }

  modport consumer {
    ..converse(producer)
  }
}

module dw_mul_wrapper #(
    param Exponent      : u32                  = 8                              ,
    param Mantissa      : u32                  = 7                              ,
) (
    i_clk  : input clock          ,
    i_rst_n: input reset_async_low,

    consumer: modport ready_valid_if::<fp_types_::<Exponent, Mantissa>::bin_dataf>::consumer,
    producer: modport ready_valid_if::<fp_types_::<Exponent, Mantissa>::bin_dataf>::producer,
) {

    inst u_mult: $sv::DW_fp_mult #(
      sig_width: Mantissa,
      exp_width: Exponent,
    ) (
      a : consumer.value.a,
    );

}

```

```
$ veryl check
Error:   × veryl check failed

Error: unknown_member (link)

  × "value" doesn't have member "a"
    ╭─[/home/nathan/research/FFTAccelerator/src/dw_mul_wrapper.veryl:23:11]
 22 │     ) (
 23 │       a : consumer.value.a,
    ·           ────────┬───────
    ·                   ╰── Error location
 24 │     );
    ╰────
  help:
```

nblei, 2025-04-01:
Closed this prematurely.  The issue does seem to exist.

nblei, 2025-04-01:
@dalance Can you reopen this issue?

taichi-ishitani, 2025-04-02:
It seems that  this is the same issue with #1462.
I think a new notation needs to be introduced to constrain members which an argument must have.

```systemverilog
interface ready_valid_if::<T: struct(a, b)> {
}
```

taichi-ishitani, 2025-04-03:
> What about a proto type?

Prototype is also Ok.
Types used as a generic parameter should be derived from the prototype typed for the generic parameter. I'm not sure such strictness realy is needed.

nblei, 2025-04-03:
I am a bit confused as to why this is the suggestion (although I agree that type traits like that would be a good thing, in general).

Here, the `ready_valid_if` should take arbitrary type because the interface is truly type-agnostic.

At the same time, the `dw_mul_wrapper` contains full type information.

The `consumer` modport is to an interface with a fully defined type.  Thus, I think this is a bug in the type resolver.

dalance, 2025-04-03:
I agree this is a bug.
In `ready_valid_if`, any information except `T` is a type is not used, so extra constraint is not necessary.

Thread 1474 (2025-04-01):

Connect number literal to clock/reset port

taichi-ishitani, 2025-04-01:
Currenlty, Veryl reports an error for connection between a clock/reset port and number literal.

```console
Error: mismatch_type (https://doc.veryl-lang.org/book/07_appendix/02_semantic_error.html#mismatch_type)

  × "i_clk" is expected to "clock type", but it is "non-clock type"
     ╭─[/home/ishitani/workspace/rggen-sample-testbench/rtl/apb/block_0.veryl:438:9]
 437 │       )(
 438 │         i_clk:        '0,
     ·         ──┬──
     ·           ╰── Error location
 439 │         i_rst:        '0,
     ╰────
  help:

Error: mismatch_type (https://doc.veryl-lang.org/book/07_appendix/02_semantic_error.html#mismatch_type)

  × "i_rst" is expected to "reset type", but it is "non-reset type"
     ╭─[/home/ishitani/workspace/rggen-sample-testbench/rtl/apb/block_0.veryl:439:9]
 438 │         i_clk:        '0,
 439 │         i_rst:        '0,
     ·         ──┬──
     ·           ╰── Error location
 440 │         bit_field_if: bit_field_sub_if,
     ╰────
  help:
```

There are such cases for parameterized common modules like this.
https://github.com/pezy-computing/pzbcm/blob/master/pzcorebus_dummy/pzcorebus_dummy_slave.sv

I think it would be nice that Veryl reports no errors this kind of connections.

Closed 2025-04-14.

Thread 1476 (2025-04-02):

No error is reported when undefined identifier is given to modport default member

taichi-ishitani, 2025-04-02:
Veryl compiler report no error when undefined identifier to modport default member.
For example:

```systemverilog
interface InterfaceA {
    var a: logic;
    var b: logic;
    var c: logic;

    modport master {
        a: output,
        b: input ,
        c: input ,
    }

    modport driver {
        b: output,
        ..same(slave)
    }
}
```

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

taichi-ishitani, 2025-04-02:
The type check on modport default member is not checked too.

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

Closed 2025-04-03.

Thread 1478 (2025-04-02):

`path` field in `dependencies` section does not work well

taichi-ishitani, 2025-04-02:
The `path` field can be used to ovreride a dependency by the local implementation.
https://doc.veryl-lang.org/book/06_development_environment/02_dependencies.html#override-by-local-path

However it seems that this usage doens not work well.

I attached the sample env to reproduce this issue.
[veryl.tar.gz](https://github.com/user-attachments/files/19562691/veryl.tar.gz)

```toml
[project]
name = "test"
version = "0.1.0"

[dependencies]
veryl_sample = {version = "0.15.0", github = "veryl-lang/sample", path = "./sample" }
```

According to the output message, tts remote files is used even if the location of `veryl_sample` is ovewritten by the `path` field.

```console
$ veryl build
[INFO ]       Adding dependency (veryl_sample : https://github.com/veryl-lang/sample @ 0.15.0)
[INFO ]   Processing file (/home/taichi/workspace/temp/veryl/test.veryl)
[INFO ]   Processing file (/home/taichi/.cache/veryl/std/65da9082c768d63a811f47ed4a2be686ebc4703d15e6e9a24516ee368fdc1ead/async_fifo/async_fifo.veryl)
[INFO ]   Processing file (/home/taichi/.cache/veryl/std/65da9082c768d63a811f47ed4a2be686ebc4703d15e6e9a24516ee368fdc1ead/async_fifo/async_fifo_pkg.veryl)
[INFO ]   Processing file (/home/taichi/.cache/veryl/std/65da9082c768d63a811f47ed4a2be686ebc4703d15e6e9a24516ee368fdc1ead/async_fifo/async_fifo_reset_sync.veryl)
[INFO ]   Processing file (/home/taichi/.cache/veryl/std/65da9082c768d63a811f47ed4a2be686ebc4703d15e6e9a24516ee368fdc1ead/async_handshake/async_handshake.veryl)
[INFO ]   Processing file (/home/taichi/.cache/veryl/std/65da9082c768d63a811f47ed4a2be686ebc4703d15e6e9a24516ee368fdc1ead/binary_enc_dec/binary_decoder.veryl)
[INFO ]   Processing file (/home/taichi/.cache/veryl/std/65da9082c768d63a811f47ed4a2be686ebc4703d15e6e9a24516ee368fdc1ead/binary_enc_dec/binary_encoder.veryl)
[INFO ]   Processing file (/home/taichi/.cache/veryl/std/65da9082c768d63a811f47ed4a2be686ebc4703d15e6e9a24516ee368fdc1ead/coding/linear_sec_decoder.veryl)
[INFO ]   Processing file (/home/taichi/.cache/veryl/std/65da9082c768d63a811f47ed4a2be686ebc4703d15e6e9a24516ee368fdc1ead/coding/linear_sec_encoder.veryl)
[INFO ]   Processing file (/home/taichi/.cache/veryl/std/65da9082c768d63a811f47ed4a2be686ebc4703d15e6e9a24516ee368fdc1ead/coding/test_linear_sec.veryl)
[INFO ]   Processing file (/home/taichi/.cache/veryl/std/65da9082c768d63a811f47ed4a2be686ebc4703d15e6e9a24516ee368fdc1ead/counter/counter.veryl)
[INFO ]   Processing file (/home/taichi/.cache/veryl/std/65da9082c768d63a811f47ed4a2be686ebc4703d15e6e9a24516ee368fdc1ead/countones/countones.veryl)
[INFO ]   Processing file (/home/taichi/.cache/veryl/std/65da9082c768d63a811f47ed4a2be686ebc4703d15e6e9a24516ee368fdc1ead/countones/onehot.veryl)
[INFO ]   Processing file (/home/taichi/.cache/veryl/std/65da9082c768d63a811f47ed4a2be686ebc4703d15e6e9a24516ee368fdc1ead/delay/delay.veryl)
[INFO ]   Processing file (/home/taichi/.cache/veryl/std/65da9082c768d63a811f47ed4a2be686ebc4703d15e6e9a24516ee368fdc1ead/edge_detector/edge_detector.veryl)
[INFO ]   Processing file (/home/taichi/.cache/veryl/std/65da9082c768d63a811f47ed4a2be686ebc4703d15e6e9a24516ee368fdc1ead/fifo/fifo.veryl)
[INFO ]   Processing file (/home/taichi/.cache/veryl/std/65da9082c768d63a811f47ed4a2be686ebc4703d15e6e9a24516ee368fdc1ead/fifo/fifo_controller.veryl)
[INFO ]   Processing file (/home/taichi/.cache/veryl/std/65da9082c768d63a811f47ed4a2be686ebc4703d15e6e9a24516ee368fdc1ead/gray/gray_counter.veryl)
[INFO ]   Processing file (/home/taichi/.cache/veryl/std/65da9082c768d63a811f47ed4a2be686ebc4703d15e6e9a24516ee368fdc1ead/gray/gray_decoder.veryl)
[INFO ]   Processing file (/home/taichi/.cache/veryl/std/65da9082c768d63a811f47ed4a2be686ebc4703d15e6e9a24516ee368fdc1ead/gray/gray_encoder.veryl)
[INFO ]   Processing file (/home/taichi/.cache/veryl/std/65da9082c768d63a811f47ed4a2be686ebc4703d15e6e9a24516ee368fdc1ead/lfsr/lfsr_galois.veryl)
[INFO ]   Processing file (/home/taichi/.cache/veryl/std/65da9082c768d63a811f47ed4a2be686ebc4703d15e6e9a24516ee368fdc1ead/pkg/types.veryl)
[INFO ]   Processing file (/home/taichi/.cache/veryl/std/65da9082c768d63a811f47ed4a2be686ebc4703d15e6e9a24516ee368fdc1ead/ram/ram.veryl)
[INFO ]   Processing file (/home/taichi/.cache/veryl/std/65da9082c768d63a811f47ed4a2be686ebc4703d15e6e9a24516ee368fdc1ead/selector/demux.veryl)
[INFO ]   Processing file (/home/taichi/.cache/veryl/std/65da9082c768d63a811f47ed4a2be686ebc4703d15e6e9a24516ee368fdc1ead/selector/mux.veryl)
[INFO ]   Processing file (/home/taichi/.cache/veryl/std/65da9082c768d63a811f47ed4a2be686ebc4703d15e6e9a24516ee368fdc1ead/selector/selector_pkg.veryl)
[INFO ]   Processing file (/home/taichi/.cache/veryl/std/65da9082c768d63a811f47ed4a2be686ebc4703d15e6e9a24516ee368fdc1ead/selector/test_selector.veryl)
[INFO ]   Processing file (/home/taichi/.cache/veryl/std/65da9082c768d63a811f47ed4a2be686ebc4703d15e6e9a24516ee368fdc1ead/synchronizer/synchronizer.veryl)
[INFO ]   Processing file (/home/taichi/.cache/veryl/dependencies/b7032300fe145c759e08640d3dc74db5/src/data_if.veryl)
[INFO ]   Processing file (/home/taichi/.cache/veryl/dependencies/b7032300fe145c759e08640d3dc74db5/src/delay.veryl)
[INFO ]       Output filelist (/home/taichi/workspace/temp/veryl/test.f)
```

dalance, 2025-04-02:
Could you check whether #1479 works fine?

taichi-ishitani, 2025-04-02:
> Could you check whether [#1479](https://github.com/veryl-lang/veryl/pull/1479) works fine?

This fix works fine.

```console
$ ./veryl/target/debug/veryl build
[INFO ]       Adding dependency (veryl_sample : https://github.com/veryl-lang/sample @ 0.15.0)
[INFO ]   Processing file (/home/taichi/workspace/temp/veryl/test.veryl)
[INFO ]   Processing file (/home/taichi/.cache/veryl/std/65da9082c768d63a811f47ed4a2be686ebc4703d15e6e9a24516ee368fdc1ead/async_fifo/async_fifo.veryl)
[INFO ]   Processing file (/home/taichi/.cache/veryl/std/65da9082c768d63a811f47ed4a2be686ebc4703d15e6e9a24516ee368fdc1ead/async_fifo/async_fifo_pkg.veryl)
[INFO ]   Processing file (/home/taichi/.cache/veryl/std/65da9082c768d63a811f47ed4a2be686ebc4703d15e6e9a24516ee368fdc1ead/async_fifo/async_fifo_reset_sync.veryl)
[INFO ]   Processing file (/home/taichi/.cache/veryl/std/65da9082c768d63a811f47ed4a2be686ebc4703d15e6e9a24516ee368fdc1ead/async_handshake/async_handshake.veryl)
[INFO ]   Processing file (/home/taichi/.cache/veryl/std/65da9082c768d63a811f47ed4a2be686ebc4703d15e6e9a24516ee368fdc1ead/binary_enc_dec/binary_decoder.veryl)
[INFO ]   Processing file (/home/taichi/.cache/veryl/std/65da9082c768d63a811f47ed4a2be686ebc4703d15e6e9a24516ee368fdc1ead/binary_enc_dec/binary_encoder.veryl)
[INFO ]   Processing file (/home/taichi/.cache/veryl/std/65da9082c768d63a811f47ed4a2be686ebc4703d15e6e9a24516ee368fdc1ead/coding/linear_sec_decoder.veryl)
[INFO ]   Processing file (/home/taichi/.cache/veryl/std/65da9082c768d63a811f47ed4a2be686ebc4703d15e6e9a24516ee368fdc1ead/coding/linear_sec_encoder.veryl)
[INFO ]   Processing file (/home/taichi/.cache/veryl/std/65da9082c768d63a811f47ed4a2be686ebc4703d15e6e9a24516ee368fdc1ead/coding/test_linear_sec.veryl)
[INFO ]   Processing file (/home/taichi/.cache/veryl/std/65da9082c768d63a811f47ed4a2be686ebc4703d15e6e9a24516ee368fdc1ead/counter/counter.veryl)
[INFO ]   Processing file (/home/taichi/.cache/veryl/std/65da9082c768d63a811f47ed4a2be686ebc4703d15e6e9a24516ee368fdc1ead/countones/countones.veryl)
[INFO ]   Processing file (/home/taichi/.cache/veryl/std/65da9082c768d63a811f47ed4a2be686ebc4703d15e6e9a24516ee368fdc1ead/countones/onehot.veryl)
[INFO ]   Processing file (/home/taichi/.cache/veryl/std/65da9082c768d63a811f47ed4a2be686ebc4703d15e6e9a24516ee368fdc1ead/delay/delay.veryl)
[INFO ]   Processing file (/home/taichi/.cache/veryl/std/65da9082c768d63a811f47ed4a2be686ebc4703d15e6e9a24516ee368fdc1ead/edge_detector/edge_detector.veryl)
[INFO ]   Processing file (/home/taichi/.cache/veryl/std/65da9082c768d63a811f47ed4a2be686ebc4703d15e6e9a24516ee368fdc1ead/fifo/fifo.veryl)
[INFO ]   Processing file (/home/taichi/.cache/veryl/std/65da9082c768d63a811f47ed4a2be686ebc4703d15e6e9a24516ee368fdc1ead/fifo/fifo_controller.veryl)
[INFO ]   Processing file (/home/taichi/.cache/veryl/std/65da9082c768d63a811f47ed4a2be686ebc4703d15e6e9a24516ee368fdc1ead/gray/gray_counter.veryl)
[INFO ]   Processing file (/home/taichi/.cache/veryl/std/65da9082c768d63a811f47ed4a2be686ebc4703d15e6e9a24516ee368fdc1ead/gray/gray_decoder.veryl)
[INFO ]   Processing file (/home/taichi/.cache/veryl/std/65da9082c768d63a811f47ed4a2be686ebc4703d15e6e9a24516ee368fdc1ead/gray/gray_encoder.veryl)
[INFO ]   Processing file (/home/taichi/.cache/veryl/std/65da9082c768d63a811f47ed4a2be686ebc4703d15e6e9a24516ee368fdc1ead/lfsr/lfsr_galois.veryl)
[INFO ]   Processing file (/home/taichi/.cache/veryl/std/65da9082c768d63a811f47ed4a2be686ebc4703d15e6e9a24516ee368fdc1ead/pkg/types.veryl)
[INFO ]   Processing file (/home/taichi/.cache/veryl/std/65da9082c768d63a811f47ed4a2be686ebc4703d15e6e9a24516ee368fdc1ead/ram/ram.veryl)
[INFO ]   Processing file (/home/taichi/.cache/veryl/std/65da9082c768d63a811f47ed4a2be686ebc4703d15e6e9a24516ee368fdc1ead/selector/demux.veryl)
[INFO ]   Processing file (/home/taichi/.cache/veryl/std/65da9082c768d63a811f47ed4a2be686ebc4703d15e6e9a24516ee368fdc1ead/selector/mux.veryl)
[INFO ]   Processing file (/home/taichi/.cache/veryl/std/65da9082c768d63a811f47ed4a2be686ebc4703d15e6e9a24516ee368fdc1ead/selector/selector_pkg.veryl)
[INFO ]   Processing file (/home/taichi/.cache/veryl/std/65da9082c768d63a811f47ed4a2be686ebc4703d15e6e9a24516ee368fdc1ead/selector/test_selector.veryl)
[INFO ]   Processing file (/home/taichi/.cache/veryl/std/65da9082c768d63a811f47ed4a2be686ebc4703d15e6e9a24516ee368fdc1ead/synchronizer/synchronizer.veryl)
[INFO ]   Processing file (/home/taichi/workspace/temp/veryl/sample/src/data_if.veryl)
[INFO ]   Processing file (/home/taichi/workspace/temp/veryl/sample/src/delay.veryl)
[INFO ]       Output filelist (/home/taichi/workspace/temp/veryl/test.f)
```

Closed 2025-04-02.

Thread 1488 (2025-04-03):

Recursion

onsdagens, 2025-04-03:
Currently, recursive functions seem to be rejected by the type checker.

```
function sum (
    operand: input u32,
) -> u32 {
    if operand >: 0 {
        return operand + sum(operand - 1);
    } else {
        return 0;
    }
}
```

results in

```
Error: cyclice_type_dependency
```

Whether recursion is allowed or not is another question (guaranteeing synthesizability relies on bounding the recursion depth), but for now i think the error is not completely accurate (it shouldn't be a type checking thing).

Closed 2025-04-04.

Thread 1491 (2025-04-03):

Module recrsion (recutsion) bugs

nblei, 2025-04-03:
A compilation bug in the following code:

```systemverilog
module psel #(
    param DIM: u32 = 8,
) (
    i_data: input  logic<DIM>    ,
    o_mask: output logic<DIM>    ,
    o_set : output logic      = _,
) {

    if (DIM == 1) :gen_base_case {
        assign o_set  = i_data[0];
        assign o_mask = i_data;
    } else {
        // Get split (2 -> 1, 3 -> 2, 4 -> 2, etc)
        const SPLIT_POINT: u32 = 1 << ($clog2(DIM) - 1);
        const TOP_SIZE    : u32 = DIM - SPLIT_POINT;
        // const SPLIT_POINT: u32 = DIM / 2; --- THIS WORKS

        var top_mask: logic<TOP_SIZE>;
        var top_set : logic          ;

        var bot_mask  : logic<SPLIT_POINT>;
        var bot_masked: logic<SPLIT_POINT>;
        var bot_set   : logic             ;

        assign bot_masked = if top_set ? '0 : bot_mask;
        assign o_mask     = {top_mask, bot_masked};
        assign o_set      = top_set | bot_set;

        inst u_top: psel #(
            DIM: TOP_SIZE,
        ) (
            i_data: i_data[msb:SPLIT_POINT],
            o_mask: top_mask               ,
            o_set : top_set                ,
        );

        inst u_bot: psel #(
            DIM: SPLIT_POINT,
        ) (
            i_data: i_data[SPLIT_POINT - 1:0],
            o_mask: bot_mask                 ,
            o_set : bot_set                  ,
        );
    }
}
```

This results in an `infinite_recursion` error on `inst u_bot`.  This, despite the fact that the recursion is a finite chain terminating at `1`, the base case.  You'll see that what `1 << ($clog2(DIM) - 1)` is setting `SPLIT_POINT` to be the largest power of two strictly less than `DIM`.  Not only does this value exist for all `DIM > 1`, but it clearly terminates at `1`.  Further, adding a base case for `DIM == 0` does not fix this bug.

For this specific module, there's no reason to not just go with `SPLIT_POINT = DIM / 2`.  But for other modules it makes sense to split at powers of two (consider, for example, a one hot decoder).

Second bug is that, for some reason, the LSP message is `Semantic Error: infinite instance recustion is detected`.  So that's an easy fix: recustion -> recursion.

dalance, 2025-04-05:
`clog2` implementation was wrong, `$clog2(8)` was evaluated as `4`, and `TOP_SIZE` became `0`.
This issue will be fixed by #1498.

Closed 2025-04-05.

Thread 1496 (2025-04-05):

`analyze_pass3` is too long in a large project

dalance, 2025-04-05:
In a large project including 149files, `analye_pass3` phase takes long time.

```
[DEBUG]     Executed parse/analyze_pass1 (1434 milliseconds, 149 files)
[DEBUG]     Executed analyze_post_pass1 (811 milliseconds)
[DEBUG]     Executed analyze_pass2 (3531 milliseconds)
[DEBUG]     Executed analyze_pass3 (12571 milliseconds)
```

dalance, 2025-04-05:
After #1497

```
[DEBUG]     Executed parse/analyze_pass1 (1298 milliseconds, 149 files)
[DEBUG]     Executed analyze_post_pass1 (676 milliseconds)
[DEBUG]     Executed analyze_pass2 (3381 milliseconds)
[DEBUG]     Executed analyze_pass3 (939 milliseconds)
```

Closed 2025-04-05.

Thread 1534 (2025-04-16):

`Undefined Identifer` check on generic arguments is not executed

taichi-ishitani, 2025-04-16:
Veryl compiler reports no `Undefined Identifer` error for the sample code below even though enum variant `BAZ` is not defined.

```systemverilog
package Pkg {
    enum FooBar {
        FOO,
        BAR,
    }
}
module ModuleA::<FOO_BAR_VALUE: const> {
    let _foo_bar: Pkg::FooBar = FOO_BAR_VALUE;
}
module ModuleB {
    inst u: ModuleA::<Pkg::FooBar::BAZ>;
}
```

taichi-ishitani, 2025-04-17:
The latest compiler reports `unknown member` error for the above code.

Closed 2025-04-17.

Thread 1541 (2025-04-19):

Crash in veryl-check

nblei, 2025-04-19:
```
thread 'main' panicked at crates/analyzer/src/symbol.rs:318:64:
called `Option::unwrap()` on a `None` value
stack backtrace:
   0:     0x7cf66cd0a97f - <std::sys::backtrace::BacktraceLock::print::DisplayBacktrace as core::fmt::Display>::fmt::he3b9256f9625b6cd
   1:     0x7cf66ca6d6d3 - core::fmt::write::h3ea2b1e54ad6197d
   2:     0x7cf66cd0a052 - std::io::Write::write_fmt::h0cf931ec4add4351
   3:     0x7cf66cd0a7e3 - std::sys::backtrace::BacktraceLock::print::h77fd759a08d53fae
   4:     0x7cf66cd09e1c - std::panicking::rust_panic_with_hook::h7cfdd44e5fe090bd
   5:     0x7cf66cd45145 - std::panicking::begin_panic_handler::{{closure}}::haf5d64bff513bdc8
   6:     0x7cf66cd450d9 - std::sys::backtrace::__rust_end_short_backtrace::h76f58a295688ec70
   7:     0x7cf66cd456bc - rust_begin_unwind
   8:     0x7cf66c959d6f - core::panicking::panic_fmt::h7d00d98e52619d07
   9:     0x7cf66c959dbb - core::panicking::panic::h9bba1f5919d02e3c
  10:     0x7cf66c959fd8 - core::option::unwrap_failed::hb0d7c998df668d31
  11:     0x7cf66d0c94ce - veryl_analyzer::symbol::Symbol::generic_table::h837dcbd4e027cde3
  12:     0x7cf66d181517 - veryl_analyzer::symbol_table::SymbolTable::resolve::hc8fa7b909b766758
  13:     0x7cf66d038c12 - veryl_analyzer::analyzer::Analyzer::analyze_post_pass1::h95bdb8b0a738a5dd
  14:     0x7cf66cf24d08 - veryl::cmd_check::CmdCheck::exec::hc297d15f275459e7
  15:     0x7cf66c991ca1 - veryl::main::h958444c419d6d820
  16:     0x7cf66cfc4183 - std::sys::backtrace::__rust_begin_short_backtrace::ha1c864c025894c2c
  17:     0x7cf66c994af9 - main
```

This was the offending piece of veryl: ` param Arch: fp_types_::DwMultArch = fp_types::DwMultArch::Pipelined,`

notice the `fp_types_` on the left hand side, and `fp_types` on the right hand side.  This should throw some type of compile error, instead it crashes.

Thread 1543 (2025-04-19):

Members of generic package structs cannot be accessed through module prototypes

nblei, 2025-04-19:
```SystemVerilog
proto module fp_mul_proto
#(
    param Mantissa      : u32                  = 8                                  ,
    param Exponent      : u32                  = 7                                  ,
    param IeeeCompliance: bit                  = 0                                  ,
    param Arch          : fp_types::DwMultArch = fp_types::DwMultArch::Pipelined    ,
    const DataWidth     : u32                  = Mantissa + Exponent + 1            ,
    const FpType        : type                 = fp_types_::<Exponent, Mantissa>::fp,
) (
    i_a     : input  FpType   ,
    i_b     : input  FpType   ,
    i_rnd   : input  logic <3>,
    o_z     : output FpType   ,
    o_status: output logic <8>,
);

module fp_mul for fp_mul_proto #(
    param Mantissa      : u32                  = 8                                  ,
    param Exponent      : u32                  = 7                                  ,
    param IeeeCompliance: bit                  = 0                                  ,
    param Arch          : fp_types::DwMultArch = fp_types::DwMultArch::Pipelined    ,
    const DataWidth     : u32                  = Mantissa + Exponent + 1            ,
    const FpType        : type                 = fp_types_::<Exponent, Mantissa>::fp,
) (
    i_a     : input  FpType   ,
    i_b     : input  FpType   ,
    i_rnd   : input  logic <3>,
    o_z     : output FpType   ,
    o_status: output logic <8>,
) {
    assign o_status = '0;
    let ma_mb   : logic<Mantissa * 2> = i_a.mantissa * i_b.mantissa;
}
```

leads to:
```
Error:   × veryl check failed

Error: unknown_member (link)

  × "i_a" doesn't have member "mantissa"
    ╭─[/home/nathan/research/FFTAccelerator/src/fp_mul.veryl:16:41]
 15 │     assign o_status = '0;
 16 │     let ma_mb   : logic<Mantissa * 2> = i_a.mantissa * i_b.mantissa;
    ·                                         ──────┬─────
    ·                                               ╰── Error location
 17 │ }
    ╰────
  help:

Error: unknown_member (link)

  × "i_b" doesn't have member "mantissa"
    ╭─[/home/nathan/research/FFTAccelerator/src/fp_mul.veryl:16:56]
 15 │     assign o_status = '0;
 16 │     let ma_mb   : logic<Mantissa * 2> = i_a.mantissa * i_b.mantissa;
    ·                                                        ──────┬─────
    ·                                                              ╰── Error location
 17 │ }
    ╰────
```

Thread 1544 (2025-04-20):

format of inst module is not correct

nananapo, 2025-04-20:
```sh
$ veryl --version
veryl 0.15.0-nightly (be253f9 2025-04-20)
```

```veryl
module SubModule () {}
module TopModule {
    inst sub: SubModule ();
}
```
↓veryl fmt
```veryl
module SubModule () {}
module TopModule {
    inst sub: SubModule (

    );
}
```
↓veryl fmt
```veryl
module SubModule () {}
module TopModule {
    inst sub: SubModule (

    );
}
```

Closed 2025-04-21.

Thread 1547 (2025-04-22):

Signal name same as module results in reaching unreachable code

onsdagens, 2025-04-22:
```
module foo () {
    var foo: logic;
}
```
```
veryl build
```
results in

```
[INFO ]   Processing file (<...>/foo.veryl)

thread 'main' panicked at crates/emitter/src/emitter.rs:4480:13:
internal error: entered unreachable code
note: run with `RUST_BACKTRACE=1` environment variable to display a backtrace
```

Closed 2025-04-24.

Thread 1549 (2025-04-22):

Can't call function via modport

nananapo, 2025-04-22:
version
```sh
$ veryl --version
veryl 0.15.0-nightly (a85e3d5 2025-04-22)
```

code
```veryl
interface InterfaceA {
    var ready: logic  ;
    var valid: logic  ;

    modport master {
        ready: input,
        valid: output,
    }

    function ack () -> logic {
        return ready && valid;
    }
}

module ModuleA(
    a1: modport InterfaceA::master,
) {
    inst a2 : InterfaceA;

    let _v1 : logic = a1.ack();
    let _v2 : logic = a2.ack();
}
```

output
```
Error:   × veryl check failed

Error: unknown_member (https://doc.veryl-lang.org/book/07_appendix/02_semantic_error.html#unknown_member)

  × "a1" doesn't have member "ack"
    ╭─[/home/kanataso/Documents/nananapo/aaa/src/a.veryl:20:23]
 19 │
 20 │     let _v1 : logic = a1.ack();
    ·                       ───┬──
    ·                          ╰── Error location
 21 │     let _v2 : logic = a2.ack();
    ╰────
  help:

```

taichi-ishitani, 2025-04-22:
You need to add `import` notation like this.

https://github.com/rggen/rggen-veryl-rtl/blob/master/rggen_bus_if.veryl#L30-L30

nananapo, 2025-04-23:
thanks. but it might not be documented.

Closed 2025-04-23.

Thread 1553 (2025-04-24):

wrong formatting on empty bracket with multiline comment

nananapo, 2025-04-24:
```veryl
module ModuleA {
    /**/
}
```
↓ veryl fmt
```veryl
module ModuleA {
    /**/}
```

Closed 2025-04-28.

Thread 1573 (2025-05-01):

"Error: invisible_identifier" when using interface with prototype in module declaration with modport from $std

janschiefer, 2025-05-01:
Just while preparing a pull request for the [AXI interface implementation](https://github.com/veryl-lang/veryl/issues/1415), I stumbled upon a bug involving visibility control when importing from veryl_std.

Proposed axi_if.veryl in veryl_std: [HERE](https://github.com/janschiefer/veryl/blob/master/crates/std/veryl/src/axi_if/axi_if.veryl)

Excerpt from axi_if.veryl:
```
...
///AXI3 bus package prototype
pub proto package axi3_prototype {
    const ADDRESS_WIDTH   : u32;
    (...)

    type addr_t      ;
    (...)
}

pub package axi3_pkg::<ADDR_W: u32, DATA_W_BYTES: u32, ID_W: u32> for axi3_prototype {
    const ADDRESS_WIDTH   : u32 = ADDR_W;
    (...)
    type addr_t       = logic<ADDRESS_WIDTH>         ;
    (...)
}

pub interface axi3_if::<PKG: axi3_prototype> {

    import PKG::*;

    (...)

    var awaddr : addr_t;

    (...)

  modport slave {
  (...)
   }
(...)

}
...
```

**Test code:**
```
module Module82A () {

    //WORKING
    inst a: $std::axi3_if::<$std::axi3_pkg::<32, 4, 8>>;
    inst b: $std::axi4_if::<$std::axi4_pkg::<32, 4, 8, 8, 8, 8, 8, 8>>;
    inst c: $std::axi4_lite_if::<$std::axi4_lite_pkg::<32, 4>>;

    var r: logic<15>;

    always_comb {
        r[0]  = a.awaddr_ack();
        r[1]  = a.wdata_ack();
        r[2]  = a.bresp_ack();
        r[3]  = a.awaddr_ack();
        r[4]  = a.wdata_ack();
        r[5]  = b.awaddr_ack();
        r[6]  = b.wdata_ack();
        r[7]  = b.bresp_ack();
        r[8]  = b.awaddr_ack();
        r[9]  = b.wdata_ack();
        r[10] = c.awaddr_ack();
        r[11] = c.wdata_ack();
        r[12] = c.bresp_ack();
        r[13] = c.awaddr_ack();
        r[14] = c.wdata_ack();
    }

    inst d: Module82B (
        axi: a,
    );

    inst e: Module82C (
        axi: a,
    );

    inst f: Module82D (
        axi: c,
    );

}

//ERROR: invisible_identifier (link)
module Module82B (
    axi: modport $std::axi3_if::<$std::axi3_pkg::<32, 4, 8>>::slave,
) {}

//ERROR: invisible_identifier (link)
module Module82C (
    axi: modport $std::axi4_if::<$std::axi4_pkg::<32, 4, 8, 8, 8, 8, 8, 8>>::master,
) {}

//ERROR: invisible_identifier (link)
module Module82D (
    axi: modport $std::axi4_lite_if::<$std::axi4_lite_pkg::<32, 4>>::monitor,
) {}
```

**veryl check:**
```
Error:   × veryl check failed

Error: invisible_identifier (link)

  × cannot refer indentifier __axi3_if__$std___axi3_pkg__32__4__8 because it is invisible at here
    ╭─[/home/jschiefer/Code/veryl_dev/veryl/testcases/veryl/82_axi_if.veryl:45:18]
 44 │ module Module82B (
 45 │     axi: modport $std::axi3_if::<$std::axi3_pkg::<32, 4, 8>>::slave,
    ·                  ─────────────────────────┬────────────────────────
    ·                                           ╰── Error location
 46 │ ) {}
    ╰────
  help:

Error: invisible_identifier (link)

  × cannot refer indentifier __axi4_if__$std___axi4_pkg__32__4__8__8__8__8__8__8 because it is invisible at here
    ╭─[/home/jschiefer/Code/veryl_dev/veryl/testcases/veryl/82_axi_if.veryl:49:18]
 48 │ module Module82C (
 49 │     axi: modport $std::axi4_if::<$std::axi4_pkg::<32, 4, 8, 8, 8, 8, 8, 8>>::master,
    ·                  ─────────────────────────────────┬────────────────────────────────
    ·                                                   ╰── Error location
 50 │ ) {}
    ╰────
```

However, if you put axi_if.veryl and the test file in the **same** project directory and remove the "$std::"-prefix before the types, there is no error.

taichi-ishitani, 2025-05-02:
I'm looking into this.

taichi-ishitani, 2025-05-02:
Mangled identifier `__axi4_if__$std___axi4_pkg__32__4__8__8__8__8__8__8` is invalid identifier for SV because it includes `$` charactor.
It should also be fixed.

Closed 2025-05-02.

Thread 1581 (2025-05-03):

format inconsistency between case statement/expression.

nananapo, 2025-05-03:
```veryl
module TopModule {
    always_comb {
        case 0 {
            0: {
                   //
               }
            1234567890: {
                            //
                        }
            1: if 0 == 0 {
                // same as case/switch
            }
            2345678901: if 0 == 0 {
                //
            }
            default: {}
        }
    }
    let _a: logic = case 0 {
        2: {
            0 //
        },
        3456789012: {
            0 //
        },
        3: {
            0 //
        },
        4                    : case 0 { // <- strange spaces after 4
            111111111111111111111: 0,
            default              : 0, //
        },
        5678901234: {
            0 //
        },
        default: 0,
    };
}
```

I think it would be nice if it is formatted to
```veryl
module TopModule {
    always_comb {
        case 0 {
            0: {
                //
            }
            1234567890: {
                //
            }
            1: if 0 == 0 {
                // same as case/switch
            }
            2345678901: if 0 == 0 {
                //
            }
            default: {}
        }
    }
    let _a: logic = case 0 {
        2: {
            0 //
        },
        3456789012: {
            0 //
        },
        3: {
            0 //
        },
        4: case 0 { // <- strange spaces after 4
            111111111111111111111: 0,
            default              : 0, //
        },
        5678901234: {
            0 //
        },
        default: 0,
    };
}

```

dalance, 2025-05-20:
`4                    : case 0 { // <- strange spaces after 4` is not fixed by #1648 yet.

Closed 2025-05-20.

Thread 1598 (2025-05-07):

Member reference via proto typedef

taichi-ishitani, 2025-05-07:
Proto typedefs have no member information so member referecne via proto typedef like below causes no member error.

```systemverilog
package CommonPkg {
  struct Foo {
    foo: logic,
  }
}

proto package ProtoPkg {
  type Foo;
}

package Pkg for ProtoPkg {
  type Foo = CommonPkg::Foo;
}

module ModuleA::<PKG: ProtoPkg> {
  var _foo: PKG::Foo;
  assign _foo.foo = 0;
}

module ModuleB {
  inst u: ModuleA::<Pkg>;
}
```

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

taichi-ishitani, 2025-05-07:
The above typedef is used to rename the existing type.
To handle this case, the proto typedef needs to be assigned the actual type.

Closed 2025-06-08.

Thread 1603 (2025-05-07):

Can't call generic function having type argument provided by generic parameter

taichi-ishitani, 2025-05-07:
Veryl compiler will panich when emitting function call for generic function having generic argument provided by generic parameter. For example:

```systemverilog
proto package ProtoPkg {
  type T;
}

package Pkg::<W: u32> for ProtoPkg {
  type T = logic<W>;
}

module ModuleA::<PKG: ProtoPkg> {
  function FuncA::<T: type>() -> T {
    return 0 as T;
  }

  function FuncB() -> u32 {
    return FuncA::<PKG::T>();
  }
}

module ModuleB {
  inst u: ModuleA::<Pkg::<8>>;
}
```

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

taichi-ishitani, 2025-05-08:
Generic referece to `FuncA` has a reference to generic parameter `PKG` so it shluld belong to generic module `ModuleA` but it actually belong to `FuncB`.
The reference is not resolved because `FuncB` is non generic function and so generic instance of `FuncA` is not inserted to the symbol table.

Because of this, resolving symbol of the generic instance is failed and the above error is reported.

taichi-ishitani, 2025-05-08:
Swap location of package and module delcrations then the same error appears.

```systemverilog
    module ModuleA::<PKG: ProtoPkg> {
        function FuncB() -> u32 {
            return FuncA::<PKG::T>();
        }
    }
    proto package ProtoPkg {
        type T;
    }
    package Pkg::<W: u32> for ProtoPkg {
        type T = logic<W>;
    }
    module ModuleB {
        inst u: ModuleA::<Pkg::<8>>;
    }
```

taichi-ishitani, 2025-05-08:
`symbol_table::resolve` method tries to resolve not only symbol for generic parameter but also symbol for type of generic parameter.
https://github.com/veryl-lang/veryl/blob/b72460830b85d82b8f6d7e4a209d1dfbb8ba06c7/crates/analyzer/src/symbol_table.rs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

For the above case, resolving symbol for `PKG` is failed because symbol for `ProtoPkg` has not been inserted.

Closed 2025-05-08.

Thread 1613 (2025-05-12):

Can't use parameter/localparam as generic parameter of generic function

nananapo, 2025-05-12:
```veryl
package PkgX {
    const WIDTH: u32 = 0;
}

module ModuleA #(
    param PARAM_WIDTH: u32 = 0,
) {
    const LOCAL_WIDTH: u32 = 1;

    function FuncA::<WIDTH: u32> () -> logic {
        return 0;
    }

    let _a: logic = FuncA::<PkgX::WIDTH>();
    let _b: logic = FuncA::<LOCAL_WIDTH>();
    let _c: logic = FuncA::<PARAM_WIDTH>();
}
```

```
 ]8;;https://doc.veryl-lang.org/book/07_appendix/02_semantic_error.html#mismatch_type \mismatch_type (link) ]8;; \

  💥 "LOCAL_WIDTH" is expected to "u32", but it is "parameter"
    ╭─[:15:29]
 14 │     let _a: logic = FuncA::<PkgX::WIDTH>();
 15 │     let _b: logic = FuncA::<LOCAL_WIDTH>();
    ·                             ─────┬─────
    ·                                  ╰── Error location
 16 │     let _c: logic = FuncA::<PARAM_WIDTH>();
    ╰────
  help:
 ]8;;https://doc.veryl-lang.org/book/07_appendix/02_semantic_error.html#mismatch_type \mismatch_type (link) ]8;; \

  💥 "PARAM_WIDTH" is expected to "u32", but it is "parameter"
    ╭─[:16:29]
 15 │     let _b: logic = FuncA::<LOCAL_WIDTH>();
 16 │     let _c: logic = FuncA::<PARAM_WIDTH>();
    ·                             ─────┬─────
    ·                                  ╰── Error location
 17 │ }
    ╰────
  help:
```

taichi-ishitani, 2025-05-12:
Can you check if this PR can resolve your issue?

Closed 2025-05-13.

Thread 1619 (2025-05-12):

Can't import generic function

nananapo, 2025-05-12:
```a.veryl
import pkgB::funcB;

module ModuleA{
    initial {
        funcB::<0>();
    }
}
```

```b.veryl
package pkgB {
    function funcB::<W:u32>() {
    }
}
```

```sh
Error:   × veryl check failed

Error: mismatch_generics_arity (https://doc.veryl-lang.org/book/07_appendix/02_semantic_error.html#mismatch_generics_arity)

  × generics "funcB" has 1 generic arguments, but 0 arguments are supplied
   ╭─[/home/kanataso/Documents/aaa/src/a.veryl:1:8]
 1 │ import pkgB::funcB;
   ·        ─────┬─────
   ·             ╰── Error location
 2 │
   ╰────
  help: fix generics arguments
```

taichi-ishitani, 2025-05-14:
@dalance ,

Currently, import declaration with generic instance for function causes the `invalid_import` error.
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

Should we accept this declaratoin too?
I think generic function, struct and union should be imported as-is but not as their generic instances.

Closed 2025-05-16.

Thread 1625 (2025-05-15):

Can't use member of generic interface with alias

nananapo, 2025-05-15:
```a.veryl
interface memif::<W: u32> {
    var a: logic<W>;
    var b: logic<W>;
    modport master {
        a: input ,
        b: output,
    }
}

alias interface Mem10 = memif::<10>;

module Top (
  port_if1: modport memif::<10>::master,
  port_if2: modport Mem10::master,
) {
    assign port_if1.b = port_if1.a;
    assign port_if2.b = port_if2.a;

    function FuncA (
        master: modport memif::<10>::master,
    ) {
        master.b = master.a;
    }
    function FuncB (
        master: modport Mem10::master,
    ) {
        master.b = master.a;
    }
}
```

```
 ]8;;https://doc.veryl-lang.org/book/07_appendix/02_semantic_error.html#unknown_member \unknown_member (link) ]8;; \

  💥 "port_if2" doesn't have member "b"
    ╭─[:17:12]
 16 │     assign port_if1.b = port_if1.a;
 17 │     assign port_if2.b = port_if2.a;
    ·            ─────┬────
    ·                 ╰── Error location
 18 │
    ╰────
  help:
 ]8;;https://doc.veryl-lang.org/book/07_appendix/02_semantic_error.html#unknown_member \unknown_member (link) ]8;; \

  💥 "port_if2" doesn't have member "a"
    ╭─[:17:25]
 16 │     assign port_if1.b = port_if1.a;
 17 │     assign port_if2.b = port_if2.a;
    ·                         ─────┬────
    ·                              ╰── Error location
 18 │
    ╰────
  help:
 ]8;;https://doc.veryl-lang.org/book/07_appendix/02_semantic_error.html#unknown_member \unknown_member (link) ]8;; \

  💥 "master" doesn't have member "b"
    ╭─[:27:9]
 26 │     ) {
 27 │         master.b = master.a;
    ·         ────┬───
    ·             ╰── Error location
 28 │     }
    ╰────
  help:
 ]8;;https://doc.veryl-lang.org/book/07_appendix/02_semantic_error.html#unknown_member \unknown_member (link) ]8;; \

  💥 "master" doesn't have member "a"
    ╭─[:27:20]
 26 │     ) {
 27 │         master.b = master.a;
    ·                    ────┬───
    ·                        ╰── Error location
 28 │     }
    ╰────
  help:
```

nananapo, 2025-05-15:
Sorry, I confused  ```alias``` with ```type``` declaration.

Closed 2025-05-16.

Thread 1626 (2025-05-15):

Can't use imported value in alias declaration

nananapo, 2025-05-15:
```top.veryl
import Pkg::*;
interface memif::<W: u32> {}
alias interface Mem1 = memif::<Pkg::W>;
alias interface Mem2 = memif::<W>;
```

```pkg.veryl
package Pkg {
    const W:u32 = 10;
}
```

```
Error:   × veryl check failed

Error: undefined_identifier (https://doc.veryl-lang.org/book/07_appendix/02_semantic_error.html#undefined_identifier)

  × W is undefined
   ╭─[/home/kanataso/Documents/nananapo/aaa/src/top.veryl:4:32]
 3 │ alias interface Mem1 = memif::<Pkg::W>;
 4 │ alias interface Mem2 = memif::<W>;
   ·                                ┬
   ·                                ╰── Error location
   ╰────
  help:
```

Thread 1627 (2025-05-15):

panick when using modport in function definition

nananapo, 2025-05-15:
```top.veryl
interface InterfaceA {
    var a:logic;
    modport master {a:output}
}

module Top{
    inst a1 : InterfaceA;
    inst a2 : InterfaceA;

    function assignA(
       a: modport InterfaceA::master
    ) {
        a.a = 0;
    }

    always_comb {
        assignA(a1);
    }
}
```

nananapo, 2025-05-15:
```
thread 'main' panicked at crates/emitter/src/expaneded_modport.rs:158:18:
called `Option::unwrap()` on a `None` value
stack backtrace:
   0:     0x55f08b0ccb1f - <std::sys::backtrace::BacktraceLock::print::DisplayBacktrace as core::fmt::Display>::fmt::h6d42cc84fc840290
   1:     0x55f08ae26293 - core::fmt::write::h5af61a909e3ec64d
   2:     0x55f08b0cc212 - std::io::Write::write_fmt::h5a7b54aa6e4a315d
   3:     0x55f08b0cc983 - std::sys::backtrace::BacktraceLock::print::h555579e7396c26ac
   4:     0x55f08b0cbfdc - std::panicking::rust_panic_with_hook::h541791bcc774ef34
   5:     0x55f08b107c55 - std::panicking::begin_panic_handler::{{closure}}::h6479a2f0137c7d19
   6:     0x55f08b107be9 - std::sys::backtrace::__rust_end_short_backtrace::ha04e7c0fc61ded91
   7:     0x55f08b1081cc - rust_begin_unwind
   8:     0x55f08ad08b7f - core::panicking::panic_fmt::h5764ee7030b7a73d
   9:     0x55f08ad08bcb - core::panicking::panic::had768957450a0f86
  10:     0x55f08ad08de8 - core::option::unwrap_failed::hb62b1ad0e5e99b27
  11:     0x55f08b6c5ebd - veryl_emitter::expaneded_modport::ExpandModportConnectionsTable::expand::hc7c749a0ec447b2c
  12:     0x55f08b63791c - veryl_emitter::emitter::Emitter::emit_function_call::h34bab3466f6aad04
  13:     0x55f08b5e93d4 - <veryl_emitter::emitter::Emitter as veryl_parser::veryl_walker::VerylWalker>::identifier_statement::had1ad21f15b1001e
  14:     0x55f08b5e82a6 - veryl_emitter::emitter::Emitter::emit_statement_block::h95e9af05aa7ea602
  15:     0x55f08b663970 - <veryl_emitter::emitter::Emitter as veryl_parser::veryl_walker::VerylWalker>::module_group::h5817d1a328fab1ff
  16:     0x55f08b5debc7 - <veryl_emitter::emitter::Emitter as veryl_parser::veryl_walker::VerylWalker>::module_declaration::hd1161138ec9dc627
  17:     0x55f08b5cc4e5 - <veryl_emitter::emitter::Emitter as veryl_parser::veryl_walker::VerylWalker>::description_group::hb1fd4ea6bae28bef
  18:     0x55f08b5c98ec - <veryl_emitter::emitter::Emitter as veryl_parser::veryl_walker::VerylWalker>::veryl::ha2d2e98f217a2afe
  19:     0x55f08b37c91c - veryl::cmd_build::CmdBuild::exec::he404349b378b95a9
  20:     0x55f08ad418d5 - veryl::main::h38eae2dbd2f10841
  21:     0x55f08b398103 - std::sys::backtrace::__rust_begin_short_backtrace::ha1c358e5923536b6
  22:     0x55f08ad44a39 - main
  23:     0x7f7c55b781ca - __libc_start_call_main
                               at ./csu/../sysdeps/nptl/libc_start_call_main.h:58:16
  24:     0x7f7c55b7828b - __libc_start_main_impl
                               at ./csu/../csu/libc-start.c:360:3
  25:     0x55f08ad3d385 - _start
  26:                0x0 - <unknown>```

Closed 2025-05-16.

Thread 1673 (2025-05-26):

Anonymous identifiers disallowed in modules with generic parameters

onsdagens, 2025-05-26:
Hi!

```
module ModuleA::<Foo: u32>(
	x: output logic
) {
	assign x = 1;
}

module ModuleB {
    inst instA: ModuleA::<1> (
        x: _,
    );
}
```
fails to build with

```
Error: anonymous_identifier_usage (link)

  × Anonymous identifier can't be placed at here
    ╭─[<...>/src/test.veryl:9:12]
  8 │     inst instA: ModuleA::<1> (
  9 │         x: _,
    ·            ┬
    ·            ╰── Error location
 10 │     );
    ╰────
  help:
```

If the generic parameter is removed from ModuleA, it builds fine, so i think the issue is somewhere there.

```
module ModuleA(
	x: output logic
) {
	assign x = 1;
}

module ModuleB {
    inst instA: ModuleA (
        x: _,
    );
}
```

taichi-ishitani, 2025-05-26:
I think your issue is resolved by #1651.
Can you try to use the nightly build version?

onsdagens, 2025-05-26:
Yep, seems to work now, thanks!

Thread 1674 (2025-05-26):

Resolving of local nested dependencies

onsdagens, 2025-05-26:
Hi!

Assuming a file structure like this:

```
top/
├─ Veryl.toml
├─ dep/
│  ├─ Veryl.toml
│  ├─ subdep/
│  │  ├─ Veryl.toml
```
And a (local) dependency tree such that `top` depends on `dep` which depends on `subdep`

`top` will not build if  `Veryl.toml` of `dep` specifies `subdep = {version = "0.1.0", path="./subdep/"}`.

It does however resolve if the path provided in `Veryl.toml` of `dep`  is relative to `top` (i.e. `subdep = {version = "0.1.0", path="./dep/subdep/"}`)

taichi-ishitani, 2025-07-29:
I think this issue has beenn resolved by #1700.
The latest release includes this PR.

Can you check if your issue is also resolved?

onsdagens, 2025-07-29:
Seems resolved with latest Veryl. Thanks!

Thread 1684 (2025-05-30):

VCS does not support struct declaration in generate blocks

taichi-ishitani, 2025-05-30:
VCS does not support struct declaration in generate blocks.

```
Error-[SV-NYI-CTDIG] Unsupported SystemVerilog feature
/home/ishitani/workspace/rggen-sample-testbench/sim/apb/veryl/dependencies/rggen/rggen_adapter_common.sv, 188
  Complex types declared inside generate block can't be referred from outside.
  Please declare the type outside generate block.
```

Veryl should report error or warning for this.

Thread 1707 (2025-06-09):

Spurious "unassign variable" when assigning in if/else

onsdagens, 2025-06-09:
Hi!

```
module Foo (
    bar: output logic,
    baz: output logic,
) {
    always_comb {
        if (true) {
            bar = 0;
            baz = bar;
        } else {
            bar = 1;
            baz = 0;
        }
    }
}
```

```
veryl check
```
returns
```
Warning: unassign_variable (link)

  ⚠ bar is unassigned
   ╭─[/.../foo.veryl:2:5]
 1 │ module Foo (
 2 │     bar: output logic,
   ·     ─┬─
   ·      ╰── Error location
 3 │     baz: output logic,
   ╰────
  help:
```

Interestingly enough,

```
module Foo (
    bar: output logic,
    baz: output logic,
) {
    always_comb {
        if (true) {
            bar = 0;
            baz = 0;
        } else {
            bar = 1;
            baz = bar;
        }
    }
}
```

passes the check (as i would expect).

onsdagens, 2025-06-09:
Even more,

```
module Foo (
    bar: output logic,
    baz: output logic,
) {
    always_comb {
        bar = 1;
        if (true) {
            bar = 0;
            baz = bar;
        } else {
            bar = 1;
            baz = 0;
        }
    }
}
```
fails the check with the same error, while

```
module Foo (
    bar: output logic,
    baz: output logic,
) {
    always_comb {
        bar = 1;
        if (true) {
            bar = 0;
            baz = bar;
        } else {
            baz = 0;
        }
    }
}
```

```
module Foo (
    bar: output logic,
    baz: output logic,
) {
    always_comb {
        bar = 1;
        if (true) {
            bar = 0;
            baz = 1;
        } else {
            bar = 1;
            baz = 0;
        }
    }
}
```
pass.

Closed 2025-06-11.

Thread 1716 (2025-06-17):

Wrong filelist order

taichi-ishitani, 2025-06-17:
Filelist order is incorrect if there is a reference to a item defined in a package with namespace resolution operator.

Example:

`a/a_pkg.veryl`

```systemverilog
package a_pkg {
  type Foo = logic<2>;
}
```

`b/b_pkg.veryl`

```systemverilog
package b_pkg {
  const N_FIELDS: u32 = 2;
  struct Bar {
    bar: a_pkg::Foo<N_FIELDS>,
  }
}
```

The generated filelist for the above example should be

```
a/a_pkg.sv
b/b_pkg.sv
```

But actual filelist is

```
b/b_pkg.sv
a/a_pkg.sv
```

taichi-ishitani, 2025-06-17:
For the above case, a dag between struct `Bar` and package `a_pkg` is inserted but not between package `b_pkg` and package `a_pkg`.
However, Veryl uses dags for module, interface and package but not struct to generate filelist.
Due to this, wrong filelist is generated.

Closed 2025-06-18.

Thread 1721 (2025-06-18):

Panic for imported proto item used in function

taichi-ishitani, 2025-06-18:
Veryl compiler is panicked if imported proto item is used in a function.

Example:

```systemverilog
proto package a_proto_pkg {
  type foo;
}
package a_pkg::<W: u32> for a_proto_pkg {
  type foo = logic<W>;
}
module sub_a::<PKG: a_proto_pkg> {
  import PKG::*;
  function f() -> foo {
    return 0;
  }
}
module top_a {
  inst u: sub_a::<a_pkg::<32>>;
}
```

```
$ RUST_BACKTRACE=1 ~/workspace/veryl/veryl/target/debug/veryl build
[INFO ]   Processing file (/home/taichi/workspace/temp/veryl/8/a.veryl)

thread 'main' panicked at crates/analyzer/src/symbol_path.rs:464:34:
called `Option::unwrap()` on a `None` value
stack backtrace:
   0: rust_begin_unwind
   1: core::panicking::panic_fmt
   2: core::panicking::panic
   3: core::option::unwrap_failed
   4: veryl_analyzer::symbol_path::GenericSymbolPath::resolve_imported
   5: veryl_analyzer::type_dag::TypeDag::insert_path_with_generic_map
   6: veryl_analyzer::type_dag::TypeDag::insert_path
   7: veryl_analyzer::type_dag::TypeDag::apply
   8: veryl_analyzer::type_dag::apply::{{closure}}
   9: std::thread::local::LocalKey<T>::try_with
  10: std::thread::local::LocalKey<T>::with
  11: veryl_analyzer::type_dag::apply
  12: veryl_analyzer::analyzer::Analyzer::analyze_post_pass1
  13: veryl::cmd_build::CmdBuild::exec
  14: veryl::main
  15: core::ops::function::FnOnce::call_once
note: Some details are omitted, run with `RUST_BACKTRACE=full` for a verbose backtrace.
```

taichi-ishitani, 2025-06-19:
Resolving `imported` for enum member also causes panic at the same location.
The parent enum declaration is imported but not the enum member so this issue is appeared.

To resolve this situation, we need to execute `resolve_imported` to the parent enum declaration if the path is to a enum member.

Closed 2025-06-20.

Thread 1730 (2025-06-25):

Can't use expression with `()` for cast operation

taichi-ishitani, 2025-06-25:
Following code causes a syntax error.

```systemverilog
module ModuleA {
  let _a: logic<8> = 1'b0 as (8);
  let _b: logic<8> = {1'b0} as (8);
}
```

```
$ ~/workspace/veryl/veryl/target/debug/veryl build
[INFO ]   Processing file (/home/taichi/workspace/temp/veryl/11/a.veryl)
Error: ParserError::SyntaxError

  × Unexpected token: '('
   ╭─[/home/taichi/workspace/temp/veryl/11/a.veryl:2:30]
 1 │ module ModuleA {
 2 │   let _a: logic<8> = 1'b0 as (8);
   ·                              ┬
   ·                              ╰── Error location
 3 │   let _b: logic<8> = {1'b0} as (8);
   ╰────
  help:
```

Thread 1731 (2025-06-25):

Can't import items defined in proto package

taichi-ishitani, 2025-06-25:
Following code causes `invalid_import` error.

```systemverilog
proto package ProtoPkg {
    const A: u32;
}

module ModuleA::<PKG: ProtoPkg> {
  import PKG::A;
}
```

```
 ]8;;https://doc.veryl-lang.org/book/07_appendix/02_semantic_error.html#invalid_import \invalid_import (link) ]8;; \

  💥 This item can't be imported
   ╭─[:6:10]
 5 │ module ModuleA::<PKG: ProtoPkg> {
 6 │   import PKG::A;
   ·          ───┬──
   ·             ╰── Error location
 7 │ }
   ╰────
  help: fix import item
```

Closed 2025-06-26.

Thread 1733 (2025-06-26):

Fail resolving identifier of generic argument

taichi-ishitani, 2025-06-26:
refs: https://discord.com/channels/1352922667937824779/1352924141048561705/1387169168343695531

Veryl reports `mismatch_type` error when resolving generic parameter if the package given as the generic argument is defined before its proto type is defined.

Example

01_pkg.veryl
```systemverilog
package Pkg for ProtoPkg {
  const V: u32 = 0;
}
```

02_proto.veryl
```systemverilog
proto package ProtoPkg {
  const V: u32;
}
```

03_sub.veryl
```systemverilog
module Sub::<PKG: ProtoPkg> {
}
```

04_top.veryl
```systemverilog
module Top {
  inst u_sub: Sub::<Pkg>;
}
```

Veryl reports the following error when checking the above example project.

```
$ veryl +latest check
[INFO ]   Processing file (/home/taichi/workspace/temp/veryl/12/01_pkg.veryl)
[INFO ]   Processing file (/home/taichi/workspace/temp/veryl/12/02_proto.veryl)
[INFO ]   Processing file (/home/taichi/workspace/temp/veryl/12/03_sub.veryl)
[INFO ]   Processing file (/home/taichi/workspace/temp/veryl/12/04_top.veryl)
Error:   × veryl check failed

Error: mismatch_type (link)

  × "Pkg " is expected to "proto ProtoPkg", but it is "identifier"
   ╭─[/home/taichi/workspace/temp/veryl/12/04_top.veryl:2:21]
 1 │ module Top {
 2 │   inst u_sub: Sub::<Pkg>;
   ·                     ─┬─
   ·                      ╰── Error location
 3 │ }
   ╰────
  help:
```

taichi-ishitani, 2025-06-26:
Veryl also reports the same error for the code below.

```systemverilog
package Pkg for ProtoPkg {
  const V: u32 = 0;
}

proto package ProtoPkg {
  const V: u32;
}

module Sub::<PKG: ProtoPkg> {
}

module Top {
  inst u_sub: Sub::<Pkg>;
}
```

```
 ]8;;https://doc.veryl-lang.org/book/07_appendix/02_semantic_error.html#mismatch_type \mismatch_type (link) ]8;; \

  💥 "Pkg " is expected to "proto ProtoPkg", but it is "identifier"
    ╭─[:13:21]
 12 │ module Top {
 13 │   inst u_sub: Sub::<Pkg>;
    ·                     ─┬─
    ·                      ╰── Error location
 14 │ }
    ╰────
  help:
```

Closed 2025-06-27.

Thread 1765 (2025-07-08):

Unexpected cyclic dependencies

dalance, 2025-07-08:
https://github.com/nananapo/bluecore

v0.16.1 works fine, but the latest fails.

```
Error: cyclic_type_dependency (https://doc.veryl-lang.org/book/07_appendix/02_semantic_error.html#cyclic_type_dependency)

  × Cyclic dependency between aclint_if and core
   ╭─[/home/hatta/work/repos/veryl-discovery/build/nananapo/bluecore/core/src/core.veryl:4:8]
 3 │
 4 │ module core (
   ·        ──┬─
   ·          ╰── Error location
 5 │     clk     : input   clock               ,
   ╰────
  help:
```

dalance, 2025-07-08:
This issue is caused by https://github.com/veryl-lang/veryl/pull/1710.

taichi-ishitani, 2025-07-08:
This error is caused by

* resolve `UInt64` in [`aclint_if`](https://github.com/nananapo/bluecore/blob/a8630c5c1334fa2a1ece8ed06f1e293a7d979e91/core/src/aclint_if.veryl#L6) before inserting dag
    * `resolve_imported` adds namespace prefix to the given path
    * as a result, `UInt64` becomes `core::eei::UInt64` (core is the project namespace)
    * resolve result is module `core` beucase start namespace is `core::aclint_if`
    * dag between module `core` and interface `aclint_if` is inserted
* resolve `aclint_if` in module [`core`](https://github.com/nananapo/bluecore/blob/a8630c5c1334fa2a1ece8ed06f1e293a7d979e91/core/src/core.veryl#L10)
    * dag between module `core` and interface `aclint_if` (reverse order) is being inserted.
    * dag between module `core` and interface `aclint_if` has already been inserted
    * cyclic error is reported

`resolve_imported` tries to remove the project prefix from the result.
https://github.com/veryl-lang/veryl/blob/a46aef58f2c33c4c7e82493b5c99af137d969329/crates/analyzer/src/symbol_path.rs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
However, `namespace_table::get_default()` returns `$std` so the project prefix is not removed.

Closed 2025-07-08.

Thread 1771 (2025-07-09):

Can't use struct type referenced via proto package for struct literal

taichi-ishitani, 2025-07-09:
Veryl compiler reports `unknown_member` error for a struct literal typed by a struct type referenced via a proto package.

```systemverilog
package FooPkg {
    struct Foo {
        foo: logic,
    }
}

proto package BarProtoPkg {
    type Foo = FooPkg::Foo;
}

package BarPkg for BarProtoPkg {
    type Foo = FooPkg::Foo;
}

module ModuleA::<PKG: BarProtoPkg> {
    let _foo: PKG::Foo = PKG::Foo'{ foo: 0 };
}

module ModuleB {
    inst u: ModuleA::<BarPkg>;
}
```

```
 ]8;;https://doc.veryl-lang.org/book/07_appendix/02_semantic_error.html#unknown_member \unknown_member (link) ]8;; \

  💥 "Foo" doesn't have member "foo"
    ╭─[:16:37]
 15 │ module ModuleA::<PKG: BarProtoPkg> {
 16 │     let _foo: PKG::Foo = PKG::Foo'{ foo: 0 };
    ·                                     ─┬─
    ·                                      ╰── Error location
 17 │ }
    ╰────
  help:
```

taichi-ishitani, 2025-07-09:
Veryl compiler reports the error for struct type referenced via typedef.

```systemverilog
package FooPkg {
    struct Foo {
        foo: logic,
    }
}

package BarPkg {
    type Foo = FooPkg::Foo;
}

module ModuleA {
    let _foo: BarPkg::Foo = BarPkg::Foo'{ foo: 0 };
}
```

```
 ]8;;https://doc.veryl-lang.org/book/07_appendix/02_semantic_error.html#unknown_member \unknown_member (link) ]8;; \

  💥 "Foo" doesn't have member "foo"
    ╭─[:12:43]
 11 │ module ModuleA {
 12 │     let _foo: BarPkg::Foo = BarPkg::Foo'{ foo: 0 };
    ·                                           ─┬─
    ·                                            ╰── Error location
 13 │ }
    ╰────
  help:
```

Closed 2025-07-11.

Thread 1773 (2025-07-09):

Can't evaluate `msb` for type imported from proto package

taichi-ishitani, 2025-07-09:
Veryl compiler reports an `unknown_msb` error for a variable of which type is imported from a proto package.

```systemverilog
proto package foo_proto_pkg {
  type Foo = logic<2>;
}

module ModuleA::<PKG: foo_proto_pkg> {
  import PKG::*;
  let foo     : Foo   = 0;
  let _msb_foo: logic = foo[msb];
}

package bar_pkg {
  type Bar = logic<2>;
}

module ModuleB {
  import bar_pkg::*;
  let bar     : Bar   = 0;
  let _msb_bar: logic = bar[msb];
}
```

```
 ]8;;https://doc.veryl-lang.org/book/07_appendix/02_semantic_error.html#unknown_msb \unknown_msb (link) ]8;; \

  💥 resolving msb is failed
   ╭─[:8:29]
 7 │   let foo     : Foo   = 0;
 8 │   let _msb_foo: logic = foo[msb];
   ·                             ─┬─
   ·                              ╰── Error location
 9 │ }
   ╰────
  help:
```

Thread 1776 (2025-07-10):

Can't evaluate `msb` for array item selected by loop variable

taichi-ishitani, 2025-07-10:
Veryl compiler reports `invalid_msb` error for array items selected by loop variables.
No error is reported for array items selected by number literals.

```systemverilog
module ModuleA {
  var _foo: logic<2, 3>;
  var _bar: logic<2, 3>;
  var _baz: logic<2, 3>;

  for i in 0..2 :g {
    always_comb {
      _foo[i][msb:0] = 0;
    }
  }

  always_comb {
    for i: u32 in 0..2 {
      _bar[i][msb:0] = 0;
    }
  }

  always_comb {
    _baz[0][msb:0] = 0;
    _baz[1][msb:0] = 0;
  }
}
```

```
 ]8;;https://doc.veryl-lang.org/book/07_appendix/02_semantic_error.html#invalid_msb \invalid_msb (link) ]8;; \

  💥 msb can't be placed at here
   ╭─[:8:15]
 7 │     always_comb {
 8 │       _foo[i][msb:0] = 0;
   ·               ─┬─
   ·                ╰── Error location
 9 │     }
   ╰────
  help: remove msb
 ]8;;https://doc.veryl-lang.org/book/07_appendix/02_semantic_error.html#invalid_msb \invalid_msb (link) ]8;; \

  💥 msb can't be placed at here
    ╭─[:14:15]
 13 │     for i: u32 in 0..2 {
 14 │       _bar[i][msb:0] = 0;
    ·               ─┬─
    ·                ╰── Error location
 15 │     }
    ╰────
  help: remove msb
```

Closed 2025-07-11.

Thread 1779 (2025-07-10):

Support `for` loop in descending order

taichi-ishitani, 2025-07-10:
Currently, `for` loop in ascending order is only supported.
I'd like to add `fo` loop in descending order support too.

taichi-ishitani, 2025-07-10:
How about `reverse for` keyword for `for` loop in descending order?

Veryl
```systemverilog
reverce for i: u32 in 0..32 {
}

reverce for i: u32 in 0..=32 {
}
```

Generated SV
```systemverilog
for (int i = (32 - 1);i >= 0;i--) begin
end

for (int i = 32;i >= 0;i--) begin
end
```

taichi-ishitani, 2025-07-10:
Or use `rev` instead of `in`?

```systemverilog
for i: u32 rev 0..32 {
}
for i: u32 rev 0..=32 {
}
```

Closed 2025-07-24.

Thread 1801 (2025-07-23):

`veryl fmt` for dependent projects

taichi-ishitani, 2025-07-23:
Currently, `veryl fmt` is not executed only for the main project but also for dependent projects.
Therefore, a lot of unnecessary formatter errors is reported if formatter settings for the main project and dependent projects are different.

For example:

```toml
[project]
name        = "veryl_testcase"
version     = "0.1.6"
authors     = ["dalance@gmail.com"]
description = "Testcases for test"
license     = "MIT"
repository  = "https://github.com/veryl-lang/veryl"

[format]
indent_width  = 2

[build]
reset_low_suffix = "_n"
filelist_type    = "absolute"
exclude_std      = false
```

```
[INFO ]   Processing file (/home/taichi/.cache/veryl/std/bf604b35de8c875df00374e4e41e72573a6998268c45abe7b1d4781a47551885/synchronizer/synchronizer.veryl)
Diff in /home/taichi/.cache/veryl/std/bf604b35de8c875df00374e4e41e72573a6998268c45abe7b1d4781a47551885/synchronizer/synchronizer.veryl
1   1    | pub proto module synchronizer #(
2        |-    param WIDTH : u32 = 8,
3        |-    param STAGES: u32 = 2,
    2    |+  param WIDTH : u32 = 8,
    3    |+  param STAGES: u32 = 2,
4   4    | ) (
5        |-    i_clk: input  'd clock       ,
6        |-    i_rst: input  'd reset       ,
7        |-    i_d  : input  's logic<WIDTH>,
8        |-    o_d  : output 'd logic<WIDTH>,
    5    |+  i_clk: input  'd clock       ,
    6    |+  i_rst: input  'd reset       ,
    7    |+  i_d  : input  's logic<WIDTH>,
    8    |+  o_d  : output 'd logic<WIDTH>,
9   9    | );
```

To resulve this, `veryl fmt` should format veryl code for the main project only.

Closed 2025-07-24.

Thread 1806 (2025-07-24):

Can't build `rice` project due to `private namespace` error

taichi-ishitani, 2025-07-24:
Veryl reports a lot of `private namespace` error when building [rice](https://github.com/taichi-ishitani/rice) project.

```
Error: private_namespace ()

  × "rggen" is private namespace
      ╭─[/home/ishitani/workspace/rice/rtl/csr/rice_csr_xlen32.veryl:1880:25]
 1879 │       }
 1880 │       inst u_bit_field: rggen::rggen_bit_field #(
      ·                         ───────────┬──────────
      ·                                    ╰── Error location
 1881 │         WIDTH:              32,
      ╰────
  help:
```

Closed 2025-07-25.

Thread 1832 (2025-08-04):

Can't use const value via alias package as generic arg

taichi-ishitani, 2025-08-04:
Veryl compiler reports `unresolvable_generic_argument` error for the reference to an alias package of which target package defined in ather project.

Example

`a` project

Veryl
```systemverilog
package FooPkg::<V: u32> {
    const FOO: u32 = V;
}
package BarPkg::<V: u32> {
    const BAR: u32 = V;
}
```

`b` project

Veryl
```systemverilog
alias package foo_pkg = a::FooPkg::<32>;
alias package bar_pkg = a::BarPkg::<foo_pkg::FOO>;
```

```
$ veryl check
[INFO ]   Processing file (/home/taichi/workspace/temp/veryl/19/b/b.veryl)
[INFO ]   Processing file (/home/taichi/workspace/temp/veryl/19/a/a.veryl)
Error:   × veryl check failed

Error: unresolvable_generic_argument (link)

  × foo_pkg can't be resolved from the definition of generics
   ╭─[/home/taichi/workspace/temp/veryl/19/b/b.veryl:2:21]
 1 │ alias package foo_pkg = a::FooPkg::<32>;
 2 │ alias package bar_pkg = a::BarPkg::<foo_pkg::FOO>;
   ·                     ───┬──          ──────┬─────
   ·                        │                  ╰── Error location
   ·                        ╰── Definition
   ╰────
  help:
```

taichi-ishitani, 2025-08-05:
https://github.com/veryl-lang/veryl/blob/ce0f4f6eaf73ceba8b8e94da5fd94a0bbc21092a/crates/analyzer/src/reference_table.rs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

`foo_pkg::FOO` is resolved as a symbol for the constant but not the package alias.
Therefore, the `alias_target` returns `None` and so `foo_pkg` is not repalaced with its target package.
Due to this, this error is happened.

Thread 1848 (2025-08-10):

modport direction can't be used within proto module declaration

MurakamiShun, 2025-08-10:
The code below contains an error due to the use of `modport` within the prototype module.
However, I don't think the veryl language specification has any issue with using it.

* Example code
```
interface testIF{
    modport A{}
}

proto module protoA(
    test_if : modport testIF::A,
);

module A for protoA(
    test_if : modport testIF::A,
){}
```
* Error message
```
Error: invalid_direction (link)

  × modport direction can't be placed at here
   ╭─[/home/shun/Desktop/veryl_test/test/src/alias.veryl:7:15]
 6 │ proto module protoA(
 7 │     test_if : modport testIF::A,
   ·               ───┬───
   ·                  ╰── Error location
 8 │ );
   ╰────
  help: remove modport direction
```

Thread 1873 (2025-08-24):

Can't apply reset cast to reset signal referenced via modport

taichi-ishitani, 2025-08-24:
The `invalid_cast` error is reported for a reset signal referenced via a modport.

Example

```systemverilog
interface FooIF {
  var rst_n: reset_async_high;
  modport mp {
    rst_n: input,
  }
}

module ModuleA (
  foo_if: modport FooIF::mp,
) {
  let _rst: reset = foo_if.rst_n as reset;
}
```

```
 ]8;; \invalid_cast (link) ]8;; \

  💥 Casting from non-reset type to reset type is incompatible
    ╭─[:11:21]
 10 │ ) {
 11 │   let _rst: reset = foo_if.rst_n as reset;
    ·                     ──────────┬──────────
    ·                               ╰── Error location
 12 │ }
    ╰────
  help:
```

Closed 2025-09-01.

Thread 1939 (2025-10-02):

Unexpected unassigned at self-reference in the right-hand side

dalance, 2025-10-02:
```systemverilog
module ModuleA {
    var a: logic;
    always_comb {
        a = 0;
        a = a + 1; // this line causes warning
    }
}
```

```
  ⚠️ a is unassigned
   ╭─[:2:9]
 1 │ module ModuleA {
 2 │     var a: logic;
   ·         ┬
   ·         ╰── Error location
 3 │     always_comb {
   ╰────
  help:
```

taichi-ishitani, 2025-10-03:
I'm looking into this.

Closed 2025-10-03.

Thread 1941 (2025-10-03):

MismatchAssignment error with large static number

dalance, 2025-10-03:
```systemverilog
module ModuleA {
    const a: u64 = 64'hfff8000000000000;
}
```

```
⚠️ "4-state value" can't be assigned to "2-state variable"
   ╭─[:2:1]
 1 │ module ModuleA {
 2 │ const a: u64 = 64'hfff8000000000000;
   · ──────────────────┬─────────────────
   ·                   ╰── Error location
 3 │ }
   ╰────
  help:
```

dalance, 2025-10-03:
I'm working on it.

Thread 1945 (2025-10-03):

File lock doesn't have an effect at `cargo test`

dalance, 2025-10-03:
Git operation may conflict by concurrent `veryl` commands.
To prevent it, `flock` is used for exclusive lock like below:

https://github.com/veryl-lang/veryl/blob/1d28b93f749f2326c06badddfb0a223b839858a4/crates/metadata/src/lockfile.rs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

However `cargo test` executes some conflictable tests by thread.
`flock` approach doesn't have an effetct for thread.
So this may cause CI failure.

Closed 2025-10-03.
