veryl-lang/veryl/crates/veryl/src/main.rs

use clap::error::ErrorKind;
use clap::{CommandFactory, Parser};
use clap_complete::aot::Shell;
use console::Style;
use fern::Dispatch;
use log::debug;
use log::{Level, LevelFilter};
use miette::{IntoDiagnostic, Result};
use std::process::ExitCode;
use veryl_metadata::Metadata;

use veryl::*;

#[global_allocator]
static GLOBAL: mimalloc::MiMalloc = mimalloc::MiMalloc;

// ---------------------------------------------------------------------------------------------------------------------
// Main
// ---------------------------------------------------------------------------------------------------------------------

fn main() -> Result<ExitCode> {
    let opt = Opt::parse();

    if opt.list {
        external_subcommand::print_command_list(Opt::command())?;
        return Ok(ExitCode::SUCCESS);
    }

    if let Some(shell) = opt.completion {
        let shell = match shell {
            CompletionShell::Bash => Shell::Bash,
            CompletionShell::Elvish => Shell::Elvish,
            CompletionShell::Fish => Shell::Fish,
            CompletionShell::PowerShell => Shell::PowerShell,
            CompletionShell::Zsh => Shell::Zsh,
        };
        clap_complete::generate(shell, &mut Opt::command(), "veryl", &mut std::io::stdout());
        return Ok(ExitCode::SUCCESS);
    }

    let Some(command) = opt.command else {
        Opt::command()
            .error(
                ErrorKind::MissingSubcommand,
                "'veryl' requires a subcommand but one was not provided",
            )
            .exit();
    };

    let level = if opt.trace {
        LevelFilter::Trace
    } else if opt.verbose {
        LevelFilter::Debug
    } else if opt.quiet {
        LevelFilter::Warn
    } else {
        LevelFilter::Info
    };

    Dispatch::new()
        .format(|out, message, record| {
            let style = match record.level() {
                Level::Error => Style::new().red().bright(),
                Level::Warn => Style::new().yellow().bright(),
                Level::Info => Style::new().green().bright(),
                Level::Debug => Style::new().cyan().bright(),
                Level::Trace => Style::new().magenta().bright(),
            };
            out.finish(format_args!(
                "{} {}{}",
                style.apply_to(format!("[{:<5}]", record.level())),
                " ".repeat(
                    12_usize.saturating_sub(
                        format!("{message}")
                            .split_ascii_whitespace()
                            .next()
                            .unwrap()
                            .len()
                    )
                ),
                message
            ))
        })
        .level(level)
        .level_for("veryl_parser", LevelFilter::Warn)
        .level_for("parol_runtime", LevelFilter::Warn)
        .level_for("scnr", LevelFilter::Warn)
        .level_for("cranelift_codegen", LevelFilter::Warn)
        .level_for("cranelift_jit", LevelFilter::Warn)
        .level_for("cranelift_frontend", LevelFilter::Warn)
        .level_for("cranelift_module", LevelFilter::Warn)
        .level_for("regalloc2", LevelFilter::Warn)
        .chain(std::io::stderr())
        .apply()
        .into_diagnostic()?;

    if let Commands::External(args) = &command {
        return external_subcommand::dispatch(args.clone());
    }

    let (mut metadata, dot_build_lock) = match command {
        Commands::New(_) | Commands::Init(_) | Commands::Translate(_) => {
            // dummy metadata
            (Metadata::create_default("dummy").unwrap(), None)
        }
        Commands::External(_) => unreachable!(),
        _ => {
            let metadata_path = Metadata::search_from_current()?;
            let metadata = Metadata::load(metadata_path)?;

            let dot_build = metadata.project_dot_build_path();
            let dot_build_lock = veryl_path::lock_dir(&dot_build)?;
            (metadata, Some(dot_build_lock))
        }
    };

    let mut stopwatch = StopWatch::new();

    // `veryl test` builds its own components; the other analyzing
    // commands freshen their manifests here.
    if matches!(
        command,
        Commands::Check(_)
            | Commands::Build(_)
            | Commands::Doc(_)
            | Commands::Dump(_)
            | Commands::Synth(_)
            | Commands::Publish(_)
    ) {
        cmd_test::build_component_manifests(&metadata);
    }

    let ret = match command {
        Commands::New(x) => cmd_new::CmdNew::new(x).exec(),
        Commands::Init(x) => cmd_init::CmdInit::new(x).exec(),
        Commands::Fmt(x) => cmd_fmt::CmdFmt::new(x).exec(&mut metadata, opt.quiet),
        // check emits nothing, so it writes no info.toml.
        Commands::Check(x) => cmd_check::CmdCheck::new(x).exec(&mut metadata),
        Commands::Build(x) => {
            let ret = cmd_build::CmdBuild::new(x).exec(
                &mut metadata,
                false,
                opt.quiet,
                None,
                None,
                &[],
                cmd_build::EmitPolicy::Always,
            );
            metadata.save_build_info()?;
            ret
        }
        Commands::Clean(x) => cmd_clean::CmdClean::new(x).exec(&mut metadata),
        Commands::Update(x) => cmd_update::CmdUpdate::new(x).exec(&mut metadata),
        Commands::Publish(x) => cmd_publish::CmdPublish::new(x).exec(&mut metadata),
        Commands::Register(x) => cmd_register::CmdRegister::new(x).exec(&metadata),
        Commands::Migrate(x) => cmd_migrate::CmdMigrate::new(x).exec(&mut metadata, opt.quiet),
        Commands::Doc(x) => cmd_doc::CmdDoc::new(x).exec(&mut metadata),
        Commands::Metadata(x) => cmd_metadata::CmdMetadata::new(x).exec(&mut metadata),
        Commands::Dump(x) => cmd_dump::CmdDump::new(x).exec(&mut metadata),
        Commands::Test(x) => {
            let ret = cmd_test::CmdTest::new(x).exec(&mut metadata);
            metadata.save_build_info()?;
            ret
        }
        Commands::Synth(x) => cmd_synth::CmdSynth::new(x).exec(&mut metadata),
        Commands::Translate(x) => cmd_translate::CmdTranslate::new(x).exec(),
        Commands::External(_) => unreachable!(),
    };

    if let Some(dot_build_lock) = dot_build_lock {
        veryl_path::unlock_dir(dot_build_lock)?;
    }

    debug!("Elapsed time ({} milliseconds)", stopwatch.lap());

    let exit_success = std::env::var("VERYL_FORCE_SUCCESS").is_ok();
    if exit_success || ret? {
        Ok(ExitCode::SUCCESS)
    } else {
        Ok(ExitCode::FAILURE)
    }
}
