veryl-lang/veryl/crates/mdbook/src/main.rs

use clap::{Arg, ArgMatches, Command};
use line_col::LineColLookup;
use mdbook_driver::book::{Book, BookItem};
use mdbook_driver::errors::Error;
use mdbook_preprocessor::{Preprocessor, PreprocessorContext};
use pulldown_cmark::{CodeBlockKind, Event, Parser, Tag, TagEnd};
use regex::Regex;
use semver::{Version, VersionReq};
use similar::{ChangeTag, TextDiff};
use std::io;
use std::process;
use veryl_analyzer::{Analyzer, AnalyzerError, Context};
use veryl_formatter::Formatter;
use veryl_metadata::Metadata;

pub fn make_app() -> Command {
    Command::new("veryl")
        .about("A mdbook preprocessor which does precisely nothing")
        .subcommand(
            Command::new("supports")
                .arg(Arg::new("renderer").required(true))
                .about("Check whether a renderer is supported by this preprocessor"),
        )
}

fn main() {
    let matches = make_app().get_matches();

    let preprocessor = Veryl;

    if let Some(sub_args) = matches.subcommand_matches("supports") {
        handle_supports(&preprocessor, sub_args);
    } else if let Err(e) = handle_preprocessing(&preprocessor) {
        eprintln!("{e}");
        process::exit(1);
    }
}

fn handle_preprocessing(pre: &dyn Preprocessor) -> Result<(), Error> {
    let (ctx, book) = mdbook_preprocessor::parse_input(io::stdin())?;

    let book_version = Version::parse(&ctx.mdbook_version)?;
    let version_req = VersionReq::parse(mdbook_preprocessor::MDBOOK_VERSION)?;

    if !version_req.matches(&book_version) {
        eprintln!(
            "Warning: The {} plugin was built against version {} of mdbook, \
             but we're being called from version {}",
            pre.name(),
            mdbook_preprocessor::MDBOOK_VERSION,
            ctx.mdbook_version
        );
    }

    let processed_book = pre.run(&ctx, book)?;
    serde_json::to_writer(io::stdout(), &processed_book)?;

    Ok(())
}

fn handle_supports(pre: &dyn Preprocessor, sub_args: &ArgMatches) -> ! {
    let renderer = sub_args
        .get_one::<String>("renderer")
        .expect("Required argument");
    let supported = pre.supports_renderer(renderer).unwrap();

    // Signal whether the renderer is supported by exiting with 1 or 0.
    if supported {
        process::exit(0);
    } else {
        process::exit(1);
    }
}

/// A veryl preprocessor.
#[derive(Default)]
pub struct Veryl;

impl Preprocessor for Veryl {
    fn name(&self) -> &str {
        "veryl"
    }

    fn run(&self, _ctx: &PreprocessorContext, mut book: Book) -> Result<Book, Error> {
        let re_hiding_code_line = Regex::new("(?m)^# .*\n").unwrap();
        let re_hiding_code_indicator = Regex::new("(?m)^# ").unwrap();
        let mut context = Context::default();
        let mut in_code = false;
        let mut in_playground = false;
        let mut total_success = true;
        book.for_each_mut(|item| {
            if let BookItem::Chapter(chapter) = item {
                let path = chapter
                    .source_path
                    .as_ref()
                    .map(|x| x.to_string_lossy())
                    .unwrap_or_else(|| "".into());
                let lookup = LineColLookup::new(&chapter.content);
                let mut chapter_skip = true;
                let mut chapter_success = true;
                let mut code_blocks = Vec::new();
                for (event, range) in Parser::new(&chapter.content).into_offset_iter() {
                    match event {
                        Event::Start(Tag::CodeBlock(CodeBlockKind::Fenced(x))) => {
                            if x.as_ref().starts_with("veryl") {
                                in_code = true;
                            }
                            if x.as_ref().starts_with("veryl,playground") {
                                in_playground = true;
                            }
                        }
                        Event::End(TagEnd::CodeBlock) => {
                            in_code = false;
                            in_playground = false;
                        }
                        Event::Text(x) if in_code => {
                            let replaced_code = re_hiding_code_line.replace_all(x.as_ref(), "");
                            code_blocks.push((x.to_string(), replaced_code.to_string()));

                            chapter_skip = false;
                            let x = re_hiding_code_indicator.replace_all(x.as_ref(), "");

                            let ret = veryl_parser::Parser::parse(&x, &"");

                            let (line, col) = lookup.get(range.start);
                            match ret {
                                Err(err) => {
                                    eprintln!("veryl parse failed : {path}:{line}:{col}");
                                    eprintln!("{err}");
                                    total_success = false;
                                    chapter_success = false;
                                }
                                Ok(ret) if in_playground => {
                                    let metadata = Metadata::create_default("codeblock").unwrap();
                                    let prj = &metadata.project.name;

                                    let analyzer = Analyzer::new(&metadata);
                                    analyzer.clear();

                                    let mut errors = vec![];
                                    let mut ir = veryl_analyzer::ir::Ir::default();
                                    errors.append(&mut analyzer.analyze_pass1(prj, &ret.veryl));
                                    errors.append(&mut Analyzer::analyze_post_pass1());
                                    errors.append(&mut analyzer.analyze_pass2(
                                        &ret.veryl,
                                        &mut context,
                                        Some(&mut ir),
                                    ));
                                    errors.append(&mut Analyzer::analyze_post_pass2(&ir));

                                    let errors: Vec<_> = errors
                                        .into_iter()
                                        .filter(|x| {
                                            !matches!(x, AnalyzerError::UnassignVariable { .. })
                                        })
                                        .collect();

                                    if !errors.is_empty() {
                                        eprintln!("veryl analyze failed : {path}:{line}:{col}");
                                        for err in errors {
                                            eprintln!("{err}");
                                        }
                                        total_success = false;
                                        chapter_success = false;
                                    }

                                    let mut formatter = Formatter::new(&metadata);
                                    formatter.format(&ret.veryl, x.as_ref());

                                    if x != formatter.as_str() {
                                        eprintln!("veryl format failed : {path}:{line}:{col}");
                                        let diff =
                                            TextDiff::from_lines(x.as_ref(), formatter.as_str());
                                        for change in diff.iter_all_changes() {
                                            match change.tag() {
                                                ChangeTag::Delete => eprint!("-{change}"),
                                                ChangeTag::Insert => eprint!("+{change}"),
                                                ChangeTag::Equal => (),
                                            }
                                        }
                                        total_success = false;
                                        chapter_success = false;
                                    }
                                }
                                _ => (),
                            }
                        }
                        _ => (),
                    }
                }
                if chapter_skip {
                    eprintln!("veryl check skipped: {path}");
                } else if chapter_success {
                    eprintln!("veryl check success: {path}");
                }
                for (code_block, replaced_code) in code_blocks {
                    chapter.content = chapter.content.replace(&code_block, &replaced_code);
                }
            }
        });

        if total_success {
            Ok(book)
        } else {
            Err(Error::msg("veryl check failed!!!"))
        }
    }

    fn supports_renderer(&self, _renderer: &str) -> Result<bool, Error> {
        Ok(true)
    }
}
