veryl-lang/veryl/testcases/sv/68_std_1.sv

module veryl_testcase_Module68A (
    input  var logic         i_clk  ,
    input  var logic         i_rst_n,
    input  var logic         i_push ,
    input  var logic [8-1:0] i_data ,
    input  var logic         i_pop  ,
    output var logic [8-1:0] o_data 
);
    __std_fifo u (
        .i_clk         (i_clk  ),
        .i_rst_n       (i_rst_n),
        .i_clear       ('0     ),
        .o_empty       (       ),
        .o_almost_full (       ),
        .o_full        (       ),
        .o_word_count  (       ),
        .i_push        (i_push ),
        .i_data        (i_data ),
        .i_pop         (i_pop  ),
        .o_data        (o_data )
    );
endmodule

module veryl_testcase_Module68B (
    input  var logic [2-1:0]        i_select,
    input  var logic [4-1:0][4-1:0] i_d     ,
    output var logic [4-1:0]        o_d 
);
    __std_mux #(
        .WIDTH   (4),
        .ENTRIES (4)
    ) u (
        .i_select (i_select),
        .i_data   (i_d     ),
        .o_data   (o_d     )
    );
endmodule

module veryl_testcase_Module68C
    import __std_selector_pkg::*;
#(
    parameter selector_kind KIND = __std_selector_pkg::selector_kind_ONEHOT,
    parameter int unsigned  N    = 2                                       ,
    parameter type          T    = logic                               
) (
    input  var logic [calc_select_width(N, KIND)-1:0] i_select,
    input  var T     [N-1:0]                          i_d     ,
    output var T                                      o_d 
);

    always_comb o_d = __std___select__KIND__N__T(i_select, i_d);

    function automatic T __std___select_binary__N__T(
        input var logic [__std_selector_pkg::calc_binary_select_width(N)-1:0] sel ,
        input var T     [N-1:0]                                               data
    ) ;
        return data[sel];
    endfunction
    function automatic T __std___select_vector__N__T(
        input var logic [N-1:0] sel ,
        input var T     [N-1:0] data
    ) ;
        localparam int unsigned DEPTH = $clog2(N);
        int unsigned         next_n;
        logic        [N-1:0] next_s;
        T            [N-1:0] next_d;

        next_n = N;
        next_s = sel;
        next_d = data;
        for (int _i = 0; _i < DEPTH; _i++) begin
            int unsigned         current_n;
            logic        [N-1:0] current_s;
            T            [N-1:0] current_d;

            current_n = next_n;
            current_s = next_s;
            current_d = next_d;

            next_n = (current_n / 2) + (current_n % 2);
            for (int j = 0; j < next_n; j++) begin
                logic select_even;

                if ((j + 1) == next_n && (current_n % 2) == 1) begin
                    select_even = 1'b1;
                end else begin
                    select_even = current_s[2 * j + 0];
                end

                if (select_even) begin
                    next_s[j] = current_s[2 * j + 0];
                    next_d[j] = current_d[2 * j + 0];
                end else begin
                    next_s[j] = current_s[2 * j + 1];
                    next_d[j] = current_d[2 * j + 1];
                end
            end
        end

        return next_d[0];
    endfunction
    function automatic T __std___select_onehot__N__T(
        input var logic [N-1:0] sel ,
        input var T     [N-1:0] data
    ) ;
        localparam int unsigned DEPTH = $clog2(N);
        int unsigned         next_n;
        T            [N-1:0] next_d;

        next_n = N;
        for (int i = 0; i < N; i++) begin
            if (sel[i]) begin
                next_d[i] = data[i];
            end else begin
                next_d[i] = T'(0);
            end
        end

        for (int _i = 0; _i < DEPTH; _i++) begin
            int unsigned         current_n;
            T            [N-1:0] current_d;

            current_n = next_n;
            current_d = next_d;

            next_n = (current_n / 2) + (current_n % 2);
            for (int j = 0; j < next_n; j++) begin
                if ((j + 1) == next_n && (current_n % 2) == 1) begin
                    next_d[j] = current_d[2 * j + 0];
                end else begin
                    next_d[j] = T'((current_d[2 * j + 0] | current_d[2 * j + 1]));
                end
            end
        end

        return next_d[0];
    endfunction
    function automatic T __std___select__KIND__N__T(
        input var logic [__std_selector_pkg::calc_select_width(N, KIND)-1:0] sel ,
        input var T     [N-1:0]                                              data
    ) ;
        localparam int unsigned BINARY_SEL_WIDTH = __std_selector_pkg::calc_binary_select_width(N);

        if (N == 1) begin
            return data[0];
        end else if (KIND == __std_selector_pkg::selector_kind_BINARY) begin
            return __std___select_binary__N__T(BINARY_SEL_WIDTH'(sel), data);
        end else if (KIND == __std_selector_pkg::selector_kind_VECTOR) begin
            return __std___select_vector__N__T(N'(sel), data);
        end else begin
            return __std___select_onehot__N__T(N'(sel), data);
        end
    endfunction
endmodule

module veryl_testcase_Module68D
    import __std_selector_pkg::*;
#(
    parameter selector_kind KIND = __std_selector_pkg::selector_kind_ONEHOT,
    parameter int unsigned  N    = 2                                   
) (
    input  var logic [calc_select_width(N, KIND)-1:0] i_select,
    input  var logic [N-1:0]                          i_d     ,
    output var logic                                  o_d 
);

    always_comb o_d = __std___select__KIND__N__lbool(i_select, i_d);

    function automatic logic __std___select_binary__N__lbool(
        input var logic [__std_selector_pkg::calc_binary_select_width(N)-1:0] sel ,
        input var logic [N-1:0]                                               data
    ) ;
        typedef logic T;
        return data[sel];
    endfunction
    function automatic logic __std___select_vector__N__lbool(
        input var logic [N-1:0] sel ,
        input var logic [N-1:0] data
    ) ;
        typedef logic T;
        localparam int unsigned DEPTH = $clog2(N);
        int unsigned         next_n;
        logic        [N-1:0] next_s;
        logic        [N-1:0] next_d;

        next_n = N;
        next_s = sel;
        next_d = data;
        for (int _i = 0; _i < DEPTH; _i++) begin
            int unsigned         current_n;
            logic        [N-1:0] current_s;
            logic        [N-1:0] current_d;

            current_n = next_n;
            current_s = next_s;
            current_d = next_d;

            next_n = (current_n / 2) + (current_n % 2);
            for (int j = 0; j < next_n; j++) begin
                logic select_even;

                if ((j + 1) == next_n && (current_n % 2) == 1) begin
                    select_even = 1'b1;
                end else begin
                    select_even = current_s[2 * j + 0];
                end

                if (select_even) begin
                    next_s[j] = current_s[2 * j + 0];
                    next_d[j] = current_d[2 * j + 0];
                end else begin
                    next_s[j] = current_s[2 * j + 1];
                    next_d[j] = current_d[2 * j + 1];
                end
            end
        end

        return next_d[0];
    endfunction
    function automatic logic __std___select_onehot__N__lbool(
        input var logic [N-1:0] sel ,
        input var logic [N-1:0] data
    ) ;
        typedef logic T;
        localparam int unsigned DEPTH = $clog2(N);
        int unsigned         next_n;
        logic        [N-1:0] next_d;

        next_n = N;
        for (int i = 0; i < N; i++) begin
            if (sel[i]) begin
                next_d[i] = data[i];
            end else begin
                next_d[i] = T'(0);
            end
        end

        for (int _i = 0; _i < DEPTH; _i++) begin
            int unsigned         current_n;
            logic        [N-1:0] current_d;

            current_n = next_n;
            current_d = next_d;

            next_n = (current_n / 2) + (current_n % 2);
            for (int j = 0; j < next_n; j++) begin
                if ((j + 1) == next_n && (current_n % 2) == 1) begin
                    next_d[j] = current_d[2 * j + 0];
                end else begin
                    next_d[j] = T'((current_d[2 * j + 0] | current_d[2 * j + 1]));
                end
            end
        end

        return next_d[0];
    endfunction
    function automatic logic __std___select__KIND__N__lbool(
        input var logic [__std_selector_pkg::calc_select_width(N, KIND)-1:0] sel ,
        input var logic [N-1:0]                                              data
    ) ;
        typedef logic T;
        localparam int unsigned BINARY_SEL_WIDTH = __std_selector_pkg::calc_binary_select_width(N);

        if (N == 1) begin
            return data[0];
        end else if (KIND == __std_selector_pkg::selector_kind_BINARY) begin
            return __std___select_binary__N__lbool(BINARY_SEL_WIDTH'(sel), data);
        end else if (KIND == __std_selector_pkg::selector_kind_VECTOR) begin
            return __std___select_vector__N__lbool(N'(sel), data);
        end else begin
            return __std___select_onehot__N__lbool(N'(sel), data);
        end
    endfunction
endmodule

module veryl_testcase___Module68E____std___axi4_pkg__32__8__8__8__8__8__8__8____std___axi4_lite_pkg____std___axi4_pkg__32__8__8__8__8__8__8__8_ADDRESS_WIDTH____std___axi4_pkg__32__8__8__8__8__8__8__8_DATA_WIDTH_BYTES____std___axi4_pkg__32__8__8__8__8__8__8__8_ID_LENGTH____std___axi4_stream_pkg____std___axi4_pkg__32__8__8__8__8__8__8__8_DATA_WIDTH_BYTES__2____std___axi4_pkg__32__8__8__8__8__8__8__8_ID_LENGTH__5




(
    __std___axi4_if____std___axi4_pkg__32__8__8__8__8__8__8__8.slave                                                                                                                                                            a,
    __std___axi4_lite_if____std___axi4_lite_pkg____std___axi4_pkg__32__8__8__8__8__8__8__8_ADDRESS_WIDTH____std___axi4_pkg__32__8__8__8__8__8__8__8_DATA_WIDTH_BYTES____std___axi4_pkg__32__8__8__8__8__8__8__8_ID_LENGTH.slave b,
    __std___axi4_stream_if____std___axi4_stream_pkg____std___axi4_pkg__32__8__8__8__8__8__8__8_DATA_WIDTH_BYTES__2____std___axi4_pkg__32__8__8__8__8__8__8__8_ID_LENGTH__5.receiver                                             c
);




    always_comb begin
        a.awready = 0;
        a.wready  = 0;
        a.bvalid  = 0;
        a.bresp   = __std___axi4_pkg__32__8__8__8__8__8__8__8::resp_t'(0);
        a.bid     = __std___axi4_pkg__32__8__8__8__8__8__8__8::id_t'(0);
        a.buser   = __std___axi4_pkg__32__8__8__8__8__8__8__8::buser_t'(0);
        a.arready = 0;
        a.rvalid  = 0;
        a.rlast   = 0;
        a.rdata   = __std___axi4_pkg__32__8__8__8__8__8__8__8::data_t'(0);
        a.rresp   = __std___axi4_pkg__32__8__8__8__8__8__8__8::resp_t'(0);
        a.rid     = __std___axi4_pkg__32__8__8__8__8__8__8__8::id_t'(0);
        a.ruser   = __std___axi4_pkg__32__8__8__8__8__8__8__8::ruser_t'(0);
    end
    always_comb begin
        b.bid     = __std___axi4_lite_pkg____std___axi4_pkg__32__8__8__8__8__8__8__8_ADDRESS_WIDTH____std___axi4_pkg__32__8__8__8__8__8__8__8_DATA_WIDTH_BYTES____std___axi4_pkg__32__8__8__8__8__8__8__8_ID_LENGTH::id_t'(0);
        b.rid     = __std___axi4_lite_pkg____std___axi4_pkg__32__8__8__8__8__8__8__8_ADDRESS_WIDTH____std___axi4_pkg__32__8__8__8__8__8__8__8_DATA_WIDTH_BYTES____std___axi4_pkg__32__8__8__8__8__8__8__8_ID_LENGTH::id_t'(0);
        b.awready = 0;
        b.wready  = 0;
        b.bvalid  = 0;
        b.bresp   = __std___axi4_lite_pkg____std___axi4_pkg__32__8__8__8__8__8__8__8_ADDRESS_WIDTH____std___axi4_pkg__32__8__8__8__8__8__8__8_DATA_WIDTH_BYTES____std___axi4_pkg__32__8__8__8__8__8__8__8_ID_LENGTH::resp_t'(0);
        b.arready = 0;
        b.rvalid  = 0;
        b.rdata   = __std___axi4_lite_pkg____std___axi4_pkg__32__8__8__8__8__8__8__8_ADDRESS_WIDTH____std___axi4_pkg__32__8__8__8__8__8__8__8_DATA_WIDTH_BYTES____std___axi4_pkg__32__8__8__8__8__8__8__8_ID_LENGTH::data_t'(0);
        b.rresp   = __std___axi4_lite_pkg____std___axi4_pkg__32__8__8__8__8__8__8__8_ADDRESS_WIDTH____std___axi4_pkg__32__8__8__8__8__8__8__8_DATA_WIDTH_BYTES____std___axi4_pkg__32__8__8__8__8__8__8__8_ID_LENGTH::resp_t'(0);
    end
    always_comb begin
        c.tready = 0;
    end
endmodule




module veryl_testcase_Module68F;
    __std___axi4_if____std___axi4_pkg__32__8__8__8__8__8__8__8                                                                                                                                                            axi4_if          ();
    __std___axi4_lite_if____std___axi4_lite_pkg____std___axi4_pkg__32__8__8__8__8__8__8__8_ADDRESS_WIDTH____std___axi4_pkg__32__8__8__8__8__8__8__8_DATA_WIDTH_BYTES____std___axi4_pkg__32__8__8__8__8__8__8__8_ID_LENGTH axi4_lite_if     ();
    __std___axi4_stream_if____std___axi4_stream_pkg____std___axi4_pkg__32__8__8__8__8__8__8__8_DATA_WIDTH_BYTES__2____std___axi4_pkg__32__8__8__8__8__8__8__8_ID_LENGTH__5                                                axi4_stream_if   ();
    always_comb begin
        axi4_if.awvalid  = 0;
        axi4_if.awaddr   = __std___axi4_pkg__32__8__8__8__8__8__8__8::addr_t'(0);
        axi4_if.awsize   = __std___axi4_pkg__32__8__8__8__8__8__8__8::size_t'(0);
        axi4_if.awburst  = __std___axi4_pkg__32__8__8__8__8__8__8__8::burst_t'(0);
        axi4_if.awcache  = __std___axi4_pkg__32__8__8__8__8__8__8__8::wcache_t'(0);
        axi4_if.awprot   = __std___axi4_pkg__32__8__8__8__8__8__8__8::proto_t'(0);
        axi4_if.awid     = __std___axi4_pkg__32__8__8__8__8__8__8__8::id_t'(0);
        axi4_if.awlen    = __std___axi4_pkg__32__8__8__8__8__8__8__8::num_bursts_t'(0);
        axi4_if.awlock   = __std___axi4_pkg__32__8__8__8__8__8__8__8::lock_t'(0);
        axi4_if.awqos    = __std___axi4_pkg__32__8__8__8__8__8__8__8::qos_t'(0);
        axi4_if.awregion = __std___axi4_pkg__32__8__8__8__8__8__8__8::region_t'(0);
        axi4_if.awuser   = __std___axi4_pkg__32__8__8__8__8__8__8__8::awuser_t'(0);
        axi4_if.wvalid   = 0;
        axi4_if.wlast    = 0;
        axi4_if.wdata    = __std___axi4_pkg__32__8__8__8__8__8__8__8::data_t'(0);
        axi4_if.wstrb    = __std___axi4_pkg__32__8__8__8__8__8__8__8::strb_t'(0);
        axi4_if.wuser    = __std___axi4_pkg__32__8__8__8__8__8__8__8::wuser_t'(0);
        axi4_if.bready   = 0;
        axi4_if.arvalid  = 0;
        axi4_if.araddr   = __std___axi4_pkg__32__8__8__8__8__8__8__8::addr_t'(0);
        axi4_if.arsize   = __std___axi4_pkg__32__8__8__8__8__8__8__8::size_t'(0);
        axi4_if.arburst  = __std___axi4_pkg__32__8__8__8__8__8__8__8::burst_t'(0);
        axi4_if.arcache  = __std___axi4_pkg__32__8__8__8__8__8__8__8::rcache_t'(0);
        axi4_if.arprot   = __std___axi4_pkg__32__8__8__8__8__8__8__8::proto_t'(0);
        axi4_if.arid     = __std___axi4_pkg__32__8__8__8__8__8__8__8::id_t'(0);
        axi4_if.arlen    = __std___axi4_pkg__32__8__8__8__8__8__8__8::num_bursts_t'(0);
        axi4_if.arlock   = __std___axi4_pkg__32__8__8__8__8__8__8__8::lock_t'(0);
        axi4_if.arqos    = __std___axi4_pkg__32__8__8__8__8__8__8__8::qos_t'(0);
        axi4_if.arregion = __std___axi4_pkg__32__8__8__8__8__8__8__8::region_t'(0);
        axi4_if.aruser   = __std___axi4_pkg__32__8__8__8__8__8__8__8::aruser_t'(0);
        axi4_if.rready   = 0;
    end
    always_comb begin
        axi4_lite_if.awvalid = 0;
        axi4_lite_if.awaddr  = __std___axi4_lite_pkg____std___axi4_pkg__32__8__8__8__8__8__8__8_ADDRESS_WIDTH____std___axi4_pkg__32__8__8__8__8__8__8__8_DATA_WIDTH_BYTES____std___axi4_pkg__32__8__8__8__8__8__8__8_ID_LENGTH::addr_t'(0);
        axi4_lite_if.awprot  = __std___axi4_lite_pkg____std___axi4_pkg__32__8__8__8__8__8__8__8_ADDRESS_WIDTH____std___axi4_pkg__32__8__8__8__8__8__8__8_DATA_WIDTH_BYTES____std___axi4_pkg__32__8__8__8__8__8__8__8_ID_LENGTH::proto_t'(0);
        axi4_lite_if.wvalid  = 0;
        axi4_lite_if.wdata   = __std___axi4_lite_pkg____std___axi4_pkg__32__8__8__8__8__8__8__8_ADDRESS_WIDTH____std___axi4_pkg__32__8__8__8__8__8__8__8_DATA_WIDTH_BYTES____std___axi4_pkg__32__8__8__8__8__8__8__8_ID_LENGTH::data_t'(0);
        axi4_lite_if.wstrb   = __std___axi4_lite_pkg____std___axi4_pkg__32__8__8__8__8__8__8__8_ADDRESS_WIDTH____std___axi4_pkg__32__8__8__8__8__8__8__8_DATA_WIDTH_BYTES____std___axi4_pkg__32__8__8__8__8__8__8__8_ID_LENGTH::strb_t'(0);
        axi4_lite_if.bready  = 0;
        axi4_lite_if.arvalid = 0;
        axi4_lite_if.araddr  = __std___axi4_lite_pkg____std___axi4_pkg__32__8__8__8__8__8__8__8_ADDRESS_WIDTH____std___axi4_pkg__32__8__8__8__8__8__8__8_DATA_WIDTH_BYTES____std___axi4_pkg__32__8__8__8__8__8__8__8_ID_LENGTH::addr_t'(0);
        axi4_lite_if.arprot  = __std___axi4_lite_pkg____std___axi4_pkg__32__8__8__8__8__8__8__8_ADDRESS_WIDTH____std___axi4_pkg__32__8__8__8__8__8__8__8_DATA_WIDTH_BYTES____std___axi4_pkg__32__8__8__8__8__8__8__8_ID_LENGTH::proto_t'(0);
        axi4_lite_if.rready  = 0;
    end
    always_comb begin
        axi4_stream_if.tvalid = 0;
        axi4_stream_if.tdata  = __std___axi4_stream_pkg____std___axi4_pkg__32__8__8__8__8__8__8__8_DATA_WIDTH_BYTES__2____std___axi4_pkg__32__8__8__8__8__8__8__8_ID_LENGTH__5::data_t'(0);
        axi4_stream_if.tstrb  = __std___axi4_stream_pkg____std___axi4_pkg__32__8__8__8__8__8__8__8_DATA_WIDTH_BYTES__2____std___axi4_pkg__32__8__8__8__8__8__8__8_ID_LENGTH__5::strb_t'(0);
        axi4_stream_if.tkeep  = __std___axi4_stream_pkg____std___axi4_pkg__32__8__8__8__8__8__8__8_DATA_WIDTH_BYTES__2____std___axi4_pkg__32__8__8__8__8__8__8__8_ID_LENGTH__5::keep_t'(0);
        axi4_stream_if.tlast  = 0;
        axi4_stream_if.tid    = __std___axi4_stream_pkg____std___axi4_pkg__32__8__8__8__8__8__8__8_DATA_WIDTH_BYTES__2____std___axi4_pkg__32__8__8__8__8__8__8__8_ID_LENGTH__5::id_t'(0);
        axi4_stream_if.tdest  = __std___axi4_stream_pkg____std___axi4_pkg__32__8__8__8__8__8__8__8_DATA_WIDTH_BYTES__2____std___axi4_pkg__32__8__8__8__8__8__8__8_ID_LENGTH__5::dest_t'(0);
        axi4_stream_if.tuser  = __std___axi4_stream_pkg____std___axi4_pkg__32__8__8__8__8__8__8__8_DATA_WIDTH_BYTES__2____std___axi4_pkg__32__8__8__8__8__8__8__8_ID_LENGTH__5::user_t'(0);
    end

    always_comb axi4_lite_if.awid = 0;
    always_comb axi4_lite_if.arid = 0;

    veryl_testcase___Module68E____std___axi4_pkg__32__8__8__8__8__8__8__8____std___axi4_lite_pkg____std___axi4_pkg__32__8__8__8__8__8__8__8_ADDRESS_WIDTH____std___axi4_pkg__32__8__8__8__8__8__8__8_DATA_WIDTH_BYTES____std___axi4_pkg__32__8__8__8__8__8__8__8_ID_LENGTH____std___axi4_stream_pkg____std___axi4_pkg__32__8__8__8__8__8__8__8_DATA_WIDTH_BYTES__2____std___axi4_pkg__32__8__8__8__8__8__8__8_ID_LENGTH__5 u (
        .a (axi4_if       ),
        .b (axi4_lite_if  ),
        .c (axi4_stream_if)
    );
endmodule

package veryl_testcase_Package68G;
    localparam int unsigned WIDTH = 32;
endpackage
//# sourceMappingURL=../map/68_std_1.sv.map
