veryl-lang/veryl/testcases/sv/25_dependency_2.sv

module veryl_testcase_Module25A



    import veryl_sample4___bar_pkg__32::*;
    import veryl_sample4___baz_pkg__veryl_testcase___Package25__1_C__veryl_testcase___Package25__2_C::*;
(
    input var logic                    i_clk  ,
    input var logic                    i_rst_n,
    veryl_sample3_data_if.mp_in  in_if  ,
    veryl_sample3_data_if.mp_out out_if 
);



    veryl_sample3_data_if data_if ();

    veryl_sample_delay u0 (
        .i_clk     (i_clk       ),
        .i_rst_n_n (i_rst_n     ),
        .i_d       (in_if.data  ),
        .o_d       (data_if.data)
    );

    veryl_sample2_delay u1 (
        .i_clk     (i_clk       ),
        .i_rst_n_n (i_rst_n     ),
        .i_d       (data_if.data),
        .o_d       (out_if.data )
    );

    veryl_sample4___bar_module__veryl_sample4___foo_pkg__veryl_sample4___bar_pkg__32_BAR__veryl_sample4___bar_pkg__32 u2 ();
endmodule

module veryl_testcase___Module25B____Package25__1



    import veryl_testcase___Package25__1::*;
(
    veryl_sample4___qux_if__veryl_testcase___Package25__1_S.mp if3,
    veryl_sample4___qux_if__veryl_testcase___Package25__1_S.mp if4
);


    veryl_sample4___qux_if__veryl_testcase___Package25__1_S u5 ();
    veryl_sample4___qux_if__veryl_testcase___Package25__1_S u6 ();

    always_comb u5.qux.s = '0;
    always_comb u6.qux.s = '0;

    logic _a; always_comb _a = if3.qux.s;
    logic _b; always_comb _b = if4.qux.s;

    if (1) begin :g
        logic _c; always_comb _c = if3.qux.s;
        logic _d; always_comb _d = if4.qux.s;
        logic _e; always_comb _e = u5.qux.s;
        logic _f; always_comb _f = u6.qux.s;
    end
endmodule

module veryl_testcase___Module25C____Package25__1_C;



    veryl_sample4___quu_module__veryl_testcase___Package25__1_C u5 ();
endmodule


module veryl_testcase_Module25D;



    veryl_sample4___qux_if__veryl_testcase___Package25__1_S qux_if     ();
    always_comb qux_if.qux = 0;
    veryl_testcase___Module25B____Package25__1 u6 (
        .if3 (qux_if),
        .if4 (qux_if)
    );
    veryl_testcase___Module25C____Package25__1_C u7 ();

    logic _a; always_comb _a = qux_if.qux.s;
endmodule

module veryl_testcase_Module25E;



    localparam int unsigned QUX_0 = veryl_sample4_qux_pkg::QUX_0;
    localparam int unsigned QUX_1 = veryl_sample5_qux_pkg::QUX_1;
endmodule

module veryl_testcase_Module25F



#(
    parameter  int unsigned WIDTH = 8                ,
    localparam type         TYPE  = logic [WIDTH-1:0]
) (
    input  var logic [WIDTH-1:0] i_a,
    input  var logic [WIDTH-1:0] i_b,
    output var logic [WIDTH-1:0] o_c,
    input  var TYPE              i_d,
    input  var TYPE              i_e,
    output var TYPE              o_f,
    output var TYPE              o_g
);
    typedef logic [WIDTH-1:0] T;

    always_comb begin
        o_c = veryl_sample4___foo_func_1__WIDTH(i_a, i_b);
        o_f = veryl_sample4___foo_func_3__TYPE(i_d, i_e);
        o_g = veryl_sample4___foo_func_4__T(i_d, i_e);
    end

    function automatic int unsigned veryl_sample4_foo_func_2() ;
        return 2;
    endfunction
    function automatic logic [WIDTH-1:0] veryl_sample4___foo_func_1__WIDTH(
        input var logic [WIDTH-1:0] a,
        input var logic [WIDTH-1:0] b
    ) ;
        return a + b + veryl_sample4_foo_func_2();
    endfunction
    function automatic TYPE veryl_sample4___foo_func_3__TYPE(
        input var TYPE a,
        input var TYPE b
    ) ;
        return a + b;
    endfunction
    function automatic T veryl_sample4___foo_func_3__T(
        input var T a,
        input var T b
    ) ;
        return a + b;
    endfunction
    function automatic T veryl_sample4___foo_func_4__T(
        input var T a,
        input var T b
    ) ;
        return veryl_sample4___foo_func_3__T(a, b);
    endfunction
endmodule

module veryl_testcase_Module25G;



    import veryl_sample4___baz_pkg__veryl_testcase___Package25__1_C__veryl_testcase___Package25__2_C::BAZ_0;
    import veryl_sample4___baz_pkg__veryl_testcase___Package25__1_C__veryl_testcase___Package25__2_C::BAZ_1;


    int unsigned _f0; always_comb _f0 = BAZ_0;
    int unsigned _f1; always_comb _f1 = BAZ_1;

    // the module import stays visible in nested scopes
    if (1) begin :g
        int unsigned _f2; always_comb _f2 = BAZ_0;
        if (1) begin :h
            int unsigned _f3; always_comb _f3 = BAZ_1;
        end
    end

    function automatic int unsigned f() ;
        return BAZ_0 + BAZ_1;
    endfunction
    int unsigned _f4; always_comb _f4 = f();
endmodule

package veryl_testcase_Pacakge25H;







endpackage

module veryl_testcase_Module25I;







    veryl_sample4___baz_if__veryl_sample4___baz_pkg__veryl_sample4___baz_pkg__1__2_BAZ_0__3 baz ();
    if (1) begin :g
        veryl_sample4___baz_module__veryl_sample4___baz_pkg__veryl_sample4___baz_pkg__1__2_BAZ_0__3 u (
            .baz (baz)
        );
    end
endmodule

module veryl_testcase_Module25J;







    veryl_sample4___baz_if__veryl_sample4___baz_pkg__veryl_sample4___baz_pkg__1__2_BAZ_0__3 baz ();
    // a guarded block still sees the module's unguarded import
    `ifdef DEFINE_A
    if (1) begin :g
        veryl_sample4___baz_module__veryl_sample4___baz_pkg__veryl_sample4___baz_pkg__1__2_BAZ_0__3 u (
            .baz (baz)
        );
    end
    `endif
endmodule

module veryl_testcase_Module25K;
    // the reverse: guarded import, unguarded reference




    `ifdef DEFINE_A

    `endif


    veryl_sample4___baz_if__veryl_sample4___baz_pkg__veryl_sample4___baz_pkg__1__2_BAZ_0__3 baz ();
    veryl_sample4___baz_module__veryl_sample4___baz_pkg__veryl_sample4___baz_pkg__1__2_BAZ_0__3 u (
        .baz (baz)
    );
endmodule

// Importing a package namespace itself makes the package name usable as a
// qualifier at the use site.
// https://github.com/veryl-lang/veryl/issues/3122



module veryl_testcase_Module25L;



    localparam int unsigned QUX_0 = veryl_sample4_qux_pkg::QUX_0;
    localparam int unsigned QUX_1 = veryl_sample4_qux_pkg::QUX_1;
endmodule

module veryl_testcase_Module25M;
    // Module-scope import of a package namespace.





    localparam int unsigned QUX_0 = veryl_sample4_qux_pkg::QUX_0;
endmodule

module veryl_testcase_Module25N;
    // A generic package is imported as-is and instantiated at the use site.



    localparam int unsigned BAR = veryl_sample4___bar_pkg__32::BAR;
endmodule

// Interfaces and modules can also be imported under their own names.
// https://github.com/veryl-lang/veryl/issues/1588

module veryl_testcase_Module25O




(
    veryl_sample4___qux_if__veryl_testcase___Package25__1_S.mp ifp
);
    // An interface is imported as-is; modport members stay qualified.

    veryl_sample4___qux_if__veryl_testcase___Package25__1_S u_if       ();
    always_comb u_if.qux.s = 0;
    logic _a        ; always_comb _a         = ifp.qux.s;
endmodule

module veryl_testcase_Module25P;
    // Modules are imported as-is and instantiated at the use site.







    veryl_sample4___foo_module__veryl_sample4___foo_pkg__veryl_sample4___bar_pkg__32_BAR                              u0 ();
    veryl_sample4___bar_module__veryl_sample4___foo_pkg__veryl_sample4___bar_pkg__32_BAR__veryl_sample4___bar_pkg__32 u1 ();
endmodule

// An imported component keeps its declaring project as a generic argument.


module veryl_testcase_Module25Q;



    veryl_sample4___qux_if__veryl_sample4___foo_pkg__1_Foo u         ();
    always_comb u.qux.foo = 0;
endmodule

module veryl_testcase_Module25R;
    // The argument's project differs from both the use site and the base
    // component's project.



    veryl_sample5___qux_if__veryl_sample4___foo_pkg__2_Foo u         ();
    always_comb u.qux.foo = 0;
endmodule

module veryl_testcase_Module25S;
    // Both spellings instantiate the same component.



    veryl_sample4___foo_module__veryl_sample4___foo_pkg__3 u0 ();
    veryl_sample4___foo_module__veryl_sample4___foo_pkg__3 u1 ();
endmodule

module veryl_testcase_Module25T;
    // A non-generic project-scope function is imported by its project-qualified
    // path and called under the imported name.





    int unsigned _r;
    always_comb _r = veryl_sample4_foo_func_2();

    function automatic int unsigned veryl_sample4_foo_func_2() ;
        return 2;
    endfunction
endmodule

module veryl_testcase_Module25U;
    // The brace list spells the same import item by item.





    int unsigned         _r;
    logic        [8-1:0] _s;
    always_comb _r = veryl_sample4_foo_func_2();
    always_comb _s = veryl_sample4___foo_func_1__8(8'd1, 8'd2);

    function automatic int unsigned veryl_sample4_foo_func_2() ;
        return 2;
    endfunction
    function automatic logic [8-1:0] veryl_sample4___foo_func_1__8(
        input var logic [8-1:0] a,
        input var logic [8-1:0] b
    ) ;
        return a + b + veryl_sample4_foo_func_2();
    endfunction
endmodule
//# sourceMappingURL=../map/25_dependency_2.sv.map
