veryl-lang/veryl/testcases/sv/68_std_3.sv

package veryl_testcase_Package68I;
    localparam int unsigned ADDR_W     = 16;
    localparam int unsigned DATA_BYTES = 4;
    localparam int unsigned ID_W       = 8;


endpackage
//# sourceMappingURL=../map/68_std_3.sv.map
