veryl-lang/veryl/testcases/sv/68_std_4.sv

module veryl_testcase_Module68J (
    __std___axi4_lite_if____std___axi4_lite_pkg__veryl_testcase_Package68I_ADDR_W__veryl_testcase_Package68I_DATA_BYTES__veryl_testcase_Package68I_ID_W.master axi4lite_m
);
    always_comb begin
        axi4lite_m.awvalid = 1'b0;
        axi4lite_m.awaddr  = '0;
        axi4lite_m.awprot  = __std___axi4_lite_pkg__veryl_testcase_Package68I_ADDR_W__veryl_testcase_Package68I_DATA_BYTES__veryl_testcase_Package68I_ID_W::proto_t'(0);
        axi4lite_m.wvalid  = 1'b0;
        axi4lite_m.wdata   = '0;
        axi4lite_m.wstrb   = '0;
        axi4lite_m.bready  = 1'b0;
        axi4lite_m.arvalid = 1'b0;
        axi4lite_m.araddr  = '0;
        axi4lite_m.arprot  = __std___axi4_lite_pkg__veryl_testcase_Package68I_ADDR_W__veryl_testcase_Package68I_DATA_BYTES__veryl_testcase_Package68I_ID_W::proto_t'(0);
        axi4lite_m.rready  = 1'b0;
    end
endmodule
//# sourceMappingURL=../map/68_std_4.sv.map
