veryl-lang/veryl/crates/languageserver/src/keyword.rs

pub const KEYWORDS: &[&str] = &[
    "alias",
    "always_comb",
    "always_ff",
    "assign",
    "as",
    "bind",
    "bit",
    "block",
    "bbool",
    "lbool",
    "case",
    "clock",
    "clock_posedge",
    "clock_negedge",
    "connect",
    "const",
    "converse",
    "default",
    "else",
    "embed",
    "enum",
    "f32",
    "f64",
    "false",
    "final",
    "for",
    "function",
    "gen",
    "i8",
    "i16",
    "i32",
    "i64",
    "if_reset",
    "if",
    "import",
    "include",
    "initial",
    "inout",
    "input",
    "inside",
    "inst",
    "interface",
    "in",
    "let",
    "logic",
    "lsb",
    "mixin",
    "modport",
    "module",
    "msb",
    "output",
    "outside",
    "package",
    "param",
    "proto",
    "pub",
    "repeat",
    "reset",
    "reset_async_high",
    "reset_async_low",
    "reset_sync_high",
    "reset_sync_low",
    "return",
    "rev",
    "break",
    "same",
    "signed",
    "step",
    "string",
    "struct",
    "switch",
    "tri",
    "true",
    "type",
    "p8",
    "p16",
    "p32",
    "p64",
    "u8",
    "u16",
    "u32",
    "u64",
    "union",
    "unsafe",
    "var",
];
