veryl-lang/veryl/testcases/sv/64_cast_to_builtin.sv

module veryl_testcase_Module64;
    int unsigned a; always_comb a = 1;

    int unsigned     _x0; always_comb _x0 = unsigned'(int'(a));
    longint unsigned _x1; always_comb _x1 = unsigned'(longint'(a));
    int              _x2; always_comb _x2 = int'(a);
    longint          _x3; always_comb _x3 = longint'(a);
    shortreal        _x4; always_comb _x4 = shortreal'(a);
    real             _x5; always_comb _x5 = real'(a);
    bit              _x6; always_comb _x6 = ((a) != 1'b0);
    logic            _x7; always_comb _x7 = ((a) != 1'b0);
endmodule
//# sourceMappingURL=../map/64_cast_to_builtin.sv.map
