veryl-lang/veryl/testcases/sv/38_typedef.sv

module veryl_testcase_Module38;
    typedef logic  [16-1:0]         word_t   ;
    typedef logic  [16-1:0][16-1:0] words_t  ;
    typedef word_t                  regfile_t [2];

    typedef bit [8-1:0] octbyte [8];

    localparam int unsigned WORD_BITS = $bits(word_t);

    regfile_t rf   ;
    always_comb rf[0] = '0;
    always_comb rf[1] = '0;
endmodule

interface veryl_testcase_Interface38;
    typedef logic  [16-1:0]         word_t   ;
    typedef logic  [16-1:0][16-1:0] words_t  ;
    typedef word_t                  regfile_t [16];

    typedef bit [8-1:0] octbyte [8];
endinterface

package veryl_testcase_Package38;
    typedef logic  [16-1:0]         word_t   ;
    typedef logic  [16-1:0][16-1:0] words_t  ;
    typedef word_t                  regfile_t [16];

    typedef bit [8-1:0] octbyte [8];
endpackage
//# sourceMappingURL=../map/38_typedef.sv.map
