veryl-lang/veryl/testcases/sv/36_doc_comment.sv

/// Test module for doc comment
///
/// * list item0
/// * list item1
///
/// ```wavedrom
/// {signal: [
///   {name: 'clk', wave: 'p.....|...'},
///   {name: 'dat', wave: 'x.345x|=.x', data: ['head', 'body', 'tail', 'data']},
///   {name: 'req', wave: '0.1..0|1.0'},
///   {},
///   {name: 'ack', wave: '1.....|01.'}
///
/// ]}
/// ```
///
/// ```wavedrom
/// (function (bits, ticks) {
///   var i, t, gray, state, data = [], clock = [];
///   for (i = 0; i < ticks; i++) {
///     clock.push({tick: i});
///   }
///   return {signal: [
///     {name: 'clock', wave: 'p' + '.'.repeat(ticks - 1)},
///     {name: 'data',  wave: 'x' + '='.repeat(ticks - 1), data: clock.map(function(c) { return c.tick; })}
///   ]};
/// })(5, 16)
/// ```
///
/// ```mermaid
/// graph TD;
///     A-->B;
///     A-->C;
///     B-->D;
///     C-->D;
/// ```
///
module veryl_testcase_Module36 #(
    /// Data width
    parameter  int unsigned ParamA = 1,
    localparam int unsigned ParamB = 1
) (
    input  var logic              i_clk  , /// Clock
    input  var logic              i_rst_n, /// Reset
    input  var logic [ParamA-1:0] i_data , /// Data input
    output var logic [ParamA-1:0] o_data  /// Data output
);
    always_comb o_data = 0;
endmodule

/// Test interface for doc comment
///
/// * list item0
/// * list item1
interface veryl_testcase_Interface36 #(
    parameter  int unsigned ParamA = 1, /// Data width
    localparam int unsigned ParamB = 1
);
endinterface

/// Test package for doc comment
///
/// * list item0
/// * list item1
package veryl_testcase_Package36;
endpackage
//# sourceMappingURL=../map/36_doc_comment.sv.map
