veryl-lang/veryl/testcases/sv/84_package_self_ref_2.sv

package veryl_testcase___Package84__1__2;
    localparam int unsigned A = 1;
    localparam int unsigned B = 2;
endpackage
package veryl_testcase___Package84____Package84__1__2_B____Package84__1__2_A;
    localparam int unsigned A = veryl_testcase___Package84__1__2::B;
    localparam int unsigned B = veryl_testcase___Package84__1__2::A;
endpackage

//# sourceMappingURL=../map/84_package_self_ref_2.sv.map
