veryl-lang/veryl/testcases/sv/13_range_operator.sv

module veryl_testcase_Module13;
    logic          a;
    logic          b;
    logic          c;
    logic          d;
    logic          e;
    logic [10-1:0] X; always_comb X = 1;

    // bit select
    always_comb a = X[0];

    // range select
    always_comb b = X[1:0];

    // position and width
    always_comb c = X[1+:2];
    always_comb d = X[4-:2];

    // index by step
    always_comb e = X[1*(2)+:(2)];
endmodule
//# sourceMappingURL=../map/13_range_operator.sv.map
