veryl-lang/veryl/testcases/sv/23_ifdef.sv

module veryl_testcase_Module23 #(
    `ifdef DEFINE_A
    `ifdef DEFINE_B
    `ifdef DEFINE_C
    `ifdef DEFINE_D
    parameter int unsigned ParamA = 1,
    `endif
    `endif
    `endif
    `endif
    `ifdef DEFINE_A
    parameter int unsigned ParamB = 1,
    `endif
    parameter int unsigned ParamC = 1
) (
    `ifdef DEFINE_A
    input var logic port_x,
    `elsif DEFINE_B
    input var logic port_y,
    `else
    input var logic port_z,
    `endif

    `ifndef DEFINE_A
    input var logic port_p,
    `elsif DEFINE_B
    input var logic port_q,
    `else
    input var logic port_r,
    `endif

    `ifdef DEFINE_A
    input var logic port_a,
    `endif
    input var logic port_b,

    `ifndef DEFINE_A
    input var logic port_a,
    `endif

    `ifdef DEFINE_A
    input var logic port_c,
    `endif

    input var logic port_d
);
    `ifdef DEFINE_A
    `ifdef DEFINE_B
    logic [10-1:0] _a; always_comb _a = 1;
    `endif
    `endif

    `ifdef DEFINE_A
    logic [10-1:0] _b; always_comb _b = 1;
    logic [10-1:0] _c; always_comb _c = 1;
    `endif

    logic _d;
    always_comb begin
        `ifdef DEFINE_D
        _d = 0;
        `endif

    end

    `ifndef DEFINE_D
    always_comb _d = 1;
    `endif

    `ifdef DEFINE_E
    logic _e; always_comb _e = 1;
    `elsif DEFINE_F
    logic _e; always_comb _e = 2;
    `else
    logic _e; always_comb _e = 3;
    `endif

    `ifndef DEFINE_G
    logic _f; always_comb _f = 1;
    `elsif DEFINE_H
    logic _f; always_comb _f = 2;
    `else
    logic _f; always_comb _f = 3;
    `endif
endmodule

`ifdef DEFINE_A
module veryl_testcase_Module23_A;
endmodule
`endif

`ifndef DEFINE_A
module veryl_testcase_Module23_B;
endmodule
module veryl_testcase_Module23_C;
endmodule
`endif
//# sourceMappingURL=../map/23_ifdef.sv.map
