veryl-lang/veryl/testcases/sv/41_union.sv

module veryl_testcase_Module41;
    typedef enum logic {
        Boolean_True = $bits(logic)'(1),
        Boolean_False = $bits(logic)'(0)
    } Boolean;

    typedef union packed {
        logic   b;
        Boolean c;
    } A;

    A foo  ;
    always_comb foo.b = 1'b0;

    A bar  ;
    always_comb bar.c = Boolean_True;
endmodule
//# sourceMappingURL=../map/41_union.sv.map
