veryl-lang/veryl/testcases/sv/45_var_let_in_always.sv

module veryl_testcase_Module45;
    logic          a; always_comb a = 1;
    logic [10-1:0] b;
    logic [10-1:0] c;

    always_ff @ (posedge a) begin
        logic [10-1:0] x;
        x =  1;
        b <= x * 1;
    end

    always_comb begin
        logic [10-1:0] y;
        y = 1;
        c = y * 1;
    end
endmodule
//# sourceMappingURL=../map/45_var_let_in_always.sv.map
