veryl-lang/veryl/testcases/sv/59_same_name.sv

package veryl_testcase_Package59A;
    localparam int unsigned XLEN = 32;
endpackage

package veryl_testcase_Package59B;
    localparam int unsigned XLEN = veryl_testcase_Package59A::XLEN;
endpackage
//# sourceMappingURL=../map/59_same_name.sv.map
