veryl-lang/veryl/(commit log)

2023-07-31 Fix scoped identifier translation
    [04_module.sv, 37_package_ref.sv, cmd_build.rs, cmd_check.rs, cmd_doc.rs, cmd_dump.rs, cmd_publish.rs]
2023-08-01 Add modport member resolve
    [server.rs]
2023-08-01 removed default case
2023-08-07 Fix enum member resolve
    [40_enum_resolve.sv]
2023-08-25 Fix format around struct/union keyword
    [41_union.sv]
2023-08-28 Bump url from 2.4.0 to 2.4.1
    Bumps [url](https://github.com/servo/rust-url) from 2.4.0 to 2.4.1.
    - [Release notes](https://github.com/servo/rust-url/releases)
    - [Commits](https://github.com/servo/rust-url/compare/v2.4.0...v2.4.1)
    ---
    updated-dependencies:
    - dependency-name: url
    dependency-type: direct:production
    update-type: version-update:semver-patch
    ...
2023-11-22 Bump url from 2.4.1 to 2.5.0
    Bumps [url](https://github.com/servo/rust-url) from 2.4.1 to 2.5.0.
    - [Commits](https://github.com/servo/rust-url/compare/v2.4.1...v2.5.0)
    update-type: version-update:semver-minor
    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
2024-01-04 Fix namespace path emit
    [37_package_ref.sv]
2024-01-05 Fix inside/outside precedence issue
    [32_inside_outside.sv]
2024-02-07 chore: remove println
2024-02-09 Ignore sv member resolve error
    [43_sv_member.sv, doc_builder.rs, server.rs]
2024-02-09 Fix error at sv module instantiation
    [42_sv_namespace.sv]
2024-02-26 Add import resolve support
    [44_import_resolve.sv]
2024-02-28 Change sample URL
2024-03-05 Fix syntax error report
    [server.rs]
2024-03-11 Add let declaration/statement for binding
    [45_let_in_always.sv]
2024-03-19 Filter some errors on lsp until background analysis completion
    [server.rs]
2024-03-19 disable single quote auto insertion
2024-03-21 Fix typedef enum format
    [21_cast.sv, 37_package_ref.sv, 40_enum_resolve.sv]
2024-03-21 Adjust multiline case item indent
2024-03-27 add 'case' keyword
2024-03-28 add multiple case condions support
    (refs: veryl-lang/veryl#606)
2024-03-28 Add UnassignVariable error to lsp error filtering
    [server.rs]
2024-03-28 Add multiple_assignment error support
    [03_operator.sv, 06_function.sv, 13_range_operator.sv, 18_concatenation.sv, 25_dependency.sv]
2024-03-28 Suppress unexpected error of veryl-ls
    [server.rs]
2024-03-28 Move sv member insert to create_symbol_table
2024-03-29 Fix filelist order when file scope import is used
    [cmd_build.rs]
2024-03-29 Fix missing new line around attributes
    [29_allow.sv]
2024-04-03 add TypeDefDeclaration to InterfaceItem
    (fix veryl-lang/veryl#626)
    [38_typedef.sv]
2024-04-06 Fix resolve failure for some nested items
    [doc_builder.rs, server.rs]
2024-04-12 Fix parsing error around dollar
    [49_system_function.sv]
2024-04-12 Fix enum member emit over typedef
    [50_enum_over_typedef.sv]
2024-04-30 Fix nested case item indent
2024-05-08 introduce clock_* and reset_* types
    (refs: veryl-lang/veryl#622)
    [12_always.sv, keyword.rs]
2024-05-13 allow to omit specifying clock and reset signals
    (refs: veryl-lang/veryl#569)
    [12_always.sv]
2024-05-20 use 'continue' instead of 'break` to keep the original flow
2024-05-25 allow to add prefix/suffix to clock/reset signals
    (refs: veryl-lang/veryl#623)
    [12_always.sv, 29_allow.sv, build.rs]
2024-05-27 Fix parse error at comment after embed
    [47_embed.sv]
2024-06-10 removed println!
2024-06-10 Bump url from 2.5.0 to 2.5.1
    Bumps [url](https://github.com/servo/rust-url) from 2.5.0 to 2.5.1.
    - [Commits](https://github.com/servo/rust-url/compare/v2.5.0...v2.5.1)
    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
2024-06-13 emit case statement/expression as case inside
2024-06-13 add switch statement/expression
2024-06-13 add range expression support to case condition
2024-06-18 Bump url from 2.5.1 to 2.5.2
    Bumps [url](https://github.com/servo/rust-url) from 2.5.1 to 2.5.2.
    - [Commits](https://github.com/servo/rust-url/compare/v2.5.1...v2.5.2)
    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
2024-07-30 Fix metadata load failure of veryl-ls
    [server.rs]
2024-07-30 Fix accidentally duplication report of veryl-ls
    [server.rs]
2024-07-30 Fix panic at goto definition
    [server.rs]
2024-07-31 Fix bit width calc at width-less type
    [16_case_switch.sv]
2024-08-01 Fix uneffective prefix/suffix at some places
    [63_prefix_suffix.sv]
2024-08-09 Improve case checker of naming lint
2024-08-15 Support clock and reset cast
    [65_cast_to_clock_reset.sv]
2024-08-19 Ignore broken symlink at gathering source code
    [utils.rs]
2024-08-22 fix wrong enum width calculation
    [09_struct_enum.sv]
2024-09-02 Added doc comments, and changed from if-else to case statement
2024-09-02 Added binary encoder and binary decoder
2024-09-02 Rename encoder/decoder
2024-09-02 Added Hamming-code based single-error correction encoder and decoder
2024-09-04 fix wrong named block emittion
    (refs: veryl-lang/veryl#933)
    [15_named_block.sv]
2024-09-09 Execute only tests for the current project
2024-09-11 Add post_pass1 stage for import handling
2024-10-04 Fix error by repeated generics usage
    [54_generic_function.sv, 55_generic_module.sv, 56_generic_interface.sv, 57_generic_package.sv, 58_generic_struct.sv]
2024-10-07 Fix case item misindent
    [16_case_switch.sv]
2024-10-07 Fix format of generic argument
    [58_generic_struct.sv]
2024-10-10 Fix member access failure of generic instance
    [56_generic_interface.sv]
2024-10-22 fix wrong modport separator
    (refs: veryl-lang/veryl#1013)
    [70_interface_connect.sv]
2024-10-22 Allow to use loop variable as reset value
    [12_always.sv]
2024-10-23 Resolve imported generic arguments
    [57_generic_package.sv]
2024-11-04 Bump url from 2.5.2 to 2.5.3
    Bumps [url](https://github.com/servo/rust-url) from 2.5.2 to 2.5.3.
    - [Commits](https://github.com/servo/rust-url/compare/v2.5.2...v2.5.3)
    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
2024-11-05 raise error when unassigned variable is refered
    (refs: veryl-lang/veryl#1028)
    [lib.rs]
2024-11-11 Fix broken map path
    [lib.rs]
2024-11-21 Fix language server panic on Windows
    [server.rs]
2024-11-22 Bump url from 2.5.3 to 2.5.4
    Bumps [url](https://github.com/servo/rust-url) from 2.5.3 to 2.5.4.
    - [Commits](https://github.com/servo/rust-url/compare/v2.5.3...v2.5.4)
    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
2024-11-25 Fix resolve of generic interface with imported items
    [56_generic_interface.sv]
2024-11-28 fix unexpected member resolution error
    (refs: veryl-lang/veryl#1105)
    [25_dependency.sv]
2024-12-02 Fix mis-indent of case item with comment
    [16_case_switch.sv]
2024-12-02 Fix panic with explicit clock and implicit reset
    [12_always.sv]
2024-12-11 fix issue that `generic_references` are unexpectedly cleared
    (refs: veryl-lang/veryl#1131)
    [56_generic_interface.sv]
2024-12-13 Fix unexpected identifier emittion
    [62_raw_identifier.sv, 65_cast_to_clock_reset.sv]
2024-12-27 raise error for package referecne before defnition
    (refs: veryl-lang/veryl#1166)
    [19_import_export.sv, 37_package_ref.sv, 44_import_resolve.sv, 56_generic_interface.sv, 57_generic_package.sv, 58_generic_struct.sv]
2025-01-03 temporarily disable port default value for function
    (refs: https://github.com/veryl-lang/veryl/issues/1178#issuecomment-2568996379)
    [73_port_default_value.sv]
2025-01-05 Resolve SymbolId of user defined types after pass1
    [server.rs]
2025-02-05 trying to fix file operations for lsp
    [backend.rs, server.rs]
2025-02-06 refactor: fix to pass clippy check
    [backend.rs]
2025-02-08 Fix syntax error at type with modifier in expression
    [71_type_parameter.sv]
2025-02-12 fix miss fomratted SV
    (refs: veryl-lang/veryl#1229)
    [73_port_default_value.sv]
2025-02-12 Fix SV format around default port value
    [73_port_default_value.sv, lib.rs]
2025-02-19 Fix wrong namespace by #1254
    [cmd_build.rs, cmd_check.rs, cmd_publish.rs, lib.rs, main.rs, server.rs]
2025-02-23 Trace parameter overrides through instantiation
2025-02-23 Move InstanceHistory to thread local storage
2025-02-23 Error with multi sources support
    [lib.rs]
2025-02-24 Fix missing table drop on languageserver
    [server.rs]
2025-02-26 Format short if expression into single line
    [20_if_case_switch_expression.sv, cmd_fmt.rs, format.rs, lib.rs]
2025-02-27 Fix lsp panic on compilation
    [server.rs]
2025-03-02 Fix mdbook-veryl checking order
    [main.rs]
2025-03-03 Fix zero width number emission
    [01_number.sv]
2025-03-05 Add build feature to avoid feature conflict
    [build.rs]
2025-03-07 Introduce define context to symbol resolver
    [23_ifdef.sv]
2025-03-12 support default clock and reset
    (refs: veryl-lang/veryl#1300)
    [77_default_clock_reset.sv]
2025-03-12 Support clock and reset inside interface
    [78_interface_with_clock_reset.sv]
2025-03-14 prevent possible panic due to underflowing subtraction
    During testing I encountered a few panics, because `12 -` was wrapping
    around. I think `saturating_sub` is the correct behavoir here
    [main.rs]
2025-03-21 Fix unexpected failure at SystemVerilog interface member
    [43_sv_member.sv]
2025-03-21 Fix unexpected output of SystemVerilog modport
    [43_sv_member.sv]
2025-03-26 Fix build failure caused by parallel build
    [main.rs]
2025-03-27 Multi-line case item support
2025-03-28 fix invalid `unassigned variable` error when using system function
    (refs: veryl-lang/veryl#1439)
    [lib.rs, server.rs]
2025-03-28 Fix conflict with creating cache directories
    [lib.rs]
2025-04-02 Fix unexpected error by reset value initialized by function
    [12_always.sv]
2025-04-04 Fix panic at expression in package
    [49_system_function.sv]
2025-04-04 Fix unexpected emission of #[els]
    [23_ifdef.sv]
2025-04-08 Fix unexpected error on LSP until background task done
    [server.rs]
2025-04-08 Bump smallvec from 1.14.0 to 1.15.0
    Bumps [smallvec](https://github.com/servo/rust-smallvec) from 1.14.0 to 1.15.0.
    - [Release notes](https://github.com/servo/rust-smallvec/releases)
    - [Commits](https://github.com/servo/rust-smallvec/compare/v1.14.0...v1.15.0)
    - dependency-name: smallvec
    dependency-version: 1.15.0
    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
2025-04-09 Fix align after multi-line items
    [18_concatenation.sv, lib.rs]
2025-04-11 Skip to write files if no change
    [cmd_build.rs, cmd_fmt.rs, cmd_migrate.rs, lib.rs, utils.rs]
2025-04-11 insert cast to enum variant value
    (refs: veryl-lang/veryl#1480)
2025-04-16 introduce interface prototype
    (refs: veryl-lang/veryl#963)
2025-04-18 Trace member of generic parameter type
2025-04-18 introduce u8, u16, i8 and i16 fixed types
    (refs: veryl-lang/veryl#1536)
    [02_builtin_type.sv, 55_generic_module.sv, 56_generic_interface.sv, keyword.rs]
2025-04-24 trace `type` parameter
    (refs: veryl-lang/veryl#1543)
2025-04-28 fix incorrect format for empty body block with block comments
    (refs: veryl-lang/veryl#1553)
    [lib.rs]
2025-05-02 Change case item spelling to UPPERCASE
2025-05-04 fix width calcuration for width-less based number literal
    (refs: veryl-lang/veryl#1583)
    [01_number.sv, 16_case_switch.sv]
2025-05-14 add a build option to shorten mangled name
    (refs: veryl-lang/veryl#1608)
    [build.rs]
2025-05-15 fix type dag insertion between member objects defined in packages
    (refs: veryl-lang/veryl#1618)
2025-05-18 fix wrong collection of modport default members
    (refs: veryl-lang/veryl#1639)
    [75_modport_default.sv]
2025-05-20 Remove case item indent
2025-05-20 Fix nested case format
2025-05-22 insert type dag edge between base and actual generic arg
    (refs: veryl-lang/veryl#1657)
2025-05-29 rename `shorten_mangled_name` with `hashed_mangled_name`
    (refs: veryl-lang/veryl#1680)
    [build.rs]
2025-06-06 Bump smallvec from 1.15.0 to 1.15.1
    Bumps [smallvec](https://github.com/servo/rust-smallvec) from 1.15.0 to 1.15.1.
    - [Commits](https://github.com/servo/rust-smallvec/compare/v1.15.0...v1.15.1)
    dependency-version: 1.15.1
    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
2025-06-17 replace proto package with actual package during resolving import
    (refs: veryl-lang/veryl#1703, veryl-lang/veryl#1706)
    [68_std.sv]
2025-06-17 fix wrong filelist order
    (refs: veryl-lang/veryl#1716)
    [lib.rs]
2025-07-01 Fix racing of file operations
    [lib.rs]
2025-07-06 fix wrong emitting location of import delcarations
    (refs: veryl-lang/veryl#1758)
    [19_import.sv, 44_import_resolve.sv, 56_generic_interface.sv, 57_generic_package.sv, 80_connect_operation.sv]
2025-07-07 fix case that prefix/suffix are not added to clock/reset ports
    (refs: veryl-lang/veryl#1756)
    [25_dependency.sv]
2025-07-07 fix issue that formatter removes RHS of proto typedef
    (refs: veryl-lang/veryl#1761)
    [69_proto.sv]
2025-07-08 fix panic on function call in proto module declaration
    (refs: veryl-lang/veryl#1760)
    [69_proto.sv]
2025-07-08 Fix compile error in testcase
    [lib.rs]
2025-07-15 fix issue that prefix/suffix are not added to clock/reset signal in expression identifier
    (refs: veryl-lang/veryl#1786)
    [78_interface_with_clock_reset.sv]
2025-07-25 add `fmt(skip)` attribute
    (refs: veryl-lang/veryl#1642)
    [lib.rs]
2025-08-05 fix `unresolvable_generic_argument` error on member referecne via alias package
    (refs: veryl-lang/veryl#1832)
    [68_std.sv]
2025-08-09 fix `unresolvable_generic_argument` error for expression identifier scoped by package alias
    (refs: veryl-lang/veryl#1837)
    [25_dependency.sv, lib.rs]
2025-08-15 add `error_count_limit` build option
    (refs: veryl-lang/veryl#1842)
    [build.rs, cmd_build.rs, cmd_check.rs, cmd_publish.rs]
2025-09-11 fix `undefined identifier` error for generic instance used as bind target
    (refs: veryl-lang/veryl#1896)
    [82_bind.sv]
2025-09-15 fix wrong emittion including import declaration with generic package
    (refs: veryl-lang/veryl#1901)
    [44_import_resolve.sv, 57_generic_package.sv]
2025-09-25 Fix local build version detection
    [build.rs]
2025-09-26 fix the issue that filelist does not include SV files containing `embed` declaration only
    (refs: veryl-lang/veryl#1918)
    [lib.rs, server.rs]
2025-09-26 fix emittion of `import` declaration in `generate` block
    (refs: veryl-lang/veryl#1921)
    [19_import.sv]
2025-09-30 fix wrong unaliasing logic
    (refs: veryl-lang/veryl#1925)
    [25_dependency.sv, 68_std.sv]
2025-09-30 Fix unexpected moved comment around import declaration
    [19_import.sv]
2025-10-03 Add InvalidResetNonElaborative to lsp temporary ignore error
    [server.rs]
2025-10-09 fix insertion of dag edge between generic arg and base symbol
    (refs: veryl-lang/veryl#1954)
    [lib.rs]
2025-10-15 fix unexpected `unresolvable_generic_argument` error
    (refs: veryl-lang/veryl#1968)
    [25_dependency.sv]
2025-10-16 Fix lsp no response
    [backend.rs]
2025-10-16 fix wrong fiielist order
    (refs: veryl-lang/veryl#1971)
    [lib.rs]
2025-10-17 Fix alignment of single line inst declaration in SV
    [55_generic_module.sv, 56_generic_interface.sv, 68_std.sv, 70_interface_connect.sv]
2025-10-30 fix emission of type keywords used as literal
    (refs: veryl-lang/veryl#2015)
    [57_generic_package.sv]
2025-11-05 fix modport default member resolution
    (refs: veryl-lang/veryl#2029)
    [75_modport_default.sv]
2025-11-13 Improve parse error for some cases
    [server.rs]
2025-11-19 fix `undefined identifier` error caused by veryl-lang/veryl#2021
    [25_dependency_2.sv]
2025-11-20 fix emit position of `const` declaration in statement block
    (refs: veryl-lang/veryl#2051)
    [06_function.sv]
2025-11-21 Add vertical_align format option (off by default)
    Add a `vertical_align` format option that controls whether vertical alignment is applied in formatted Veryl and emitted SystemVerilog.
    I set it to off by default. It arguably doesn't look as visually pleasing but it has more significant downsides: changes to one line overwrite `git blame` of adjacent semantically unchanged lines, and they also show up in diffs (unless you use semantic diff, which sadly isn't widespread) making code review harder.
    Fixes #1623
    [format.rs]
2025-11-29 remove debug print
2025-12-13 fix emitter panick when const reference via package is used as generic arg
    (refs: veryl-lang/veryl#2106)
    [25_dependency_2.sv]
2025-12-31 Fix inline union construction
    [79_struct_constroctur.sv]
2026-01-06 Bump url from 2.5.7 to 2.5.8
    Bumps [url](https://github.com/servo/rust-url) from 2.5.7 to 2.5.8.
    - [Commits](https://github.com/servo/rust-url/compare/v2.5.7...v2.5.8)
    dependency-version: 2.5.8
    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
2026-01-07 Fix LSP panic at symbol reference
    [server.rs]
2026-01-07 Fix unassign error in some tests
    [25_dependency_2.sv, 56_generic_interface.sv]
2026-01-16 Fix unassign variables in test
    [68_std.sv]
2026-01-21 Change iter::chain to itertools for wasm compile by Rust 1.89.0
2026-01-21 Mdbook plugin ignores some errors
    [main.rs]
2026-01-22 Fix unexpected `unassignable_output` of $sv member
    [utils.rs]
2026-01-27 BugFix: Keyword completion now works as expected in helix editor
    When using helix editor, keyword completion did not replace the existing
    text. Resulting in completions like if -> iiff.
    Changed behavior to insert text instead of edit text, like the other
    completion functions in server.rs
    [server.rs]
2026-02-02 Fix `bool` migration doesn't work
    [cmd_migrate.rs]
2026-02-05 Fix emitter mistake of concatenation assignment in alwyas_ff
    [18_concatenation.sv]
2026-02-10 Fix std Axi-Stream interface
    [68_std.sv]
2026-02-10 Fix, remove signal TWAKEUP from std Axi4-Stream interface (Axi5-Stream only)
    [68_std.sv]
2026-02-12 Ignore size limit error when the code block is not used for IR
    [context.rs, lib.rs]
2026-02-24 Made verison optional in project metadata. Fixed tests. Updated publish, bump_version, build_summary and build_index.
    [doc_builder.rs]
2026-02-28 prevent keywords from being highlighted as port references
    [server.rs]
2026-03-03 Fix spelling and minor refactors
    [lib.rs]
2026-03-04 fix `referring_before_definition` error during converting type expression
    (refs: veryl-lang/veryl#2287)
    [utils.rs]
2026-03-04 Fix gather_context panic with assignment operators on array-indexed variables
    [utils.rs]
2026-03-05 Fix eval_type dropping width/array/signed for type parameters
    When resolving SymbolKind::Parameter with a type value (e.g.,
    param T: type = logic<8>), only the TypeKind was extracted,
    discarding width, array, and signed fields. This caused parametric
    interface types to lose their bit-width information.
    Propagate width/array/signed from the resolved type, matching the
    pattern used by TypeDef and Proto resolution paths.
    [utils.rs]
2026-03-06 fix `unassign_variable` warning
    (refs: veryl-lang/veryl#2297)
    [context.rs, utils.rs]
2026-03-06 fix emission of enum member value
    (refs: veryl-lang/veryl#2292)
    [09_struct_enum.sv]
2026-03-10 Added testcase and fix for issue
    [lib.rs]
2026-03-11 Fix ls-types compile error
    [backend.rs]
2026-03-11 Implement positive type validation and error handling for non-positive values
    [83_positive_type.sv, utils.rs]
2026-03-11 Update doc, added more tests and fixed for assignment aswell.
    [utils.rs]
2026-03-11 Uncomment some test code, added tests for x and z. Fixed error message I think
    [utils.rs]
2026-03-11 Update error messages to non-positive which makes more sense.
    [utils.rs]
2026-03-11 insert bit width expand if RHS bit width < assignment target
    (refs: veryl-lang/veryl#2308)
2026-03-12 fix initializing struct imported from `$sv` namespace
    (refs: veryl-lang/veryl#2311)
    [utils.rs]
2026-03-12 fix array literal evaluation including `$sv` member
    (refs: veryl-lang/veryl#2317)
    [utils.rs]
2026-03-13 emit simpe `case` statement if possible
    (refs: veryl-lang/veryl#1979)
2026-03-18 Move UnsuppotedByIr error to SimulatorError
    [cmd_dump.rs, context.rs]
2026-03-18 Improve parse error when keyword is used as identifier
    [lib.rs]
2026-03-23 Report error for $tb usage outside test
    [context.rs]
2026-03-27 Fix .bat command call failure on Windows
    [runner.rs]
2026-03-27 Fix panic at veryl test --wave
    [lib.rs]
2026-03-28 Fix simulator around NBA behavior
    [lib.rs]
2026-03-30 Fix $bit is treated as non-const mistakenly
    [38_typedef.sv, utils.rs]
2026-03-30 Fix simulator bug of bit concat in case condition
2026-04-01 Fix array literal default expansion generating extra element
    In eval_array_literal, the remaining count for default fill was computed
    as target_len - (x.len() - 1) which equals target_len when x.len() == 1,
    producing one too many default elements. Changed to target_len - len
    where len tracks the number of explicitly provided elements.
    [utils.rs]
2026-04-03 Fix broken cast between float and int
    [utils.rs]
2026-04-06 fix `unassign_variable` warning reported for global function
    (refs: veryl-lang/veryl#2464)
    [utils.rs]
2026-04-13 Enable skipped analyzer errors
    [49_system_function.sv, utils.rs]
2026-04-15 fix `invalid_operand` error reproted for `gen` value used as casting type
    (refs: veryl-lang/veryl#2514)
    [utils.rs]
2026-04-18 cli: skip non-matching testbench files when `--test` filters
    Add an optional test-name filter to CmdBuild::exec. cmd_test threads
    the `--test` argument through so unrelated tb files are marked skip
    before analyze_pass2 and emit run, cutting heliodor linux_boot wall
    time by ~40 s.
    [cmd_build.rs, main.rs]
2026-04-18 analyzer/sim: fast and compact handling of large arrays
    Two large-memory testbench arrays (e.g. `var dram: logic<32>[8M]`)
    previously dominated both analyze_pass2 CPU time and RSS in the IR.
    pass2 speedup:
    - AssignDestination: skip full-range iteration when the index is
    non-const and total_array > evaluate_array_limit.
    - Factor::eval_assign: avoid cloning the full Variable for
    large-array references (insert_reference bails anyway).
    Compact storage:
    - `var` / port / let initializers (all-same x-state) store a single
    template Value instead of N copies; `const` / `param` with
    `'{...}` literals keep per-element values.
    - Variable::new derives `assigned` length from r#type.total_array()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
    [utils.rs]
2026-04-18 fix infinite recursion occurs when resolving generic param
    (refs: veryl-lang/veryl#2521)
    [context.rs]
2026-04-21 fix symbol path resolution including generic const
    (refs: veryl-lang/veryl#2542)
    [utils.rs]
2026-04-22 fix emit name of global function defined in dependent project
    (refs: veryl-lang/veryl#2560)
    [68_std.sv]
2026-04-23 fix: adapt to fs4 1.0.0 API changes
    fs4 1.0.0 renamed lock_exclusive to lock and flattened the
    fs_std module to expose FileExt at the crate root.
    [lib.rs]
2026-04-23 Fix ignored param in native testbench
    [context.rs]
2026-04-23 fix `non_positive_value` reported for function arg typed with `p*` type
    (refs: veryl-lang/veryl#2567)
    [utils.rs]
2026-04-24 Add power estimation
2026-04-24 Add clk port to reset_gen
    [context.rs, utils.rs]
2026-04-24 Revert "Split veryl-translate binary from veryl"
    [cmd_translate.rs, lib.rs, main.rs]
2026-04-27 fix resolving association between global func and caller namespace
    (refs: veryl-lang/veryl#2580)
    [25_dependency_2.sv, 68_std.sv, lib.rs]
2026-04-29 simulator: fuse load+zext into uload*
2026-04-30 simulator: lower Eq-chain If into br_table switch
2026-05-12 sim: ff_commit redesign — write-log machinery (infrastructure + emit + ff_commit_from_log)
2026-05-12 sim: ff_commit redesign — inline JIT write_log push (FuncPtr 3-arg, -1.23% wall)
    [lib.rs]
2026-05-12 sim: ff_commit redesign — packed FF allocation via analyzer-IR multi-RMW analysis
2026-05-12 sim: ff_commit redesign — 64-byte wide-FF log entries (single entry per write)
2026-05-13 fix `mismatch_type` reported for struct member used as generic arg
    (refs: veryl-lang/veryl#2626)
    [utils.rs]
2026-05-21 Remove deprecated --trace-threads 2 flag in cocotb runner
2026-05-29 Improve translate error report
    [cmd_translate.rs, lib.rs]
2026-06-01 Fix 14 bugs found by a static bug hunt (miscompile/soundness/panic/sim/cleanup)
    [utils.rs]
2026-06-02 analyzer: clamp constant shift amount >= width to avoid panic
2026-06-02 analyzer: guard against cyclic alias chains (stack overflow)
2026-06-02 sim: honor case first-match in the Cranelift br_table lowering
2026-06-04 fix(analyzer): support indexed modport array in inst port connection
    [utils.rs]
2026-06-05 formatter: make case/switch arm-isolation estimate layout-independent
2026-06-05 fix(metadata): write Veryl.lock atomically to avoid concurrent-read races
    [lib.rs]
2026-06-05 fix(analyzer): mark const reads with dynamic index as non-const
    [utils.rs]
2026-06-08 Rename --base-dir to --out-dir, fix absolute paths outside the project, relocate filelist and dependencies under the output dir
    [cmd_build.rs, lib.rs]
2026-06-10 fix(analyzer): support array range select on assignment LHS
    [utils.rs]
2026-06-10 fix(analyzer): support multi-dimensional array range select on assignment LHS
    [utils.rs]
2026-06-10 fix(analyzer): validate array-range assignment LHS to reject dynamic/out-of-range/reversed/count-mismatched slices and range op-assign instead of miscompiling
    [utils.rs]
2026-06-10 analyzer: confine clock/reset-ness to declarations and reject implicit conversion at ports
    [context.rs, utils.rs]
2026-06-10 fix(analyzer): reject struct/union/enum type inference instead of emitting a 1-bit logic declaration
    [utils.rs]
2026-06-10 fix(analyzer): bound expression nesting depth to report exceed_limit instead of overflowing the stack
    [context.rs]
2026-06-11 perf(analyzer): cache namespace generic maps and resolve failures, store symbols as Rc to cut analyze_post_pass1 time
    [utils.rs]
2026-06-11 fix(simulator): re-key nested internal clock/reset events to globally-unique ids to avoid ancestor port id collisions
    [context.rs]
2026-06-12 fix(analyzer): reject degenerate for-range steps instead of panicking or unrolling against an infinite SV loop
    [07_statement.sv, utils.rs]
2026-06-12 fix(analyzer,simulator): evaluate power with a negative signed exponent per IEEE 1800 11.4.3.1
2026-06-12 Fix reset cast polarity for port and modport sources
    [utils.rs]
2026-06-12 chore(deps): Bump smallvec from 1.15.1 to 1.15.2
    Bumps [smallvec](https://github.com/servo/rust-smallvec) from 1.15.1 to 1.15.2.
    - [Commits](https://github.com/servo/rust-smallvec/compare/v1.15.1...v1.15.2)
    dependency-version: 1.15.2
    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
2026-06-15 sim: branchless LogicAnd/LogicOr for AOT-C comb (cheap-arm gated, default on)
2026-06-15 sim: cut AOT-C comb chunk_size 900 to 128 to shrink register spills
2026-06-15 feat(veryl): add on-disk fragment cache to skip parse/pass1 of unchanged files
    [cmd_build.rs, incremental.rs, lib.rs]
2026-06-15 fix(veryl): run pass2 for files with simulated tests even when skipped as unmodified
    [cmd_build.rs]
2026-06-16 fix(veryl): exclude --test filtered-out testbench files from filelist
    [cmd_build.rs, pipeline.rs]
2026-06-16 fix(analyzer): propagate and check clock domains through function call arguments and output destinations
    [utils.rs]
2026-06-16 fix(simulator): clamp narrow shift counts of 64 or more to SV semantics in the JIT and cc backends
2026-06-16 fix(analyzer): clamp BigUint left-shift amounts to the result width before shifting
2026-06-16 fix(analyzer): stop squaring enum member reference width via the leftover outer shape
    [utils.rs]
2026-06-17 fix(analyzer): bound statement-block nesting depth like expressions instead of overflowing the stack
    [context.rs]
2026-06-17 fix(analyzer): validate x/z enum variant widths and reject forward references between variants
    [utils.rs]
2026-06-17 fix(analyzer): keep multiple-driver detection order-independent with a definite-assignment mask
2026-06-17 fix(analyzer): report anonymous identifier usage in type position
    [utils.rs]
2026-06-18 chore: fix clippy warnings in tests and lint all targets in CI
    [lib.rs]
2026-06-18 fix(formatter): make case-arm isolation and alignment idempotent across passes
2026-06-19 fix(formatter): force multi-line layout for inst with named port connections
    [lib.rs]
2026-06-19 fix parent component resolution for symbol defined in function
    (refs: veryl-lang/veryl#2850)
    [build.rs, lib.rs]
2026-06-23 fix(simulator): give each inlined function call site its own comb scratch
    [context.rs]
2026-06-24 simulator: --backend-validate [STRIDE] — dual-run the AOT-C path only every Nth comb/event settle (default 64, =1 full coverage)
2026-06-25 fix(analyzer): report mutually recursive functions as cyclic type dependency instead of overflowing
    [context.rs]
2026-06-25 fix(analyzer,emitter): keep inferred-let array dimensions parametric instead of baking the parameter default
    [utils.rs]
2026-06-26 fix(analyzer): lower switch default as the final else regardless of its position
2026-06-26 fix(analyzer): clamp wide (>64-bit) shift amounts instead of evaluating them as x
2026-06-26 fix(analyzer): sign-extend narrow signed values before int-to-float cast
    [utils.rs]
2026-06-26 fix(simulator): clamp wide (>64-bit) shift counts in cranelift and aot_c backends
2026-06-27 fix(analyzer): resolve comptime types for switch conditions
    [utils.rs]
2026-06-29 fix(analyzer): carry field offset on const struct member reads
    [utils.rs]
2026-06-29 fix(simulator): cranelift/cc codegen correctness under port-alias-off and chunk relocation
    [lib.rs]
2026-06-29 feat(simulator): cross-test DUT reuse via selective port de-aliasing
2026-06-29 fix(veryl): silence Cranelift JIT debug logs that flood --verbose output
    [main.rs]
2026-06-30 fix(veryl): compare the assembled bundle in build --check mode
    [cmd_build.rs]
2026-06-30 feat(metadata): expose resolved dependency metadata
    [cmd_metadata.rs, lib.rs, main.rs]
2026-07-01 fix(analyzer): materialize inherited unpacked array params
    [utils.rs]
2026-07-01 test: add scope-tree structural-invariant and component unit tests, and update expectations for the redesign
    [lib.rs]
2026-07-02 fix false positive of `mismatch_assignment` warning
    (refs: veryl-lang/veryl#2942)
    [utils.rs]
2026-07-02 fix(simulator): fold constant-zero concat repeats into one shift to bound JIT frame
2026-07-02 skip IR conversion of module body for instances in generic modules
    [context.rs, utils.rs]
2026-07-02 fix(synthesizer): reject oversized flip-flop arrays to avoid OOM
    [lib.rs]
2026-07-03 fix(analyzer): report infinite_recursion instead of crashing on recursive generics
    [utils.rs]
2026-07-06 chore(deps): Bump mdbook-driver from 0.5.3 to 0.5.4
    Bumps [mdbook-driver](https://github.com/rust-lang/mdBook) from 0.5.3 to 0.5.4.
    - [Release notes](https://github.com/rust-lang/mdBook/releases)
    - [Changelog](https://github.com/rust-lang/mdBook/blob/master/CHANGELOG.md)
    - [Commits](https://github.com/rust-lang/mdBook/compare/v0.5.3...v0.5.4)
    - dependency-name: mdbook-driver
    dependency-version: 0.5.4
    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
2026-07-07 rework #2891 recursion detection to use Context, not TLS
    (refs: veryl-lang/veryl#2891)
    [build.rs, context.rs, utils.rs]
2026-07-10 fix(analyzer): drop statically-dead if branches via short-circuit eval
2026-07-10 fix(sim): resolve hierarchical references into generate blocks
    [context.rs, utils.rs]
2026-07-13 test(simulator): add component integration tests and fixtures
    [lib.rs]
2026-07-13 fix(new): scaffold component crates with edition 2024
    [cmd_new.rs]
2026-07-14 fix false positive of `invalid_select` error
    (refs: veryl-lang/veryl#3006)
    [utils.rs]
2026-07-14 Fix interface parameter overrides dropped through modport ports
    A module receiving an interface through a modport port was elaborated
    once and cached keyed only on its own parameters, so the first
    elaboration (e.g. against a default-parameter interface) was reused for
    instances connected to interfaces with overridden parameters:
    interface If #( param DW: u32 = 64 ) { var data: logic<DW>; ... }
    inst a_if: If; // DW=64
    inst b_if: If #( DW: 128 );
    inst a: Consumer ( xif: a_if );
    inst b: Consumer ( xif: b_if ); // reused DW=64 body: data truncated
    Fold the connected interface instances' signatures into the consuming
    module's Signature (participating in the i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
    [context.rs]
2026-07-14 Fix clippy large_enum_variant after growing Signature
    Adding `modport_signatures` to `Signature` grew it by one `Vec` (24 bytes).
    `Signature` is embedded by value in `TypeKind` (Module/Interface/Modport/
    Package/Instance), so `Type` grew too, and every enum holding a `Type` by
    value inline was pushed past clippy's `large_enum_variant` size-difference
    threshold under `-D warnings`.
    Box the largest by-value payloads of the two flagged AIR enums, matching
    the existing per-variant boxing style:
    - `Expression::StructConstructor(Type, ...)` -> `Box<Type>`
    - `Statement::For(ForStatement)` -> `Box<ForStatement>`
    [utils.rs]
2026-07-16 Fix power operator dropping exponents wider than 64 bits
2026-07-16 Fix foreign-domain index into a const array skipping the clock domain check
    [utils.rs]
2026-07-16 Fix concatenation-LHS assignment bypassing clock domain checks
    [utils.rs]
2026-07-16 Fix if/case/switch statement conditions never clock-domain checked against gated writes
    [context.rs, utils.rs]
2026-07-17 Fix const values keeping the RHS literal's signedness instead of the declared type's
    [utils.rs]
2026-07-17 Fix explicit enum member references carrying the expression width instead of the enum width
    [utils.rs]
2026-07-17 ci: group minor/patch dependabot updates weekly to cut rust-cache invalidation
2026-07-17 chore: trim over-verbose comments from recent bugfixes
    [utils.rs]
2026-07-17 Fix negative additive for-step passing the zero-step guard as a huge unsigned step
    [utils.rs]
2026-07-21 Fix negative for-range bounds wrapping to huge unsigned bounds
    [utils.rs]
2026-07-21 Fix comptime evaluation silently skipping for loops over evaluate_size_limit
    [context.rs]
2026-07-21 fix(simulator): lower `case` to a flat multiway node, not a nested if-chain
2026-07-21 fix(analyzer): self-determine testbench clock/reset method argument widths
    [utils.rs]
2026-07-21 fix(synthesizer): keep element-wise multi-decl array drivers (generate-for chains)
2026-07-21 fix(analyzer): don't false-positive comb-loop on if-statement feed-forward array chains
2026-07-22 feat(synthesizer): add depth-reducing restructuring of reduction and scan chains
2026-07-23 fix(analyzer): clamp relational sign-extension shift for width-0 operands
2026-07-23 perf(simulator): cache the whole-comb backend compile across tests, keyed by an XXH3-128 pipeline fingerprint
2026-07-23 add ECC encoder/decoder modules to `std` lib
2026-07-27 apply select to a value resolved through the symbol route
    (refs: veryl-lang/veryl#3082)
    [utils.rs]
2026-07-28 fix `unknown_member` error reported for items imported from generic packages defined in other projects
    (refs: veryl-lang/veryl#3104)
    [25_dependency_2.sv, 68_std_1.sv, 68_std_2.sv, lib.rs]
2026-07-31 fix(analyzer): fold constant switch arm conditions like an if chain
2026-07-31 fix(ls): add project to the key of per-file table drops
    [25_dependency_2.sv, incremental.rs, server.rs]
2026-07-31 fix(analyzer): drop scope tree bindings together with their symbols
    [incremental.rs, server.rs]
2026-07-31 introduce `$prop` namespace
    (refs: veryl-lang/veryl#3111)
2026-08-02 fix `mismatch_assignment` error reported for generic arguments using items imported at an enclosing scope
    (refs: veryl-lang/veryl#3120)
    [25_dependency_1.sv, 25_dependency_2.sv]
2026-08-02 fix(analyzer): align import visibility with the resolver's lookup rules
    [25_dependency_2.sv]
2026-08-03 fix(analyzer): reject for-loop steps that overflow the induction variable
    [utils.rs]
2026-08-06 fix(analyzer): size assignment RHS against the LHS bit-select width
    [utils.rs]
2026-08-07 test(analyzer): pin comb loop diagnostic ownership
2026-08-07 test(analyzer): pin procedural comb dependencies
2026-08-07 test(analyzer): pin module comb feedthrough
2026-08-07 test(analyzer): pin positional comb transfers
2026-08-07 test(analyzer): pin sparse comb regions
2026-08-07 test(analyzer): cover comb control-flow exits
2026-08-08 perf(analyzer): track sparse SSA branch deltas
2026-08-10 perf(simulator): in-place settle-order comb relayout (VERYL_COMB_LAYOUT)
2026-08-10 perf(simulator): assemble wide concats, select-RMW stores, and bit broadcasts directly into their destinations
2026-08-10 fix doc HTML escaping
    [doc_builder.rs]
2026-08-11 fix(simulator): give IR-walking threads an explicit stack so deep designs survive debug builds
    [lib.rs]
2026-08-11 feat(simulator): decide the incremental settle from a probed activity verdict
2026-08-12 fix(doc): escape doc comments rendered into HTML table cells
    [doc_builder.rs]
2026-08-12 fix(analyzer): reject a type used as a width or array size
    [utils.rs]
2026-08-12 fix(emitter): keep #[ifdef] guards on generated modport members
    [75_modport_default.sv]
2026-08-12 perf(simulator): enable comb fusion and the comb relayout by default
2026-08-13 fix(analyzer): keep generic arguments project-qualified through imported heads
    [25_dependency_2.sv]
2026-08-13 feat(analyzer): resolve a struct member through a hierarchical reference
    [utils.rs]
2026-08-13 perf(simulator): recover the word form of a bit-assembled wide vector
2026-08-14 fix(analyzer): let every cached fragment define the $sv members it uses
    [cmd_build.rs]
2026-08-14 perf(simulator): fuse bit-disjoint writers in the version split
2026-08-14 fix(analyzer): connect an unpacked array slice to an instance port element-wise
    [utils.rs]
2026-08-15 Avoid cloning analyzer context per combinational process
    [context.rs]
2026-08-15 fix(emitter): guard else/elsif members and keep generated modport commas valid
    [75_modport_default.sv]
2026-08-17 fix(std): keep select_vector/select_onehot warning-free at N == 1
    [68_std_1.sv]
2026-08-18 fix(emitter): suppress bare component imports in emitted SystemVerilog
    [25_dependency_2.sv]
2026-08-18 fix(simulator): select if_reset from the reset net's level, not a reset event
    [context.rs, lib.rs]
2026-08-18 perf(simulator): fuse adjacent if_reset dispatches on one reset net
2026-08-18 Fix function side effects in always_ff
    [utils.rs]
2026-08-18 Fix conditional and generic function effects
    [context.rs, utils.rs]
2026-08-18 Trace function output write origins
2026-08-18 Improve side-effect diagnostic call traces
2026-08-18 Preserve parent generics in side-effect traces
2026-08-18 Track written function outputs precisely
2026-08-18 Keep function output filtering in analyzer
2026-08-18 Skip CDC checks for unwritten function outputs
    [utils.rs]
2026-08-18 Add interface binding metadata for SSA
    [utils.rs]
2026-08-18 Track incomplete analysis across instance selectors
2026-08-18 perf(simulator): compress folded decoder chains into selector-table lookups
2026-08-19 ci(codspeed): cap benchmark jobs so a stalled valgrind install fails fast
2026-08-19 fix(analyzer): qualify a generic argument with the project its head is declared in
    [25_dependency_2.sv]
2026-08-19 fix(analyzer): reject a guarded last member in a generated modport
    [75_modport_default.sv]
2026-08-21 fix: satisfy clippy lints newly firing on Rust 1.98
    [context.rs]
2026-08-21 fix(emitter): keep #[ifdef] guards on generated and expanded modport members
    [75_modport_default.sv, 81_modport_expansion.sv]
2026-08-24 chore(simulator): share the equality-chain recognizer between the backends
2026-08-24 fix(simulator): key a switch lowering on the value the comparison actually uses
2026-08-24 perf(simulator): hold a decode arm's several outputs in one table row
2026-08-24 fix(analyzer): stop constant evaluation at a function's early return
    [context.rs]
2026-08-24 fix(simulator): keep a fused chain's self-read out of its rename temp
2026-08-24 fix(simulator): expand an array literal against the port it is wired to
2026-08-24 fix(analyzer): fold a const element read of an unpacked-array parameter
    [utils.rs]
2026-08-24 fix generic arguments reached through an alias being resolved in the wrong namespace
    - Qualify the alias target from the alias declaration's namespace in `unalias_inner`.
    - Add the project prefix in `append_namespace_path` for a package-qualified head.
    - Resolve a generic argument in `type_dag` from its head token's scope.
    - Skip alias declarations in `type_dag`, since an alias emits nothing.
    (refs: veryl-lang/veryl#3163)
    [68_std_1.sv, 68_std_2.sv, 68_std_3.sv, 68_std_4.sv, lib.rs]
2026-08-25 chore(simulator): report why each scheduling edge exists and trace every cycle
2026-08-25 fix(analyzer): blank a ternary arm a constant condition rules out
2026-08-26 feat(veryl): accept -D on dump so #[ifdef] resolves as it does for test
    [cmd_dump.rs, lib.rs]
2026-08-27 fix(analyzer): check each item of a multiple import individually
    (refs: veryl-lang/veryl#3288)
    [68_std_1.sv]
2026-08-27 refactor(analyzer): drop the derived function effect fields and the dead output filter
2026-08-27 perf(simulator): re-arm auto-offed cone gates every 2^20 evals
2026-08-28 perf(simulator): skip comb settles when no comb input changed (settle filter)
2026-08-28 fix(emitter): match a project-qualified global function call to its definition
    [25_dependency_2.sv]
2026-08-28 fix modport expansion for imported interfaces
    (refs: veryl-lang/veryl#3301)
    [81_modport_expansion.sv, lib.rs]
2026-08-28 fix(analyzer): reject a variable, port or const used as a type
    [utils.rs]
2026-08-28 fix(analyzer): keep accepting a constant as a cast target
    [21_cast.sv, utils.rs]
2026-08-28 test(analyzer): drop a case covered by the cast testcase
2026-08-31 fix(analyzer): improve combinational loop diagnostics
    [server.rs]
2026-08-31 fix(analyzer): preserve array hierarchy in loop paths
    [context.rs]
2026-08-31 fix(analyzer): omit generic comb-loop help
    [server.rs]
2026-08-31 fix(analyzer): trace hierarchical combinational loop causes
2026-09-01 refactor(analyzer): resolve a type path once in eval_type
    [utils.rs]
2026-09-01 fix(analyzer): improve the mismatch_type diagnostic in a type position
    [utils.rs]
2026-09-01 fix(simulator): keep the dead-variable DCE off while dumping waveforms
    [lib.rs]
2026-09-01 fix(analyzer): lower a const array from another namespace element-wise
    [utils.rs]
2026-09-01 fix wrong filelist order when a source file contains multiple components
    (refs: veryl-lang/veryl#3314)
    [cmd_build.rs, lib.rs]
2026-09-01 fix(analyzer): order the filelist deterministically with opaque files last
    [lib.rs]
2026-09-01 fix(simulator): reuse wide scratch stack slots so the JIT frame stays bounded
2026-09-01 fix(simulator): do not order two branches of one conditional against each other
    The per-branch split puts the arms of one `case` in the scope as separate
    statements, and the sort then treats them as a SEQUENCE: a write in one arm
    is made to clobber a read in another, and `rename_versions` inserts a copy to
    break the resulting WAR edge. Exactly one arm runs, so that edge is false and
    the copy has nothing to do -- but the copy is an UNCONDITIONAL read sitting
    between mutually exclusive writes, which is what blocks the one-pass hint.
    One predicate, applied in three places: two pieces of the same conditional
    keeping DIFFERENT branches never both execute, so no write of one reaches a
    read of th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
2026-09-01 fix(simulator): keep cross-test DUT reuse from de-aliasing below an unshared instance
    [context.rs]
2026-09-01 fix(simulator): lay a large event body over entry part functions like the comb path
    [backend.rs]
2026-09-01 fix(simulator): make the write-log diagnostic reachable and report its redundancy
    `next_print_cycle` started at 1,000,000 and doubled from there, with no dump at
    exit, so the diagnostic printed nothing on any run shorter than a million
    cycles -- which is every test in the suite. Start at 1 and double, and add the
    distinct-destination count per cycle, which is what makes the ratio of entries
    walked to bytes the commit actually had to write readable.
2026-09-01 fix(simulator): log the field's byte span, not the whole register
    A field write logged the whole element: changing two bits of a 536-byte
    register logged all 536 bytes, an amplification of 2144x, and the redundancy
    the log carried measured 658x. Narrow the logged span to the field's own
    bytes on the AOT-C event, Cranelift and interpreter FF paths alike; the
    sub-byte ordering the commit relies on is what makes the narrower entries
    still compose, and is tested.
    The interpreter keeps the whole-element read-modify-write and narrows only its
    logging: `Value::assign` needs a materialised value, there is no `word_addr`
    hook to write through, and it is the reference the other two are checked
    again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
2026-09-01 perf(simulator): merge a wide FF field into the write slot instead of a scratch round-trip
    The bit-select and the scalar-field store each moved 1072 bytes through a
    scratch register to change 16. Point both at `emit_wide_select_rmw_store` and
    `emit_wide_narrow_field_store`, which already merge into a destination, rather
    than materialising the whole element first.
2026-09-02 fix(simulator): let a shared DUT de-alias under an unshared instance
    [context.rs]
2026-09-03 feat(parser): hint the current spelling for retired and SystemVerilog keywords
2026-09-03 perf(veryl): skip emit and filelist when every test is native
    [cmd_build.rs, cmd_check.rs, cmd_doc.rs, cmd_dump.rs, cmd_publish.rs, cmd_synth.rs, incremental.rs, lib.rs]
2026-09-04 fix(veryl): add files required by unreferenced definitions to filelist
    (refs: veryl-lang/veryl#3341)
    [cmd_build.rs, lib.rs]
2026-09-05 Fix function transfers and avoid premature cycle search cutoffs
    Preserve packed positions when an output actual has a dynamic array index,
    and apply the formal width and actual signedness during function copy-in.
    Project sign bits before replication so widening retains array and bit
    boundaries without reevaluating side-effecting actuals.
    Charge guarded cycle comparisons and compositions as they execute. Look
    for opposing pairs before building transition components, reject common
    signs within each component, and avoid revisiting anchors already proved
    acyclic. Prefer finite domains over unbounded expression nodes as anchors.
    Keep the existing search cap and propagate exhaustion as incomplete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
2026-09-05 Fix context sizing and dynamic array positions during function copy-in
    Evaluate context-determined operators at the assignment width before
    mapping their requested bits. Propagate the IR expression signedness to
    operands, and retain self-determined boundaries for casts, concatenations,
    comparisons, and system conversions. Keep expression identities unchanged
    so cached side-effecting arguments are still sampled once.
    Preserve packed offsets when a dynamic array selector makes only the array
    position unknown. This keeps non-sign bits out of sign-extension sources.
    Add four regression matrices for expression contexts, extension before
    shifts, dynamic array elements, and signed slices; extend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
2026-09-05 Keep independent function outputs separate in runtime loop transfers
    Trace imported summary dependencies from the selected output root before
    closing runtime-loop transfers. Resolve only reachable formal inputs
    through each call's bindings so other output arguments and captured writes
    do not manufacture feedback in an independent result.
    Cache incoming edges by shared DAG and reachable formal keys by output root
    for each transfer. Visit graph nodes once per root without enumerating shift
    paths, and resolve actual versions separately for every call.
    Add 21 regression cases covering output arguments, returns, captured writes,
    constant inputs, direct assignments, static loops and runtime loop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
2026-09-05 Bound repeated constant evaluation and guarded function expansion
    Build packed repetitions by geometric doubling and check their materialized
    width before allocation. Reuse constant-function results within an outer
    evaluation while preserving actual evaluation order and bounding the cache.
    Share branch identities for repeatable calls with unchanged direct inputs
    and captures, retain fresh SSA results, and bound distinct summary imports.
    Discard runtime values left by conversion when preparing generic summaries
    and invalidate guard sharing between statically evaluated loop iterations.
    Add semantic and structural complexity regressions. Validate with workspace
    tests (3303 passed, 32 ignored)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
2026-09-07 Fix a cast to a constant in a package
    [21_cast.sv]
2026-09-08 perf(simulator): compile the unified comb's chunks on several threads
2026-09-08 refactor(simulator): make --backend-validate the only way to arm the dual run
2026-09-08 perf(aot-c): leave the write log unadvanced when an FF write repeats its slot's value
2026-09-08 perf(simulator): keep what only the derived-clock closure reads out of the settle filter's read set
2026-09-08 perf(simulator): skip an idle subtree's always_ff range when its reads held since the last fire
    [backend.rs]
2026-09-09 fix(analyzer): keep the project qualification of subordinate generic args
    [build.rs, lib.rs]
2026-09-09 Fix msb after a member access
    [28_msblsb.sv]
2026-09-09 fix(analyzer): bound module summary traversal
    Use the same input-to-output subgraph for degree checks, cycle retention,
    and series contraction. Traversing the original graph could enter a
    discarded positional recurrence, as in the ShiftDangle review example,
    and keep accumulating distinct offsets without reaching a summary node.
    Retain positional operations and guards, and contract only unconditional
    identity chains. Each retained edge is traversed at most once, without
    enumerating positional paths or accumulating growing path conditions.
    Cover dangling and connected packed/unpacked recurrences, unused local
    feedback, module hierarchy, large widths, and incomplete cycle searches.
    Compare g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
2026-09-09 fix(analyzer): compact redundant module summary boundaries
    Remove an identity-copy boundary when its sole predecessor enforces identical bounds, preventing exponential growth through nested wire wrappers. Preserve clipping after positional or whole-value operations, branch guards, and cyclic nodes.
    Cover packed and unpacked hierarchies through 32 levels, parent feedback, narrowing, and guarded identity chains.
2026-09-09 fix(simulator): give an element written window by window in a loop the slot its merges forward
2026-09-09 fix(analyzer): share projected actuals and runtime imports
    Evaluate instance actual projections together to preserve call guard identities and share their dependency graph. Charge actual expansion against the module budget and share imported prefixes across runtime-loop outputs.
    Add regressions for independent and shared call guards, linear graph growth, and preservation of independent cycles when the expansion budget is exhausted.
2026-09-09 fix(analyzer): preserve sampled instance actual reads
    Cache each variable occurrence and its selector dependencies when sampling instance actuals. Reuse those SSA values across projections so a later function side effect cannot erase an earlier read.
    Add regressions for reads before and after captured writes, split projections, and packed and array selectors.
2026-09-09 fix(analyzer): bound imports and preserve short-circuit paths
2026-09-09 fix(analyzer): bound nested runtime transfer copies
    Track SSA generated by runtime-loop closure so enclosing loops charge its
    nodes, edges, and domains to the shared expansion budget before copying.
    Directly written SSA and references to pre-loop inputs remain uncharged.
    Cover direct and imported nested transfers, overwritten and discarded
    results, independent cycle diagnostics, and rejection before condensation.
2026-09-09 fix(analyzer): bound guard accumulation in source queries
    Charge guard constraints and arm ranges before SSA and imported-DAG source
    walks combine or remap path conditions. Share the procedure guard budget and
    propagate exhaustion as incomplete analysis without caching partial results.
    Cover instance inputs and output selectors, independent cycle diagnostics,
    direct and imported queries, and large unguarded walks with no guard budget.
2026-09-09 fix(analyzer): share controls and preserve sampled call actuals
2026-09-09 fix(analyzer): sample assignment reads before writes
2026-09-09 fix(analyzer): sample RHS with selected destination shapes
2026-09-09 fix(analyzer): normalize lowered array destination shapes
    [utils.rs]
2026-09-09 fix(simulator): cut a boundary copy per source write through slices and muxes
2026-09-09 fix(analyzer): preserve declared constant metadata
    Store the fitted value in the constant path entry and clear the
    initializer's evaluated state so each reference receives its own width
    and signedness context.
    Add native regression tests for signed widening, truncation, unsigned
    expressions, and 128-bit destinations.
    Fixes #3375
    [utils.rs]
2026-09-10 fix(analyzer): size a parameter's declared width in the component's own scope
    [context.rs, utils.rs]
2026-09-11 fix(analyzer): reset the msb select dimension at a member access
    [context.rs]
2026-09-11 fix(analyzer): correct msb folding on struct arrays and in assign destinations
    [28_msblsb.sv]
2026-09-11 fix(simulator): read the stage clock only when stage timing asked for it
2026-09-11 fix: keep cast signedness through comparisons and type aliases
    [utils.rs]
2026-09-11 fix(std): keep a concurrent process from reading a half-expanded std cache
    [lib.rs]
2026-09-11 fix(analyzer): a bound parameter is not a use before its declaration
    [95_recursive_parameter_width.sv, context.rs, utils.rs]
2026-09-12 fix(analyzer): resolve explicit modport connections to interface members
    [utils.rs]
2026-09-14 build(deps): bump the minor-patch group with 7 updates
    Bumps the minor-patch group with 7 updates:
    | Package | From | To |
    | --- | --- | --- |
    | [console](https://github.com/console-rs/console) | `0.16.4` | `0.16.6` |
    | [scnr2](https://github.com/jsinger67/scnr2) | `0.5.2` | `0.5.3` |
    | [smallvec](https://github.com/servo/rust-smallvec) | `1.16.0` | `1.16.1` |
    | [toml](https://github.com/toml-rs/toml) | `1.1.5+spec-1.1.0` | `1.1.6+spec-1.1.0` |
    | [uuid](https://github.com/uuid-rs/uuid) | `1.26.0` | `1.26.1` |
    | [wasmtime](https://github.com/bytecodealliance/wasmtime) | `48.0.1` | `48.0.2` |
    | [reqwest](https://github.com/seanmonstar/reqwest) | `0.13.4` | `0.13.5` |
    Updates `console` from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
2026-09-14 fix(simulator): a combinational write into an FF word must not go through the write log
    [context.rs]
2026-09-14 fix(analyzer): convert a parameter override to the parameter's declared type
    [utils.rs]
2026-09-14 fix(analyzer): resolve a parameter override through a module alias
    [utils.rs]
2026-09-15 fix(analyzer): keep an interface instance array when a select rebases onto a struct member
    [utils.rs]
2026-09-15 fix(analyzer): reject an unpacked array as a struct or union member
    [utils.rs]
2026-09-15 fix(analyzer): say which axis a mismatched assignment disagrees on
    [utils.rs]
2026-09-15 fix(simulator): print a $display string argument as text
2026-09-15 fix(simulator): fold a param read so a constant ternary drops its dead arm
2026-09-15 fix(simulator): stop clamping an out-of-range dynamic index to the last element
2026-09-15 fix(analyzer): carry an array const's element values through a struct member read
    [utils.rs]
2026-09-15 fix(analyzer): keep a string array const's element text through an indexed read
    [utils.rs]
2026-09-15 fix(analyzer): bound symbol-path evaluation on its own limit, not the function one
    [build.rs, context.rs, utils.rs]
2026-09-16 fix(analyzer): keep a caller's symbol out of the declaration order check while converting a global function
    (refs: veryl-lang/veryl#3418)
    [25_dependency_2.sv, context.rs, utils.rs]
2026-09-16 fix(analyzer): register a generic component's own parameter whose width has no total yet
    [utils.rs]
2026-09-17 fix(analyzer): register a const/param whose declared width has no total instead of dropping it
    (refs: veryl-lang/veryl#3423)
    [utils.rs]
2026-09-17 fix(analyzer): bind a constant the analyzer cannot fold instead of dropping it
    [utils.rs]
2026-09-17 allow to use variables in range expression used for `case`/`inside`
    (refs: veryl-lang/veryl#3425)
2026-09-17 fix(highlightgen): isolate embedded bodies in Sublime syntax
    Isolate arbitrary embedded-language bodies, track nested braces, and restore Veryl highlighting after the outer terminator. Recover strings at end of line and respect raw/dollar identifier boundaries.
2026-09-18 fix(analyzer): let the declaration order check answer only for order
    [server.rs, utils.rs]
2026-09-20 fix(analyzer): reject a zero width or array size
    [utils.rs]
2026-09-25 fix(emitter): keep a generate block's label next to its begin
    [15_named_block.sv]
2026-09-25 fix(parser): keep a clock domain name from lexing as a number literal
    [60_clock_domain.sv, build.rs]
2026-09-25 perf(simulator): cut gate compare cost and span table build time
2026-09-25 fix(languageserver): keep typed $ and path prefixes when completing symbols
    Symbol completions only set insert_text, so the editor replaced its own word at the cursor, which does not include $ or ::. Completing $cl to $clog2 produced $$clog2, and $tb::c to $tb::clock_gen kept the typed $ as well. Give each item a text edit that replaces the typed text its insert text starts with, falling back to the typed word as before.
    Fixes #3386
    [server.rs]
2026-09-25 fix(languageserver): say why Veryl.toml failed to load
    When Veryl.toml could not be loaded, the language server only logged "failed to load metadata" with the source file URL, so a user had no way to find the offending entry. Log it as an error together with the full error chain, which includes the TOML parse error with the key, its position and the accepted keys.
    Refs #3351
    [server.rs]
2026-09-25 fix(translator): translate ?: into Veryl if expressions
    veryl translate copied SystemVerilog conditional expressions as-is, but Veryl has no ?: operator; its form is 'if c ? a : b'. Rewrite each ConditionalExpression in assignment right-hand sides, continuous assignments and call statements, recursing into its operands so nested conditionals chain.
    Fixes #2678
2026-09-25 fix(languageserver): don't panic on completion before the project is analyzed
    completion_symbol unwrapped resource_table::get_str_id for the project name, which is only interned once a source of the project has been analyzed. An invoked completion in a project whose open files do not parse yet panicked the server thread. Intern the name instead.
    [server.rs]
2026-09-26 fix(translator): read node text from the preprocessed source
    The syntax tree offsets index sv-parser's preprocessed text, so slicing
    the original input with them went wrong after a `define or a string
    literal in an expression. Translate the preprocessed text and map
    diagnostic spans back to the input.
    Also emit every statement of an always block (only the first one of a
    begin/end was kept, and a bare `always_comb a = b;` was dropped) and
    recognize the always keyword by its kind, so a trailing comment does not
    make the block unsupported.
    [lib.rs]
2026-09-27 fix(analyzer): reject a select on a scalar logic or bit
    [12_always.sv]
2026-09-28 fix(languageserver): propagate metadata load errors
    [server.rs]
2026-09-28 fix(languageserver): log Veryl.toml load errors as readable text
    [server.rs]
2026-09-28 build(deps): bump the minor-patch group with 3 updates
    Bumps the minor-patch group with 3 updates: [rand](https://github.com/rust-random/rand), [smallvec](https://github.com/servo/rust-smallvec) and [thiserror](https://github.com/dtolnay/thiserror).
    Updates `rand` from 0.10.2 to 0.10.3
    - [Release notes](https://github.com/rust-random/rand/releases)
    - [Changelog](https://github.com/rust-random/rand/blob/master/CHANGELOG.md)
    - [Commits](https://github.com/rust-random/rand/compare/0.10.2...0.10.3)
    Updates `smallvec` from 1.16.1 to 1.16.2
    - [Commits](https://github.com/servo/rust-smallvec/compare/v1.16.1...v1.16.2)
    Updates `t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
2026-09-29 fix(analyzer): preserve packed member domains for dynamic selects
    [utils.rs]
2026-09-30 fix wrong mangled name for global function
    (refs: veryl-lang/veryl#3477)
    [68_std_6.sv, lib.rs]
2026-10-01 fix(analyzer): a bit or part-select is unsigned, a whole member keeps its own sign
    [utils.rs]
2026-10-01 fix(analyzer): fold a constant if-expression only on arm types known before evaluation
2026-10-01 fix(analyzer): case labels keep their sign when folded to a constant
2026-10-01 fix(simulator): cut a dynamic-index store to the element width
2026-10-01 fix(analyzer): a folded constant or a testbench member read keeps its sign
    [utils.rs]
2026-10-01 fix(analyzer): a for bound is evaluated in its int context and keeps its sign
    [utils.rs]
2026-10-01 fix(analyzer): compare case labels as an if does, reject where SystemVerilog differs
    [utils.rs]
2026-10-01 fix: satisfy Rust 1.99 clippy and rustc lints
    [cmd_metadata.rs]
2026-10-02 fix(simulator): match x/z digits in case labels as wildcards
2026-10-02 fix(analyzer): evaluate constants wider than 64 bits as conditions, indices and bounds
    [utils.rs]
2026-10-02 fix(analyzer): accept an anonymous loop variable
    [utils.rs]
2026-10-02 fix(analyzer): accept a string literal as a case label
    [utils.rs]
2026-10-02 fix: support unpacked ranges in array references
    Preserve unpacked range selections in VarIndex while retaining flat variable storage. Project elements when consumers need them, and share dependency analysis with ordinary variable references.
    Handle array port shapes, selector evaluation, and per-dimension bounds in the analyzer, simulator, and synthesizer.
    [utils.rs]
2026-10-03 fix(analyzer): reject a non-constant select in an output port connection
    [utils.rs]
2026-10-06 perf: Skip loop specialization copies for loop-free procedures
    [utils.rs]
2026-10-06 perf(simulator): store variables of up to 8 and 16 bits in 1- and 2-byte slots
2026-10-07 fix(simulator): emit a one-hot encoder OR chain as a loop over its set bits
2026-10-09 fix(simulator): give each element of a clock/reset array its own edge event
    [lib.rs]
2026-10-10 fix(analyzer): preserve package alias generic arguments in type evaluation
    [utils.rs]
2026-10-10 fix(analyzer): walk unlogged joins iteratively, see through casts and hold the shared reserve
    - Write regions of joins without a log are computed from an explicit stack, each version once, so conditional writes repeated in a function no longer recurse once per iteration.
    - Runtime-index reads inside `$signed` and `$unsigned` also select per-element evaluation.
    - `Steps::share` sets the reserve aside once for all stages and retries, so heavy procedures cannot spend the steps kept for cycle decisions.
2026-10-10 fix(analyzer): keep untouched loop positions and below-log regions, and walk without recursion
    - After a runtime loop's transfer is closed, the positions that no iteration writes take their value from before the loop again: a recurrence joins every position of a variable and would otherwise widen them.
    - Write regions resolve the version below a write history region by region, so a join under later partial writes still counts its definite writes.
    - The write-history walk and the acyclicity check of unconstrained nodes use explicit stacks instead of recursion, so long joins and chains need no call stack.
2026-10-10 fix(analyzer): pass on only new cell boundaries and charge every comparison
    Boundary propagation recomputed the difference of whole boundary sets on every visit and charged only the boundaries it added, so a dense transfer could take far more time than steps. Each node now passes on only the boundaries it received since its last visit, so a boundary crosses an edge at most once, and every edge scan and crossing is charged. Comparing cells with their node's domains and walking the edges into a cell that may only keep the loop's entry value are charged as well.
2026-10-11 fix(simulator): mirror interface copies into FF shadow slots
2026-10-11 fix: preserve interface initialization and aliased driver processes
2026-10-13 refactor(simulator): remove the settle filter
2026-10-14 chore(deps): bump the minor-patch group with 13 updates
    Bumps the minor-patch group with 13 updates:
    | [parol](https://github.com/jsinger67/parol) | `5.0.2` | `5.0.3` |
    | [serde_json](https://github.com/serde-rs/json) | `1.0.151` | `1.0.152` |
    | [smallvec](https://github.com/servo/rust-smallvec) | `1.16.2` | `1.16.3` |
    | [tokio](https://github.com/tokio-rs/tokio) | `1.53.1` | `1.53.2` |
    | [twox-hash](https://github.com/shepmaster/twox-hash) | `2.1.4` | `2.1.5` |
    | [syn](https://github.com/dtolnay/syn) | `3.0.6` | `3.0.7` |
    | [spdx](https://github.com/EmbarkStudios/spdx) | `0.13.5` | `0.13.6` |
    | [uuid](https://github.com/uuid-rs/uuid) | `1.26.1` |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
2026-10-15 fix(simulator): fold a partial write chain into a write of its own bits
2026-10-15 fix(simulator): stop rejecting long copy chains and wide concatenations as loops
2026-10-16 fix(simulator): hold the text of a string-typed let/var
    A `string` type's width is a nominal 1 bit, so a runtime `let`/`var` of
    it got 1 bit of storage: `%s` printed the low bits of its text, and a bare
    `$display(a)` printed them in hex.
    Size each string variable to the widest text any assignment can store
    into it, read it at that width, skip the zero padding of a shorter text
    in `%s`, and render string arguments as text when `$display` has no
    format string.
    Fixes #3555
2026-10-16 fix(simulator): reject string storage the simulator cannot size
    A `string` variable is sized from the assignments in its own module.
    Text that reaches it through a port (including a function argument), a
    hierarchical reference, or a concatenation destination would still be
    cut to the nominal 1 bit, so report these as `unsupported_string`.
    A conversion error in a `$display`-style argument is now returned
    instead of panicking.
2026-10-18 perf(simulator): drop dead-variable chains in one census
2026-10-22 emit case expression with `==` if possible
    (refs: veryl-lang/veryl#3571)
2026-10-22 Check multiple_assignment per module specialization
    Build a per-specialization WriteSummary at the end of module conversion
    and detect multiple drivers over concrete specializations after pass2,
    instead of in the legacy AssignTable during evaluation.
    - Generic modules whose generate blocks could not be evaluated are now
    checked through their instantiations
    - Conflicts found in several specializations are reported once
    - Variables with the same name are no longer merged into one diagnostic
    - Only the conflicting writes are reported as sites
    - Repeated function output writes in one always_ff are legal
    - Two output ports of one instance are separate drivers
    - Writes inside procedural for loo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
2026-10-22 Untangle module dependencies of the driver check
    - Move the specialization traversal from comb_loop_detect::hierarchy to
    the IR (`Ir::module_postorder`, `Module::child_modules`), so the driver
    check no longer reaches into the combinational-loop detector
    - Import spans from `ir::span` directly instead of through a re-export
    in comb_loop_detect::region
    - Turn the `allow(initial_assign)` / `allow(multiple_assign)` attribute
    queries into `Variable` methods, so the IR and the driver check no
    longer depend on conv::checker::portability
2026-10-22 perf(simulator): leave idle settles out of the dataflow mode probe
2026-10-23 perf(simulator): merge clock copies whose inlined chain stacks several & 1
2026-10-26 Fix false type_inference_conflict on chained vars in overridden instances
2026-10-26 chore(deps): bump the minor-patch group with 7 updates
    | [pulldown-cmark](https://github.com/raphlinus/pulldown-cmark) | `0.13.4` | `0.13.5` |
    | [smallvec](https://github.com/servo/rust-smallvec) | `1.16.3` | `1.16.4` |
    | [tokio](https://github.com/tokio-rs/tokio) | `1.53.3` | `1.54.1` |
    | [uuid](https://github.com/uuid-rs/uuid) | `1.28.0` | `1.29.0` |
    | [memmap2](https://github.com/RazrFalcon/memmap2-rs) | `0.9.11` | `0.9.12` |
    | [libc](https://github.com/rust-lang/libc) | `0.2.190` | `0.2.191` |
    | [relative-path](https://github.com/udoprog/relative-path) | `2.0.2` | `2.0.3` |
    Updates `pulldown-cmark`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
2026-10-30 Separate written regions from claimed regions in the write summary
    A write inside a procedural `for` loop was recorded only as the
    longest static prefix of its destination. That is the region the
    process owns against other drivers, but the legacy unassigned check and
    the simulator need what the iterations actually write: lifted loop
    writes hid `unassign_variable`, and the simulator copied never-written
    elements from the child.
    - Record the static prefix of a loop with known iterations as
    `Extent::Claimed` and each unrolled iteration as `Extent::Written`;
    the driver check uses both, other consumers only written regions
    - Build the per-element masks of a binding once in the simulator
    - Li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
2026-10-30 Keep loop iterations out of the driver check
    Unrolled loop writes were checked as drivers beside the claim of their
    loop, so a loop over a wide vector made the conflict sweep quadratic.
    Every iteration lies within the claimed region of its process.
    - Split the extents into `Exact`, `Claimed` and `Iteration`; the driver
    check reads claimed regions, other consumers written regions
    - Do not unroll loops inside a claimed walk, and do not claim again
    inside an iteration
    - Coalesce adjacent regions written at the same site
2026-10-30 Record loop writes as their static prefix only
    Unrolling loop iterations into the write summary made its size grow
    with the iteration count, and strided writes cannot be coalesced. Go
    back to one region per write: a write inside a `for` loop covers the
    longest static prefix of its destination, for the driver check, the
    simulator and the legacy unassigned check alike.
2026-10-30 Classify direction-free members without scanning every port
    `Module::is_direction_free_member` scanned all port types and ran for
    every binding of every child process. Look up the port that names the
    member instead, and filter the bindings once per instance.
2026-10-30 Index the write summary by variable
    Mask queries and parent lifting filtered every write of the summary
    for each bound member. Index the writes by variable once when the
    summary is built, and keep the processes private so the index stays
    consistent.
2026-10-30 Build AssignTable entries only for new variables
    `insert_element` built an array-sized entry for every insertion even
    when the variable already had one, so lifting several summarized
    writes into the parent repeated that work for each of them.
2026-11-04 accept a case range bound given by a constant whose value is unknown
    (refs: veryl-lang/veryl#3657)
2026-11-07 perf(cache): fingerprint the running binary by its metadata instead of its contents
